MihrimatriX/breadboarding/cpu16/docs/parcalar.md

# CPU16 — Parça Kütüphanesi (Faz 3)

> Bilgisayarda kullanılan her entegrenin pin düzeni, kapı seviyesi içi, CMOS transistör açılımı ve KiCad sembolü **tek kaynaktan** gelir: `cpu16/chips/`.

## Ne var

| Dosya | İçerik |
|---|---|
| `chips/logic.ts` | Kapı seviyesi simülatör: 0/1/Z/X lojiği, çok sürücülü netler (veriyolu), dalga tabanlı zamanlama, DFF / mandal / üç durumlu tampon / davranışsal blok. Netlist kurulurken düz tiplenmiş dizilere (CSR) çevrilir; bir dalga hiç nesne ayırmadan hesaplanır |
| `chips/parts/*.ts` | 38 çipin tanımı: pinler (veri sayfasındaki numaralarla), kapı devresi, veri sayfası fonksiyon tablosu (referans model) |
| `chips/cmos.ts` | Kapı → CMOS transistör açılımı; çıktı Silikon3D'nin anahtar seviyesi motorunun okuduğu biçimde |
| `chips/bench.ts`, `chips/transistor-bench.ts` | Tek çipi kapı veya transistör seviyesinde çalıştıran tezgâhlar |
| `chips/kicad.ts` → `kicad/cpu16.kicad_sym` | KiCad 7+ sembol kütüphanesi (pin numaraları, footprint, açıklama) |

```sh
npm run cpu16 -- chips        # tablo: kapı ve transistör sayıları
npm run cpu16 -- kicad-sym    # cpu16/kicad/cpu16.kicad_sym dosyasını yeniden üret
npx vitest run cpu16/tests/chips.test.ts
```

## Nasıl doğrulanıyor (Faz 3 "bitti" ölçütü)

1. **Kapı modeli = veri sayfası.** Her çipin fonksiyon tablosu kapı devresinden bağımsız olarak koda yazıldı (`ref`). Birleşimsel çiplerde 12 girişe kadar **bütün kombinasyonlar** Gray kodu sırasıyla, diğerlerinde ve sıralı çiplerde 2 × 3000 rastgele adım (her adımda tek pin değişir) karşılaştırılır.
2. **Transistör modeli = kapı modeli.** Aynı adımlar kapılardan açılan CMOS netlist'i üzerinde Silikon3D'nin `SwitchLevelEngine`'inde (6502'yi çalıştıran motor) koşar; her adımda bütün çıkışlar aynı olmalı.
3. **Pin düzeni**: her kılıfta pinler 1..N, GND N/2'de, VCC N'de (74HC ve JEDEC bellek düzeni); KiCad sembolündeki pin numaraları kütüphaneyle birebir.
4. **Veri sayfası satırları**: 74HC138, 283, 161 (yükle/say/TC), 74 (ikisi birden aktif), 595 (kaydır/mandalla/Z), 273 için tablo satırları ayrıca yazıldı.
5. **Bellekler** davranışsaldır (içleri kapı değil): 62256 okuma/yazma/Z; 28C256 sayfa yazma, yazma sürerken DATA yoklaması (D7 ters) ve toggle biti (D6), yazılım koruması (SDP) aç/kapat; SST39SF010A komut dizileriyle programlama, kimlik okuma, sektör ve çip silme. 28C256'nın davranışı emülatördeki modelin (`emu/devices/eeprom.ts`) kendisidir.

**Hangi parçalar (AFU kararı)**: anakart yalnız yaygın 7400 serisi lojikle ve iki bellek çipiyle (62256, 28C256) kurulur. 74HC148, 74HC193, 74HC590 ve AS6C4008 bu yüzden kütüphaneden çıkarıldı: kesme öncelik kodlayıcısı kapılarla, video adres sayacı ve zamanlayıcı 74HC161 ile, önbellek sayaçları 74HC161 + 74HC541 ile kuruldu; 512 KB RAM yerine 4 × 62256. 74HC166 yaygındır ve video kartında kalır (74HC165'in eşzamansız yüklemesi piksel saatine sığmaz, [anakart-gc-video.md](anakart-gc-video.md)). SST39SF010A artık hiçbir kartta yok (CPU kartının mikrokod ve ALU ROM'ları 74HC kapılarına çevrildi); kütüphanede karşılaştırma için duruyor.

Güç verildiğinde flip-flopların değeri **bilinmiyor (X)** kabul edilir; veri sayfası da öyle der. Testler bu durumda karşılaştırma yapmaz, ilk saat/reset sonrasında yapar.

## Çipler

| Parça | Kılıf | Kapı | Transistör | Açıklama |
|---|---|---|---|---|
| 74HC00 | DIP-14 | 4 | 16 | 4 × 2 girişli NAND |
| 74HC02 | DIP-14 | 4 | 16 | 4 × 2 girişli NOR |
| 74HC04 | DIP-14 | 6 | 12 | 6 × NOT (evirici) |
| 74HC05 | DIP-14 | 6 | 48 | 6 × NOT, açık-akaçlı (open-drain) çıkış |
| 74HC08 | DIP-14 | 4 | 24 | 4 × 2 girişli AND |
| 74HC10 | DIP-14 | 3 | 18 | 3 × 3 girişli NAND |
| 74HC11 | DIP-14 | 3 | 24 | 3 × 3 girişli AND |
| 74HC20 | DIP-14 | 2 | 16 | 2 × 4 girişli NAND |
| 74HC21 | DIP-14 | 2 | 20 | 2 × 4 girişli AND |
| 74HC27 | DIP-14 | 3 | 18 | 3 × 3 girişli NOR |
| 74HC30 | DIP-14 | 1 | 16 | 8 girişli NAND |
| 74HC14 | DIP-14 | 6 | 12 | 6 × Schmitt tetiklemeli NOT |
| 74HC32 | DIP-14 | 4 | 24 | 4 × 2 girişli OR |
| 74HC86 | DIP-14 | 4 | 48 | 4 × 2 girişli XOR |
| 74HC125 | DIP-14 | 8 | 40 | 4 × üç durumlu tampon (aktif düşük OE) |
| 74HC138 | DIP-16 | 14 | 82 | 3'ten 8'e kod çözücü (aktif düşük çıkış) |
| 74HC139 | DIP-16 | 14 | 60 | 2 × (2'den 4'e kod çözücü) |
| 74HC151 | DIP-16 | 14 | 124 | 8'den 1'e seçici (multiplexer) |
| 74HC153 | DIP-16 | 14 | 108 | 2 × (4'ten 1'e seçici) |
| 74HC157 | DIP-16 | 14 | 92 | 4 × (2'den 1'e seçici) |
| 74HC283 | DIP-16 | 30 | 260 | 4 bit ikili tam toplayıcı (ileri bakışlı elde) |
| 74HC688 | DIP-20 | 10 | 116 | 8 bit eşitlik karşılaştırıcısı |
| 74HC74 | DIP-14 | 2 | 72 | 2 × D flip-flop (asenkron preset ve clear) |
| 74HC161 | DIP-16 | 26 | 309 | 4 bit senkron ikili sayıcı (asenkron reset) |
| 74HC393 | DIP-14 | 12 | 297 | 2 × 4 bit dalgalı (ripple) ikili sayıcı (düşen kenar, asenkron temizleme) |
| 74HC165 | DIP-16 | 34 | 376 | 8 bit paralel giriş / seri çıkış kaydırmalı register |
| 74HC166 | DIP-16 | 34 | 441 | 8 bit paralel giriş / seri çıkış kaydırmalı register (eşzamanlı yükleme) |
| 74HC175 | DIP-16 | 4 | 145 | 4 × D flip-flop (ortak saat, asenkron reset) |
| 74HC573 | DIP-20 | 17 | 210 | 8 bit şeffaf mandal (üç durumlu çıkış) |
| 74HC574 | DIP-20 | 17 | 355 | 8 bit D flip-flop register (üç durumlu çıkış) |
| 74HC273 | DIP-20 | 8 | 289 | 8 bit D flip-flop register (ortak asenkron reset): bank register'ları |
| 74HC595 | DIP-16 | 25 | 643 | 8 bit seri giriş / paralel çıkış kaydırmalı register (çıkış mandallı) |
| 74HC245 | DIP-20 | 20 | 144 | 8 bit çift yönlü veriyolu alıcı-vericisi |
| 74HC541 | DIP-20 | 9 | 68 | 8 bit üç durumlu tampon (iki aktif düşük OE) |
| 74HC4511 | DIP-16 | 37 | 368 | BCD'den 7 segmente kod çözücü / sürücü (mandallı, ortak katot): 8 bit hesap makinesi (`hesap8/`) |
| 62256 | DIP-28 | - | - | 32 KB statik RAM (32K × 8) |
| 28C256 | DIP-28 | - | - | 32 KB paralel EEPROM (32K × 8, 5 V, bayt/sayfa yazma; 62256 ile aynı bacak düzeni) |
| SST39SF010A | DIP-32 | - | - | 128 KB Flash (128K × 8, 5 V, komutla programlanır) |

"Kapı" sayısında flip-flop ve mandal tek eleman sayılır; transistör sayısı onların açılmış hâlini içerir. Gerçek 74HC çiplerinde giriş koruma diyotları ve tamponlanmış çıkış katları da vardır. Mantığı değiştirmedikleri için modellenmezler; bu yüzden gerçek transistör sayısı biraz daha yüksektir.

CPU16'da her çipin nerede kullanıldığı `usage` alanında ve KiCad sembolünün `CPU16_Kullanim` özelliğinde yazılı.

74HC11, 20, 21, 27 ve 30 CPU kartının kapı seviyesindeki kontrol biriminin geniş kapılarıdır
(`board/kontrol.ts`; mikromimari.md, "Kapı seviyesinde kontrol birimi"). Kartlarda yapıştırıcı lojik
olarak yerleşirler (`Board.and3`, `nor3`, `and4`, `nand4`, `nand8`): birimler kart bitince çiplere
paketlenir. 74HC20 ve 74HC21'in 3. ve 11., 74HC30'un 9., 10. ve 13. bacakları bağlantısızdır (NC).

## Transistör açılımı kuralları

| Kapı | Devre | Transistör |
|---|---|---|
| NOT | 1 PMOS (VCC→Y) + 1 NMOS (Y→GND) | 2 |
| NAND (k giriş) | k paralel PMOS + k seri NMOS | 2k |
| NOR (k giriş) | k seri PMOS + k paralel NMOS | 2k |
| AND / OR | NAND / NOR + NOT | 2k + 2 |
| XOR | 2 evirici + AOI22: Y = ¬(a·b + ā·b̄) | 12 |
| Üç durumlu tampon | evirici + üç durumlu evirici (P-P ve N-N seri yığın) | 8 |
| D flip-flop | 7474 yapısı: 6 adet 3 girişli NAND (kenar tetiklemeli) | 36 |
| D mandalı | 4 NAND + 1 NOT | 18 |

VCC'ye bağlı girişler bir "tie-high" hücresinden beslenir (kapısı GND'de bir PMOS): anahtar seviyesi motoru güç raylarını yeniden hesaplamaz, gerçek çiplerde de sabit girişler böyle bağlanır.

## Kütüphanede olmayan parçalar (BOM'da var, simülasyonda ideal)

Saat osilatörü (4 MHz kristal osilatör kutusu), 555 (adım saati), reset butonu RC'si, dekuplaj kondansatörleri, LED ve dirençler, VGA konnektörü ve renk direnç DAC'ı, PS/2 konnektörü, USB-UART modülü (CH340). Simülasyonda bunlar ideal sinyal kaynağı olarak modellenir; listesi Faz 9 BOM'unda.

CPU kartının hata ayıklama göstergeleri de bu gruptadır: 39 adet 3 mm LED (her biri 1 kΩ ile),
26 adet 10 segmentli LED çubuk gösterge (`DISP_BAR_10`, DIP-20; ör. Kingbright DC-10YWA, Broadcom
HDSP-4840; 1–10. bacaklar segment anotları, 20–11. bacaklar katotları; 16'sı register'ların içeriği
için) ve önlerinde 26 adet 8 × 1 kΩ yalıtılmış direnç dizisi (`RN_1K_ISO_8`, DIP-16, ör. Bourns 4116R-1-102; k. direnç k. ve 17 − k.
bacak arasında). Simülasyon dirençlerin değerini bilmez: LED'in ve segmentin yanıp yanmadığı,
direncin öbür ucundaki sinyalden okunur ([kartlar.md](kartlar.md)).

## Yeni çip eklemek

1. `chips/parts/` altında `ChipDef` yaz: `pinsOf("…veri sayfası sırasıyla pin adları…", { out, tri, bidir })`, `build(c, p)` ile kapılar, `ref` ile fonksiyon tablosu.
2. `chips/library.ts` listesine ekle.
3. `npm run cpu16 -- kicad-sym` ile sembol kütüphanesini yenile, `npx vitest run cpu16/tests/chips.test.ts` çalıştır: kapı = tablo ve transistör = kapı testleri kendiliğinden eklenir.
