MihrimatriX/breadboarding/cpu16/docs/anakart-kartlari.md

# Anakart kartları: saat, bellek ve önbellek (Faz 6, kapı seviyesi)

> [anakart.md](anakart.md)'deki bellek tarafı artık gerçek çiplerden kurulmuş kartlar olarak da var:
> şema = kod ([kartlar.md](kartlar.md)). Emülatördeki `Machine` (`emu/machine.ts`, `emu/devices/cache.ts`)
> referanstır; kartlar onunla erişim erişim ve komut komut karşılaştırılır. `Machine` bu iş için
> değiştirilmedi.

| Dosya | İçerik |
|---|---|
| `board/clock-card.ts` | Saat ve reset kartı (`clk`): bekleme durumu, TCLK, OSC |
| `board/mem-card.ts` | Bellek kartı (`bellek`): G/Ç çözümü, bank register'ları, EEPROM + RAM, bayt sıralayıcı |
| `board/cache-card.ts` | Önbellek kartı (`onbellek`): etiket/veri belleği, bekleme üreteci, sayaçlar, CACHE_CTRL |
| `board/machine-board.ts` | `buildMachineBoard({ cards })`: CPU + saat + bellek + önbellek (+ ek kartlar); `GateMachine` |
| `board/bus-master.ts` | `BusMaster`: CPU kartı yerine arka paneli süren düzenek (veriyolu izini oynatmak için) |
| `chips/parts/bellek-ek.ts` | Yeni parça: 74HC273 |
| `kicad/bellek/`, `kicad/onbellek/` | KiCad şemaları ve kart BOM'ları (`npm run cpu16 -- board kicad`) |
| `tests/anakart-bellek.test.ts`, `tests/anakart-sistem.test.ts` | Doğrulama (aşağıda) |
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
