MihrimatriX/breadboarding/public/og/6502.png

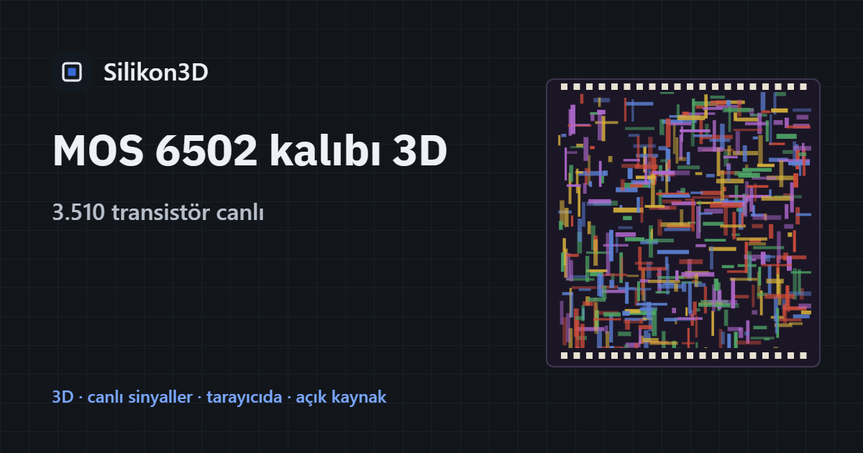
public/og/6502.png
