MihrimatriX/breadboarding/public/og/belgeler.png

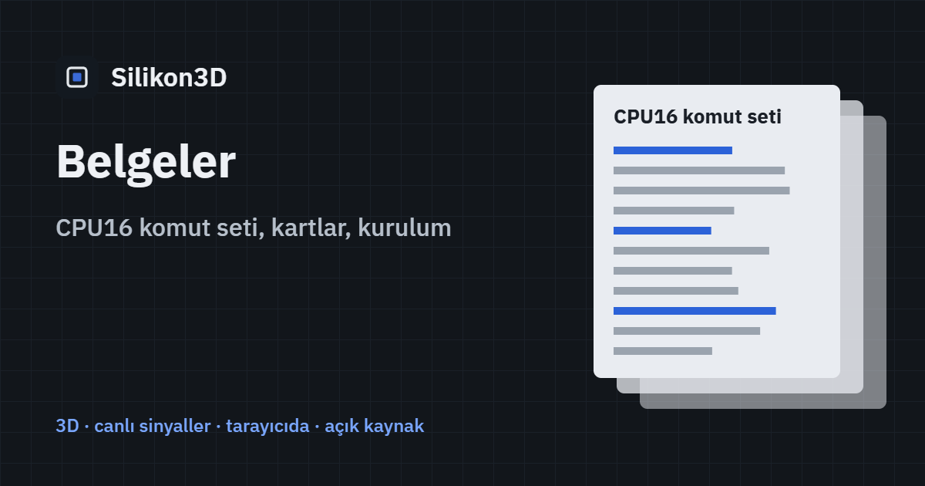
public/og/belgeler.png
