MihrimatriX/breadboarding/public/og/cpu16.png

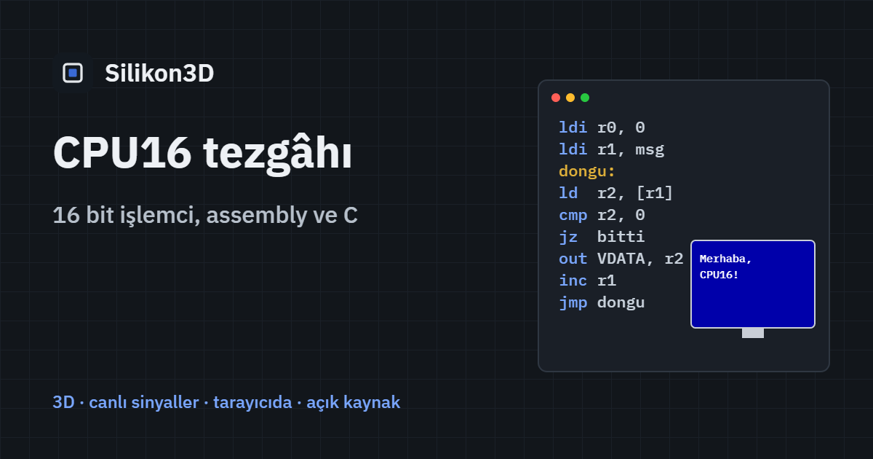
public/og/cpu16.png
