MihrimatriX/breadboarding/public/og/hesap.png

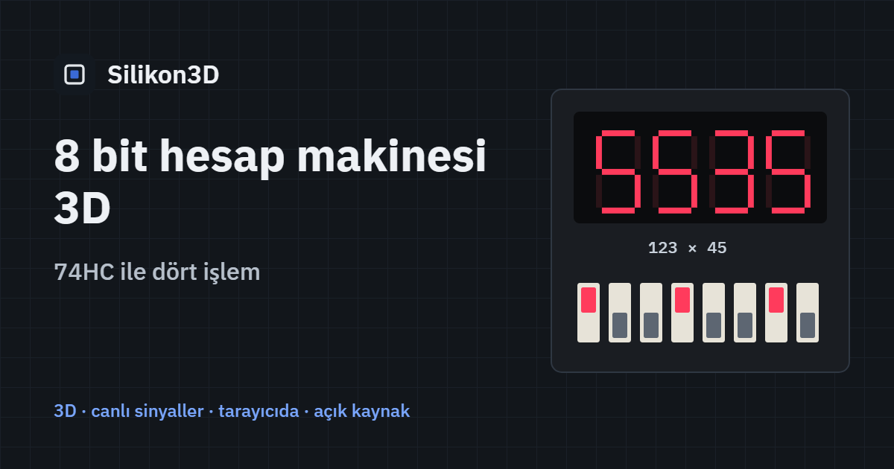
public/og/hesap.png
