MihrimatriX/breadboarding/public/og/mimari.png

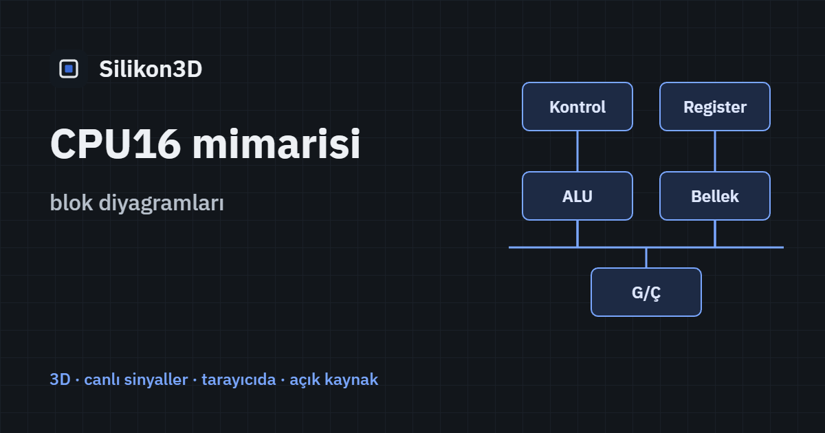
public/og/mimari.png
