MihrimatriX/breadboarding/public/og/silikon3d.png

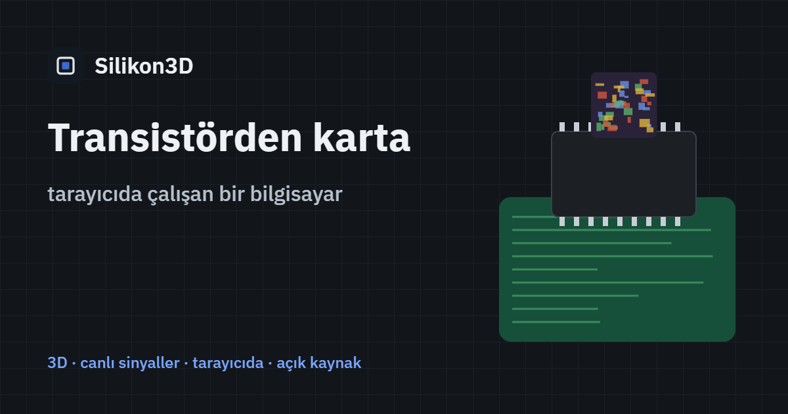
public/og/silikon3d.png
