MihrimatriX/breadboarding/cpu16/kicad/bom.csv

Parça | Adet | Açıklama | Footprint | Kart | Referanslar
62256 | 2 | 32 KB statik RAM (32K × 8) | Package_DIP:DIP-28_W15.24mm | mem | U303 U304
74HC00 | 8 | 4 × 2 girişli NAND | Package_DIP:DIP-14_W7.62mm | cpu | U130 U131 U132 U170 U171 U172 U173 U174
74HC02 | 5 | 4 × 2 girişli NOR | Package_DIP:DIP-14_W7.62mm | cpu | U133 U134 U135 U175 U176
74HC04 | 6 | 6 × NOT (evirici) | Package_DIP:DIP-14_W7.62mm | cpu mem clk | U145 U146 U307 U210 U177 U178
74HC08 | 19 | 4 × 2 girişli AND | Package_DIP:DIP-14_W7.62mm | cpu clk | U117 U118 U119 U120 U121 U122 U123 U124 U125 U126 U207 U208 U157 U158 U159 U160 U161 U162 U163
74HC10 | 7 | 3 × 3 girişli NAND | Package_DIP:DIP-14_W7.62mm | cpu | U179 U180 U181 U182 U183 U184 U185
74HC11 | 1 | 3 × 3 girişli AND | Package_DIP:DIP-14_W7.62mm | cpu | U186
74HC138 | 12 | 3'ten 8'e kod çözücü (aktif düşük çıkış) | Package_DIP:DIP-16_W7.62mm | cpu | U1 U3 U5 U7 U10 U13 U17 U18 U68 U69 U70 U71
74HC14 | 1 | 6 × Schmitt tetiklemeli NOT | Package_DIP:DIP-14_W7.62mm | clk | U201
74HC151 | 46 | 8'den 1'e seçici (multiplexer) | Package_DIP:DIP-16_W7.62mm | cpu | U14 U15 U16 U49 U50 U51 U52 U53 U54 U55 U56 U57 U58 U59 U60 U61 U62 U63 U64 U76 U77 U78 U79 U80 U81 U82 U83 U84 U85 U86 U87 U88 U89 U90 U91 U111 U147 U148 U149 U150 U151 U152 U153 U154 U155 U156
74HC153 | 9 | 2 × (4'ten 1'e seçici) | Package_DIP:DIP-16_W7.62mm | cpu | U92 U93 U94 U95 U96 U97 U98 U99 U100
74HC157 | 4 | 4 × (2'den 1'e seçici) | Package_DIP:DIP-16_W7.62mm | cpu clk | U67 U105 U116 U202
74HC161 | 5 | 4 bit senkron ikili sayıcı (asenkron reset) | Package_DIP:DIP-16_W7.62mm | cpu | U9 U43 U44 U45 U46
74HC175 | 1 | 4 × D flip-flop (ortak saat, asenkron reset) | Package_DIP:DIP-16_W7.62mm | clk | U203
74HC20 | 4 | 2 × 4 girişli NAND | Package_DIP:DIP-14_W7.62mm | cpu | U191 U192 U193 U194
74HC21 | 4 | 2 × 4 girişli AND | Package_DIP:DIP-14_W7.62mm | cpu | U187 U188 U189 U190
74HC245 | 3 | 8 bit çift yönlü veriyolu alıcı-vericisi | Package_DIP:DIP-20_W7.62mm | cpu | U112 U113 U114
74HC283 | 4 | 4 bit ikili tam toplayıcı (ileri bakışlı elde) | Package_DIP:DIP-16_W7.62mm | cpu | U72 U73 U74 U75
74HC32 | 11 | 4 × 2 girişli OR | Package_DIP:DIP-14_W7.62mm | cpu mem clk | U127 U128 U129 U306 U209 U164 U165 U166 U167 U168 U169
74HC541 | 26 | 8 bit üç durumlu tampon (iki aktif düşük OE) | Package_DIP:DIP-20_W7.62mm | cpu clk | U47 U48 U65 U66 U103 U104 U109 U110 U115 U206 U195 U196 U197 U198 U199 U901 U902 U903 U904 U905 U906 U907 U908 U909 U910 U911
74HC574 | 29 | 8 bit D flip-flop register (üç durumlu çıkış) | Package_DIP:DIP-20_W7.62mm | cpu mem | U2 U4 U6 U8 U19 U20 U21 U22 U23 U24 U25 U26 U27 U28 U29 U30 U31 U32 U33 U34 U35 U36 U37 U38 U39 U40 U41 U42 U305
74HC688 | 4 | 8 bit eşitlik karşılaştırıcı | Package_DIP:DIP-20_W7.62mm | cpu mem | U101 U102 U301 U302
74HC74 | 7 | 2 × D flip-flop (asenkron preset ve clear) | Package_DIP:DIP-14_W7.62mm | cpu clk | U11 U12 U106 U107 U108 U204 U205
74HC86 | 9 | 4 × 2 girişli XOR | Package_DIP:DIP-14_W7.62mm | cpu | U136 U137 U138 U139 U140 U141 U142 U143 U144
BACKPLANE_2x32 | 3 | Arka panel konnektörü 2 × 32 (2,54 mm) | Connector_PinHeader_2.54mm:PinHeader_2x32_P2.54mm_Vertical | cpu mem clk | J1 J301 J201
C_100N | 227 | 100 nF seramik kondansatör (dekuplaj) | Capacitor_THT:C_Disc_D5.0mm_W2.5mm_P5.00mm | cpu mem clk | C2 C3 C4 C5 C6 C7 C8 C9 C10 C11 C12 C13 C14 C15 C16 C17 C18 C19 C20 C21 C22 C23 C24 C25 C26 C27 C28 C29 C30 C31 C32 C33 C34 C35 C36 C37 C38 C39 C40 C41 C42 C43 C44 C45 C46 C47 C48 C49 C50 C51 C52 C53 C54 C55 C56 C57 C58 C59 C60 C61 C62 C63 C64 C65 C66 C67 C68 C69 C70 C71 C72 C73 C74 C75 C76 C77 C78 C79 C80 C81 C82 C83 C84 C85 C86 C87 C88 C89 C90 C91 C92 C93 C94 C95 C96 C97 C98 C99 C100 C101 C102 C103 C104 C105 C106 C107 C108 C109 C110 C111 C112 C113 C114 C115 C116 C117 C118 C119 C120 C121 C122 C123 C124 C125 C126 C127 C128 C129 C130 C131 C132 C133 C134 C135 C136 C137 C138 C139 C140 C141 C142 C143 C144 C145 C146 C147 C148 C149 C150 C151 C152 C153 C154 C155 C156 C157 C158 C159 C160 C161 C162 C163 C164 C165 C166 C167 C168 C169 C170 C171 C172 C173 C174 C175 C176 C177 C178 C179 C180 C181 C182 C183 C184 C185 C186 C187 C188 C189 C190 C191 C192 C193 C194 C195 C196 C197 C198 C199 C901 C902 C903 C904 C905 C906 C907 C908 C909 C910 C911 C912 C302 C303 C304 C305 C306 C307 C308 C205 C206 C207 C208 C209 C210 C211 C212 C213 C214
C_100U | 3 | 100 µF elektrolitik kondansatör (kart girişi) | Capacitor_THT:CP_Radial_D6.3mm_P2.50mm | cpu mem clk | C1 C301 C204
C_10U | 1 | 10 µF elektrolitik kondansatör | Capacitor_THT:CP_Radial_D5.0mm_P2.00mm | clk | C201
C_1U | 2 | 1 µF kondansatör | Capacitor_THT:C_Disc_D5.0mm_W2.5mm_P5.00mm | clk | C202 C203
DISP_BAR_10 | 26 | 10 segmentli LED çubuk gösterge (DIP-20, ör. Kingbright DC-10YWA, Broadcom HDSP-4840) | Display:HDSP-4830 | cpu | DS1 DS2 DS3 DS4 DS5 DS6 DS7 DS8 DS9 DS10 DS11 DS12 DS13 DS14 DS15 DS16 DS17 DS18 DS19 DS20 DS21 DS22 DS23 DS24 DS25 DS26
LED | 42 | 3 mm LED | LED_THT:LED_D3.0mm | cpu clk | D1 D2 D201 D3 D4 D5 D6 D7 D8 D9 D10 D11 D12 D13 D14 D15 D16 D17 D18 D19 D20 D21 D22 D23 D24 D25 D26 D27 D28 D29 D30 D31 D32 D33 D34 D35 D36 D37 D38 D39 D40 D41
OSC_CAN | 1 | Kristal osilatör modülü (DIP-14 kılıf, 5 V) | Oscillator:Oscillator_DIP-14 | clk | X201
POT_100K | 1 | 100 kΩ trimpot | Potentiometer_THT:Potentiometer_Bourns_3386P_Vertical | clk | RV201
R_10K | 3 | 10 kΩ direnç | Resistor_THT:R_Axial_DIN0207_L6.3mm_D2.5mm_P7.62mm_Horizontal | clk | R201 R202 R204
R_1K | 40 | 1 kΩ direnç | Resistor_THT:R_Axial_DIN0207_L6.3mm_D2.5mm_P7.62mm_Horizontal | clk cpu | R203 R3 R4 R5 R6 R7 R8 R9 R10 R11 R12 R13 R14 R15 R16 R17 R18 R19 R20 R21 R22 R23 R24 R25 R26 R27 R28 R29 R30 R31 R32 R33 R34 R35 R36 R37 R38 R39 R40 R41
R_330 | 3 | 330 Ω direnç (LED akımı) | Resistor_THT:R_Axial_DIN0207_L6.3mm_D2.5mm_P7.62mm_Horizontal | cpu clk | R1 R2 R205
RN_10K_8 | 2 | 8 × 10 kΩ direnç dizisi (SIP-9, ortak uç) | Resistor_THT:R_Array_SIP9 | cpu | RN1 RN2
RN_1K_ISO_8 | 26 | 8 × 1 kΩ yalıtılmış direnç dizisi (DIP-16, ör. 4116R-1-102) | Package_DIP:DIP-16_W7.62mm | cpu | RN3 RN4 RN5 RN6 RN7 RN8 RN9 RN10 RN11 RN12 RN13 RN14 RN15 RN16 RN17 RN18 RN19 RN20 RN21 RN22 RN23 RN24 RN25 RN26 RN27 RN28
SW_PUSH | 2 | Basmalı buton (6 mm) | Button_Switch_THT:SW_PUSH_6mm | clk | SW201 SW202
SW_SPDT | 2 | Sürgülü anahtar (1 kutup, 2 konum) | Button_Switch_THT:SW_Slide_1P2T_CK_OS102011MS2Q | clk | SW203 SW204
