MihrimatriX/breadboarding/cpu16/kicad/hesap/bom.csv

Parça | Adet | Açıklama | Footprint | Kart | Referanslar
74HC00 | 1 | 4 × 2 girişli NAND | Package_DIP:DIP-14_W7.62mm | hesap | U79
74HC02 | 6 | 4 × 2 girişli NOR | Package_DIP:DIP-14_W7.62mm | hesap | U2 U187 U194 U202 U203 U212
74HC04 | 8 | 6 × NOT (evirici) | Package_DIP:DIP-14_W7.62mm | hesap | U3 U11 U80 U81 U188 U195 U204 U213
74HC08 | 38 | 4 × 2 girişli AND | Package_DIP:DIP-14_W7.62mm | hesap | U1 U8 U14 U15 U16 U17 U18 U19 U20 U21 U22 U23 U24 U25 U26 U27 U28 U29 U76 U98 U99 U110 U111 U148 U149 U150 U151 U152 U153 U154 U155 U156 U180 U181 U185 U192 U199 U210
74HC153 | 8 | 2 × (4'ten 1'e seçici) | Package_DIP:DIP-16_W7.62mm | hesap | U83 U84 U85 U86 U87 U88 U89 U90
74HC157 | 16 | 4 × (2'den 1'e seçici) | Package_DIP:DIP-16_W7.62mm | hesap | U46 U47 U50 U51 U54 U55 U58 U59 U62 U63 U66 U67 U70 U71 U74 U75
74HC283 | 88 | 4 bit ikili tam toplayıcı (ileri bakışlı elde) | Package_DIP:DIP-16_W7.62mm | hesap | U6 U7 U12 U13 U30 U31 U32 U33 U34 U35 U36 U37 U38 U39 U40 U41 U42 U43 U44 U45 U48 U49 U52 U53 U56 U57 U60 U61 U64 U65 U68 U69 U72 U73 U91 U92 U93 U94 U95 U96 U97 U103 U104 U105 U106 U107 U108 U109 U115 U116 U117 U118 U119 U120 U121 U122 U123 U124 U125 U126 U127 U128 U129 U130 U131 U132 U133 U134 U135 U136 U137 U138 U139 U140 U141 U142 U143 U144 U145 U146 U147 U173 U174 U175 U176 U177 U178 U179
74HC30 | 1 | 8 girişli NAND | Package_DIP:DIP-14_W7.62mm | hesap | U82
74HC32 | 32 | 4 × 2 girişli OR | Package_DIP:DIP-14_W7.62mm | hesap | U77 U78 U100 U101 U102 U112 U113 U114 U157 U158 U159 U160 U161 U162 U163 U164 U165 U166 U167 U168 U169 U170 U171 U172 U182 U183 U184 U186 U193 U200 U201 U211
74HC4511 | 14 | BCD'den 7 segmente kod çözücü / sürücü (mandallı, ortak katot) | Package_DIP:DIP-16_W7.62mm | hesap | U189 U190 U191 U196 U197 U198 U205 U206 U207 U208 U209 U214 U215 U216
74HC86 | 4 | 4 × 2 girişli XOR | Package_DIP:DIP-14_W7.62mm | hesap | U4 U5 U9 U10
C_100N | 216 | 100 nF seramik kondansatör (dekuplaj) | Capacitor_THT:C_Disc_D5.0mm_W2.5mm_P5.00mm | hesap | C2 C3 C4 C5 C6 C7 C8 C9 C10 C11 C12 C13 C14 C15 C16 C17 C18 C19 C20 C21 C22 C23 C24 C25 C26 C27 C28 C29 C30 C31 C32 C33 C34 C35 C36 C37 C38 C39 C40 C41 C42 C43 C44 C45 C46 C47 C48 C49 C50 C51 C52 C53 C54 C55 C56 C57 C58 C59 C60 C61 C62 C63 C64 C65 C66 C67 C68 C69 C70 C71 C72 C73 C74 C75 C76 C77 C78 C79 C80 C81 C82 C83 C84 C85 C86 C87 C88 C89 C90 C91 C92 C93 C94 C95 C96 C97 C98 C99 C100 C101 C102 C103 C104 C105 C106 C107 C108 C109 C110 C111 C112 C113 C114 C115 C116 C117 C118 C119 C120 C121 C122 C123 C124 C125 C126 C127 C128 C129 C130 C131 C132 C133 C134 C135 C136 C137 C138 C139 C140 C141 C142 C143 C144 C145 C146 C147 C148 C149 C150 C151 C152 C153 C154 C155 C156 C157 C158 C159 C160 C161 C162 C163 C164 C165 C166 C167 C168 C169 C170 C171 C172 C173 C174 C175 C176 C177 C178 C179 C180 C181 C182 C183 C184 C185 C186 C187 C188 C189 C190 C191 C192 C193 C194 C195 C196 C197 C198 C199 C200 C201 C202 C203 C204 C205 C206 C207 C208 C209 C210 C211 C212 C213 C214 C215 C216 C217
C_100U | 1 | 100 µF elektrolitik kondansatör (kart girişi) | Capacitor_THT:CP_Radial_D6.3mm_P2.50mm | hesap | C1
CONN_5V | 1 | 5 V besleme girişi (2 pin başlık: 1 = +5 V, 2 = GND) | Connector_PinHeader_2.54mm:PinHeader_1x02_P2.54mm_Vertical | hesap | J1
DISP_7SEG_CC | 15 | 7 segment gösterge, 0,56" tek hane, ortak katot (ör. 5161AS) | Display_7Segment:7SegmentLED_LTS6760_LTS6780 | hesap | DS1 DS2 DS3 DS4 DS5 DS6 DS7 DS8 DS9 DS10 DS11 DS12 DS13 DS14 DS15
LED | 5 | 3 mm LED | LED_THT:LED_D3.0mm | hesap | D1 D2 D3 D4 D5
R_10K | 1 | 10 kΩ direnç | Resistor_THT:R_Axial_DIN0207_L6.3mm_D2.5mm_P7.62mm_Horizontal | hesap | R1
R_330 | 6 | 330 Ω direnç (LED akımı) | Resistor_THT:R_Axial_DIN0207_L6.3mm_D2.5mm_P7.62mm_Horizontal | hesap | R2 R3 R4 R5 R6 R7
RN_10K_8 | 3 | 8 × 10 kΩ direnç dizisi (SIP-9, ortak uç) | Resistor_THT:R_Array_SIP9 | hesap | RN1 RN2 RN3
RN_470_ISO_8 | 14 | 8 × 470 Ω yalıtılmış direnç dizisi (DIP-16, ör. 4116R-1-471) | Package_DIP:DIP-16_W7.62mm | hesap | RN4 RN5 RN6 RN7 RN8 RN9 RN10 RN11 RN12 RN13 RN14 RN15 RN16 RN17
SW_DIP_2 | 1 | 2'li DIP anahtar (SPST, sürgülü, DIP-4) | Button_Switch_THT:SW_DIP_SPSTx02_Slide_9.78x7.26mm_W7.62mm_P2.54mm | hesap | SW3
SW_DIP_8 | 2 | 8'li DIP anahtar (SPST, sürgülü, DIP-16) | Button_Switch_THT:SW_DIP_SPSTx08_Slide_9.78x22.5mm_W7.62mm_P2.54mm | hesap | SW1 SW2
SW_PUSH | 1 | Basmalı buton (6 mm) | Button_Switch_THT:SW_PUSH_6mm | hesap | SW4
