MihrimatriX/breadboarding/cpu16/kicad/bellek/bom.csv

Parça | Adet | Açıklama | Footprint | Kart | Referanslar
28C256 | 1 | 32 KB paralel EEPROM (32K × 8, 5 V, bayt/sayfa yazma | 62256 ile aynı bacak düzeni) | Package_DIP:DIP-28_W15.24mm_Socket | bellek | U420
62256 | 4 | 32 KB statik RAM (32K × 8) | Package_DIP:DIP-28_W15.24mm | bellek | U421 U422 U423 U424
74HC00 | 1 | 4 × 2 girişli NAND | Package_DIP:DIP-14_W7.62mm | bellek | U430
74HC02 | 1 | 4 × 2 girişli NOR | Package_DIP:DIP-14_W7.62mm | bellek | U431
74HC04 | 3 | 6 × NOT (evirici) | Package_DIP:DIP-14_W7.62mm | bellek | U432 U433 U434
74HC08 | 2 | 4 × 2 girişli AND | Package_DIP:DIP-14_W7.62mm | bellek | U426 U427
74HC138 | 1 | 3'ten 8'e kod çözücü (aktif düşük çıkış) | Package_DIP:DIP-16_W7.62mm | bellek | U425
74HC139 | 1 | 2 × (2'den 4'e kod çözücü) | Package_DIP:DIP-16_W7.62mm | bellek | U403
74HC153 | 3 | 2 × (4'ten 1'e seçici) | Package_DIP:DIP-16_W7.62mm | bellek | U408 U409 U410
74HC245 | 2 | 8 bit çift yönlü veriyolu alıcı-vericisi | Package_DIP:DIP-20_W7.62mm | bellek | U418 U419
74HC273 | 4 | 8 bit D flip-flop register (ortak asenkron reset) | Package_DIP:DIP-20_W7.62mm | bellek | U404 U405 U406 U407
74HC32 | 2 | 4 × 2 girişli OR | Package_DIP:DIP-14_W7.62mm | bellek | U428 U429
74HC541 | 4 | 8 bit üç durumlu tampon (iki aktif düşük OE) | Package_DIP:DIP-20_W7.62mm | bellek | U411 U412 U413 U414
74HC574 | 1 | 8 bit D flip-flop register (üç durumlu çıkış) | Package_DIP:DIP-20_W7.62mm | bellek | U417
74HC688 | 2 | 8 bit eşitlik karşılaştırıcı | Package_DIP:DIP-20_W7.62mm | bellek | U401 U402
74HC74 | 2 | 2 × D flip-flop (asenkron preset ve clear) | Package_DIP:DIP-14_W7.62mm | bellek | U415 U416
BACKPLANE_2x32 | 1 | Arka panel konnektörü 2 × 32 (2,54 mm) | Connector_PinHeader_2.54mm:PinHeader_2x32_P2.54mm_Vertical | bellek | J401
C_100N | 34 | 100 nF seramik kondansatör (dekuplaj) | Capacitor_THT:C_Disc_D5.0mm_W2.5mm_P5.00mm | bellek | C402 C403 C404 C405 C406 C407 C408 C409 C410 C411 C412 C413 C414 C415 C416 C417 C418 C419 C420 C421 C422 C423 C424 C425 C426 C427 C428 C429 C430 C431 C432 C433 C434 C435
C_100U | 1 | 100 µF elektrolitik kondansatör (kart girişi) | Capacitor_THT:CP_Radial_D6.3mm_P2.50mm | bellek | C401
RN_10K_8 | 3 | 8 × 10 kΩ direnç dizisi (SIP-9, ortak uç) | Resistor_THT:R_Array_SIP9 | bellek | RN401 RN402 RN403
