MihrimatriX/breadboarding/cpu16/kicad/bellek/bellek.kicad_sch

## KiCad design cpu16/kicad/bellek/bellek.kicad_sch (2026-10-12)

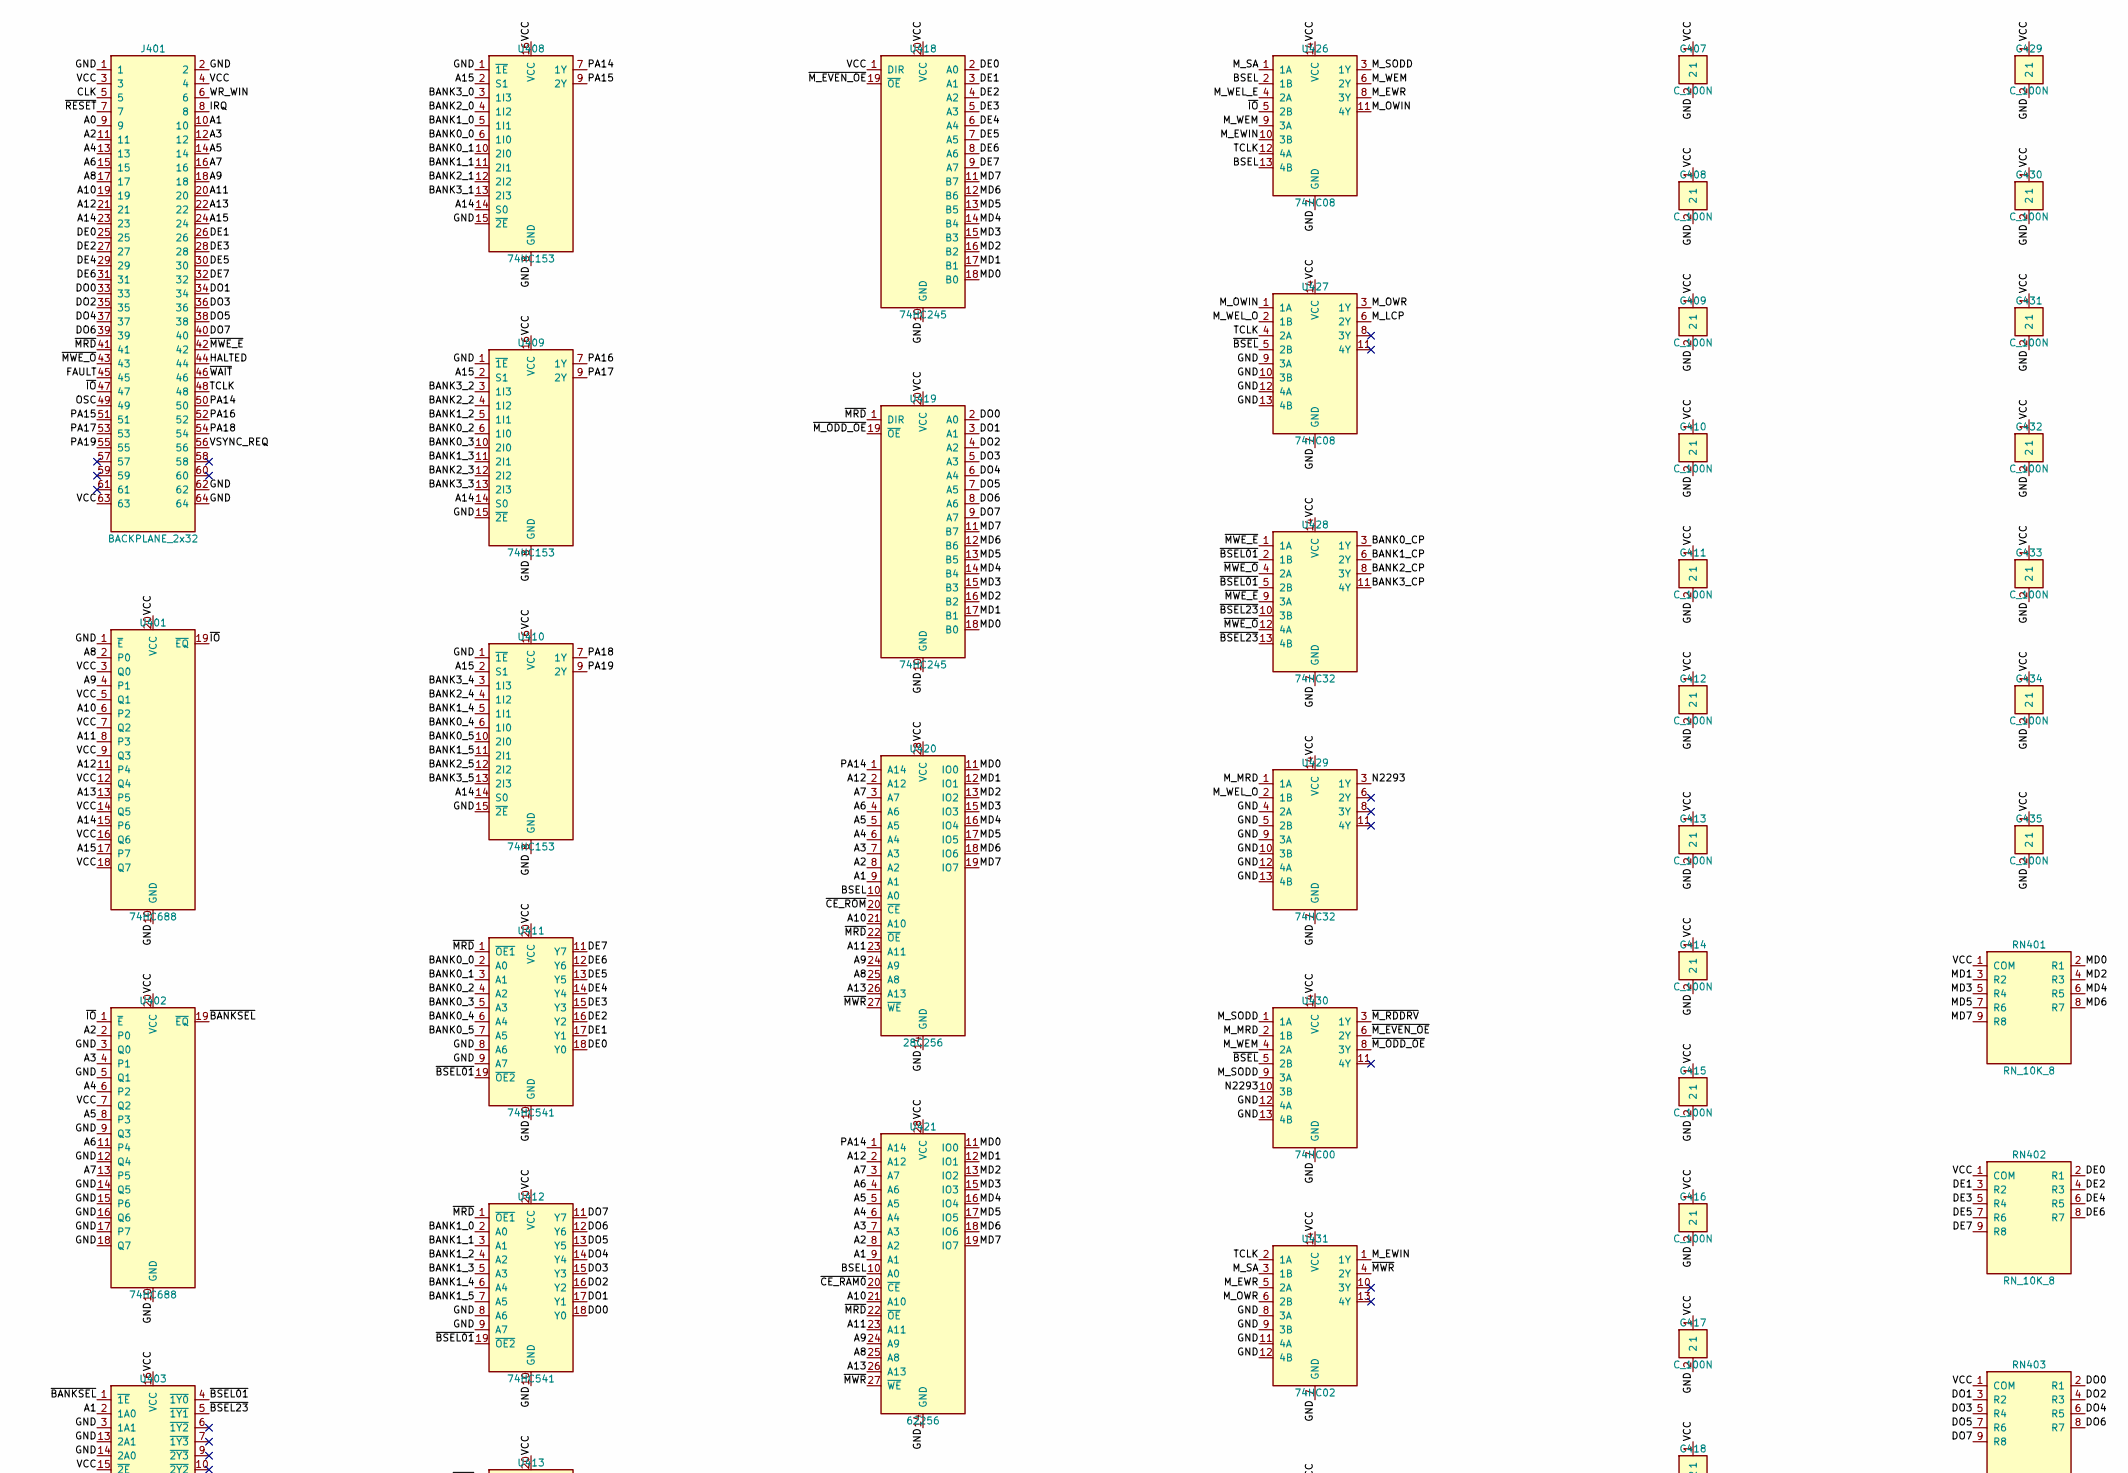
[picture p7: schematic bellek.kicad_sch, part in row 1, column 1]

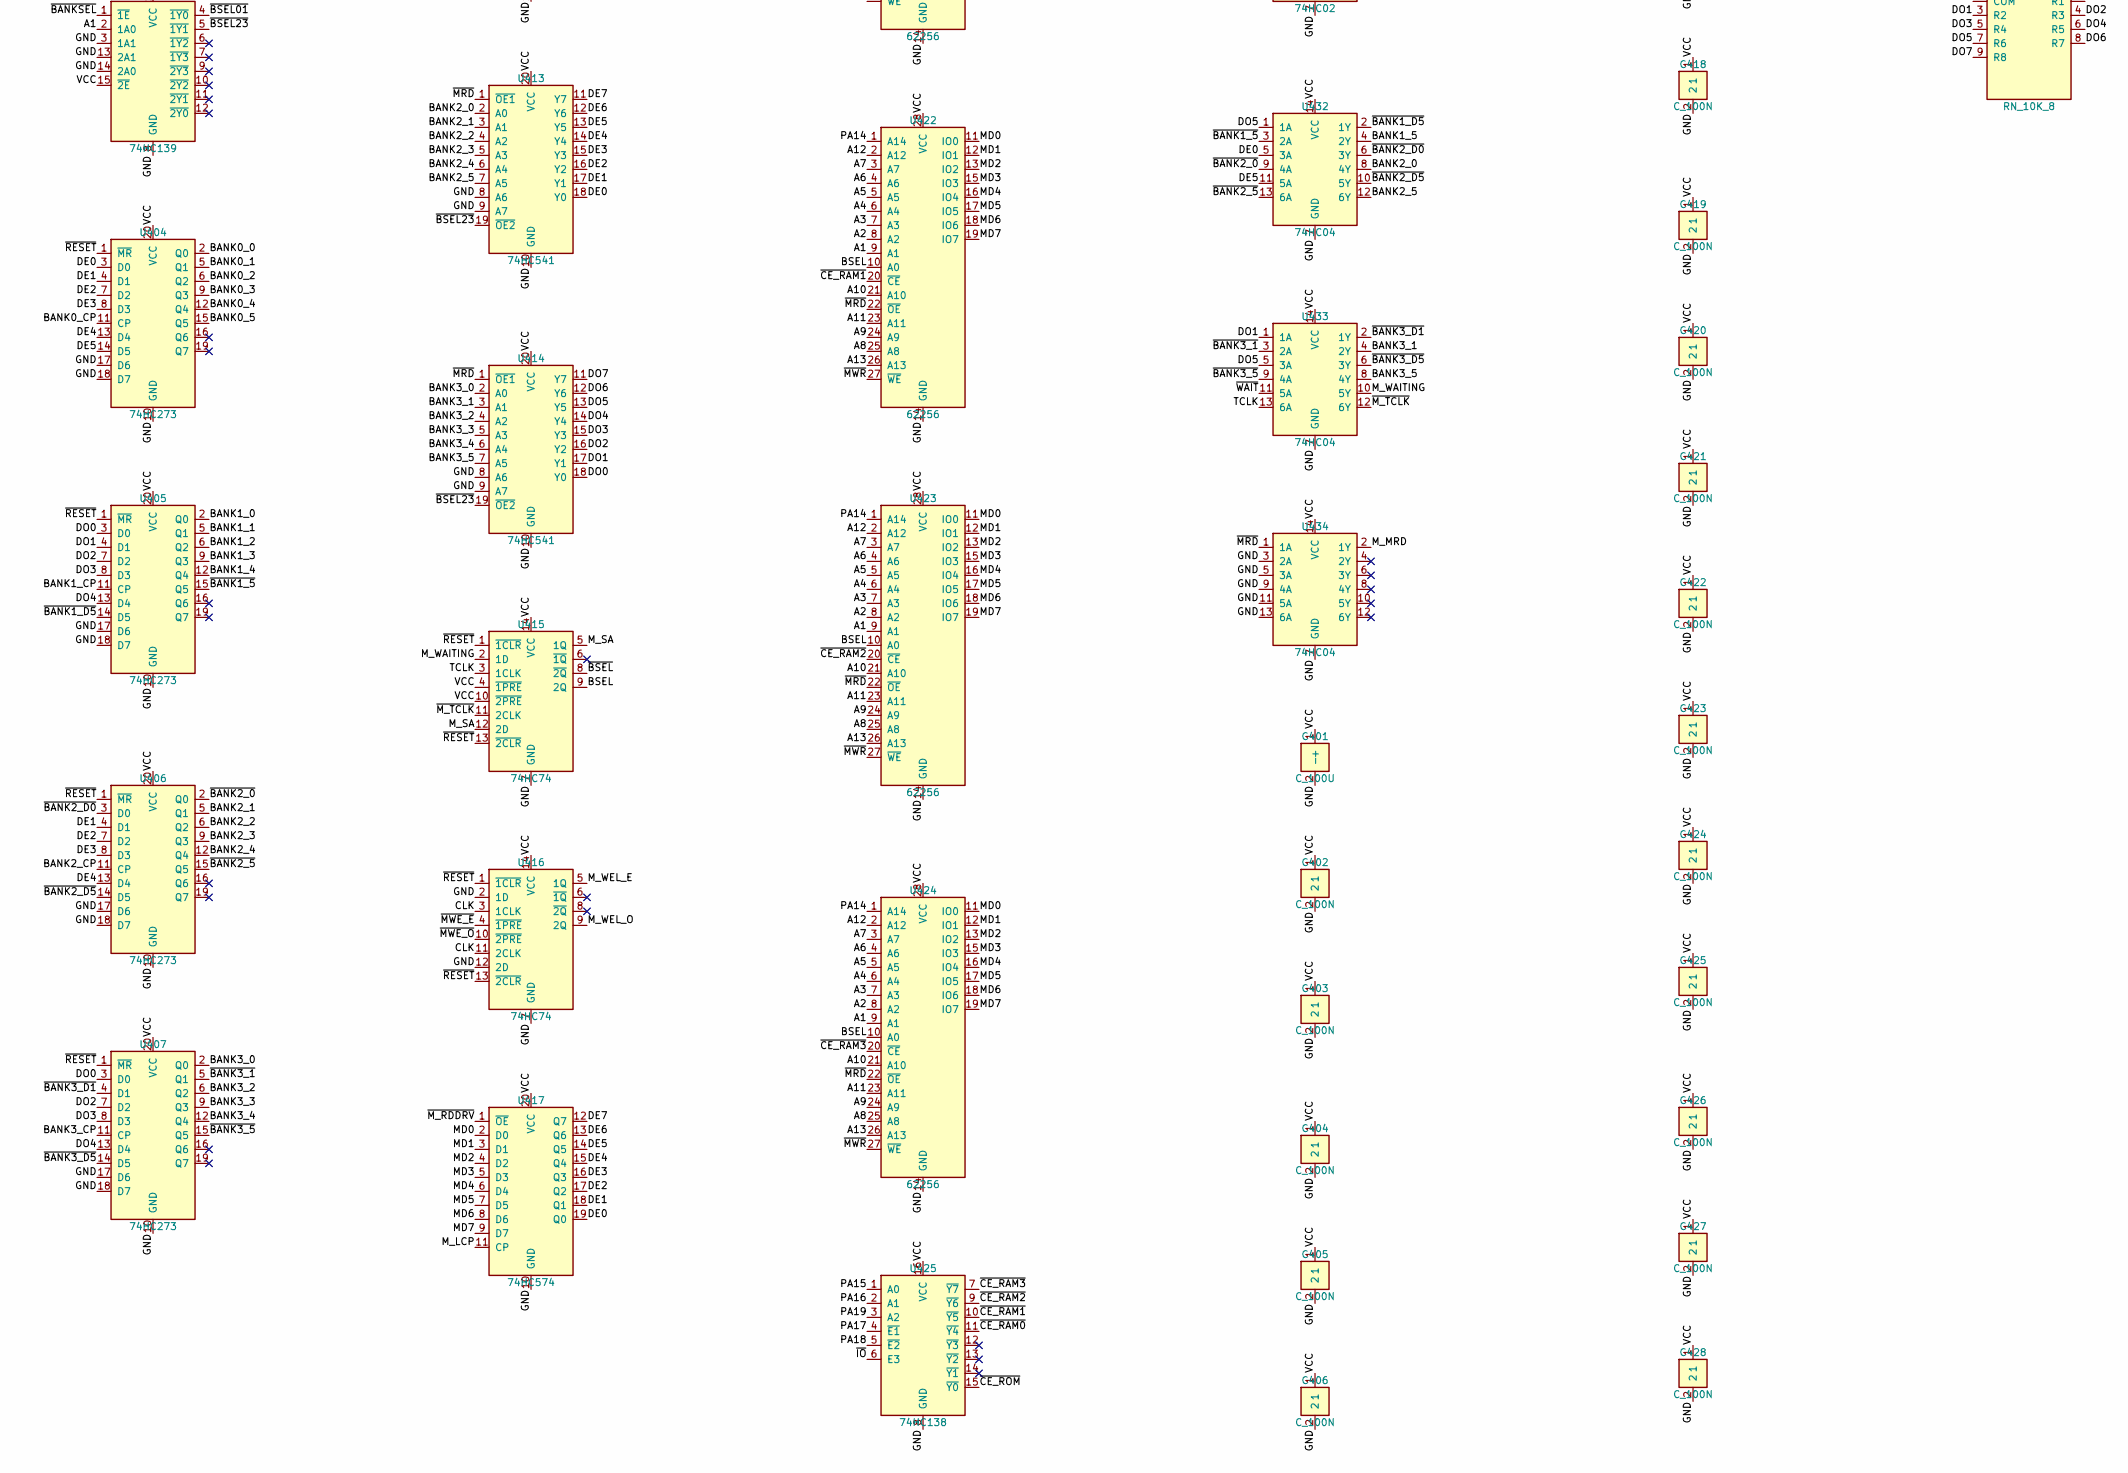
[picture p8: schematic bellek.kicad_sch, part in row 2, column 1]

Parts:
C401: C_100U; CP_Radial_D6.3mm_P2.50mm
C402, C403, C404, C405, C406, C407, C408, C409, C410, C411, C412, C413, C414, C415, C416, C417, C418, C419, C420, C421, C422, C423, C424, C425, C426, C427, C428, C429, C430, C431, C432, C433, C434, C435: C_100N; C_Disc_D5.0mm_W2.5mm_P5.00mm
J401: BACKPLANE_2x32; PinHeader_2x32_P2.54mm_Vertical
RN401, RN402, RN403: RN_10K_8; R_Array_SIP9
U401, U402: 74HC688; DIP-20_W7.62mm
U403: 74HC139; DIP-16_W7.62mm
U404, U405, U406, U407: 74HC273; DIP-20_W7.62mm
U408, U409, U410: 74HC153; DIP-16_W7.62mm
U411, U412, U413, U414: 74HC541; DIP-20_W7.62mm
U415, U416: 74HC74; DIP-14_W7.62mm
U417: 74HC574; DIP-20_W7.62mm
U418, U419: 74HC245; DIP-20_W7.62mm
U420: 28C256; DIP-28_W15.24mm_Socket
U421, U422, U423, U424: 62256; DIP-28_W15.24mm
U425: 74HC138; DIP-16_W7.62mm
U426, U427: 74HC08; DIP-14_W7.62mm
U428, U429: 74HC32; DIP-14_W7.62mm
U430: 74HC00; DIP-14_W7.62mm
U431: 74HC02; DIP-14_W7.62mm
U432, U433, U434: 74HC04; DIP-14_W7.62mm

Connections:
A0: J401.9
A1: J401.10, U403.2 (1A0), U420.9 (A1), U421.9 (A1), U422.9 (A1), U423.9 (A1), U424.9 (A1)
A2: J401.11, U402.2 (P0), U420.8 (A2), U421.8 (A2), U422.8 (A2), U423.8 (A2), U424.8 (A2)
A3: J401.12, U402.4 (P1), U420.7 (A3), U421.7 (A3), U422.7 (A3), U423.7 (A3), U424.7 (A3)
A4: J401.13, U402.6 (P2), U420.6 (A4), U421.6 (A4), U422.6 (A4), U423.6 (A4), U424.6 (A4)
A5: J401.14, U402.8 (P3), U420.5 (A5), U421.5 (A5), U422.5 (A5), U423.5 (A5), U424.5 (A5)
A6: J401.15, U402.11 (P4), U420.4 (A6), U421.4 (A6), U422.4 (A6), U423.4 (A6), U424.4 (A6)
A7: J401.16, U402.13 (P5), U420.3 (A7), U421.3 (A7), U422.3 (A7), U423.3 (A7), U424.3 (A7)
A8: J401.17, U401.2 (P0), U420.25 (A8), U421.25 (A8), U422.25 (A8), U423.25 (A8), U424.25 (A8)
A9: J401.18, U401.4 (P1), U420.24 (A9), U421.24 (A9), U422.24 (A9), U423.24 (A9), U424.24 (A9)
A10: J401.19, U401.6 (P2), U420.21 (A10), U421.21 (A10), U422.21 (A10), U423.21 (A10), U424.21 (A10)
A11: J401.20, U401.8 (P3), U420.23 (A11), U421.23 (A11), U422.23 (A11), U423.23 (A11), U424.23 (A11)
A12: J401.21, U401.11 (P4), U420.2 (A12), U421.2 (A12), U422.2 (A12), U423.2 (A12), U424.2 (A12)
A13: J401.22, U401.13 (P5), U420.26 (A13), U421.26 (A13), U422.26 (A13), U423.26 (A13), U424.26 (A13)
A14: J401.23, U401.15 (P6), U408.14 (S0), U409.14 (S0), U410.14 (S0)
A15: J401.24, U401.17 (P7), U408.2 (S1), U409.2 (S1), U410.2 (S1)
BANK0_0: U404.2 (Q0), U408.6 (1I0), U411.2 (A0)
BANK0_1: U404.5 (Q1), U408.10 (2I0), U411.3 (A1)
BANK0_2: U404.6 (Q2), U409.6 (1I0), U411.4 (A2)
BANK0_3: U404.9 (Q3), U409.10 (2I0), U411.5 (A3)
BANK0_4: U404.12 (Q4), U410.6 (1I0), U411.6 (A4)
BANK0_5: U404.15 (Q5), U410.10 (2I0), U411.7 (A5)
BANK0_CP: U404.11 (CP), U428.3 (1Y)
BANK1_0: U405.2 (Q0), U408.5 (1I1), U412.2 (A0)
BANK1_1: U405.5 (Q1), U408.11 (2I1), U412.3 (A1)
BANK1_2: U405.6 (Q2), U409.5 (1I1), U412.4 (A2)
BANK1_3: U405.9 (Q3), U409.11 (2I1), U412.5 (A3)
BANK1_4: U405.12 (Q4), U410.5 (1I1), U412.6 (A4)
BANK1_5: U410.11 (2I1), U412.7 (A5), U432.4 (2Y)
BANK1_CP: U405.11 (CP), U428.6 (2Y)
BANK2_0: U408.4 (1I2), U413.2 (A0), U432.8 (4Y)
BANK2_1: U406.5 (Q1), U408.12 (2I2), U413.3 (A1)
BANK2_2: U406.6 (Q2), U409.4 (1I2), U413.4 (A2)
BANK2_3: U406.9 (Q3), U409.12 (2I2), U413.5 (A3)
BANK2_4: U406.12 (Q4), U410.4 (1I2), U413.6 (A4)
BANK2_5: U410.12 (2I2), U413.7 (A5), U432.12 (6Y)
BANK2_CP: U406.11 (CP), U428.8 (3Y)
BANK3_0: U407.2 (Q0), U408.3 (1I3), U414.2 (A0)
BANK3_1: U408.13 (2I3), U414.3 (A1), U433.4 (2Y)
BANK3_2: U407.6 (Q2), U409.3 (1I3), U414.4 (A2)
BANK3_3: U407.9 (Q3), U409.13 (2I3), U414.5 (A3)
BANK3_4: U407.12 (Q4), U410.3 (1I3), U414.6 (A4)
BANK3_5: U410.13 (2I3), U414.7 (A5), U433.8 (4Y)
BANK3_CP: U407.11 (CP), U428.11 (4Y)
BSEL: U415.9 (2Q), U420.10 (A0), U421.10 (A0), U422.10 (A0), U423.10 (A0), U424.10 (A0), U426.2 (1B), U426.13 (4B)
CLK: J401.5, U416.3 (1CLK), U416.11 (2CLK)
DE0: J401.25, RN402.2 (R1), U404.3 (D0), U411.18 (Y0), U413.18 (Y0), U417.19 (Q0), U418.2 (A0), U432.5 (3A)
DE1: J401.26, RN402.3 (R2), U404.4 (D1), U406.4 (D1), U411.17 (Y1), U413.17 (Y1), U417.18 (Q1), U418.3 (A1)
DE2: J401.27, RN402.4 (R3), U404.7 (D2), U406.7 (D2), U411.16 (Y2), U413.16 (Y2), U417.17 (Q2), U418.4 (A2)
DE3: J401.28, RN402.5 (R4), U404.8 (D3), U406.8 (D3), U411.15 (Y3), U413.15 (Y3), U417.16 (Q3), U418.5 (A3)
DE4: J401.29, RN402.6 (R5), U404.13 (D4), U406.13 (D4), U411.14 (Y4), U413.14 (Y4), U417.15 (Q4), U418.6 (A4)
DE5: J401.30, RN402.7 (R6), U404.14 (D5), U411.13 (Y5), U413.13 (Y5), U417.14 (Q5), U418.7 (A5), U432.11 (5A)
DE6: J401.31, RN402.8 (R7), U411.12 (Y6), U413.12 (Y6), U417.13 (Q6), U418.8 (A6)
DE7: J401.32, RN402.9 (R8), U411.11 (Y7), U413.11 (Y7), U417.12 (Q7), U418.9 (A7)
DO0: J401.33, RN403.2 (R1), U405.3 (D0), U407.3 (D0), U412.18 (Y0), U414.18 (Y0), U419.2 (A0)
DO1: J401.34, RN403.3 (R2), U405.4 (D1), U412.17 (Y1), U414.17 (Y1), U419.3 (A1), U433.1 (1A)
DO2: J401.35, RN403.4 (R3), U405.7 (D2), U407.7 (D2), U412.16 (Y2), U414.16 (Y2), U419.4 (A2)
DO3: J401.36, RN403.5 (R4), U405.8 (D3), U407.8 (D3), U412.15 (Y3), U414.15 (Y3), U419.5 (A3)
DO4: J401.37, RN403.6 (R5), U405.13 (D4), U407.13 (D4), U412.14 (Y4), U414.14 (Y4), U419.6 (A4)
DO5: J401.38, RN403.7 (R6), U412.13 (Y5), U414.13 (Y5), U419.7 (A5), U432.1 (1A), U433.5 (3A)
DO6: J401.39, RN403.8 (R7), U412.12 (Y6), U414.12 (Y6), U419.8 (A6)
DO7: J401.40, RN403.9 (R8), U412.11 (Y7), U414.11 (Y7), U419.9 (A7)
FAULT: J401.45
GND: C401.2 (-), C402.2, C403.2, C404.2, C405.2, C406.2, C407.2, C408.2, C409.2, C410.2, C411.2, C412.2, C413.2, C414.2, C415.2, C416.2, C417.2, C418.2, C419.2, C420.2, C421.2, C422.2, C423.2, C424.2, C425.2, C426.2, C427.2, C428.2, C429.2, C430.2, C431.2, C432.2, C433.2, C434.2, C435.2, J401.1, J401.2, J401.62, J401.64, U401.1 (~E), U401.10 (GND), U402.3 (Q0), U402.5 (Q1), U402.9 (Q3), U402.10 (GND), U402.12 (Q4), U402.14 (Q5), U402.15 (P6), U402.16 (Q6), U402.17 (P7), U402.18 (Q7), U403.3 (1A1), U403.8 (GND), U403.13 (2A1), U403.14 (2A0), U404.10 (GND), U404.17 (D6), U404.18 (D7), U405.10 (GND), U405.17 (D6), U405.18 (D7), U406.10 (GND), U406.17 (D6), U406.18 (D7), U407.10 (GND), U407.17 (D6), U407.18 (D7), U408.1 (~1E), U408.8 (GND), U408.15 (~2E), U409.1 (~1E), U409.8 (GND), U409.15 (~2E), U410.1 (~1E), U410.8 (GND), U410.15 (~2E), U411.8 (A6), U411.9 (A7), U411.10 (GND), U412.8 (A6), U412.9 (A7), U412.10 (GND), U413.8 (A6), U413.9 (A7), U413.10 (GND), U414.8 (A6), U414.9 (A7), U414.10 (GND), U415.7 (GND), U416.2 (1D), U416.7 (GND), U416.12 (2D), U417.10 (GND), U418.10 (GND), U419.10 (GND), U420.14 (GND), U421.14 (GND), U422.14 (GND), U423.14 (GND), U424.14 (GND), U425.8 (GND), U426.7 (GND), U427.7 (GND), U427.9 (3A), U427.10 (3B), U427.12 (4A), U427.13 (4B), U428.7 (GND), U429.4 (2A), U429.5 (2B), U429.7 (GND), U429.9 (3A), U429.10 (3B), U429.12 (4A), U429.13 (4B), U430.7 (GND), U430.12 (4A), U430.13 (4B), U431.7 (GND), U431.8 (3A), U431.9 (3B), U431.11 (4A), U431.12 (4B), U432.7 (GND), U433.7 (GND), U434.3 (2A), U434.5 (3A), U434.7 (GND), U434.9 (4A), U434.11 (5A), U434.13 (6A)
HALTED: J401.44
IRQ: J401.8
MD0: RN401.2 (R1), U417.2 (D0), U418.18 (B0), U419.18 (B0), U420.11 (IO0), U421.11 (IO0), U422.11 (IO0), U423.11 (IO0), U424.11 (IO0)
MD1: RN401.3 (R2), U417.3 (D1), U418.17 (B1), U419.17 (B1), U420.12 (IO1), U421.12 (IO1), U422.12 (IO1), U423.12 (IO1), U424.12 (IO1)
MD2: RN401.4 (R3), U417.4 (D2), U418.16 (B2), U419.16 (B2), U420.13 (IO2), U421.13 (IO2), U422.13 (IO2), U423.13 (IO2), U424.13 (IO2)
MD3: RN401.5 (R4), U417.5 (D3), U418.15 (B3), U419.15 (B3), U420.15 (IO3), U421.15 (IO3), U422.15 (IO3), U423.15 (IO3), U424.15 (IO3)
MD4: RN401.6 (R5), U417.6 (D4), U418.14 (B4), U419.14 (B4), U420.16 (IO4), U421.16 (IO4), U422.16 (IO4), U423.16 (IO4), U424.16 (IO4)
MD5: RN401.7 (R6), U417.7 (D5), U418.13 (B5), U419.13 (B5), U420.17 (IO5), U421.17 (IO5), U422.17 (IO5), U423.17 (IO5), U424.17 (IO5)
MD6: RN401.8 (R7), U417.8 (D6), U418.12 (B6), U419.12 (B6), U420.18 (IO6), U421.18 (IO6), U422.18 (IO6), U423.18 (IO6), U424.18 (IO6)
MD7: RN401.9 (R8), U417.9 (D7), U418.11 (B7), U419.11 (B7), U420.19 (IO7), U421.19 (IO7), U422.19 (IO7), U423.19 (IO7), U424.19 (IO7)
M_EWIN: U426.10 (3B), U431.1 (1Y)
M_EWR: U426.8 (3Y), U431.5 (2A)
M_LCP: U417.11 (CP), U427.6 (2Y)
M_MRD: U429.1 (1A), U430.2 (1B), U434.2 (1Y)
M_OWIN: U426.11 (4Y), U427.1 (1A)
M_OWR: U427.3 (1Y), U431.6 (2B)
M_SA: U415.5 (1Q), U415.12 (2D), U426.1 (1A), U431.3 (1B)
M_SODD: U426.3 (1Y), U430.1 (1A), U430.9 (3A)
M_WAITING: U415.2 (1D), U433.10 (5Y)
M_WEL_E: U416.5 (1Q), U426.4 (2A)
M_WEL_O: U416.9 (2Q), U427.2 (1B), U429.2 (1B)
M_WEM: U426.6 (2Y), U426.9 (3A), U430.4 (2A)
N2293: U429.3 (1Y), U430.10 (3B)
OSC: J401.49
PA14: J401.50, U408.7 (1Y), U420.1 (A14), U421.1 (A14), U422.1 (A14), U423.1 (A14), U424.1 (A14)
PA15: J401.51, U408.9 (2Y), U425.1 (A0)
PA16: J401.52, U409.7 (1Y), U425.2 (A1)
PA17: J401.53, U409.9 (2Y), U425.4 (~E1)
PA18: J401.54, U410.7 (1Y), U425.5 (~E2)
PA19: J401.55, U410.9 (2Y), U425.3 (A2)
TCLK: J401.48, U415.3 (1CLK), U426.12 (4A), U427.4 (2A), U431.2 (1A), U433.13 (6A)
VCC: C401.1 (+), C402.1, C403.1, C404.1, C405.1, C406.1, C407.1, C408.1, C409.1, C410.1, C411.1, C412.1, C413.1, C414.1, C415.1, C416.1, C417.1, C418.1, C419.1, C420.1, C421.1, C422.1, C423.1, C424.1, C425.1, C426.1, C427.1, C428.1, C429.1, C430.1, C431.1, C432.1, C433.1, C434.1, C435.1, J401.3, J401.4, J401.63, RN401.1 (COM), RN402.1 (COM), RN403.1 (COM), U401.3 (Q0), U401.5 (Q1), U401.7 (Q2), U401.9 (Q3), U401.12 (Q4), U401.14 (Q5), U401.16 (Q6), U401.18 (Q7), U401.20 (VCC), U402.7 (Q2), U402.20 (VCC), U403.15 (~2E), U403.16 (VCC), U404.20 (VCC), U405.20 (VCC), U406.20 (VCC), U407.20 (VCC), U408.16 (VCC), U409.16 (VCC), U410.16 (VCC), U411.20 (VCC), U412.20 (VCC), U413.20 (VCC), U414.20 (VCC), U415.4 (~1PRE), U415.10 (~2PRE), U415.14 (VCC), U416.14 (VCC), U417.20 (VCC), U418.1 (DIR), U418.20 (VCC), U419.20 (VCC), U420.28 (VCC), U421.28 (VCC), U422.28 (VCC), U423.28 (VCC), U424.28 (VCC), U425.16 (VCC), U426.14 (VCC), U427.14 (VCC), U428.14 (VCC), U429.14 (VCC), U430.14 (VCC), U431.14 (VCC), U432.14 (VCC), U433.14 (VCC), U434.14 (VCC)
VSYNC_REQ: J401.56
WR_WIN: J401.6
~BANK1_5: U405.15 (Q5), U432.3 (2A)
~BANK1_D5: U405.14 (D5), U432.2 (1Y)
~BANK2_0: U406.2 (Q0), U432.9 (4A)
~BANK2_5: U406.15 (Q5), U432.13 (6A)
~BANK2_D0: U406.3 (D0), U432.6 (3Y)
~BANK2_D5: U406.14 (D5), U432.10 (5Y)
~BANK3_1: U407.5 (Q1), U433.3 (2A)
~BANK3_5: U407.15 (Q5), U433.9 (4A)
~BANK3_D1: U407.4 (D1), U433.2 (1Y)
~BANK3_D5: U407.14 (D5), U433.6 (3Y)
~BANKSEL: U402.19 (~EQ), U403.1 (~1E)
~BSEL01: U403.4 (~1Y0), U411.19 (~OE2), U412.19 (~OE2), U428.2 (1B), U428.5 (2B)
~BSEL23: U403.5 (~1Y1), U413.19 (~OE2), U414.19 (~OE2), U428.10 (3B), U428.13 (4B)
~BSEL: U415.8 (~2Q), U427.5 (2B), U430.5 (2B)
~CE_RAM0: U421.20 (~CE), U425.11 (~Y4)
~CE_RAM1: U422.20 (~CE), U425.10 (~Y5)
~CE_RAM2: U423.20 (~CE), U425.9 (~Y6)
~CE_RAM3: U424.20 (~CE), U425.7 (~Y7)
~CE_ROM: U420.20 (~CE), U425.15 (~Y0)
~IO: J401.47, U401.19 (~EQ), U402.1 (~E), U425.6 (E3), U426.5 (2B)
~MRD: J401.41, U411.1 (~OE1), U412.1 (~OE1), U413.1 (~OE1), U414.1 (~OE1), U419.1 (DIR), U420.22 (~OE), U421.22 (~OE), U422.22 (~OE), U423.22 (~OE), U424.22 (~OE), U434.1 (1A)
~MWE_E: J401.42, U416.4 (~1PRE), U428.1 (1A), U428.9 (3A)
~MWE_O: J401.43, U416.10 (~2PRE), U428.4 (2A), U428.12 (4A)
~MWR: U420.27 (~WE), U421.27 (~WE), U422.27 (~WE), U423.27 (~WE), U424.27 (~WE), U431.4 (2Y)
~M_EVEN_OE: U418.19 (~OE), U430.6 (2Y)
~M_ODD_OE: U419.19 (~OE), U430.8 (3Y)
~M_RDDRV: U417.1 (~OE), U430.3 (1Y)
~M_TCLK: U415.11 (2CLK), U433.12 (6Y)
~RESET: J401.7, U404.1 (~MR), U405.1 (~MR), U406.1 (~MR), U407.1 (~MR), U415.1 (~1CLR), U415.13 (~2CLR), U416.1 (~1CLR), U416.13 (~2CLR)
~WAIT: J401.46, U433.11 (5A)
