MihrimatriX/breadboarding/cpu16/kicad/clk/clk.kicad_sch

## KiCad design cpu16/kicad/clk/clk.kicad_sch (2026-10-12)

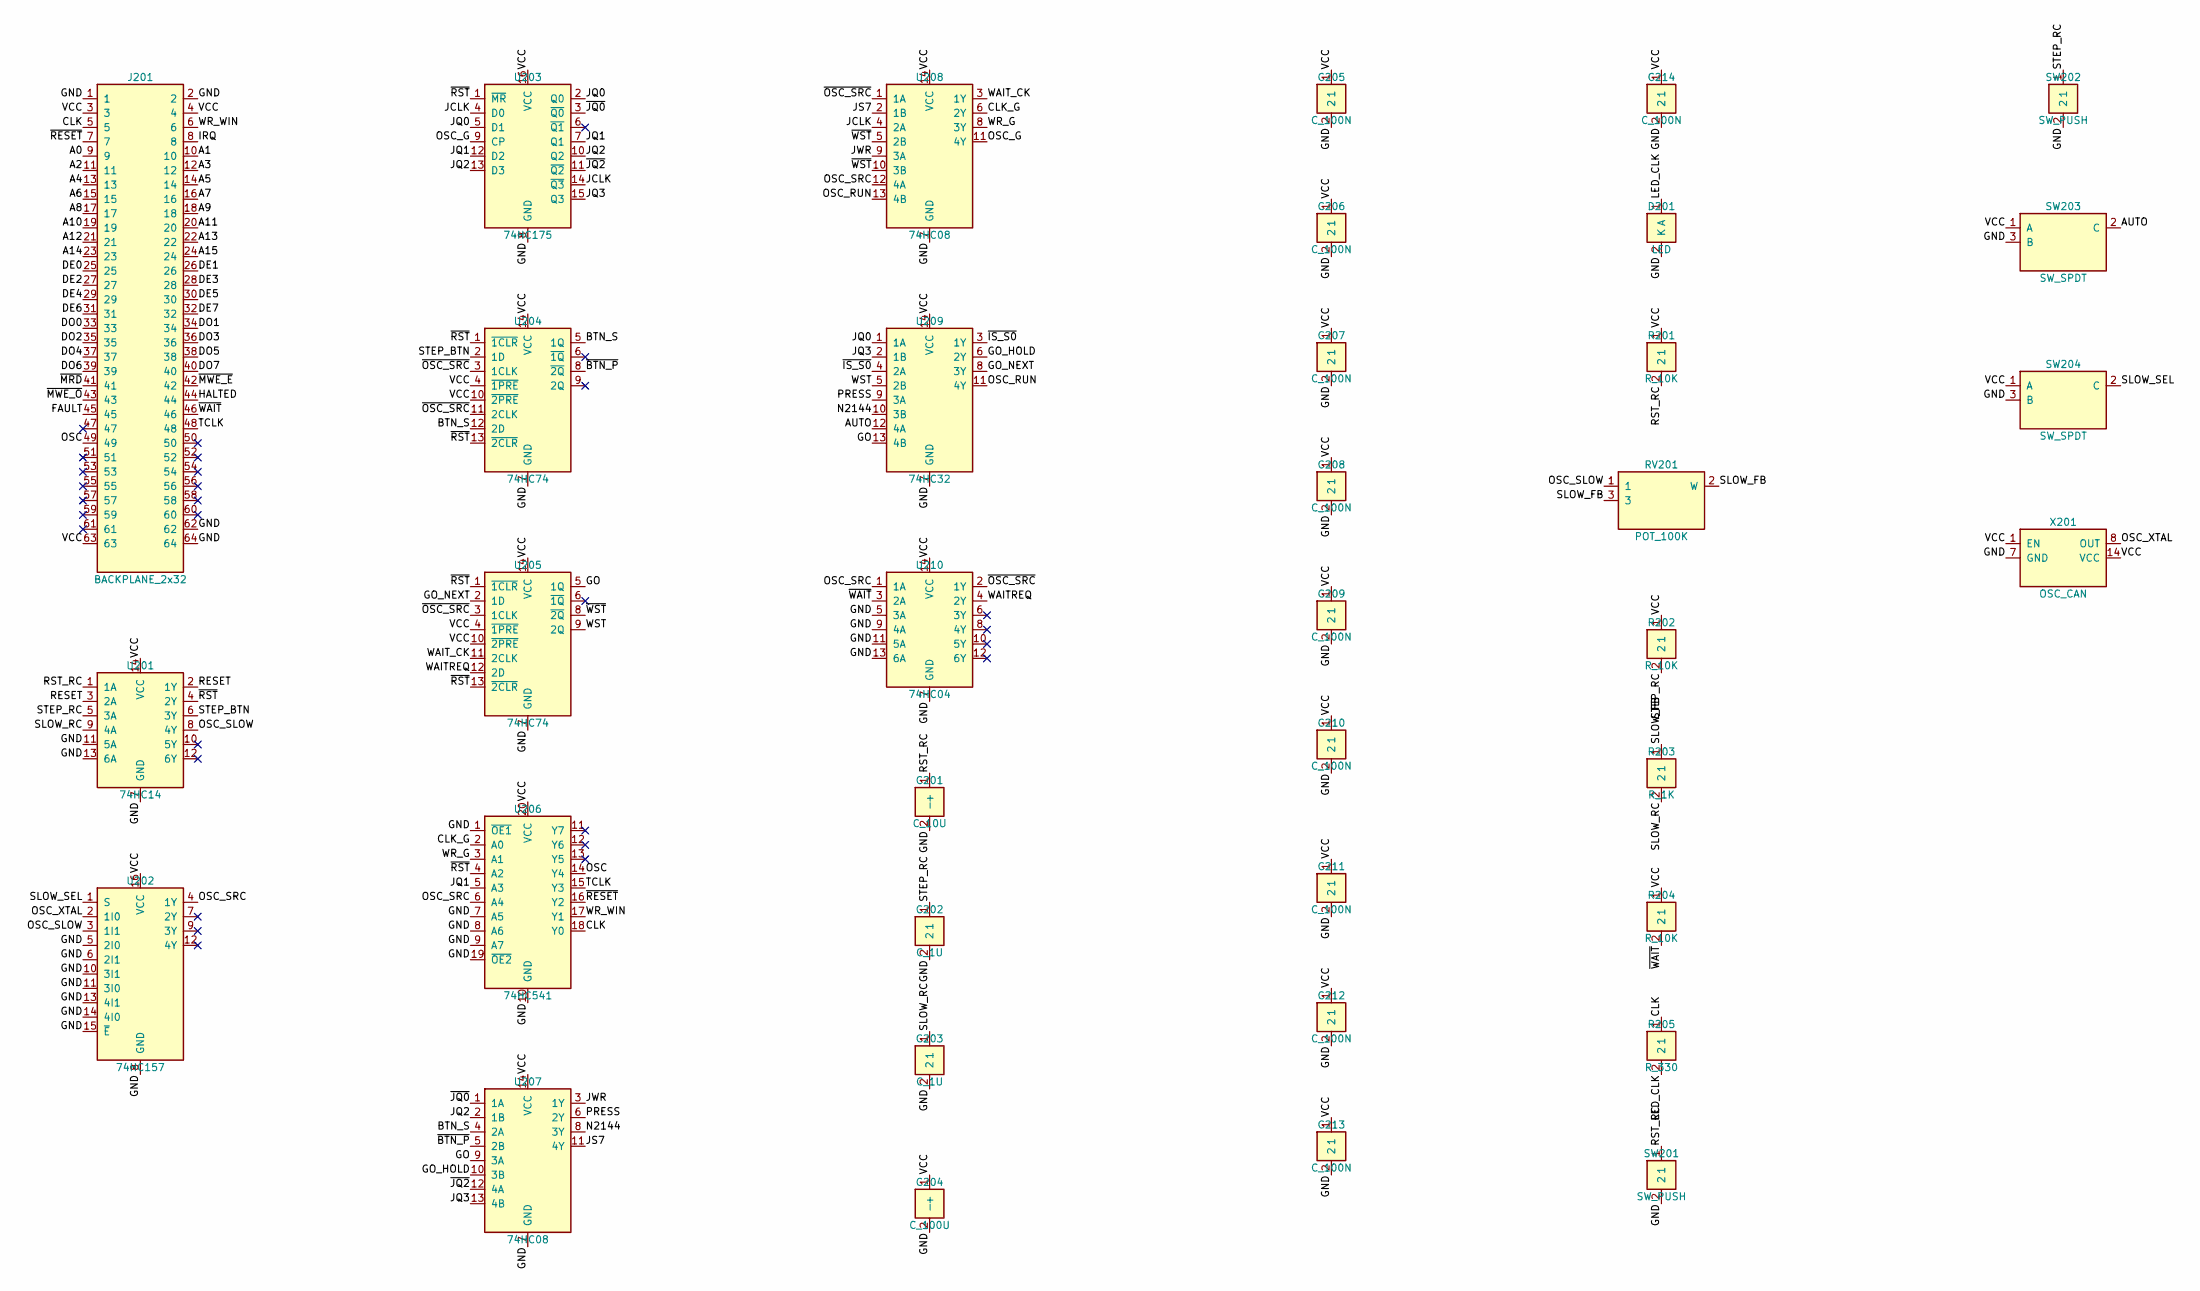
[picture p9: schematic clk.kicad_sch]

Parts:
C201: C_10U; CP_Radial_D5.0mm_P2.00mm
C202, C203: C_1U; C_Disc_D5.0mm_W2.5mm_P5.00mm
C204: C_100U; CP_Radial_D6.3mm_P2.50mm
C205, C206, C207, C208, C209, C210, C211, C212, C213, C214: C_100N; C_Disc_D5.0mm_W2.5mm_P5.00mm
D201: LED; LED_D3.0mm
J201: BACKPLANE_2x32; PinHeader_2x32_P2.54mm_Vertical
R201, R202, R204: R_10K; R_Axial_DIN0207_L6.3mm_D2.5mm_P7.62mm_Horizontal
R203: R_1K; R_Axial_DIN0207_L6.3mm_D2.5mm_P7.62mm_Horizontal
R205: R_330; R_Axial_DIN0207_L6.3mm_D2.5mm_P7.62mm_Horizontal
RV201: POT_100K; Potentiometer_Bourns_3386P_Vertical
SW201, SW202: SW_PUSH; SW_PUSH_6mm
SW203, SW204: SW_SPDT; SW_Slide_1P2T_CK_OS102011MS2Q
U201: 74HC14; DIP-14_W7.62mm
U202: 74HC157; DIP-16_W7.62mm
U203: 74HC175; DIP-16_W7.62mm
U204, U205: 74HC74; DIP-14_W7.62mm
U206: 74HC541; DIP-20_W7.62mm
U207, U208: 74HC08; DIP-14_W7.62mm
U209: 74HC32; DIP-14_W7.62mm
U210: 74HC04; DIP-14_W7.62mm
X201: OSC_CAN; Oscillator_DIP-14

Connections:
A0: J201.9
A1: J201.10
A2: J201.11
A3: J201.12
A4: J201.13
A5: J201.14
A6: J201.15
A7: J201.16
A8: J201.17
A9: J201.18
A10: J201.19
A11: J201.20
A12: J201.21
A13: J201.22
A14: J201.23
A15: J201.24
AUTO: SW203.2 (C), U209.12 (4A)
BTN_S: U204.5 (1Q), U204.12 (2D), U207.4 (2A)
CLK: J201.5, R205.1, U206.18 (Y0)
CLK_G: U206.2 (A0), U208.6 (2Y)
DE0: J201.25
DE1: J201.26
DE2: J201.27
DE3: J201.28
DE4: J201.29
DE5: J201.30
DE6: J201.31
DE7: J201.32
DO0: J201.33
DO1: J201.34
DO2: J201.35
DO3: J201.36
DO4: J201.37
DO5: J201.38
DO6: J201.39
DO7: J201.40
FAULT: J201.45
GND: C201.2 (-), C202.2, C203.2, C204.2 (-), C205.2, C206.2, C207.2, C208.2, C209.2, C210.2, C211.2, C212.2, C213.2, C214.2, D201.2 (K), J201.1, J201.2, J201.62, J201.64, SW201.2, SW202.2, SW203.3 (B), SW204.3 (B), U201.7 (GND), U201.11 (5A), U201.13 (6A), U202.5 (2I0), U202.6 (2I1), U202.8 (GND), U202.10 (3I1), U202.11 (3I0), U202.13 (4I1), U202.14 (4I0), U202.15 (~E), U203.8 (GND), U204.7 (GND), U205.7 (GND), U206.1 (~OE1), U206.7 (A5), U206.8 (A6), U206.9 (A7), U206.10 (GND), U206.19 (~OE2), U207.7 (GND), U208.7 (GND), U209.7 (GND), U210.5 (3A), U210.7 (GND), U210.9 (4A), U210.11 (5A), U210.13 (6A), X201.7 (GND)
GO: U205.5 (1Q), U207.9 (3A), U209.13 (4B)
GO_HOLD: U207.10 (3B), U209.6 (2Y)
GO_NEXT: U205.2 (1D), U209.8 (3Y)
HALTED: J201.44
IRQ: J201.8
JCLK: U203.4 (D0), U203.14 (~Q3), U208.4 (2A)
JQ0: U203.2 (Q0), U203.5 (D1), U209.1 (1A)
JQ1: U203.7 (Q1), U203.12 (D2), U206.5 (A3)
JQ2: U203.10 (Q2), U203.13 (D3), U207.2 (1B)
JQ3: U203.15 (Q3), U207.13 (4B), U209.2 (1B)
JS7: U207.11 (4Y), U208.2 (1B)
JWR: U207.3 (1Y), U208.9 (3A)
LED_CLK: D201.1 (A), R205.2
N2144: U207.8 (3Y), U209.10 (3B)
OSC: J201.49, U206.14 (Y4)
OSC_G: U203.9 (CP), U208.11 (4Y)
OSC_RUN: U208.13 (4B), U209.11 (4Y)
OSC_SLOW: RV201.1, U201.8 (4Y), U202.3 (1I1)
OSC_SRC: U202.4 (1Y), U206.6 (A4), U208.12 (4A), U210.1 (1A)
OSC_XTAL: U202.2 (1I0), X201.8 (OUT)
PRESS: U207.6 (2Y), U209.9 (3A)
RESET: U201.2 (1Y), U201.3 (2A)
RST_RC: C201.1 (+), R201.2, SW201.1, U201.1 (1A)
SLOW_FB: R203.1, RV201.2 (W), RV201.3
SLOW_RC: C203.1, R203.2, U201.9 (4A)
SLOW_SEL: SW204.2 (C), U202.1 (S)
STEP_BTN: U201.6 (3Y), U204.2 (1D)
STEP_RC: C202.1, R202.2, SW202.1, U201.5 (3A)
TCLK: J201.48, U206.15 (Y3)
VCC: C204.1 (+), C205.1, C206.1, C207.1, C208.1, C209.1, C210.1, C211.1, C212.1, C213.1, C214.1, J201.3, J201.4, J201.63, R201.1, R202.1, R204.1, SW203.1 (A), SW204.1 (A), U201.14 (VCC), U202.16 (VCC), U203.16 (VCC), U204.4 (~1PRE), U204.10 (~2PRE), U204.14 (VCC), U205.4 (~1PRE), U205.10 (~2PRE), U205.14 (VCC), U206.20 (VCC), U207.14 (VCC), U208.14 (VCC), U209.14 (VCC), U210.14 (VCC), X201.1 (EN), X201.14 (VCC)
WAITREQ: U205.12 (2D), U210.4 (2Y)
WAIT_CK: U205.11 (2CLK), U208.3 (1Y)
WR_G: U206.3 (A1), U208.8 (3Y)
WR_WIN: J201.6, U206.17 (Y1)
WST: U205.9 (2Q), U209.5 (2B)
~BTN_P: U204.8 (~2Q), U207.5 (2B)
~IS_S0: U209.3 (1Y), U209.4 (2A)
~JQ0: U203.3 (~Q0), U207.1 (1A)
~JQ2: U203.11 (~Q2), U207.12 (4A)
~MRD: J201.41
~MWE_E: J201.42
~MWE_O: J201.43
~OSC_SRC: U204.3 (1CLK), U204.11 (2CLK), U205.3 (1CLK), U208.1 (1A), U210.2 (1Y)
~RESET: J201.7, U206.16 (Y2)
~RST: U201.4 (2Y), U203.1 (~MR), U204.1 (~1CLR), U204.13 (~2CLR), U205.1 (~1CLR), U205.13 (~2CLR), U206.4 (A2)
~WAIT: J201.46, R204.2, U210.3 (2A)
~WST: U205.8 (~2Q), U208.5 (2B), U208.10 (3B)
