MihrimatriX/breadboarding/cpu16/kicad/cpu/cpu.kicad_sch

## KiCad design cpu16/kicad/cpu/cpu.kicad_sch (2026-10-12)

Schematic: cpu.kicad_sch

Parts:
C1: C_100U; CP_Radial_D6.3mm_P2.50mm
C2, C3, C4, C5, C6, C7, C8, C9, C10, C11, C12, C13, C14, C15, C16, C17, C18, C19, C20, C21, C22, C23, C24, C25, C26, C27, C28, C29, C30, C31, C32, C33, C34, C35, C36, C37, C38, C39, C40, C41, C42, C43, C44, C45, C46, C47, C48, C49, C50, C51, C52, C53, C54, C55, C56, C57, C58, C59, C60, C61, C62, C63, C64, C65, C66, C67, C68, C69, C70, C71, C72, C73, C74, C75, C76, C77, C78, C79, C80, C81, C82, C83, C84, C85, C86, C87, C88, C89, C90, C91, C92, C93, C94, C95, C96, C97, C98, C99, C100, C101, C102, C103, C104, C105, C106, C107, C108, C109, C110, C111, C112, C113, C114, C115, C116, C117, C118, C119, C120, C121, C122, C123, C124, C125, C126, C127, C128, C129, C130, C131, C132, C133, C134, C135, C136, C137, C138, C139, C140, C141, C142, C143, C144, C145, C146, C147, C148, C149, C150, C151, C152, C153, C154, C155, C156, C157, C158, C159, C160, C161, C162, C163, C164, C165, C166, C167, C168, C169, C170, C171, C172, C173, C174, C175, C176, C177, C178, C179, C180, C181, C182, C183, C184, C185, C186, C187, C188, C189, C190, C191, C192, C193, C194, C195, C196, C197, C198, C199, C901, C902, C903, C904, C905, C906, C907, C908, C909, C910, C911, C912: C_100N; C_Disc_D5.0mm_W2.5mm_P5.00mm
D1, D2, D3, D4, D5, D6, D7, D8, D9, D10, D11, D12, D13, D14, D15, D16, D17, D18, D19, D20, D21, D22, D23, D24, D25, D26, D27, D28, D29, D30, D31, D32, D33, D34, D35, D36, D37, D38, D39, D40, D41: LED; LED_D3.0mm
DS1, DS2, DS3, DS4, DS5, DS6, DS7, DS8, DS9, DS10, DS11, DS12, DS13, DS14, DS15, DS16, DS17, DS18, DS19, DS20, DS21, DS22, DS23, DS24, DS25, DS26: DISP_BAR_10; HDSP-4830
J1: BACKPLANE_2x32; PinHeader_2x32_P2.54mm_Vertical
R1, R2: R_330; R_Axial_DIN0207_L6.3mm_D2.5mm_P7.62mm_Horizontal
R3, R4, R5, R6, R7, R8, R9, R10, R11, R12, R13, R14, R15, R16, R17, R18, R19, R20, R21, R22, R23, R24, R25, R26, R27, R28, R29, R30, R31, R32, R33, R34, R35, R36, R37, R38, R39, R40, R41: R_1K; R_Axial_DIN0207_L6.3mm_D2.5mm_P7.62mm_Horizontal
RN1, RN2: RN_10K_8; R_Array_SIP9
RN3, RN4, RN5, RN6, RN7, RN8, RN9, RN10, RN11, RN12, RN13, RN14, RN15, RN16, RN17, RN18, RN19, RN20, RN21, RN22, RN23, RN24, RN25, RN26, RN27, RN28: RN_1K_ISO_8; DIP-16_W7.62mm
U1, U3, U5, U7, U10, U13, U17, U18, U68, U69, U70, U71: 74HC138; DIP-16_W7.62mm
U2, U4, U6, U8, U19, U20, U21, U22, U23, U24, U25, U26, U27, U28, U29, U30, U31, U32, U33, U34, U35, U36, U37, U38, U39, U40, U41, U42: 74HC574; DIP-20_W7.62mm
U9, U43, U44, U45, U46: 74HC161; DIP-16_W7.62mm
U11, U12, U106, U107, U108: 74HC74; DIP-14_W7.62mm
U14, U15, U16, U49, U50, U51, U52, U53, U54, U55, U56, U57, U58, U59, U60, U61, U62, U63, U64, U76, U77, U78, U79, U80, U81, U82, U83, U84, U85, U86, U87, U88, U89, U90, U91, U111, U147, U148, U149, U150, U151, U152, U153, U154, U155, U156: 74HC151; DIP-16_W7.62mm
U47, U48, U65, U66, U103, U104, U109, U110, U115, U195, U196, U197, U198, U199, U901, U902, U903, U904, U905, U906, U907, U908, U909, U910, U911: 74HC541; DIP-20_W7.62mm
U67, U105, U116: 74HC157; DIP-16_W7.62mm
U72, U73, U74, U75: 74HC283; DIP-16_W7.62mm
U92, U93, U94, U95, U96, U97, U98, U99, U100: 74HC153; DIP-16_W7.62mm
U101, U102: 74HC688; DIP-20_W7.62mm
U112, U113, U114: 74HC245; DIP-20_W7.62mm
U117, U118, U119, U120, U121, U122, U123, U124, U125, U126, U157, U158, U159, U160, U161, U162, U163: 74HC08; DIP-14_W7.62mm
U127, U128, U129, U164, U165, U166, U167, U168, U169: 74HC32; DIP-14_W7.62mm
U130, U131, U132, U170, U171, U172, U173, U174: 74HC00; DIP-14_W7.62mm
U133, U134, U135, U175, U176: 74HC02; DIP-14_W7.62mm
U136, U137, U138, U139, U140, U141, U142, U143, U144: 74HC86; DIP-14_W7.62mm
U145, U146, U177, U178: 74HC04; DIP-14_W7.62mm
U179, U180, U181, U182, U183, U184, U185: 74HC10; DIP-14_W7.62mm
U186: 74HC11; DIP-14_W7.62mm
U187, U188, U189, U190: 74HC21; DIP-14_W7.62mm
U191, U192, U193, U194: 74HC20; DIP-14_W7.62mm

Connections:
A0: J1.9, RN7.1 (R1A), U39.19 (Q0), U126.2 (1B), U129.10 (3B), U130.13 (4B)
A1: J1.10, RN7.2 (R2A), U39.18 (Q1)
A2: J1.11, RN7.3 (R3A), U39.17 (Q2)
A3: J1.12, RN7.4 (R4A), U39.16 (Q3)
A4: J1.13, RN7.5 (R5A), U39.15 (Q4)
A5: J1.14, RN7.6 (R6A), U39.14 (Q5)
A6: J1.15, RN7.7 (R7A), U39.13 (Q6)
A7: J1.16, RN7.8 (R8A), U39.12 (Q7)
A8: J1.17, RN8.1 (R1A), U40.19 (Q0)
A9: J1.18, RN8.2 (R2A), U40.18 (Q1)
A10: J1.19, RN8.3 (R3A), U40.17 (Q2)
A11: J1.20, RN8.4 (R4A), U40.16 (Q3)
A12: J1.21, RN8.5 (R5A), U40.15 (Q4)
A13: J1.22, RN8.6 (R6A), U40.14 (Q5)
A14: J1.23, RN8.7 (R7A), U40.13 (Q6)
A15: J1.24, RN8.8 (R8A), U40.12 (Q7)
AD0: U136.2 (1B), U136.5 (2B), U136.10 (3B), U136.13 (4B), U137.2 (1B), U137.5 (2B), U137.10 (3B), U137.13 (4B), U138.2 (1B), U138.5 (2B), U138.10 (3B), U138.13 (4B), U139.2 (1B), U139.5 (2B), U139.10 (3B), U139.13 (4B), U177.12 (6Y)
AD1: U70.13 (~Y2), U120.2 (1B), U120.5 (2B), U120.10 (3B), U120.13 (4B), U121.2 (1B), U121.5 (2B), U121.10 (3B), U121.13 (4B), U122.2 (1B), U122.5 (2B), U122.10 (3B), U122.13 (4B), U123.2 (1B), U123.5 (2B), U123.10 (3B), U123.13 (4B), U177.13 (6A), U190.2 (1B), U192.12 (2C)
AD2: U140.2 (1B), U140.5 (2B), U140.10 (3B), U140.13 (4B), U141.2 (1B), U141.5 (2B), U141.10 (3B), U141.13 (4B), U142.2 (1B), U142.5 (2B), U142.10 (3B), U142.13 (4B), U143.2 (1B), U143.5 (2B), U143.10 (3B), U143.13 (4B), U184.8 (3Y)
AD3: U72.7 (CIN), U192.8 (2Y)
AD4: U116.1 (S), U189.8 (2Y)
AD5: U92.4 (1I2), U176.10 (3Y)
AD6: U128.1 (1A), U176.13 (4Y)
AD7: U124.4 (2A), U178.4 (2Y)
AD8: U76.4 (I0), U77.4 (I0), U78.4 (I0), U79.4 (I0), U80.4 (I0), U81.4 (I0), U82.4 (I0), U83.4 (I0), U178.6 (3Y)
AD9: U76.3 (I1), U77.3 (I1), U78.3 (I1), U79.3 (I1), U80.3 (I1), U81.3 (I1), U82.3 (I1), U83.3 (I1), U193.6 (1Y)
AD10: U76.2 (I2), U77.2 (I2), U78.2 (I2), U79.2 (I2), U80.2 (I2), U81.2 (I2), U82.2 (I2), U83.2 (I2), U193.8 (2Y)
AD11: U76.1 (I3), U77.1 (I3), U78.1 (I3), U79.1 (I3), U80.1 (I3), U81.1 (I3), U82.1 (I3), U83.1 (I3), U185.12 (1Y)
AD12: U92.14 (S0), U93.14 (S0), U94.14 (S0), U95.14 (S0), U96.14 (S0), U97.14 (S0), U98.14 (S0), U99.14 (S0), U100.14 (S0), U190.6 (1Y)
AD13: U92.2 (S1), U93.2 (S1), U94.2 (S1), U95.2 (S1), U96.2 (S1), U97.2 (S1), U98.2 (S1), U99.2 (S1), U100.2 (S1), U194.6 (1Y)
AD16: U84.4 (I0), U85.4 (I0), U86.4 (I0), U87.4 (I0), U88.4 (I0), U89.4 (I0), U90.4 (I0), U91.4 (I0), U178.10 (5Y)
AD17: U84.3 (I1), U85.3 (I1), U86.3 (I1), U87.3 (I1), U88.3 (I1), U89.3 (I1), U90.3 (I1), U91.3 (I1), U174.3 (1Y)
AD18: U84.2 (I2), U85.2 (I2), U86.2 (I2), U87.2 (I2), U88.2 (I2), U89.2 (I2), U90.2 (I2), U91.2 (I2), U194.8 (2Y)
AD19: U84.1 (I3), U85.1 (I3), U86.1 (I3), U87.1 (I3), U88.1 (I3), U89.1 (I3), U90.1 (I3), U91.1 (I3), U174.6 (2Y)
AD20: U84.15 (I4), U85.15 (I4), U86.15 (I4), U87.15 (I4), U88.15 (I4), U89.15 (I4), U90.15 (I4), U91.15 (I4), U174.8 (3Y)
AD21: U84.14 (I5), U85.14 (I5), U86.14 (I5), U87.14 (I5), U88.14 (I5), U89.14 (I5), U90.14 (I5), U91.14 (I5), U185.6 (2Y)
AD22: U84.13 (I6), U85.13 (I6), U86.13 (I6), U87.13 (I6), U88.13 (I6), U89.13 (I6), U90.13 (I6), U91.13 (I6), U174.11 (4Y)
AD23: U84.12 (I7), U85.12 (I7), U86.12 (I7), U87.12 (I7), U88.12 (I7), U89.12 (I7), U90.12 (I7), U91.12 (I7), U185.8 (3Y)
ADIM0: U117.4 (2A), U145.6 (3Y)
AOP0: U67.4 (1Y), U69.1 (A0), U70.1 (A0), U71.1 (A0)
AOP1: U67.7 (2Y), U69.2 (A1), U70.2 (A1), U71.2 (A1)
AOP2: U67.9 (3Y), U69.3 (A2), U70.3 (A2), U71.3 (A2)
AOP3: U67.12 (4Y), U69.4 (~E1), U70.6 (E3), U71.4 (~E1)
AOP4: U69.5 (~E2), U70.4 (~E1), U71.6 (E3), U163.11 (4Y), U178.1 (1A)
BAR_A0: DS5.1 (A1), RN7.16 (R1B)
BAR_A1: DS5.2 (A2), RN7.15 (R2B)
BAR_A2: DS5.3 (A3), RN7.14 (R3B)
BAR_A3: DS5.4 (A4), RN7.13 (R4B)
BAR_A4: DS5.5 (A5), RN7.12 (R5B)
BAR_A5: DS5.6 (A6), RN7.11 (R6B)
BAR_A6: DS5.7 (A7), RN7.10 (R7B)
BAR_A7: DS5.8 (A8), RN7.9 (R8B)
BAR_A8: DS6.1 (A1), RN8.16 (R1B)
BAR_A9: DS6.2 (A2), RN8.15 (R2B)
BAR_A10: DS6.3 (A3), RN8.14 (R3B)
BAR_A11: DS6.4 (A4), RN8.13 (R4B)
BAR_A12: DS6.5 (A5), RN8.12 (R5B)
BAR_A13: DS6.6 (A6), RN8.11 (R6B)
BAR_A14: DS6.7 (A7), RN8.10 (R7B)
BAR_A15: DS6.8 (A8), RN8.9 (R8B)
BAR_BUS0: DS1.1 (A1), RN3.16 (R1B)
BAR_BUS1: DS1.2 (A2), RN3.15 (R2B)
BAR_BUS2: DS1.3 (A3), RN3.14 (R3B)
BAR_BUS3: DS1.4 (A4), RN3.13 (R4B)
BAR_BUS4: DS1.5 (A5), RN3.12 (R5B)
BAR_BUS5: DS1.6 (A6), RN3.11 (R6B)
BAR_BUS6: DS1.7 (A7), RN3.10 (R7B)
BAR_BUS7: DS1.8 (A8), RN3.9 (R8B)
BAR_BUS8: DS2.1 (A1), RN4.16 (R1B)
BAR_BUS9: DS2.2 (A2), RN4.15 (R2B)
BAR_BUS10: DS2.3 (A3), RN4.14 (R3B)
BAR_BUS11: DS2.4 (A4), RN4.13 (R4B)
BAR_BUS12: DS2.5 (A5), RN4.12 (R5B)
BAR_BUS13: DS2.6 (A6), RN4.11 (R6B)
BAR_BUS14: DS2.7 (A7), RN4.10 (R7B)
BAR_BUS15: DS2.8 (A8), RN4.9 (R8B)
BAR_IR0: DS7.1 (A1), RN9.16 (R1B)
BAR_IR1: DS7.2 (A2), RN9.15 (R2B)
BAR_IR2: DS7.3 (A3), RN9.14 (R3B)
BAR_IR3: DS7.4 (A4), RN9.13 (R4B)
BAR_IR4: DS7.5 (A5), RN9.12 (R5B)
BAR_IR5: DS7.6 (A6), RN9.11 (R6B)
BAR_IR6: DS7.7 (A7), RN9.10 (R7B)
BAR_IR7: DS7.8 (A8), RN9.9 (R8B)
BAR_IR8: DS8.1 (A1), RN10.16 (R1B)
BAR_IR9: DS8.2 (A2), RN10.15 (R2B)
BAR_IR10: DS8.3 (A3), RN10.14 (R3B)
BAR_IR11: DS8.4 (A4), RN10.13 (R4B)
BAR_IR12: DS8.5 (A5), RN10.12 (R5B)
BAR_IR13: DS8.6 (A6), RN10.11 (R6B)
BAR_IR14: DS8.7 (A7), RN10.10 (R7B)
BAR_IR15: DS8.8 (A8), RN10.9 (R8B)
BAR_PC1: DS3.2 (A2), RN5.15 (R2B)
BAR_PC2: DS3.3 (A3), RN5.14 (R3B)
BAR_PC3: DS3.4 (A4), RN5.13 (R4B)
BAR_PC4: DS3.5 (A5), RN5.12 (R5B)
BAR_PC5: DS3.6 (A6), RN5.11 (R6B)
BAR_PC6: DS3.7 (A7), RN5.10 (R7B)
BAR_PC7: DS3.8 (A8), RN5.9 (R8B)
BAR_PC8: DS4.1 (A1), RN6.16 (R1B)
BAR_PC9: DS4.2 (A2), RN6.15 (R2B)
BAR_PC10: DS4.3 (A3), RN6.14 (R3B)
BAR_PC11: DS4.4 (A4), RN6.13 (R4B)
BAR_PC12: DS4.5 (A5), RN6.12 (R5B)
BAR_PC13: DS4.6 (A6), RN6.11 (R6B)
BAR_PC14: DS4.7 (A7), RN6.10 (R7B)
BAR_PC15: DS4.8 (A8), RN6.9 (R8B)
BAR_R0Q0: DS11.1 (A1), RN13.16 (R1B)
BAR_R0Q1: DS11.2 (A2), RN13.15 (R2B)
BAR_R0Q2: DS11.3 (A3), RN13.14 (R3B)
BAR_R0Q3: DS11.4 (A4), RN13.13 (R4B)
BAR_R0Q4: DS11.5 (A5), RN13.12 (R5B)
BAR_R0Q5: DS11.6 (A6), RN13.11 (R6B)
BAR_R0Q6: DS11.7 (A7), RN13.10 (R7B)
BAR_R0Q7: DS11.8 (A8), RN13.9 (R8B)
BAR_R0Q8: DS12.1 (A1), RN14.16 (R1B)
BAR_R0Q9: DS12.2 (A2), RN14.15 (R2B)
BAR_R0Q10: DS12.3 (A3), RN14.14 (R3B)
BAR_R0Q11: DS12.4 (A4), RN14.13 (R4B)
BAR_R0Q12: DS12.5 (A5), RN14.12 (R5B)
BAR_R0Q13: DS12.6 (A6), RN14.11 (R6B)
BAR_R0Q14: DS12.7 (A7), RN14.10 (R7B)
BAR_R0Q15: DS12.8 (A8), RN14.9 (R8B)
BAR_R1Q0: DS13.1 (A1), RN15.16 (R1B)
BAR_R1Q1: DS13.2 (A2), RN15.15 (R2B)
BAR_R1Q2: DS13.3 (A3), RN15.14 (R3B)
BAR_R1Q3: DS13.4 (A4), RN15.13 (R4B)
BAR_R1Q4: DS13.5 (A5), RN15.12 (R5B)
BAR_R1Q5: DS13.6 (A6), RN15.11 (R6B)
BAR_R1Q6: DS13.7 (A7), RN15.10 (R7B)
BAR_R1Q7: DS13.8 (A8), RN15.9 (R8B)
BAR_R1Q8: DS14.1 (A1), RN16.16 (R1B)
BAR_R1Q9: DS14.2 (A2), RN16.15 (R2B)
BAR_R1Q10: DS14.3 (A3), RN16.14 (R3B)
BAR_R1Q11: DS14.4 (A4), RN16.13 (R4B)
BAR_R1Q12: DS14.5 (A5), RN16.12 (R5B)
BAR_R1Q13: DS14.6 (A6), RN16.11 (R6B)
BAR_R1Q14: DS14.7 (A7), RN16.10 (R7B)
BAR_R1Q15: DS14.8 (A8), RN16.9 (R8B)
BAR_R2Q0: DS15.1 (A1), RN17.16 (R1B)
BAR_R2Q1: DS15.2 (A2), RN17.15 (R2B)
BAR_R2Q2: DS15.3 (A3), RN17.14 (R3B)
BAR_R2Q3: DS15.4 (A4), RN17.13 (R4B)
BAR_R2Q4: DS15.5 (A5), RN17.12 (R5B)
BAR_R2Q5: DS15.6 (A6), RN17.11 (R6B)
BAR_R2Q6: DS15.7 (A7), RN17.10 (R7B)
BAR_R2Q7: DS15.8 (A8), RN17.9 (R8B)
BAR_R2Q8: DS16.1 (A1), RN18.16 (R1B)
BAR_R2Q9: DS16.2 (A2), RN18.15 (R2B)
BAR_R2Q10: DS16.3 (A3), RN18.14 (R3B)
BAR_R2Q11: DS16.4 (A4), RN18.13 (R4B)
BAR_R2Q12: DS16.5 (A5), RN18.12 (R5B)
BAR_R2Q13: DS16.6 (A6), RN18.11 (R6B)
BAR_R2Q14: DS16.7 (A7), RN18.10 (R7B)
BAR_R2Q15: DS16.8 (A8), RN18.9 (R8B)
BAR_R3Q0: DS17.1 (A1), RN19.16 (R1B)
BAR_R3Q1: DS17.2 (A2), RN19.15 (R2B)
BAR_R3Q2: DS17.3 (A3), RN19.14 (R3B)
BAR_R3Q3: DS17.4 (A4), RN19.13 (R4B)
BAR_R3Q4: DS17.5 (A5), RN19.12 (R5B)
BAR_R3Q5: DS17.6 (A6), RN19.11 (R6B)
BAR_R3Q6: DS17.7 (A7), RN19.10 (R7B)
BAR_R3Q7: DS17.8 (A8), RN19.9 (R8B)
BAR_R3Q8: DS18.1 (A1), RN20.16 (R1B)
BAR_R3Q9: DS18.2 (A2), RN20.15 (R2B)
BAR_R3Q10: DS18.3 (A3), RN20.14 (R3B)
BAR_R3Q11: DS18.4 (A4), RN20.13 (R4B)
BAR_R3Q12: DS18.5 (A5), RN20.12 (R5B)
BAR_R3Q13: DS18.6 (A6), RN20.11 (R6B)
BAR_R3Q14: DS18.7 (A7), RN20.10 (R7B)
BAR_R3Q15: DS18.8 (A8), RN20.9 (R8B)
BAR_R4Q0: DS19.1 (A1), RN21.16 (R1B)
BAR_R4Q1: DS19.2 (A2), RN21.15 (R2B)
BAR_R4Q2: DS19.3 (A3), RN21.14 (R3B)
BAR_R4Q3: DS19.4 (A4), RN21.13 (R4B)
BAR_R4Q4: DS19.5 (A5), RN21.12 (R5B)
BAR_R4Q5: DS19.6 (A6), RN21.11 (R6B)
BAR_R4Q6: DS19.7 (A7), RN21.10 (R7B)
BAR_R4Q7: DS19.8 (A8), RN21.9 (R8B)
BAR_R4Q8: DS20.1 (A1), RN22.16 (R1B)
BAR_R4Q9: DS20.2 (A2), RN22.15 (R2B)
BAR_R4Q10: DS20.3 (A3), RN22.14 (R3B)
BAR_R4Q11: DS20.4 (A4), RN22.13 (R4B)
BAR_R4Q12: DS20.5 (A5), RN22.12 (R5B)
BAR_R4Q13: DS20.6 (A6), RN22.11 (R6B)
BAR_R4Q14: DS20.7 (A7), RN22.10 (R7B)
BAR_R4Q15: DS20.8 (A8), RN22.9 (R8B)
BAR_R5Q0: DS21.1 (A1), RN23.16 (R1B)
BAR_R5Q1: DS21.2 (A2), RN23.15 (R2B)
BAR_R5Q2: DS21.3 (A3), RN23.14 (R3B)
BAR_R5Q3: DS21.4 (A4), RN23.13 (R4B)
BAR_R5Q4: DS21.5 (A5), RN23.12 (R5B)
BAR_R5Q5: DS21.6 (A6), RN23.11 (R6B)
BAR_R5Q6: DS21.7 (A7), RN23.10 (R7B)
BAR_R5Q7: DS21.8 (A8), RN23.9 (R8B)
BAR_R5Q8: DS22.1 (A1), RN24.16 (R1B)
BAR_R5Q9: DS22.2 (A2), RN24.15 (R2B)
BAR_R5Q10: DS22.3 (A3), RN24.14 (R3B)
BAR_R5Q11: DS22.4 (A4), RN24.13 (R4B)
BAR_R5Q12: DS22.5 (A5), RN24.12 (R5B)
BAR_R5Q13: DS22.6 (A6), RN24.11 (R6B)
BAR_R5Q14: DS22.7 (A7), RN24.10 (R7B)
BAR_R5Q15: DS22.8 (A8), RN24.9 (R8B)
BAR_R6Q0: DS23.1 (A1), RN25.16 (R1B)
BAR_R6Q1: DS23.2 (A2), RN25.15 (R2B)
BAR_R6Q2: DS23.3 (A3), RN25.14 (R3B)
BAR_R6Q3: DS23.4 (A4), RN25.13 (R4B)
BAR_R6Q4: DS23.5 (A5), RN25.12 (R5B)
BAR_R6Q5: DS23.6 (A6), RN25.11 (R6B)
BAR_R6Q6: DS23.7 (A7), RN25.10 (R7B)
BAR_R6Q7: DS23.8 (A8), RN25.9 (R8B)
BAR_R6Q8: DS24.1 (A1), RN26.16 (R1B)
BAR_R6Q9: DS24.2 (A2), RN26.15 (R2B)
BAR_R6Q10: DS24.3 (A3), RN26.14 (R3B)
BAR_R6Q11: DS24.4 (A4), RN26.13 (R4B)
BAR_R6Q12: DS24.5 (A5), RN26.12 (R5B)
BAR_R6Q13: DS24.6 (A6), RN26.11 (R6B)
BAR_R6Q14: DS24.7 (A7), RN26.10 (R7B)
BAR_R6Q15: DS24.8 (A8), RN26.9 (R8B)
BAR_R7Q0: DS25.1 (A1), RN27.16 (R1B)
BAR_R7Q1: DS25.2 (A2), RN27.15 (R2B)
BAR_R7Q2: DS25.3 (A3), RN27.14 (R3B)
BAR_R7Q3: DS25.4 (A4), RN27.13 (R4B)
BAR_R7Q4: DS25.5 (A5), RN27.12 (R5B)
BAR_R7Q5: DS25.6 (A6), RN27.11 (R6B)
BAR_R7Q6: DS25.7 (A7), RN27.10 (R7B)
BAR_R7Q7: DS25.8 (A8), RN27.9 (R8B)
BAR_R7Q8: DS26.1 (A1), RN28.16 (R1B)
BAR_R7Q9: DS26.2 (A2), RN28.15 (R2B)
BAR_R7Q10: DS26.3 (A3), RN28.14 (R3B)
BAR_R7Q11: DS26.4 (A4), RN28.13 (R4B)
BAR_R7Q12: DS26.5 (A5), RN28.12 (R5B)
BAR_R7Q13: DS26.6 (A6), RN28.11 (R6B)
BAR_R7Q14: DS26.7 (A7), RN28.10 (R7B)
BAR_R7Q15: DS26.8 (A8), RN28.9 (R8B)
BAR_RES0: DS9.1 (A1), RN11.16 (R1B)
BAR_RES1: DS9.2 (A2), RN11.15 (R2B)
BAR_RES2: DS9.3 (A3), RN11.14 (R3B)
BAR_RES3: DS9.4 (A4), RN11.13 (R4B)
BAR_RES4: DS9.5 (A5), RN11.12 (R5B)
BAR_RES5: DS9.6 (A6), RN11.11 (R6B)
BAR_RES6: DS9.7 (A7), RN11.10 (R7B)
BAR_RES7: DS9.8 (A8), RN11.9 (R8B)
BAR_RES8: DS10.1 (A1), RN12.16 (R1B)
BAR_RES9: DS10.2 (A2), RN12.15 (R2B)
BAR_RES10: DS10.3 (A3), RN12.14 (R3B)
BAR_RES11: DS10.4 (A4), RN12.13 (R4B)
BAR_RES12: DS10.5 (A5), RN12.12 (R5B)
BAR_RES13: DS10.6 (A6), RN12.11 (R6B)
BAR_RES14: DS10.7 (A7), RN12.10 (R7B)
BAR_RES15: DS10.8 (A8), RN12.9 (R8B)
BUS0: RN1.2 (R1), RN3.1 (R1A), U19.2 (D0), U21.2 (D0), U23.2 (D0), U25.2 (D0), U27.2 (D0), U29.2 (D0), U31.2 (D0), U33.2 (D0), U35.2 (D0), U37.2 (D0), U39.2 (D0), U41.2 (D0), U47.18 (Y0), U65.18 (Y0), U103.18 (Y0), U105.13 (4I1), U109.18 (Y0), U112.2 (A0), U114.2 (A0), U195.18 (Y0), U197.18 (Y0), U199.18 (Y0), U902.18 (Y0), U904.18 (Y0), U906.18 (Y0), U908.18 (Y0), U910.18 (Y0)
BUS1: RN1.3 (R2), RN3.2 (R2A), U19.3 (D1), U21.3 (D1), U23.3 (D1), U25.3 (D1), U27.3 (D1), U29.3 (D1), U31.3 (D1), U33.3 (D1), U35.3 (D1), U37.3 (D1), U39.3 (D1), U41.3 (D1), U43.3 (D0), U47.17 (Y1), U65.17 (Y1), U103.17 (Y1), U105.10 (3I1), U109.17 (Y1), U112.3 (A1), U114.3 (A1), U195.17 (Y1), U197.17 (Y1), U199.17 (Y1), U902.17 (Y1), U904.17 (Y1), U906.17 (Y1), U908.17 (Y1), U910.17 (Y1)
BUS2: RN1.4 (R3), RN3.3 (R3A), U19.4 (D2), U21.4 (D2), U23.4 (D2), U25.4 (D2), U27.4 (D2), U29.4 (D2), U31.4 (D2), U33.4 (D2), U35.4 (D2), U37.4 (D2), U39.4 (D2), U41.4 (D2), U43.4 (D1), U47.16 (Y2), U65.16 (Y2), U103.16 (Y2), U105.6 (2I1), U109.16 (Y2), U112.4 (A2), U114.4 (A2), U195.16 (Y2), U197.16 (Y2), U199.16 (Y2), U902.16 (Y2), U904.16 (Y2), U906.16 (Y2), U908.16 (Y2), U910.16 (Y2)
BUS3: RN1.5 (R4), RN3.4 (R4A), U19.5 (D3), U21.5 (D3), U23.5 (D3), U25.5 (D3), U27.5 (D3), U29.5 (D3), U31.5 (D3), U33.5 (D3), U35.5 (D3), U37.5 (D3), U39.5 (D3), U41.5 (D3), U43.5 (D2), U47.15 (Y3), U65.15 (Y3), U103.15 (Y3), U105.3 (1I1), U109.15 (Y3), U112.5 (A3), U114.5 (A3), U195.15 (Y3), U197.15 (Y3), U199.15 (Y3), U902.15 (Y3), U904.15 (Y3), U906.15 (Y3), U908.15 (Y3), U910.15 (Y3)
BUS4: RN1.6 (R5), RN3.5 (R5A), U19.6 (D4), U21.6 (D4), U23.6 (D4), U25.6 (D4), U27.6 (D4), U29.6 (D4), U31.6 (D4), U33.6 (D4), U35.6 (D4), U37.6 (D4), U39.6 (D4), U41.6 (D4), U43.6 (D3), U47.14 (Y4), U65.14 (Y4), U103.14 (Y4), U109.14 (Y4), U112.6 (A4), U114.6 (A4), U125.2 (1B), U195.14 (Y4), U197.14 (Y4), U199.14 (Y4), U902.14 (Y4), U904.14 (Y4), U906.14 (Y4), U908.14 (Y4), U910.14 (Y4)
BUS5: RN1.7 (R6), RN3.6 (R6A), U19.7 (D5), U21.7 (D5), U23.7 (D5), U25.7 (D5), U27.7 (D5), U29.7 (D5), U31.7 (D5), U33.7 (D5), U35.7 (D5), U37.7 (D5), U39.7 (D5), U41.7 (D5), U44.3 (D0), U47.13 (Y5), U65.13 (Y5), U103.13 (Y5), U109.13 (Y5), U112.7 (A5), U114.7 (A5), U195.13 (Y5), U197.13 (Y5), U199.13 (Y5), U902.13 (Y5), U904.13 (Y5), U906.13 (Y5), U908.13 (Y5), U910.13 (Y5)
BUS6: RN1.8 (R7), RN3.7 (R7A), U19.8 (D6), U21.8 (D6), U23.8 (D6), U25.8 (D6), U27.8 (D6), U29.8 (D6), U31.8 (D6), U33.8 (D6), U35.8 (D6), U37.8 (D6), U39.8 (D6), U41.8 (D6), U44.4 (D1), U47.12 (Y6), U65.12 (Y6), U103.12 (Y6), U109.12 (Y6), U112.8 (A6), U114.8 (A6), U195.12 (Y6), U197.12 (Y6), U199.12 (Y6), U902.12 (Y6), U904.12 (Y6), U906.12 (Y6), U908.12 (Y6), U910.12 (Y6)
BUS7: RN1.9 (R8), RN3.8 (R8A), U19.9 (D7), U21.9 (D7), U23.9 (D7), U25.9 (D7), U27.9 (D7), U29.9 (D7), U31.9 (D7), U33.9 (D7), U35.9 (D7), U37.9 (D7), U39.9 (D7), U41.9 (D7), U44.5 (D2), U47.11 (Y7), U65.11 (Y7), U103.11 (Y7), U109.11 (Y7), U112.9 (A7), U114.9 (A7), U195.11 (Y7), U197.11 (Y7), U199.11 (Y7), U902.11 (Y7), U904.11 (Y7), U906.11 (Y7), U908.11 (Y7), U910.11 (Y7)
BUS8: RN2.2 (R1), RN4.1 (R1A), U20.2 (D0), U22.2 (D0), U24.2 (D0), U26.2 (D0), U28.2 (D0), U30.2 (D0), U32.2 (D0), U34.2 (D0), U36.2 (D0), U38.2 (D0), U40.2 (D0), U42.2 (D0), U44.6 (D3), U48.18 (Y0), U66.18 (Y0), U104.18 (Y0), U110.18 (Y0), U113.2 (A0), U115.18 (Y0), U196.18 (Y0), U198.18 (Y0), U901.18 (Y0), U903.18 (Y0), U905.18 (Y0), U907.18 (Y0), U909.18 (Y0), U911.18 (Y0)
BUS9: RN2.3 (R2), RN4.2 (R2A), U20.3 (D1), U22.3 (D1), U24.3 (D1), U26.3 (D1), U28.3 (D1), U30.3 (D1), U32.3 (D1), U34.3 (D1), U36.3 (D1), U38.3 (D1), U40.3 (D1), U42.3 (D1), U45.3 (D0), U48.17 (Y1), U66.17 (Y1), U104.17 (Y1), U110.17 (Y1), U113.3 (A1), U115.17 (Y1), U196.17 (Y1), U198.17 (Y1), U901.17 (Y1), U903.17 (Y1), U905.17 (Y1), U907.17 (Y1), U909.17 (Y1), U911.17 (Y1)
BUS10: RN2.4 (R3), RN4.3 (R3A), U20.4 (D2), U22.4 (D2), U24.4 (D2), U26.4 (D2), U28.4 (D2), U30.4 (D2), U32.4 (D2), U34.4 (D2), U36.4 (D2), U38.4 (D2), U40.4 (D2), U42.4 (D2), U45.4 (D1), U48.16 (Y2), U66.16 (Y2), U104.16 (Y2), U110.16 (Y2), U113.4 (A2), U115.16 (Y2), U196.16 (Y2), U198.16 (Y2), U901.16 (Y2), U903.16 (Y2), U905.16 (Y2), U907.16 (Y2), U909.16 (Y2), U911.16 (Y2)
BUS11: RN2.5 (R4), RN4.4 (R4A), U20.5 (D3), U22.5 (D3), U24.5 (D3), U26.5 (D3), U28.5 (D3), U30.5 (D3), U32.5 (D3), U34.5 (D3), U36.5 (D3), U38.5 (D3), U40.5 (D3), U42.5 (D3), U45.5 (D2), U48.15 (Y3), U66.15 (Y3), U104.15 (Y3), U110.15 (Y3), U113.5 (A3), U115.15 (Y3), U196.15 (Y3), U198.15 (Y3), U901.15 (Y3), U903.15 (Y3), U905.15 (Y3), U907.15 (Y3), U909.15 (Y3), U911.15 (Y3)
BUS12: RN2.6 (R5), RN4.5 (R5A), U20.6 (D4), U22.6 (D4), U24.6 (D4), U26.6 (D4), U28.6 (D4), U30.6 (D4), U32.6 (D4), U34.6 (D4), U36.6 (D4), U38.6 (D4), U40.6 (D4), U42.6 (D4), U45.6 (D3), U48.14 (Y4), U66.14 (Y4), U104.14 (Y4), U110.14 (Y4), U113.6 (A4), U115.14 (Y4), U196.14 (Y4), U198.14 (Y4), U901.14 (Y4), U903.14 (Y4), U905.14 (Y4), U907.14 (Y4), U909.14 (Y4), U911.14 (Y4)
BUS13: RN2.7 (R6), RN4.6 (R6A), U20.7 (D5), U22.7 (D5), U24.7 (D5), U26.7 (D5), U28.7 (D5), U30.7 (D5), U32.7 (D5), U34.7 (D5), U36.7 (D5), U38.7 (D5), U40.7 (D5), U42.7 (D5), U46.3 (D0), U48.13 (Y5), U66.13 (Y5), U104.13 (Y5), U110.13 (Y5), U113.7 (A5), U115.13 (Y5), U196.13 (Y5), U198.13 (Y5), U901.13 (Y5), U903.13 (Y5), U905.13 (Y5), U907.13 (Y5), U909.13 (Y5), U911.13 (Y5)
BUS14: RN2.8 (R7), RN4.7 (R7A), U20.8 (D6), U22.8 (D6), U24.8 (D6), U26.8 (D6), U28.8 (D6), U30.8 (D6), U32.8 (D6), U34.8 (D6), U36.8 (D6), U38.8 (D6), U40.8 (D6), U42.8 (D6), U46.4 (D1), U48.12 (Y6), U66.12 (Y6), U104.12 (Y6), U110.12 (Y6), U113.8 (A6), U115.12 (Y6), U196.12 (Y6), U198.12 (Y6), U901.12 (Y6), U903.12 (Y6), U905.12 (Y6), U907.12 (Y6), U909.12 (Y6), U911.12 (Y6)
BUS15: RN2.9 (R8), RN4.8 (R8A), U20.9 (D7), U22.9 (D7), U24.9 (D7), U26.9 (D7), U28.9 (D7), U30.9 (D7), U32.9 (D7), U34.9 (D7), U36.9 (D7), U38.9 (D7), U40.9 (D7), U42.9 (D7), U46.5 (D2), U48.11 (Y7), U66.11 (Y7), U104.11 (Y7), U110.11 (Y7), U113.9 (A7), U115.11 (Y7), U196.11 (Y7), U198.11 (Y7), U901.11 (Y7), U903.11 (Y7), U905.11 (Y7), U907.11 (Y7), U909.11 (Y7), U911.11 (Y7)
CFLAG: R35.1, U107.5 (1Q), U109.3 (A1), U111.3 (I1), U116.2 (1I0), U125.4 (2A)
CLK: J1.5, U9.2 (CP), U11.3 (1CLK), U11.11 (2CLK), U12.3 (1CLK), U43.2 (CP), U44.2 (CP), U45.2 (CP), U46.2 (CP), U130.1 (1A), U145.1 (1A)
CLKR: U118.12 (4A), U119.1 (1A), U119.4 (2A), U119.9 (3A), U124.9 (3A), U124.12 (4A), U145.4 (2Y)
CLK_I: U108.3 (1CLK), U124.11 (4Y)
CLK_IR: U41.11 (CP), U42.11 (CP), U119.8 (3Y)
CLK_MAR: U39.11 (CP), U40.11 (CP), U119.6 (2Y)
CLK_NZ: U106.3 (1CLK), U106.11 (2CLK), U107.3 (1CLK), U107.11 (2CLK), U124.8 (3Y)
CLK_R0: U19.11 (CP), U20.11 (CP), U133.1 (1Y)
CLK_R1: U21.11 (CP), U22.11 (CP), U133.4 (2Y)
CLK_R2: U23.11 (CP), U24.11 (CP), U133.10 (3Y)
CLK_R3: U25.11 (CP), U26.11 (CP), U133.13 (4Y)
CLK_R4: U27.11 (CP), U28.11 (CP), U134.1 (1Y)
CLK_R5: U29.11 (CP), U30.11 (CP), U134.4 (2Y)
CLK_R6: U31.11 (CP), U32.11 (CP), U134.10 (3Y)
CLK_R7: U33.11 (CP), U34.11 (CP), U134.13 (4Y)
CLK_TA: U35.11 (CP), U36.11 (CP), U118.11 (4Y)
CLK_TB: U37.11 (CP), U38.11 (CP), U119.3 (1Y)
CO0: U72.9 (COUT), U73.7 (CIN)
CO1: U73.9 (COUT), U74.7 (CIN)
CO2: U74.9 (COUT), U75.7 (CIN)
COND: U129.13 (4B), U144.11 (4Y), U146.9 (4A)
CONDY: U111.5 (Y), U144.12 (4A)
CW0: U2.19 (Q0), U13.1 (A0)
CW1: U2.18 (Q1), U13.2 (A1)
CW2: U2.17 (Q2), U13.3 (A2)
CW3: U2.16 (Q3), U14.11 (S0), U15.11 (S0), U16.11 (S0)
CW4: U2.15 (Q4), U14.10 (S1), U15.10 (S1), U16.10 (S1)
CW5: U2.14 (Q5), U14.9 (S2), U15.9 (S2), U16.9 (S2)
CW6: U2.13 (Q6), U67.2 (1I0)
CW7: U2.12 (Q7), U67.5 (2I0)
CW8: U4.19 (Q0), U67.11 (3I0)
CW9: U4.18 (Q1), U67.14 (4I0)
CW10: U4.17 (Q2), U163.12 (4A)
CW11: U4.16 (Q3), U67.1 (S), U178.13 (6A)
CW12: U4.15 (Q4), U49.11 (S0), U50.11 (S0), U51.11 (S0), U52.11 (S0), U53.11 (S0), U54.11 (S0), U55.11 (S0), U56.11 (S0), U57.11 (S0), U58.11 (S0), U59.11 (S0), U60.11 (S0), U61.11 (S0), U62.11 (S0), U63.11 (S0), U64.11 (S0)
CW13: U4.14 (Q5), U49.10 (S1), U50.10 (S1), U51.10 (S1), U52.10 (S1), U53.10 (S1), U54.10 (S1), U55.10 (S1), U56.10 (S1), U57.10 (S1), U58.10 (S1), U59.10 (S1), U60.10 (S1), U61.10 (S1), U62.10 (S1), U63.10 (S1), U64.10 (S1)
CW14: U4.13 (Q6), U49.9 (S2), U50.9 (S2), U51.9 (S2), U52.9 (S2), U53.9 (S2), U54.9 (S2), U55.9 (S2), U56.9 (S2), U57.9 (S2), U58.9 (S2), U59.9 (S2), U60.9 (S2), U61.9 (S2), U62.9 (S2), U63.9 (S2), U64.9 (S2)
CW16: U6.19 (Q0), U17.6 (E3)
CW17: R27.1, U6.18 (Q1), U118.13 (4B)
CW18: R28.1, U6.17 (Q2), U119.2 (1B)
CW19: U6.16 (Q3), U130.9 (3A)
CW20: U6.15 (Q4), U119.12 (4A)
CW21: R29.1, U6.14 (Q5), U119.5 (2B)
CW22: U6.13 (Q6), U125.12 (4A)
CW23: R30.1, U6.12 (Q7), U119.10 (3B)
CW24: U8.19 (Q0), U128.4 (2A)
CW25: U8.18 (Q1), U105.1 (S), U125.1 (1A), U128.5 (2B), U128.13 (4B)
CW26: U8.17 (Q2), U128.9 (3A), U129.1 (1A)
CW27: U8.16 (Q3), U128.10 (3B)
CW28: U8.15 (Q4), U126.1 (1A), U130.12 (4A), U131.12 (4A), U146.1 (1A)
CW29: U8.14 (Q5), U118.1 (1A)
CW30: U8.13 (Q6), U118.4 (2A)
CW31: U8.12 (Q7), U130.4 (2A)
C_ADD: U75.9 (COUT), U100.6 (1I0)
C_ALU: U100.7 (1Y), U116.3 (1I1)
C_NEW: U105.11 (3I0), U116.4 (1Y)
DC: U105.9 (3Y), U107.2 (1D)
DE0: J1.25, U112.18 (B0)
DE1: J1.26, U112.17 (B1)
DE2: J1.27, U112.16 (B2)
DE3: J1.28, U112.15 (B3)
DE4: J1.29, U112.14 (B4)
DE5: J1.30, U112.13 (B5)
DE6: J1.31, U112.12 (B6)
DE7: J1.32, U112.11 (B7)
DI: U108.2 (1D), U129.3 (1Y)
DN: U105.4 (1Y), U106.2 (1D)
DO0: J1.33, U113.18 (B0), U114.18 (B0)
DO1: J1.34, U113.17 (B1), U114.17 (B1)
DO2: J1.35, U113.16 (B2), U114.16 (B2)
DO3: J1.36, U113.15 (B3), U114.15 (B3)
DO4: J1.37, U113.14 (B4), U114.14 (B4)
DO5: J1.38, U113.13 (B5), U114.13 (B5)
DO6: J1.39, U113.12 (B6), U114.12 (B6)
DO7: J1.40, U113.11 (B7), U114.11 (B7)
DV: U105.12 (4Y), U107.12 (2D)
DZ: U105.7 (2Y), U106.12 (2D)
D_FAULT: U12.2 (1D), U127.8 (3Y)
D_HALTED: U11.12 (2D), U127.6 (2Y)
FAULT: J1.45, R2.1, U12.5 (1Q), U127.9 (3A)
GND: C1.2 (-), C2.2, C3.2, C4.2, C5.2, C6.2, C7.2, C8.2, C9.2, C10.2, C11.2, C12.2, C13.2, C14.2, C15.2, C16.2, C17.2, C18.2, C19.2, C20.2, C21.2, C22.2, C23.2, C24.2, C25.2, C26.2, C27.2, C28.2, C29.2, C30.2, C31.2, C32.2, C33.2, C34.2, C35.2, C36.2, C37.2, C38.2, C39.2, C40.2, C41.2, C42.2, C43.2, C44.2, C45.2, C46.2, C47.2, C48.2, C49.2, C50.2, C51.2, C52.2, C53.2, C54.2, C55.2, C56.2, C57.2, C58.2, C59.2, C60.2, C61.2, C62.2, C63.2, C64.2, C65.2, C66.2, C67.2, C68.2, C69.2, C70.2, C71.2, C72.2, C73.2, C74.2, C75.2, C76.2, C77.2, C78.2, C79.2, C80.2, C81.2, C82.2, C83.2, C84.2, C85.2, C86.2, C87.2, C88.2, C89.2, C90.2, C91.2, C92.2, C93.2, C94.2, C95.2, C96.2, C97.2, C98.2, C99.2, C100.2, C101.2, C102.2, C103.2, C104.2, C105.2, C106.2, C107.2, C108.2, C109.2, C110.2, C111.2, C112.2, C113.2, C114.2, C115.2, C116.2, C117.2, C118.2, C119.2, C120.2, C121.2, C122.2, C123.2, C124.2, C125.2, C126.2, C127.2, C128.2, C129.2, C130.2, C131.2, C132.2, C133.2, C134.2, C135.2, C136.2, C137.2, C138.2, C139.2, C140.2, C141.2, C142.2, C143.2, C144.2, C145.2, C146.2, C147.2, C148.2, C149.2, C150.2, C151.2, C152.2, C153.2, C154.2, C155.2, C156.2, C157.2, C158.2, C159.2, C160.2, C161.2, C162.2, C163.2, C164.2, C165.2, C166.2, C167.2, C168.2, C169.2, C170.2, C171.2, C172.2, C173.2, C174.2, C175.2, C176.2, C177.2, C178.2, C179.2, C180.2, C181.2, C182.2, C183.2, C184.2, C185.2, C186.2, C187.2, C188.2, C189.2, C190.2, C191.2, C192.2, C193.2, C194.2, C195.2, C196.2, C197.2, C198.2, C199.2, C901.2, C902.2, C903.2, C904.2, C905.2, C906.2, C907.2, C908.2, C909.2, C910.2, C911.2, C912.2, D1.2 (K), D2.2 (K), D25.2 (K), D26.2 (K), D27.2 (K), D28.2 (K), D29.2 (K), D30.2 (K), D32.2 (K), D33.2 (K), D34.2 (K), D35.2 (K), D36.2 (K), D37.2 (K), D38.2 (K), D39.2 (K), D40.2 (K), D41.2 (K), DS1.13 (K8), DS1.14 (K7), DS1.15 (K6), DS1.16 (K5), DS1.17 (K4), DS1.18 (K3), DS1.19 (K2), DS1.20 (K1), DS2.13 (K8), DS2.14 (K7), DS2.15 (K6), DS2.16 (K5), DS2.17 (K4), DS2.18 (K3), DS2.19 (K2), DS2.20 (K1), DS3.13 (K8), DS3.14 (K7), DS3.15 (K6), DS3.16 (K5), DS3.17 (K4), DS3.18 (K3), DS3.19 (K2), DS4.13 (K8), DS4.14 (K7), DS4.15 (K6), DS4.16 (K5), DS4.17 (K4), DS4.18 (K3), DS4.19 (K2), DS4.20 (K1), DS5.13 (K8), DS5.14 (K7), DS5.15 (K6), DS5.16 (K5), DS5.17 (K4), DS5.18 (K3), DS5.19 (K2), DS5.20 (K1), DS6.13 (K8), DS6.14 (K7), DS6.15 (K6), DS6.16 (K5), DS6.17 (K4), DS6.18 (K3), DS6.19 (K2), DS6.20 (K1), DS7.13 (K8), DS7.14 (K7), DS7.15 (K6), DS7.16 (K5), DS7.17 (K4), DS7.18 (K3), DS7.19 (K2), DS7.20 (K1), DS8.13 (K8), DS8.14 (K7), DS8.15 (K6), DS8.16 (K5), DS8.17 (K4), DS8.18 (K3), DS8.19 (K2), DS8.20 (K1), DS9.13 (K8), DS9.14 (K7), DS9.15 (K6), DS9.16 (K5), DS9.17 (K4), DS9.18 (K3), DS9.19 (K2), DS9.20 (K1), DS10.13 (K8), DS10.14 (K7), DS10.15 (K6), DS10.16 (K5), DS10.17 (K4), DS10.18 (K3), DS10.19 (K2), DS10.20 (K1), DS11.13 (K8), DS11.14 (K7), DS11.15 (K6), DS11.16 (K5), DS11.17 (K4), DS11.18 (K3), DS11.19 (K2), DS11.20 (K1), DS12.13 (K8), DS12.14 (K7), DS12.15 (K6), DS12.16 (K5), DS12.17 (K4), DS12.18 (K3), DS12.19 (K2), DS12.20 (K1), DS13.13 (K8), DS13.14 (K7), DS13.15 (K6), DS13.16 (K5), DS13.17 (K4), DS13.18 (K3), DS13.19 (K2), DS13.20 (K1), DS14.13 (K8), DS14.14 (K7), DS14.15 (K6), DS14.16 (K5), DS14.17 (K4), DS14.18 (K3), DS14.19 (K2), DS14.20 (K1), DS15.13 (K8), DS15.14 (K7), DS15.15 (K6), DS15.16 (K5), DS15.17 (K4), DS15.18 (K3), DS15.19 (K2), DS15.20 (K1), DS16.13 (K8), DS16.14 (K7), DS16.15 (K6), DS16.16 (K5), DS16.17 (K4), DS16.18 (K3), DS16.19 (K2), DS16.20 (K1), DS17.13 (K8), DS17.14 (K7), DS17.15 (K6), DS17.16 (K5), DS17.17 (K4), DS17.18 (K3), DS17.19 (K2), DS17.20 (K1), DS18.13 (K8), DS18.14 (K7), DS18.15 (K6), DS18.16 (K5), DS18.17 (K4), DS18.18 (K3), DS18.19 (K2), DS18.20 (K1), DS19.13 (K8), DS19.14 (K7), DS19.15 (K6), DS19.16 (K5), DS19.17 (K4), DS19.18 (K3), DS19.19 (K2), DS19.20 (K1), DS20.13 (K8), DS20.14 (K7), DS20.15 (K6), DS20.16 (K5), DS20.17 (K4), DS20.18 (K3), DS20.19 (K2), DS20.20 (K1), DS21.13 (K8), DS21.14 (K7), DS21.15 (K6), DS21.16 (K5), DS21.17 (K4), DS21.18 (K3), DS21.19 (K2), DS21.20 (K1), DS22.13 (K8), DS22.14 (K7), DS22.15 (K6), DS22.16 (K5), DS22.17 (K4), DS22.18 (K3), DS22.19 (K2), DS22.20 (K1), DS23.13 (K8), DS23.14 (K7), DS23.15 (K6), DS23.16 (K5), DS23.17 (K4), DS23.18 (K3), DS23.19 (K2), DS23.20 (K1), DS24.13 (K8), DS24.14 (K7), DS24.15 (K6), DS24.16 (K5), DS24.17 (K4), DS24.18 (K3), DS24.19 (K2), DS24.20 (K1), DS25.13 (K8), DS25.14 (K7), DS25.15 (K6), DS25.16 (K5), DS25.17 (K4), DS25.18 (K3), DS25.19 (K2), DS25.20 (K1), DS26.13 (K8), DS26.14 (K7), DS26.15 (K6), DS26.16 (K5), DS26.17 (K4), DS26.18 (K3), DS26.19 (K2), DS26.20 (K1), J1.1, J1.2, J1.62, J1.64, RN1.1 (COM), RN2.1 (COM), U1.8 (GND), U2.1 (~OE), U2.10 (GND), U3.5 (~E2), U3.8 (GND), U4.1 (~OE), U4.2 (D0), U4.3 (D1), U4.9 (D7), U4.10 (GND), U5.5 (~E2), U5.8 (GND), U6.1 (~OE), U6.10 (GND), U7.5 (~E2), U7.8 (GND), U8.1 (~OE), U8.10 (GND), U9.3 (D0), U9.4 (D1), U9.5 (D2), U9.6 (D3), U9.8 (GND), U10.5 (~E2), U10.8 (GND), U11.7 (GND), U12.7 (GND), U13.4 (~E1), U13.5 (~E2), U13.8 (GND), U14.1 (I3), U14.7 (~E), U14.8 (GND), U14.12 (I7), U14.13 (I6), U14.14 (I5), U15.7 (~E), U15.8 (GND), U15.12 (I7), U15.13 (I6), U15.14 (I5), U16.7 (~E), U16.8 (GND), U16.12 (I7), U16.13 (I6), U16.14 (I5), U17.4 (~E1), U17.5 (~E2), U17.8 (GND), U18.5 (~E2), U18.8 (GND), U19.1 (~OE), U19.10 (GND), U20.1 (~OE), U20.10 (GND), U21.1 (~OE), U21.10 (GND), U22.1 (~OE), U22.10 (GND), U23.1 (~OE), U23.10 (GND), U24.1 (~OE), U24.10 (GND), U25.1 (~OE), U25.10 (GND), U26.1 (~OE), U26.10 (GND), U27.1 (~OE), U27.10 (GND), U28.1 (~OE), U28.10 (GND), U29.1 (~OE), U29.10 (GND), U30.1 (~OE), U30.10 (GND), U31.1 (~OE), U31.10 (GND), U32.1 (~OE), U32.10 (GND), U33.1 (~OE), U33.10 (GND), U34.1 (~OE), U34.10 (GND), U35.1 (~OE), U35.10 (GND), U36.1 (~OE), U36.10 (GND), U37.1 (~OE), U37.10 (GND), U38.1 (~OE), U38.10 (GND), U39.1 (~OE), U39.10 (GND), U40.1 (~OE), U40.10 (GND), U41.1 (~OE), U41.10 (GND), U42.1 (~OE), U42.10 (GND), U43.8 (GND), U44.8 (GND), U45.8 (GND), U46.6 (D3), U46.8 (GND), U47.2 (A0), U47.10 (GND), U47.19 (~OE2), U48.10 (GND), U48.19 (~OE2), U49.3 (I1), U49.7 (~E), U49.8 (GND), U49.12 (I7), U49.13 (I6), U49.14 (I5), U49.15 (I4), U50.7 (~E), U50.8 (GND), U50.12 (I7), U51.7 (~E), U51.8 (GND), U51.13 (I6), U52.7 (~E), U52.8 (GND), U52.12 (I7), U52.13 (I6), U53.7 (~E), U53.8 (GND), U53.12 (I7), U53.13 (I6), U54.7 (~E), U54.8 (GND), U54.12 (I7), U54.13 (I6), U55.7 (~E), U55.8 (GND), U55.12 (I7), U55.13 (I6), U56.7 (~E), U56.8 (GND), U56.12 (I7), U56.13 (I6), U57.7 (~E), U57.8 (GND), U57.12 (I7), U57.13 (I6), U58.7 (~E), U58.8 (GND), U58.12 (I7), U58.13 (I6), U59.7 (~E), U59.8 (GND), U59.12 (I7), U59.13 (I6), U60.7 (~E), U60.8 (GND), U60.12 (I7), U60.13 (I6), U61.7 (~E), U61.8 (GND), U61.12 (I7), U61.13 (I6), U62.7 (~E), U62.8 (GND), U62.12 (I7), U62.13 (I6), U63.7 (~E), U63.8 (GND), U63.12 (I7), U63.13 (I6), U64.7 (~E), U64.8 (GND), U64.12 (I7), U64.13 (I6), U65.10 (GND), U65.19 (~OE2), U66.10 (GND), U66.19 (~OE2), U67.8 (GND), U67.15 (~E), U68.5 (~E2), U68.8 (GND), U69.8 (GND), U70.5 (~E2), U70.8 (GND), U71.5 (~E2), U71.8 (GND), U72.8 (GND), U73.8 (GND), U74.8 (GND), U75.8 (GND), U76.7 (~E), U76.8 (GND), U76.9 (S2), U76.12 (I7), U76.13 (I6), U76.14 (I5), U76.15 (I4), U77.7 (~E), U77.8 (GND), U77.9 (S2), U77.12 (I7), U77.13 (I6), U77.14 (I5), U77.15 (I4), U78.7 (~E), U78.8 (GND), U78.9 (S2), U78.12 (I7), U78.13 (I6), U78.14 (I5), U78.15 (I4), U79.7 (~E), U79.8 (GND), U79.9 (S2), U79.12 (I7), U79.13 (I6), U79.14 (I5), U79.15 (I4), U80.7 (~E), U80.8 (GND), U80.9 (S2), U80.12 (I7), U80.13 (I6), U80.14 (I5), U80.15 (I4), U81.7 (~E), U81.8 (GND), U81.9 (S2), U81.12 (I7), U81.13 (I6), U81.14 (I5), U81.15 (I4), U82.7 (~E), U82.8 (GND), U82.9 (S2), U82.12 (I7), U82.13 (I6), U82.14 (I5), U82.15 (I4), U83.7 (~E), U83.8 (GND), U83.9 (S2), U83.12 (I7), U83.13 (I6), U83.14 (I5), U83.15 (I4), U84.7 (~E), U84.8 (GND), U85.7 (~E), U85.8 (GND), U86.7 (~E), U86.8 (GND), U87.7 (~E), U87.8 (GND), U88.7 (~E), U88.8 (GND), U89.7 (~E), U89.8 (GND), U90.7 (~E), U90.8 (GND), U91.7 (~E), U91.8 (GND), U92.1 (~1E), U92.8 (GND), U92.15 (~2E), U93.1 (~1E), U93.8 (GND), U93.15 (~2E), U94.1 (~1E), U94.8 (GND), U94.15 (~2E), U95.1 (~1E), U95.8 (GND), U95.15 (~2E), U96.1 (~1E), U96.8 (GND), U96.15 (~2E), U97.1 (~1E), U97.8 (GND), U97.15 (~2E), U98.1 (~1E), U98.8 (GND), U98.15 (~2E), U99.1 (~1E), U99.8 (GND), U99.15 (~2E), U100.1 (~1E), U100.5 (1I1), U100.8 (GND), U100.11 (2I1), U100.12 (2I2), U100.13 (2I3), U100.15 (~2E), U101.1 (~E), U101.3 (Q0), U101.5 (Q1), U101.7 (Q2), U101.9 (Q3), U101.10 (GND), U101.12 (Q4), U101.14 (Q5), U101.16 (Q6), U101.18 (Q7), U102.1 (~E), U102.3 (Q0), U102.5 (Q1), U102.7 (Q2), U102.9 (Q3), U102.10 (GND), U102.12 (Q4), U102.14 (Q5), U102.16 (Q6), U102.18 (Q7), U103.10 (GND), U103.19 (~OE2), U104.10 (GND), U104.19 (~OE2), U105.8 (GND), U105.15 (~E), U106.7 (GND), U107.7 (GND), U108.7 (GND), U108.11 (2CLK), U108.12 (2D), U109.7 (A5), U109.8 (A6), U109.9 (A7), U109.10 (GND), U109.19 (~OE2), U110.2 (A0), U110.3 (A1), U110.4 (A2), U110.5 (A3), U110.6 (A4), U110.7 (A5), U110.8 (A6), U110.9 (A7), U110.10 (GND), U110.19 (~OE2), U111.7 (~E), U111.8 (GND), U112.10 (GND), U113.10 (GND), U114.10 (GND), U115.2 (A0), U115.3 (A1), U115.4 (A2), U115.5 (A3), U115.6 (A4), U115.7 (A5), U115.8 (A6), U115.9 (A7), U115.10 (GND), U115.19 (~OE2), U116.8 (GND), U116.10 (3I1), U116.11 (3I0), U116.13 (4I1), U116.14 (4I0), U116.15 (~E), U117.7 (GND), U118.7 (GND), U119.7 (GND), U120.7 (GND), U121.7 (GND), U122.7 (GND), U123.7 (GND), U124.7 (GND), U125.7 (GND), U126.7 (GND), U127.7 (GND), U128.7 (GND), U129.7 (GND), U130.7 (GND), U131.7 (GND), U132.7 (GND), U133.7 (GND), U134.7 (GND), U135.6 (2B), U135.7 (GND), U136.7 (GND), U137.7 (GND), U138.7 (GND), U139.7 (GND), U140.7 (GND), U141.7 (GND), U142.7 (GND), U143.7 (GND), U144.7 (GND), U145.7 (GND), U146.7 (GND), U147.8 (GND), U148.3 (I1), U148.8 (GND), U149.2 (I2), U149.4 (I0), U149.8 (GND), U150.1 (I3), U150.3 (I1), U150.8 (GND), U151.3 (I1), U151.8 (GND), U152.1 (I3), U152.3 (I1), U152.4 (I0), U152.8 (GND), U152.13 (I6), U153.3 (I1), U153.4 (I0), U153.8 (GND), U154.1 (I3), U154.3 (I1), U154.8 (GND), U154.12 (I7), U155.1 (I3), U155.3 (I1), U155.8 (GND), U155.13 (I6), U156.3 (I1), U156.4 (I0), U156.8 (GND), U156.13 (I6), U157.7 (GND), U158.7 (GND), U159.7 (GND), U160.7 (GND), U161.7 (GND), U162.7 (GND), U163.7 (GND), U164.7 (GND), U165.7 (GND), U166.7 (GND), U167.7 (GND), U168.7 (GND), U169.7 (GND), U170.7 (GND), U171.7 (GND), U172.7 (GND), U173.7 (GND), U174.7 (GND), U175.7 (GND), U176.7 (GND), U177.7 (GND), U178.7 (GND), U179.7 (GND), U180.7 (GND), U181.7 (GND), U182.7 (GND), U183.7 (GND), U184.7 (GND), U185.7 (GND), U186.7 (GND), U187.7 (GND), U188.7 (GND), U189.7 (GND), U190.7 (GND), U191.7 (GND), U192.7 (GND), U193.7 (GND), U194.7 (GND), U195.10 (GND), U195.19 (~OE2), U196.10 (GND), U196.19 (~OE2), U197.10 (GND), U197.19 (~OE2), U198.10 (GND), U198.19 (~OE2), U199.10 (GND), U199.19 (~OE2), U901.10 (GND), U901.19 (~OE2), U902.10 (GND), U902.19 (~OE2), U903.10 (GND), U903.19 (~OE2), U904.10 (GND), U904.19 (~OE2), U905.10 (GND), U905.19 (~OE2), U906.10 (GND), U906.19 (~OE2), U907.10 (GND), U907.19 (~OE2), U908.10 (GND), U908.19 (~OE2), U909.10 (GND), U909.19 (~OE2), U910.10 (GND), U910.19 (~OE2), U911.10 (GND), U911.19 (~OE2)
HALTED: J1.44, R1.1, U11.9 (2Q), U117.12 (4A)
IFLAG: R37.1, U108.5 (1Q), U109.6 (A4), U117.2 (1B)
IMM0: U49.5 (Y), U65.2 (A0)
IMM1: U50.5 (Y), U65.3 (A1)
IMM2: U51.5 (Y), U65.4 (A2)
IMM3: U52.5 (Y), U65.5 (A3)
IMM4: U53.5 (Y), U65.6 (A4)
IMM5: U54.5 (Y), U65.7 (A5)
IMM6: U55.5 (Y), U65.8 (A6)
IMM7: U56.5 (Y), U65.9 (A7)
IMM8: U57.5 (Y), U66.2 (A0)
IMM9: U58.5 (Y), U66.3 (A1)
IMM10: U59.5 (Y), U66.4 (A2)
IMM11: U60.5 (Y), U66.5 (A3)
IMM12: U61.5 (Y), U66.6 (A4)
IMM13: U62.5 (Y), U66.7 (A5)
IMM14: U63.5 (Y), U66.8 (A6)
IMM15: U64.5 (Y), U66.9 (A7)
INT: U1.5 (~E2), U3.4 (~E1), U11.2 (1D), U127.3 (1Y), U135.5 (2A), U147.3 (I1), U147.12 (I7), U149.13 (I6), U150.4 (I0), U151.4 (I0), U152.2 (I2), U152.14 (I5), U154.4 (I0), U154.15 (I4), U175.3 (1B)
INT_HOLD: U11.5 (1Q), U117.10 (3B)
IR0: RN9.1 (R1A), U5.1 (A0), U7.1 (A0), U41.19 (Q0), U49.1 (I3), U49.2 (I2), U49.4 (I0), U50.3 (I1), U50.14 (I5), U50.15 (I4), U57.2 (I2), U67.3 (1I1), U182.3 (2A)
IR1: RN9.2 (R2A), U5.2 (A1), U7.2 (A1), U41.18 (Q1), U50.1 (I3), U50.2 (I2), U50.4 (I0), U51.3 (I1), U51.14 (I5), U51.15 (I4), U58.2 (I2), U67.6 (2I1), U182.4 (2B)
IR2: RN9.3 (R3A), U5.3 (A2), U7.3 (A2), U41.17 (Q2), U51.1 (I3), U51.2 (I2), U51.4 (I0), U52.3 (I1), U52.14 (I5), U52.15 (I4), U59.2 (I2), U67.10 (3I1), U182.5 (2C)
IR3: RN9.4 (R4A), U14.2 (I2), U41.16 (Q3), U52.1 (I3), U52.2 (I2), U52.4 (I0), U53.3 (I1), U53.14 (I5), U53.15 (I4), U60.2 (I2)
IR4: RN9.5 (R5A), U15.2 (I2), U41.15 (Q4), U53.1 (I3), U53.2 (I2), U53.4 (I0), U54.3 (I1), U54.14 (I5), U54.15 (I4), U61.2 (I2)
IR5: RN9.6 (R6A), U16.2 (I2), U41.14 (Q5), U54.1 (I3), U54.2 (I2), U54.4 (I0), U55.3 (I1), U55.4 (I0), U55.14 (I5), U55.15 (I4), U56.3 (I1), U56.4 (I0), U57.3 (I1), U57.4 (I0), U58.3 (I1), U58.4 (I0), U59.3 (I1), U59.4 (I0), U60.3 (I1), U60.4 (I0), U61.3 (I1), U61.4 (I0), U62.2 (I2), U62.3 (I1), U62.4 (I0), U63.3 (I1), U63.4 (I0), U64.3 (I1), U64.4 (I0)
IR6: RN9.7 (R7A), U14.3 (I1), U41.13 (Q6), U55.1 (I3), U55.2 (I2), U56.14 (I5), U56.15 (I4), U63.2 (I2)
IR7: RN9.8 (R8A), U15.3 (I1), U41.12 (Q7), U56.1 (I3), U56.2 (I2), U57.14 (I5), U57.15 (I4), U58.15 (I4), U59.15 (I4), U60.15 (I4), U61.15 (I4), U62.15 (I4), U63.15 (I4), U64.2 (I2), U64.15 (I4)
IR8: RN10.1 (R1A), U16.3 (I1), U42.19 (Q0), U57.1 (I3), U58.1 (I3), U58.14 (I5), U59.1 (I3), U60.1 (I3), U61.1 (I3), U62.1 (I3), U63.1 (I3), U64.1 (I3), U144.13 (4B), U169.12 (4A), U178.9 (4A)
IR9: RN10.2 (R2A), U14.4 (I0), U42.18 (Q1), U59.14 (I5), U111.11 (S0)
IR10: RN10.3 (R3A), U15.4 (I0), U42.17 (Q2), U60.14 (I5), U111.10 (S1)
IR11: RN10.4 (R4A), U16.4 (I0), U42.16 (Q3), U61.14 (I5), U62.14 (I5), U63.14 (I5), U64.14 (I5), U111.9 (S2)
IR12: RN10.5 (R5A), U1.1 (A0), U3.1 (A0), U42.15 (Q4), U67.13 (4I1)
IR13: RN10.6 (R6A), U1.2 (A1), U3.2 (A1), U42.14 (Q5)
IR14: RN10.7 (R7A), U1.3 (A2), U3.3 (A2), U42.13 (Q6)
IR15: RN10.8 (R8A), U1.4 (~E1), U3.6 (E3), U42.12 (Q7)
IRQ: J1.8, U117.1 (1A)
I_LD: U124.13 (4B), U128.11 (4Y)
KOP13: U179.1 (1A), U191.6 (1Y)
LANE_E: U126.5 (2B), U130.11 (4Y), U131.1 (1A)
LANE_OB: U126.3 (1Y), U131.9 (3A)
LED_CFLAG: D35.1 (A), R35.2
LED_FAULT: D2.1 (A), R2.2
LED_HALTED: D1.1 (A), R1.2
LED_IFLAG: D37.1 (A), R37.2
LED_IR_L: D30.1 (A), R30.2
LED_MAR_L: D29.1 (A), R29.2
LED_MEMRD: D25.1 (A), R25.2
LED_MEMW: D26.1 (A), R26.2
LED_NFLAG: D33.1 (A), R33.2
LED_PC_INC: D32.1 (A), R32.2
LED_PC_L: D31.1 (A), R31.2
LED_ROE0: D3.1 (A), R3.2
LED_ROE1: D5.1 (A), R5.2
LED_ROE2: D7.1 (A), R7.2
LED_ROE3: D9.1 (A), R9.2
LED_ROE4: D11.1 (A), R11.2
LED_ROE5: D13.1 (A), R13.2
LED_ROE6: D15.1 (A), R15.2
LED_ROE7: D17.1 (A), R17.2
LED_SRC_ALU: D20.1 (A), R20.2
LED_SRC_FLAGS: D24.1 (A), R24.2
LED_SRC_IMM: D23.1 (A), R23.2
LED_SRC_MEM: D22.1 (A), R22.2
LED_SRC_PC: D21.1 (A), R21.2
LED_SRC_REG: D19.1 (A), R19.2
LED_STEP0: D38.1 (A), R38.2
LED_STEP1: D39.1 (A), R39.2
LED_STEP2: D40.1 (A), R40.2
LED_STEP3: D41.1 (A), R41.2
LED_TA_L: D27.1 (A), R27.2
LED_TB_L: D28.1 (A), R28.2
LED_VFLAG: D36.1 (A), R36.2
LED_WSEL0: D4.1 (A), R4.2
LED_WSEL1: D6.1 (A), R6.2
LED_WSEL2: D8.1 (A), R8.2
LED_WSEL3: D10.1 (A), R10.2
LED_WSEL4: D12.1 (A), R12.2
LED_WSEL5: D14.1 (A), R14.2
LED_WSEL6: D16.1 (A), R16.2
LED_WSEL7: D18.1 (A), R18.2
LED_ZFLAG: D34.1 (A), R34.2
LOGIC0: U76.5 (Y), U92.5 (1I1)
LOGIC1: U77.5 (Y), U92.11 (2I1)
LOGIC2: U78.5 (Y), U93.5 (1I1)
LOGIC3: U79.5 (Y), U93.11 (2I1)
LOGIC4: U80.5 (Y), U94.5 (1I1)
LOGIC5: U81.5 (Y), U94.11 (2I1)
LOGIC6: U82.5 (Y), U95.5 (1I1)
LOGIC7: U83.5 (Y), U95.11 (2I1)
LOGIC8: U84.5 (Y), U96.5 (1I1)
LOGIC9: U85.5 (Y), U96.11 (2I1)
LOGIC10: U86.5 (Y), U97.5 (1I1)
LOGIC11: U87.5 (Y), U97.11 (2I1)
LOGIC12: U88.5 (Y), U98.5 (1I1)
LOGIC13: U89.5 (Y), U98.11 (2I1)
LOGIC14: U90.5 (Y), U99.5 (1I1)
LOGIC15: U91.5 (Y), U99.11 (2I1)
MEMRD: R25.1, U129.4 (2A), U131.13 (4B), U145.12 (6Y), U146.3 (2A)
MEMW: R26.1, U112.1 (DIR), U113.1 (DIR), U114.1 (DIR), U125.11 (4Y), U126.4 (2A), U126.9 (3A), U129.5 (2B)
MEM_ACC: U129.6 (2Y), U131.2 (1B), U131.5 (2B), U131.10 (3B)
MK0: U2.2 (D0), U132.8 (3Y)
MK1: U2.3 (D1), U170.6 (2Y)
MK2: U2.4 (D2), U170.8 (3Y)
MK3: U2.5 (D3), U150.5 (Y)
MK4: U2.6 (D4), U151.5 (Y)
MK5: U2.7 (D5), U135.10 (3Y)
MK6: U2.8 (D6), U135.13 (4Y)
MK7: U2.9 (D7), U152.5 (Y)
MK10: U4.4 (D2), U171.11 (4Y)
MK11: U4.5 (D3), U172.3 (1Y)
MK12: U4.6 (D4), U172.6 (2Y)
MK13: U4.7 (D5), U181.8 (3Y)
MK14: U4.8 (D6), U182.12 (1Y)
MK16: U6.2 (D0), U153.5 (Y)
MK17: U6.3 (D1), U154.5 (Y)
MK18: U6.4 (D2), U173.3 (1Y)
MK19: U6.5 (D3), U192.6 (1Y)
MK20: U6.6 (D4), U6.9 (D7), U175.1 (1Y)
MK21: U6.7 (D5), U155.5 (Y)
MK22: U6.8 (D6), U183.6 (2Y)
MK24: U8.2 (D0), U173.8 (3Y)
MK25: U8.3 (D1), U175.4 (2Y)
MK26: U8.4 (D2), U175.10 (3Y)
MK27: U8.5 (D3), U183.8 (3Y)
MK28: U8.6 (D4), U175.13 (4Y)
MK29: U8.7 (D5), U176.1 (1Y)
MK30: U8.8 (D6), U176.4 (2Y)
MK31: U8.9 (D7), U173.11 (4Y)
N468: U117.6 (2Y), U127.1 (1A)
N469: U117.8 (3Y), U127.2 (1B)
N472: U117.11 (4Y), U127.4 (2A)
N474: U118.3 (1Y), U127.5 (2B)
N478: U118.6 (2Y), U127.10 (3B)
N481: U118.10 (3B), U127.11 (4Y)
N1406: U120.3 (1Y), U140.1 (1A)
N1408: U120.6 (2Y), U140.4 (2A)
N1410: U120.8 (3Y), U140.9 (3A)
N1412: U120.11 (4Y), U140.12 (4A)
N1414: U121.3 (1Y), U141.1 (1A)
N1416: U121.6 (2Y), U141.4 (2A)
N1418: U121.8 (3Y), U141.9 (3A)
N1420: U121.11 (4Y), U141.12 (4A)
N1422: U122.3 (1Y), U142.1 (1A)
N1424: U122.6 (2Y), U142.4 (2A)
N1426: U122.8 (3Y), U142.9 (3A)
N1428: U122.11 (4Y), U142.12 (4A)
N1430: U123.3 (1Y), U143.1 (1A)
N1432: U123.6 (2Y), U143.4 (2A)
N1434: U123.8 (3Y), U143.9 (3A)
N1436: U123.11 (4Y), U143.12 (4A)
N1558: U124.1 (1A), U144.3 (1Y)
N1559: U124.2 (1B), U144.6 (2Y)
N1785: U124.6 (2Y), U128.2 (1B)
N1961: U128.8 (3Y), U128.12 (4A)
N1964: U125.3 (1Y), U129.2 (1B)
N1971: U144.8 (3Y), U145.11 (5A)
N1973: U111.15 (I4), U125.6 (2Y)
N1974: U111.13 (I6), U125.8 (3Y)
N1995: U112.19 (~OE), U131.3 (1Y)
N2008: U113.19 (~OE), U131.6 (2Y)
N2021: U114.19 (~OE), U131.8 (3Y)
N2026: U115.1 (~OE1), U131.11 (4Y)
N2029: U126.10 (3B), U129.8 (3Y)
NFLAG: R33.1, U106.5 (1Q), U109.5 (A3), U111.2 (I2), U144.9 (3A)
NZ_LD: U124.10 (3B), U128.6 (2Y)
N_EQ_V: U111.14 (I5), U125.10 (3B), U145.10 (5Y)
OSC: J1.49
PC1: RN5.2 (R2A), U43.14 (Q0), U47.3 (A1)
PC2: RN5.3 (R3A), U43.13 (Q1), U47.4 (A2)
PC3: RN5.4 (R4A), U43.12 (Q2), U47.5 (A3)
PC4: RN5.5 (R5A), U43.11 (Q3), U47.6 (A4)
PC5: RN5.6 (R6A), U44.14 (Q0), U47.7 (A5)
PC6: RN5.7 (R7A), U44.13 (Q1), U47.8 (A6)
PC7: RN5.8 (R8A), U44.12 (Q2), U47.9 (A7)
PC8: RN6.1 (R1A), U44.11 (Q3), U48.2 (A0)
PC9: RN6.2 (R2A), U45.14 (Q0), U48.3 (A1)
PC10: RN6.3 (R3A), U45.13 (Q1), U48.4 (A2)
PC11: RN6.4 (R4A), U45.12 (Q2), U48.5 (A3)
PC12: RN6.5 (R5A), U45.11 (Q3), U48.6 (A4)
PC13: RN6.6 (R6A), U46.14 (Q0), U48.7 (A5)
PC14: RN6.7 (R7A), U46.13 (Q1), U48.8 (A6)
PC15: RN6.8 (R8A), U46.12 (Q2), U48.9 (A7)
PC_INC_EN: R32.1, U43.7 (CEP), U43.10 (CET), U44.7 (CEP), U45.7 (CEP), U46.7 (CEP), U119.11 (4Y)
PC_TC0: U43.15 (TC), U44.10 (CET)
PC_TC1: U44.15 (TC), U45.10 (CET)
PC_TC2: U45.15 (TC), U46.10 (CET)
R0Q0: RN13.1 (R1A), U19.19 (Q0), U195.2 (A0)
R0Q1: RN13.2 (R2A), U19.18 (Q1), U195.3 (A1)
R0Q2: RN13.3 (R3A), U19.17 (Q2), U195.4 (A2)
R0Q3: RN13.4 (R4A), U19.16 (Q3), U195.5 (A3)
R0Q4: RN13.5 (R5A), U19.15 (Q4), U195.6 (A4)
R0Q5: RN13.6 (R6A), U19.14 (Q5), U195.7 (A5)
R0Q6: RN13.7 (R7A), U19.13 (Q6), U195.8 (A6)
R0Q7: RN13.8 (R8A), U19.12 (Q7), U195.9 (A7)
R0Q8: RN14.1 (R1A), U20.19 (Q0), U196.2 (A0)
R0Q9: RN14.2 (R2A), U20.18 (Q1), U196.3 (A1)
R0Q10: RN14.3 (R3A), U20.17 (Q2), U196.4 (A2)
R0Q11: RN14.4 (R4A), U20.16 (Q3), U196.5 (A3)
R0Q12: RN14.5 (R5A), U20.15 (Q4), U196.6 (A4)
R0Q13: RN14.6 (R6A), U20.14 (Q5), U196.7 (A5)
R0Q14: RN14.7 (R7A), U20.13 (Q6), U196.8 (A6)
R0Q15: RN14.8 (R8A), U20.12 (Q7), U196.9 (A7)
R1Q0: RN15.1 (R1A), U21.19 (Q0), U197.2 (A0)
R1Q1: RN15.2 (R2A), U21.18 (Q1), U197.3 (A1)
R1Q2: RN15.3 (R3A), U21.17 (Q2), U197.4 (A2)
R1Q3: RN15.4 (R4A), U21.16 (Q3), U197.5 (A3)
R1Q4: RN15.5 (R5A), U21.15 (Q4), U197.6 (A4)
R1Q5: RN15.6 (R6A), U21.14 (Q5), U197.7 (A5)
R1Q6: RN15.7 (R7A), U21.13 (Q6), U197.8 (A6)
R1Q7: RN15.8 (R8A), U21.12 (Q7), U197.9 (A7)
R1Q8: RN16.1 (R1A), U22.19 (Q0), U198.2 (A0)
R1Q9: RN16.2 (R2A), U22.18 (Q1), U198.3 (A1)
R1Q10: RN16.3 (R3A), U22.17 (Q2), U198.4 (A2)
R1Q11: RN16.4 (R4A), U22.16 (Q3), U198.5 (A3)
R1Q12: RN16.5 (R5A), U22.15 (Q4), U198.6 (A4)
R1Q13: RN16.6 (R6A), U22.14 (Q5), U198.7 (A5)
R1Q14: RN16.7 (R7A), U22.13 (Q6), U198.8 (A6)
R1Q15: RN16.8 (R8A), U22.12 (Q7), U198.9 (A7)
R2Q0: RN17.1 (R1A), U23.19 (Q0), U199.2 (A0)
R2Q1: RN17.2 (R2A), U23.18 (Q1), U199.3 (A1)
R2Q2: RN17.3 (R3A), U23.17 (Q2), U199.4 (A2)
R2Q3: RN17.4 (R4A), U23.16 (Q3), U199.5 (A3)
R2Q4: RN17.5 (R5A), U23.15 (Q4), U199.6 (A4)
R2Q5: RN17.6 (R6A), U23.14 (Q5), U199.7 (A5)
R2Q6: RN17.7 (R7A), U23.13 (Q6), U199.8 (A6)
R2Q7: RN17.8 (R8A), U23.12 (Q7), U199.9 (A7)
R2Q8: RN18.1 (R1A), U24.19 (Q0), U901.2 (A0)
R2Q9: RN18.2 (R2A), U24.18 (Q1), U901.3 (A1)
R2Q10: RN18.3 (R3A), U24.17 (Q2), U901.4 (A2)
R2Q11: RN18.4 (R4A), U24.16 (Q3), U901.5 (A3)
R2Q12: RN18.5 (R5A), U24.15 (Q4), U901.6 (A4)
R2Q13: RN18.6 (R6A), U24.14 (Q5), U901.7 (A5)
R2Q14: RN18.7 (R7A), U24.13 (Q6), U901.8 (A6)
R2Q15: RN18.8 (R8A), U24.12 (Q7), U901.9 (A7)
R3Q0: RN19.1 (R1A), U25.19 (Q0), U902.2 (A0)
R3Q1: RN19.2 (R2A), U25.18 (Q1), U902.3 (A1)
R3Q2: RN19.3 (R3A), U25.17 (Q2), U902.4 (A2)
R3Q3: RN19.4 (R4A), U25.16 (Q3), U902.5 (A3)
R3Q4: RN19.5 (R5A), U25.15 (Q4), U902.6 (A4)
R3Q5: RN19.6 (R6A), U25.14 (Q5), U902.7 (A5)
R3Q6: RN19.7 (R7A), U25.13 (Q6), U902.8 (A6)
R3Q7: RN19.8 (R8A), U25.12 (Q7), U902.9 (A7)
R3Q8: RN20.1 (R1A), U26.19 (Q0), U903.2 (A0)
R3Q9: RN20.2 (R2A), U26.18 (Q1), U903.3 (A1)
R3Q10: RN20.3 (R3A), U26.17 (Q2), U903.4 (A2)
R3Q11: RN20.4 (R4A), U26.16 (Q3), U903.5 (A3)
R3Q12: RN20.5 (R5A), U26.15 (Q4), U903.6 (A4)
R3Q13: RN20.6 (R6A), U26.14 (Q5), U903.7 (A5)
R3Q14: RN20.7 (R7A), U26.13 (Q6), U903.8 (A6)
R3Q15: RN20.8 (R8A), U26.12 (Q7), U903.9 (A7)
R4Q0: RN21.1 (R1A), U27.19 (Q0), U904.2 (A0)
R4Q1: RN21.2 (R2A), U27.18 (Q1), U904.3 (A1)
R4Q2: RN21.3 (R3A), U27.17 (Q2), U904.4 (A2)
R4Q3: RN21.4 (R4A), U27.16 (Q3), U904.5 (A3)
R4Q4: RN21.5 (R5A), U27.15 (Q4), U904.6 (A4)
R4Q5: RN21.6 (R6A), U27.14 (Q5), U904.7 (A5)
R4Q6: RN21.7 (R7A), U27.13 (Q6), U904.8 (A6)
R4Q7: RN21.8 (R8A), U27.12 (Q7), U904.9 (A7)
R4Q8: RN22.1 (R1A), U28.19 (Q0), U905.2 (A0)
R4Q9: RN22.2 (R2A), U28.18 (Q1), U905.3 (A1)
R4Q10: RN22.3 (R3A), U28.17 (Q2), U905.4 (A2)
R4Q11: RN22.4 (R4A), U28.16 (Q3), U905.5 (A3)
R4Q12: RN22.5 (R5A), U28.15 (Q4), U905.6 (A4)
R4Q13: RN22.6 (R6A), U28.14 (Q5), U905.7 (A5)
R4Q14: RN22.7 (R7A), U28.13 (Q6), U905.8 (A6)
R4Q15: RN22.8 (R8A), U28.12 (Q7), U905.9 (A7)
R5Q0: RN23.1 (R1A), U29.19 (Q0), U906.2 (A0)
R5Q1: RN23.2 (R2A), U29.18 (Q1), U906.3 (A1)
R5Q2: RN23.3 (R3A), U29.17 (Q2), U906.4 (A2)
R5Q3: RN23.4 (R4A), U29.16 (Q3), U906.5 (A3)
R5Q4: RN23.5 (R5A), U29.15 (Q4), U906.6 (A4)
R5Q5: RN23.6 (R6A), U29.14 (Q5), U906.7 (A5)
R5Q6: RN23.7 (R7A), U29.13 (Q6), U906.8 (A6)
R5Q7: RN23.8 (R8A), U29.12 (Q7), U906.9 (A7)
R5Q8: RN24.1 (R1A), U30.19 (Q0), U907.2 (A0)
R5Q9: RN24.2 (R2A), U30.18 (Q1), U907.3 (A1)
R5Q10: RN24.3 (R3A), U30.17 (Q2), U907.4 (A2)
R5Q11: RN24.4 (R4A), U30.16 (Q3), U907.5 (A3)
R5Q12: RN24.5 (R5A), U30.15 (Q4), U907.6 (A4)
R5Q13: RN24.6 (R6A), U30.14 (Q5), U907.7 (A5)
R5Q14: RN24.7 (R7A), U30.13 (Q6), U907.8 (A6)
R5Q15: RN24.8 (R8A), U30.12 (Q7), U907.9 (A7)
R6Q0: RN25.1 (R1A), U31.19 (Q0), U908.2 (A0)
R6Q1: RN25.2 (R2A), U31.18 (Q1), U908.3 (A1)
R6Q2: RN25.3 (R3A), U31.17 (Q2), U908.4 (A2)
R6Q3: RN25.4 (R4A), U31.16 (Q3), U908.5 (A3)
R6Q4: RN25.5 (R5A), U31.15 (Q4), U908.6 (A4)
R6Q5: RN25.6 (R6A), U31.14 (Q5), U908.7 (A5)
R6Q6: RN25.7 (R7A), U31.13 (Q6), U908.8 (A6)
R6Q7: RN25.8 (R8A), U31.12 (Q7), U908.9 (A7)
R6Q8: RN26.1 (R1A), U32.19 (Q0), U909.2 (A0)
R6Q9: RN26.2 (R2A), U32.18 (Q1), U909.3 (A1)
R6Q10: RN26.3 (R3A), U32.17 (Q2), U909.4 (A2)
R6Q11: RN26.4 (R4A), U32.16 (Q3), U909.5 (A3)
R6Q12: RN26.5 (R5A), U32.15 (Q4), U909.6 (A4)
R6Q13: RN26.6 (R6A), U32.14 (Q5), U909.7 (A5)
R6Q14: RN26.7 (R7A), U32.13 (Q6), U909.8 (A6)
R6Q15: RN26.8 (R8A), U32.12 (Q7), U909.9 (A7)
R7Q0: RN27.1 (R1A), U33.19 (Q0), U910.2 (A0)
R7Q1: RN27.2 (R2A), U33.18 (Q1), U910.3 (A1)
R7Q2: RN27.3 (R3A), U33.17 (Q2), U910.4 (A2)
R7Q3: RN27.4 (R4A), U33.16 (Q3), U910.5 (A3)
R7Q4: RN27.5 (R5A), U33.15 (Q4), U910.6 (A4)
R7Q5: RN27.6 (R6A), U33.14 (Q5), U910.7 (A5)
R7Q6: RN27.7 (R7A), U33.13 (Q6), U910.8 (A6)
R7Q7: RN27.8 (R8A), U33.12 (Q7), U910.9 (A7)
R7Q8: RN28.1 (R1A), U34.19 (Q0), U911.2 (A0)
R7Q9: RN28.2 (R2A), U34.18 (Q1), U911.3 (A1)
R7Q10: RN28.3 (R3A), U34.17 (Q2), U911.4 (A2)
R7Q11: RN28.4 (R4A), U34.16 (Q3), U911.5 (A3)
R7Q12: RN28.5 (R5A), U34.15 (Q4), U911.6 (A4)
R7Q13: RN28.6 (R6A), U34.14 (Q5), U911.7 (A5)
R7Q14: RN28.7 (R7A), U34.13 (Q6), U911.8 (A6)
R7Q15: RN28.8 (R8A), U34.12 (Q7), U911.9 (A7)
RES0: RN11.1 (R1A), U92.7 (1Y), U101.2 (P0), U103.2 (A0)
RES1: RN11.2 (R2A), U92.9 (2Y), U101.4 (P1), U103.3 (A1)
RES2: RN11.3 (R3A), U93.7 (1Y), U101.6 (P2), U103.4 (A2)
RES3: RN11.4 (R4A), U93.9 (2Y), U101.8 (P3), U103.5 (A3)
RES4: RN11.5 (R5A), U94.7 (1Y), U101.11 (P4), U103.6 (A4)
RES5: RN11.6 (R6A), U94.9 (2Y), U101.13 (P5), U103.7 (A5)
RES6: RN11.7 (R7A), U95.7 (1Y), U101.15 (P6), U103.8 (A6)
RES7: RN11.8 (R8A), U95.9 (2Y), U101.17 (P7), U103.9 (A7)
RES8: RN12.1 (R1A), U96.7 (1Y), U102.2 (P0), U104.2 (A0)
RES9: RN12.2 (R2A), U96.9 (2Y), U102.4 (P1), U104.3 (A1)
RES10: RN12.3 (R3A), U97.7 (1Y), U102.6 (P2), U104.4 (A2)
RES11: RN12.4 (R4A), U97.9 (2Y), U102.8 (P3), U104.5 (A3)
RES12: RN12.5 (R5A), U98.7 (1Y), U102.11 (P4), U104.6 (A4)
RES13: RN12.6 (R6A), U98.9 (2Y), U102.13 (P5), U104.7 (A5)
RES14: RN12.7 (R7A), U99.7 (1Y), U102.15 (P6), U104.8 (A6)
RES15: RN12.8 (R8A), U99.9 (2Y), U102.17 (P7), U104.9 (A7), U105.2 (1I0)
RIDX0: U14.5 (Y), U17.1 (A0), U18.1 (A0)
RIDX1: U15.5 (Y), U17.2 (A1), U18.2 (A1)
RIDX2: U16.5 (Y), U17.3 (A2), U18.3 (A2)
RUN: U12.12 (2D), U118.8 (3Y)
RUN_R: U9.7 (CEP), U12.9 (2Q), U118.2 (1B), U118.5 (2B), U119.13 (4B), U125.13 (4B), U130.2 (1B), U130.5 (2B), U130.10 (3B)
SINH: U99.13 (2I3), U128.3 (1Y)
STEP0: R38.1, U9.14 (Q0), U10.1 (A0), U68.1 (A0), U147.11 (S0), U148.11 (S0), U149.11 (S0), U150.11 (S0), U151.11 (S0), U152.11 (S0), U153.11 (S0), U154.11 (S0), U155.11 (S0), U156.11 (S0)
STEP1: R39.1, U9.13 (Q1), U10.2 (A1), U68.2 (A1), U147.10 (S1), U148.10 (S1), U149.10 (S1), U150.10 (S1), U151.10 (S1), U152.10 (S1), U153.10 (S1), U154.10 (S1), U155.10 (S1), U156.10 (S1)
STEP2: R40.1, U9.12 (Q2), U10.3 (A2), U68.3 (A2), U147.9 (S2), U148.9 (S2), U149.9 (S2), U150.9 (S2), U151.9 (S2), U152.9 (S2), U153.9 (S2), U154.9 (S2), U155.9 (S2), U156.9 (S2)
STEP3: R41.1, U9.11 (Q3), U10.4 (~E1), U68.6 (E3), U147.7 (~E), U148.7 (~E), U149.7 (~E), U150.7 (~E), U151.7 (~E), U152.7 (~E), U153.7 (~E), U154.7 (~E), U155.7 (~E), U156.7 (~E)
SUM0: U72.4 (S1), U92.6 (1I0)
SUM1: U72.1 (S2), U92.10 (2I0)
SUM2: U72.13 (S3), U93.6 (1I0)
SUM3: U72.10 (S4), U93.10 (2I0)
SUM4: U73.4 (S1), U94.6 (1I0)
SUM5: U73.1 (S2), U94.10 (2I0)
SUM6: U73.13 (S3), U95.6 (1I0)
SUM7: U73.10 (S4), U95.10 (2I0)
SUM8: U74.4 (S1), U96.6 (1I0)
SUM9: U74.1 (S2), U96.10 (2I0)
SUM10: U74.13 (S3), U97.6 (1I0)
SUM11: U74.10 (S4), U97.10 (2I0)
SUM12: U75.4 (S1), U98.6 (1I0)
SUM13: U75.1 (S2), U98.10 (2I0)
SUM14: U75.13 (S3), U99.6 (1I0)
SUM15: U75.10 (S4), U99.10 (2I0), U144.2 (1B), U144.5 (2B)
TA0: U35.19 (Q0), U76.11 (S0), U92.12 (2I2), U100.3 (1I3), U136.1 (1A)
TA1: U35.18 (Q1), U77.11 (S0), U92.3 (1I3), U93.4 (1I2), U136.4 (2A)
TA2: U35.17 (Q2), U78.11 (S0), U92.13 (2I3), U93.12 (2I2), U136.9 (3A)
TA3: U35.16 (Q3), U79.11 (S0), U93.3 (1I3), U94.4 (1I2), U136.12 (4A)
TA4: U35.15 (Q4), U80.11 (S0), U93.13 (2I3), U94.12 (2I2), U137.1 (1A)
TA5: U35.14 (Q5), U81.11 (S0), U94.3 (1I3), U95.4 (1I2), U137.4 (2A)
TA6: U35.13 (Q6), U82.11 (S0), U94.13 (2I3), U95.12 (2I2), U137.9 (3A)
TA7: U35.12 (Q7), U83.11 (S0), U84.9 (S2), U85.9 (S2), U86.9 (S2), U87.9 (S2), U88.9 (S2), U89.9 (S2), U90.9 (S2), U91.9 (S2), U95.3 (1I3), U96.4 (1I2), U137.12 (4A)
TA8: U36.19 (Q0), U84.11 (S0), U95.13 (2I3), U96.12 (2I2), U138.1 (1A)
TA9: U36.18 (Q1), U85.11 (S0), U96.3 (1I3), U97.4 (1I2), U138.4 (2A)
TA10: U36.17 (Q2), U86.11 (S0), U96.13 (2I3), U97.12 (2I2), U138.9 (3A)
TA11: U36.16 (Q3), U87.11 (S0), U97.3 (1I3), U98.4 (1I2), U138.12 (4A)
TA12: U36.15 (Q4), U88.11 (S0), U97.13 (2I3), U98.12 (2I2), U139.1 (1A)
TA13: U36.14 (Q5), U89.11 (S0), U98.3 (1I3), U99.4 (1I2), U139.4 (2A)
TA14: U36.13 (Q6), U90.11 (S0), U98.13 (2I3), U99.12 (2I2), U139.9 (3A)
TA15: U36.12 (Q7), U91.11 (S0), U99.3 (1I3), U100.4 (1I2), U124.5 (2B), U139.12 (4A)
TB0: U37.19 (Q0), U76.10 (S1), U120.1 (1A)
TB1: U37.18 (Q1), U77.10 (S1), U120.4 (2A)
TB2: U37.17 (Q2), U78.10 (S1), U120.9 (3A)
TB3: U37.16 (Q3), U79.10 (S1), U120.12 (4A)
TB4: U37.15 (Q4), U80.10 (S1), U121.1 (1A)
TB5: U37.14 (Q5), U81.10 (S1), U121.4 (2A)
TB6: U37.13 (Q6), U82.10 (S1), U121.9 (3A)
TB7: U37.12 (Q7), U83.10 (S1), U121.12 (4A)
TB8: U38.19 (Q0), U84.10 (S1), U122.1 (1A)
TB9: U38.18 (Q1), U85.10 (S1), U122.4 (2A)
TB10: U38.17 (Q2), U86.10 (S1), U122.9 (3A)
TB11: U38.16 (Q3), U87.10 (S1), U122.12 (4A)
TB12: U38.15 (Q4), U88.10 (S1), U123.1 (1A)
TB13: U38.14 (Q5), U89.10 (S1), U123.4 (2A)
TB14: U38.13 (Q6), U90.10 (S1), U123.9 (3A)
TB15: U38.12 (Q7), U91.10 (S1), U123.12 (4A)
TCLK: J1.48
VCC: C1.1 (+), C2.1, C3.1, C4.1, C5.1, C6.1, C7.1, C8.1, C9.1, C10.1, C11.1, C12.1, C13.1, C14.1, C15.1, C16.1, C17.1, C18.1, C19.1, C20.1, C21.1, C22.1, C23.1, C24.1, C25.1, C26.1, C27.1, C28.1, C29.1, C30.1, C31.1, C32.1, C33.1, C34.1, C35.1, C36.1, C37.1, C38.1, C39.1, C40.1, C41.1, C42.1, C43.1, C44.1, C45.1, C46.1, C47.1, C48.1, C49.1, C50.1, C51.1, C52.1, C53.1, C54.1, C55.1, C56.1, C57.1, C58.1, C59.1, C60.1, C61.1, C62.1, C63.1, C64.1, C65.1, C66.1, C67.1, C68.1, C69.1, C70.1, C71.1, C72.1, C73.1, C74.1, C75.1, C76.1, C77.1, C78.1, C79.1, C80.1, C81.1, C82.1, C83.1, C84.1, C85.1, C86.1, C87.1, C88.1, C89.1, C90.1, C91.1, C92.1, C93.1, C94.1, C95.1, C96.1, C97.1, C98.1, C99.1, C100.1, C101.1, C102.1, C103.1, C104.1, C105.1, C106.1, C107.1, C108.1, C109.1, C110.1, C111.1, C112.1, C113.1, C114.1, C115.1, C116.1, C117.1, C118.1, C119.1, C120.1, C121.1, C122.1, C123.1, C124.1, C125.1, C126.1, C127.1, C128.1, C129.1, C130.1, C131.1, C132.1, C133.1, C134.1, C135.1, C136.1, C137.1, C138.1, C139.1, C140.1, C141.1, C142.1, C143.1, C144.1, C145.1, C146.1, C147.1, C148.1, C149.1, C150.1, C151.1, C152.1, C153.1, C154.1, C155.1, C156.1, C157.1, C158.1, C159.1, C160.1, C161.1, C162.1, C163.1, C164.1, C165.1, C166.1, C167.1, C168.1, C169.1, C170.1, C171.1, C172.1, C173.1, C174.1, C175.1, C176.1, C177.1, C178.1, C179.1, C180.1, C181.1, C182.1, C183.1, C184.1, C185.1, C186.1, C187.1, C188.1, C189.1, C190.1, C191.1, C192.1, C193.1, C194.1, C195.1, C196.1, C197.1, C198.1, C199.1, C901.1, C902.1, C903.1, C904.1, C905.1, C906.1, C907.1, C908.1, C909.1, C910.1, C911.1, C912.1, J1.3, J1.4, J1.63, R3.1, R4.1, R5.1, R6.1, R7.1, R8.1, R9.1, R10.1, R11.1, R12.1, R13.1, R14.1, R15.1, R16.1, R17.1, R18.1, R19.1, R20.1, R21.1, R22.1, R23.1, R24.1, R31.1, U1.6 (E3), U1.16 (VCC), U2.20 (VCC), U3.16 (VCC), U4.20 (VCC), U5.6 (E3), U5.16 (VCC), U6.20 (VCC), U7.6 (E3), U7.16 (VCC), U8.20 (VCC), U9.10 (CET), U9.16 (VCC), U10.6 (E3), U10.16 (VCC), U11.4 (~1PRE), U11.10 (~2PRE), U11.14 (VCC), U12.4 (~1PRE), U12.13 (~2CLR), U12.14 (VCC), U13.6 (E3), U13.16 (VCC), U14.15 (I4), U14.16 (VCC), U15.1 (I3), U15.15 (I4), U15.16 (VCC), U16.1 (I3), U16.15 (I4), U16.16 (VCC), U17.16 (VCC), U18.6 (E3), U18.16 (VCC), U19.20 (VCC), U20.20 (VCC), U21.20 (VCC), U22.20 (VCC), U23.20 (VCC), U24.20 (VCC), U25.20 (VCC), U26.20 (VCC), U27.20 (VCC), U28.20 (VCC), U29.20 (VCC), U30.20 (VCC), U31.20 (VCC), U32.20 (VCC), U33.20 (VCC), U34.20 (VCC), U35.20 (VCC), U36.20 (VCC), U37.20 (VCC), U38.20 (VCC), U39.20 (VCC), U40.20 (VCC), U41.20 (VCC), U42.20 (VCC), U43.16 (VCC), U44.16 (VCC), U45.16 (VCC), U46.16 (VCC), U47.20 (VCC), U48.20 (VCC), U49.16 (VCC), U50.13 (I6), U50.16 (VCC), U51.12 (I7), U51.16 (VCC), U52.16 (VCC), U53.16 (VCC), U54.16 (VCC), U55.16 (VCC), U56.16 (VCC), U57.16 (VCC), U58.16 (VCC), U59.16 (VCC), U60.16 (VCC), U61.16 (VCC), U62.16 (VCC), U63.16 (VCC), U64.16 (VCC), U65.20 (VCC), U66.20 (VCC), U67.16 (VCC), U68.16 (VCC), U69.6 (E3), U69.16 (VCC), U70.16 (VCC), U71.16 (VCC), U72.16 (VCC), U73.16 (VCC), U74.16 (VCC), U75.16 (VCC), U76.16 (VCC), U77.16 (VCC), U78.16 (VCC), U79.16 (VCC), U80.16 (VCC), U81.16 (VCC), U82.16 (VCC), U83.16 (VCC), U84.16 (VCC), U85.16 (VCC), U86.16 (VCC), U87.16 (VCC), U88.16 (VCC), U89.16 (VCC), U90.16 (VCC), U91.16 (VCC), U92.16 (VCC), U93.16 (VCC), U94.16 (VCC), U95.16 (VCC), U96.16 (VCC), U97.16 (VCC), U98.16 (VCC), U99.16 (VCC), U100.16 (VCC), U101.20 (VCC), U102.20 (VCC), U103.20 (VCC), U104.20 (VCC), U105.16 (VCC), U106.4 (~1PRE), U106.10 (~2PRE), U106.14 (VCC), U107.4 (~1PRE), U107.10 (~2PRE), U107.14 (VCC), U108.4 (~1PRE), U108.10 (~2PRE), U108.13 (~2CLR), U108.14 (VCC), U109.20 (VCC), U110.20 (VCC), U111.12 (I7), U111.16 (VCC), U112.20 (VCC), U113.20 (VCC), U114.20 (VCC), U115.20 (VCC), U116.16 (VCC), U117.14 (VCC), U118.14 (VCC), U119.14 (VCC), U120.14 (VCC), U121.14 (VCC), U122.14 (VCC), U123.14 (VCC), U124.14 (VCC), U125.14 (VCC), U126.14 (VCC), U127.14 (VCC), U128.14 (VCC), U129.14 (VCC), U130.14 (VCC), U131.14 (VCC), U132.14 (VCC), U133.14 (VCC), U134.14 (VCC), U135.14 (VCC), U136.14 (VCC), U137.14 (VCC), U138.14 (VCC), U139.14 (VCC), U140.14 (VCC), U141.14 (VCC), U142.14 (VCC), U143.14 (VCC), U144.14 (VCC), U145.14 (VCC), U146.14 (VCC), U147.4 (I0), U147.16 (VCC), U148.16 (VCC), U149.3 (I1), U149.16 (VCC), U150.16 (VCC), U151.16 (VCC), U152.16 (VCC), U153.16 (VCC), U154.16 (VCC), U155.16 (VCC), U156.16 (VCC), U157.14 (VCC), U158.14 (VCC), U159.14 (VCC), U160.14 (VCC), U161.14 (VCC), U162.14 (VCC), U163.14 (VCC), U164.14 (VCC), U165.14 (VCC), U166.14 (VCC), U167.14 (VCC), U168.14 (VCC), U169.14 (VCC), U170.14 (VCC), U171.14 (VCC), U172.14 (VCC), U173.14 (VCC), U174.14 (VCC), U175.14 (VCC), U176.14 (VCC), U177.14 (VCC), U178.14 (VCC), U179.5 (2C), U179.14 (VCC), U180.14 (VCC), U181.14 (VCC), U182.14 (VCC), U183.14 (VCC), U184.14 (VCC), U185.14 (VCC), U186.14 (VCC), U187.4 (1C), U187.5 (1D), U187.14 (VCC), U188.14 (VCC), U189.14 (VCC), U190.14 (VCC), U191.2 (1B), U191.4 (1C), U191.5 (1D), U191.14 (VCC), U192.14 (VCC), U193.14 (VCC), U194.14 (VCC), U195.20 (VCC), U196.20 (VCC), U197.20 (VCC), U198.20 (VCC), U199.20 (VCC), U901.20 (VCC), U902.20 (VCC), U903.20 (VCC), U904.20 (VCC), U905.20 (VCC), U906.20 (VCC), U907.20 (VCC), U908.20 (VCC), U909.20 (VCC), U910.20 (VCC), U911.20 (VCC)
VFLAG: R36.1, U107.9 (2Q), U109.2 (A0), U111.1 (I3), U116.5 (2I0), U144.10 (3B)
V_ADD: U100.10 (2I0), U124.3 (1Y)
V_ALU: U100.9 (2Y), U116.6 (2I1)
V_NEW: U105.14 (4I0), U116.7 (2Y)
WAKE: U117.3 (1Y), U117.5 (2B), U127.13 (4B), U145.9 (4A)
WE_E_EN: U126.6 (2Y), U132.1 (1A)
WE_O_EN: U126.8 (3Y), U132.4 (2A)
WR_WIN: J1.6, U132.2 (1B), U132.5 (2B)
X0: U72.5 (A1), U136.3 (1Y)
X1: U72.3 (A2), U136.6 (2Y)
X2: U72.14 (A3), U136.8 (3Y)
X3: U72.12 (A4), U136.11 (4Y)
X4: U73.5 (A1), U137.3 (1Y)
X5: U73.3 (A2), U137.6 (2Y)
X6: U73.14 (A3), U137.8 (3Y)
X7: U73.12 (A4), U137.11 (4Y)
X8: U74.5 (A1), U138.3 (1Y)
X9: U74.3 (A2), U138.6 (2Y)
X10: U74.14 (A3), U138.8 (3Y)
X11: U74.12 (A4), U138.11 (4Y)
X12: U75.5 (A1), U139.3 (1Y)
X13: U75.3 (A2), U139.6 (2Y)
X14: U75.14 (A3), U139.8 (3Y)
X15: U75.12 (A4), U139.11 (4Y), U144.1 (1A)
Y0: U72.6 (B1), U140.3 (1Y)
Y1: U72.2 (B2), U140.6 (2Y)
Y2: U72.15 (B3), U140.8 (3Y)
Y3: U72.11 (B4), U140.11 (4Y)
Y4: U73.6 (B1), U141.3 (1Y)
Y5: U73.2 (B2), U141.6 (2Y)
Y6: U73.15 (B3), U141.8 (3Y)
Y7: U73.11 (B4), U141.11 (4Y)
Y8: U74.6 (B1), U142.3 (1Y)
Y9: U74.2 (B2), U142.6 (2Y)
Y10: U74.15 (B3), U142.8 (3Y)
Y11: U74.11 (B4), U142.11 (4Y)
Y12: U75.6 (B1), U143.3 (1Y)
Y13: U75.2 (B2), U143.6 (2Y)
Y14: U75.15 (B3), U143.8 (3Y)
Y15: U75.11 (B4), U143.11 (4Y), U144.4 (2A)
ZFLAG: R34.1, U106.9 (2Q), U109.4 (A2), U111.4 (I0)
Z_ALU: U105.5 (2I0), U135.1 (1Y)
ak2: U162.11 (4Y), U169.5 (2B), U190.4 (1C)
ak3: U169.6 (2Y), U192.13 (2D)
ak4: U163.3 (1Y), U163.5 (2B), U174.2 (1B), U185.5 (2C), U193.4 (1C)
ak5: U163.6 (2Y), U174.4 (2A), U185.10 (3B), U185.13 (1C), U189.13 (2D)
ak9: U169.8 (3Y), U174.5 (2B), U174.13 (4B), U185.11 (3C), U193.5 (1D), U194.13 (2D)
ak10: U169.11 (4Y), U193.13 (2D)
ak12: U163.8 (3Y), U190.5 (1D), U194.5 (1D)
ak13: U186.8 (3Y), U190.1 (1A)
ak19: U174.12 (4A), U190.8 (2Y)
kb0: U157.9 (3A), U187.6 (1Y)
kb1: U126.11 (4Y), U157.4 (2A)
kb2: U179.12 (1Y), U187.10 (2B)
kb3: U157.2 (1B), U176.6 (2B), U187.8 (2Y)
kb4: U157.3 (1Y), U157.5 (2B)
kb5: U157.6 (2Y), U157.10 (3B), U188.13 (2D)
kb6: U157.8 (3Y), U157.13 (4B), U158.5 (2B), U177.11 (5A)
kb7: U147.2 (I2), U154.2 (I2), U157.11 (4Y), U172.13 (4B)
kb8: U158.3 (1Y), U158.4 (2A), U168.5 (2B), U170.2 (1B), U172.12 (4A), U177.3 (2A)
kb9: U147.1 (I3), U158.6 (2Y)
kb10: U147.15 (I4), U179.6 (2Y)
kb11: U158.8 (3Y), U161.1 (1A), U171.9 (3A), U179.11 (3C), U181.5 (2C), U182.11 (3C), U183.1 (1A), U188.4 (1C)
kb12: U147.14 (I5), U177.9 (4A), U179.8 (3Y)
kb13: U146.6 (3Y), U147.13 (I6), U148.12 (I7), U150.12 (I7), U151.12 (I7), U152.12 (I7), U153.12 (I7), U154.13 (I6), U155.12 (I7)
kb14: U132.13 (4B), U158.11 (4Y), U161.4 (2A), U167.2 (1B), U184.2 (1B), U188.5 (1D)
kb15: U132.11 (4Y), U148.2 (I2)
kb16: U148.1 (I3), U170.3 (1Y)
kb17: U159.3 (1Y), U159.5 (2B), U162.4 (2A), U171.10 (3B), U188.12 (2C)
kb18: U159.6 (2Y), U180.2 (1B), U180.10 (3B), U184.13 (1C)
kb19: U159.8 (3Y), U160.4 (2A), U175.12 (4B), U183.13 (1C)
kb20: U159.11 (4Y), U160.2 (1B), U183.2 (1B)
kb21: U160.3 (1Y), U160.5 (2B), U186.13 (1C)
kb22: U160.6 (2Y), U180.11 (3C), U180.13 (1C), U184.5 (2C)
kb23: U180.1 (1A), U188.6 (1Y)
kb24: U148.15 (I4), U180.12 (1Y)
kb25: U146.11 (5A), U160.8 (3Y), U167.10 (3B), U170.13 (4B), U180.5 (2C)
kb26: U148.14 (I5), U180.6 (2Y)
kb27: U146.10 (5Y), U148.13 (I6), U149.12 (I7), U151.14 (I5), U155.14 (I5), U156.12 (I7)
kb28: U160.11 (4Y), U161.2 (1B), U173.5 (2B), U191.13 (2D)
kb29: U161.3 (1Y), U161.5 (2B), U162.5 (2B), U171.5 (2B)
kb30: U161.6 (2Y), U166.2 (1B), U180.9 (3A)
kb31: U149.1 (I3), U180.8 (3Y)
kb32: U146.12 (6Y), U149.15 (I4), U153.13 (I6), U154.14 (I5)
kb33: U149.14 (I5), U181.12 (1Y)
kb34: U161.8 (3Y), U170.10 (3B)
kb35: U161.11 (4Y), U188.9 (2A)
kb36: U150.2 (I2), U188.8 (2Y)
kb37: U150.15 (I4), U151.15 (I4), U181.6 (2Y)
kb38: U150.14 (I5), U170.11 (4Y)
kb39: U150.13 (I6), U151.13 (I6), U171.3 (1Y)
kb40: U151.2 (I2), U171.6 (2Y)
kb41: U151.1 (I3), U177.2 (1Y)
kb42: U152.15 (I4), U171.8 (3Y)
kb43: U164.6 (2Y), U171.12 (4A)
kb44: U164.8 (3Y), U171.13 (4B)
kb45: U164.11 (4Y), U172.1 (1A)
kb46: U165.3 (1Y), U172.2 (1B)
kb47: U165.5 (2B), U186.12 (1Y)
kb48: U165.6 (2Y), U172.4 (2A)
kb49: U162.3 (1Y), U165.9 (3A)
kb50: U165.8 (3Y), U181.9 (3A), U182.1 (1A)
kb51: U162.6 (2Y), U165.13 (4B)
kb52: U165.11 (4Y), U181.10 (3B)
kb53: U166.3 (1Y), U182.2 (1B)
kb54: U153.2 (I2), U172.8 (3Y)
kb55: U153.1 (I3), U156.1 (I3), U177.4 (2Y)
kb56: U177.5 (3A), U182.6 (2Y)
kb57: U166.5 (2B), U177.6 (3Y)
kb58: U166.6 (2Y), U182.10 (3B)
kb59: U182.9 (3A), U189.6 (1Y)
kb60: U153.15 (I4), U182.8 (3Y)
kb61: U153.14 (I5), U191.8 (2Y)
kb62: U166.8 (3Y), U173.1 (1A)
kb63: U166.13 (4B), U172.11 (4Y)
kb64: U166.11 (4Y), U173.2 (1B)
kb65: U167.3 (1Y), U192.1 (1A)
kb66: U167.6 (2Y), U192.2 (1B)
kb67: U167.8 (3Y), U192.4 (1C)
kb68: U155.2 (I2), U173.6 (2Y)
kb69: U155.15 (I4), U183.12 (1Y)
kb70: U162.8 (3Y), U167.12 (4A)
kb71: U167.11 (4Y), U183.3 (2A)
kb72: U168.2 (1B), U177.8 (4Y)
kb73: U168.3 (1Y), U183.4 (2B)
kb74: U168.6 (2Y), U173.9 (3A)
kb75: U168.10 (3B), U186.6 (2Y)
kb76: U168.8 (3Y), U173.10 (3B)
kb77: U168.11 (4Y), U183.9 (3A)
kb78: U169.3 (1Y), U183.10 (3B)
kb79: U156.2 (I2), U177.10 (5Y)
kb80: U156.15 (I4), U184.12 (1Y)
kb81: U156.14 (I5), U184.6 (2Y)
~ADIM0: U10.15 (~Y0), U117.9 (3A), U145.5 (3A)
~ADIM1: U10.14 (~Y1), U162.1 (1A), U166.9 (3A), U175.2 (1A)
~ADIM2: U10.13 (~Y2), U135.8 (3A), U168.12 (4A), U175.8 (3A), U176.2 (1A), U176.5 (2A)
~ADIM3: U10.12 (~Y3), U135.11 (4A), U162.9 (3A), U164.4 (2A), U164.12 (4A), U165.4 (2A), U165.12 (4A), U166.1 (1A), U166.12 (4A), U168.4 (2A)
~ADIM4: U10.11 (~Y4), U164.9 (3A), U165.1 (1A), U167.1 (1A), U168.9 (3A), U175.5 (2A)
~ADIM5: U10.10 (~Y5), U167.4 (2A), U168.1 (1A), U175.11 (4A)
~ADIM6: U10.9 (~Y6), U162.10 (3B), U169.1 (1A)
~ADIM7: U10.7 (~Y7), U162.2 (1B), U167.9 (3A)
~ADIM8_A: U68.15 (~Y0), U161.9 (3A), U170.5 (2B), U183.5 (2C), U183.11 (3C)
~ADIM9_A: U68.14 (~Y1), U132.10 (3B), U161.10 (3B), U172.5 (2B), U173.13 (4B), U181.11 (3C), U182.13 (1C), U192.5 (1D)
~AIS0: U69.15 (~Y0), U186.9 (3A)
~AIS1: U69.14 (~Y1), U162.12 (4A)
~AIS2: U69.13 (~Y2), U184.9 (3A), U186.10 (3B), U192.9 (2A)
~AIS3: U69.12 (~Y3), U162.13 (4B), U184.10 (3B)
~AIS4: U69.11 (~Y4), U163.4 (2A)
~AIS5: U69.10 (~Y5), U163.1 (1A), U190.9 (2A), U193.9 (2A), U194.9 (2A)
~AIS6: U69.9 (~Y6), U174.1 (1A), U185.3 (2A), U189.10 (2B), U190.10 (2B), U193.1 (1A), U193.10 (2B), U194.10 (2B)
~AIS7: U69.7 (~Y7), U184.11 (3C), U186.11 (3C), U192.10 (2B)
~AIS8: U70.15 (~Y0), U163.2 (1B)
~AIS9: U70.14 (~Y1), U174.9 (3A), U178.5 (3A), U178.11 (5A), U189.12 (2C), U190.12 (2C), U193.12 (2C), U194.12 (2C)
~AIS11: U70.12 (~Y3), U163.9 (3A)
~AIS12: U70.11 (~Y4), U194.1 (1A)
~AIS13: U70.10 (~Y5), U178.3 (2A), U194.2 (1B)
~AIS14: U70.9 (~Y6), U163.10 (3B), U176.9 (3B)
~AIS15: U70.7 (~Y7), U176.12 (4B), U194.4 (1C)
~AIS17: U71.14 (~Y1), U174.10 (3B), U185.1 (1A), U185.4 (2B), U185.9 (3A), U190.13 (2D), U193.2 (1B)
~AIS18: U71.13 (~Y2), U169.10 (3B), U169.13 (4B), U185.2 (1B)
~ALU_IR: U163.13 (4B), U178.12 (6Y)
~AOP4: U178.2 (1Y), U189.9 (2A)
~BYTE: U129.9 (3A), U131.4 (2A), U146.2 (1Y)
~CFLAG: U107.6 (~1Q), U169.4 (2A), U176.8 (3A), U176.11 (4A)
~CLKR: U130.3 (1Y), U133.3 (1B), U133.6 (2B), U133.9 (3B), U133.12 (4B), U134.3 (1B), U134.6 (2B), U134.9 (3B), U134.12 (4B), U145.3 (2A)
~CLK: U2.11 (CP), U4.11 (CP), U6.11 (CP), U8.11 (CP), U12.11 (2CLK), U145.2 (1Y)
~COND: U146.8 (4Y), U164.2 (1B)
~FAULT: U12.6 (~1Q), U118.9 (3A)
~HALTED: U11.8 (~2Q), U127.12 (4A)
~INT: U132.12 (4A), U135.4 (2Y), U148.4 (I0), U155.4 (I0), U157.12 (4A), U160.10 (3B), U165.10 (3B), U166.10 (3B), U167.13 (4B), U169.2 (1B), U170.1 (1A), U171.4 (2A), U172.10 (3B), U173.4 (2A), U179.4 (2B), U181.4 (2B), U191.12 (2C)
~IR8: U169.9 (3A), U178.8 (4Y)
~KOP0: U1.15 (~Y0), U165.2 (1B), U166.4 (2A), U177.1 (1A), U184.1 (1A), U186.3 (2A), U188.1 (1A)
~KOP1: U1.14 (~Y1), U158.1 (1A), U164.13 (4B)
~KOP2: U1.13 (~Y2), U187.9 (2A)
~KOP3: U1.12 (~Y3), U159.4 (2A), U186.4 (2B), U189.1 (1A)
~KOP4: U1.11 (~Y4), U159.1 (1A), U164.10 (3B), U189.2 (1B)
~KOP5: U1.10 (~Y5), U159.12 (4A), U181.1 (1A), U191.9 (2A)
~KOP6: U1.9 (~Y6), U159.13 (4B), U179.9 (3A)
~KOP7: U1.7 (~Y7), U159.9 (3A), U181.2 (1B), U191.10 (2B)
~KOP8: U3.15 (~Y0), U159.10 (3B), U179.10 (3B)
~KOP9_C0: U129.11 (4Y), U187.1 (1A)
~KOP9_C1: U158.13 (4B), U164.3 (1Y)
~KOP9: U3.14 (~Y1), U129.12 (4A), U161.12 (4A), U164.1 (1A)
~KOP10: U3.13 (~Y2), U135.9 (3B), U158.12 (4A), U161.13 (4B), U172.9 (3A), U186.1 (1A)
~KOP11: U3.12 (~Y3), U160.1 (1A), U167.5 (2B), U179.3 (2A), U180.3 (2A), U189.4 (1C)
~KOP12: U3.11 (~Y4), U159.2 (1B), U186.2 (1B), U186.5 (2C)
~KOP13_F0: U5.15 (~Y0), U158.9 (3A), U170.12 (4A), U179.2 (1B), U184.3 (2A)
~KOP13_F1: U5.14 (~Y1), U160.12 (4A), U179.13 (1C), U181.3 (2A), U181.13 (1C), U184.4 (2B), U188.2 (1B), U189.5 (1D)
~KOP13: U3.10 (~Y5), U5.4 (~E1), U191.1 (1A)
~KOP14_F0: U7.15 (~Y0), U187.2 (1B), U188.10 (2B)
~KOP14_F1: U7.14 (~Y1), U126.12 (4A), U176.3 (1B)
~KOP14_F2: U7.13 (~Y2), U126.13 (4B), U175.9 (3B)
~KOP14_F3: U7.12 (~Y3), U157.1 (1A), U168.13 (4B)
~KOP14_F4: U7.11 (~Y4), U146.13 (6A), U160.9 (3A), U160.13 (4B), U171.1 (1A), U175.6 (2B)
~KOP14_F5: U7.10 (~Y5), U68.4 (~E1), U146.5 (3A), U158.10 (3B), U171.2 (1B), U180.4 (2B)
~KOP14_F6: U7.9 (~Y6), U135.12 (4B), U158.2 (1B), U164.5 (2B)
~KOP14_F7: U7.7 (~Y7), U187.12 (2C)
~KOP14: U3.9 (~Y6), U7.4 (~E1)
~KOP15: U3.7 (~Y7), U187.13 (2D)
~MK0_0: U132.9 (3A), U147.6 (~Y)
~MK1_0: U148.6 (~Y), U170.4 (2A)
~MK2_0: U149.6 (~Y), U170.9 (3A)
~MK31_0: U156.6 (~Y), U173.12 (4A)
~MRD: J1.41, U146.4 (2Y)
~MWE_E: J1.42, U132.3 (1Y)
~MWE_O: J1.43, U132.6 (2Y)
~PC_LOAD: D31.2 (K), U43.9 (~PE), U44.9 (~PE), U45.9 (~PE), U46.9 (~PE), U130.8 (3Y)
~RESET: J1.7, U9.1 (~MR), U11.1 (~1CLR), U11.13 (~2CLR), U12.1 (~1CLR), U12.10 (~2PRE), U43.1 (~MR), U44.1 (~MR), U45.1 (~MR), U46.1 (~MR), U106.1 (~1CLR), U106.13 (~2CLR), U107.1 (~1CLR), U107.13 (~2CLR), U108.1 (~1CLR)
~ROE0: D3.2 (K), U18.15 (~Y0), U195.1 (~OE1), U196.1 (~OE1)
~ROE1: D5.2 (K), U18.14 (~Y1), U197.1 (~OE1), U198.1 (~OE1)
~ROE2: D7.2 (K), U18.13 (~Y2), U199.1 (~OE1), U901.1 (~OE1)
~ROE3: D9.2 (K), U18.12 (~Y3), U902.1 (~OE1), U903.1 (~OE1)
~ROE4: D11.2 (K), U18.11 (~Y4), U904.1 (~OE1), U905.1 (~OE1)
~ROE5: D13.2 (K), U18.10 (~Y5), U906.1 (~OE1), U907.1 (~OE1)
~ROE6: D15.2 (K), U18.9 (~Y6), U908.1 (~OE1), U909.1 (~OE1)
~ROE7: D17.2 (K), U18.7 (~Y7), U910.1 (~OE1), U911.1 (~OE1)
~SRC_ALU: D20.2 (K), U13.13 (~Y2), U103.1 (~OE1), U104.1 (~OE1)
~SRC_FLAGS: D24.2 (K), U13.9 (~Y6), U109.1 (~OE1), U110.1 (~OE1)
~SRC_IMM: D23.2 (K), U13.10 (~Y5), U65.1 (~OE1), U66.1 (~OE1)
~SRC_MEM: D22.2 (K), U13.11 (~Y4), U145.13 (6A)
~SRC_PC: D21.2 (K), U13.12 (~Y3), U47.1 (~OE1), U48.1 (~OE1)
~SRC_REG: D19.2 (K), U13.14 (~Y1), U18.4 (~E1)
~STEP_CLR: U9.9 (~PE), U130.6 (2Y)
~WAIT: J1.46
~WAKE: U117.13 (4B), U145.8 (4Y)
~WSEL0: D4.2 (K), U17.15 (~Y0), U133.2 (1A)
~WSEL1: D6.2 (K), U17.14 (~Y1), U133.5 (2A)
~WSEL2: D8.2 (K), U17.13 (~Y2), U133.8 (3A)
~WSEL3: D10.2 (K), U17.12 (~Y3), U133.11 (4A)
~WSEL4: D12.2 (K), U17.11 (~Y4), U134.2 (1A)
~WSEL5: D14.2 (K), U17.10 (~Y5), U134.5 (2A)
~WSEL6: D16.2 (K), U17.9 (~Y6), U134.8 (3A)
~WSEL7: D18.2 (K), U17.7 (~Y7), U134.11 (4A)
~ZFLAG: U106.8 (~2Q), U125.5 (2B), U125.9 (3A)
~Z_HI: U102.19 (~EQ), U135.3 (1B)
~Z_LO: U101.19 (~EQ), U135.2 (1A)
