MihrimatriX/breadboarding/cpu16/kicad/gc/gc.kicad_sch

## KiCad design cpu16/kicad/gc/gc.kicad_sch (2026-10-12)

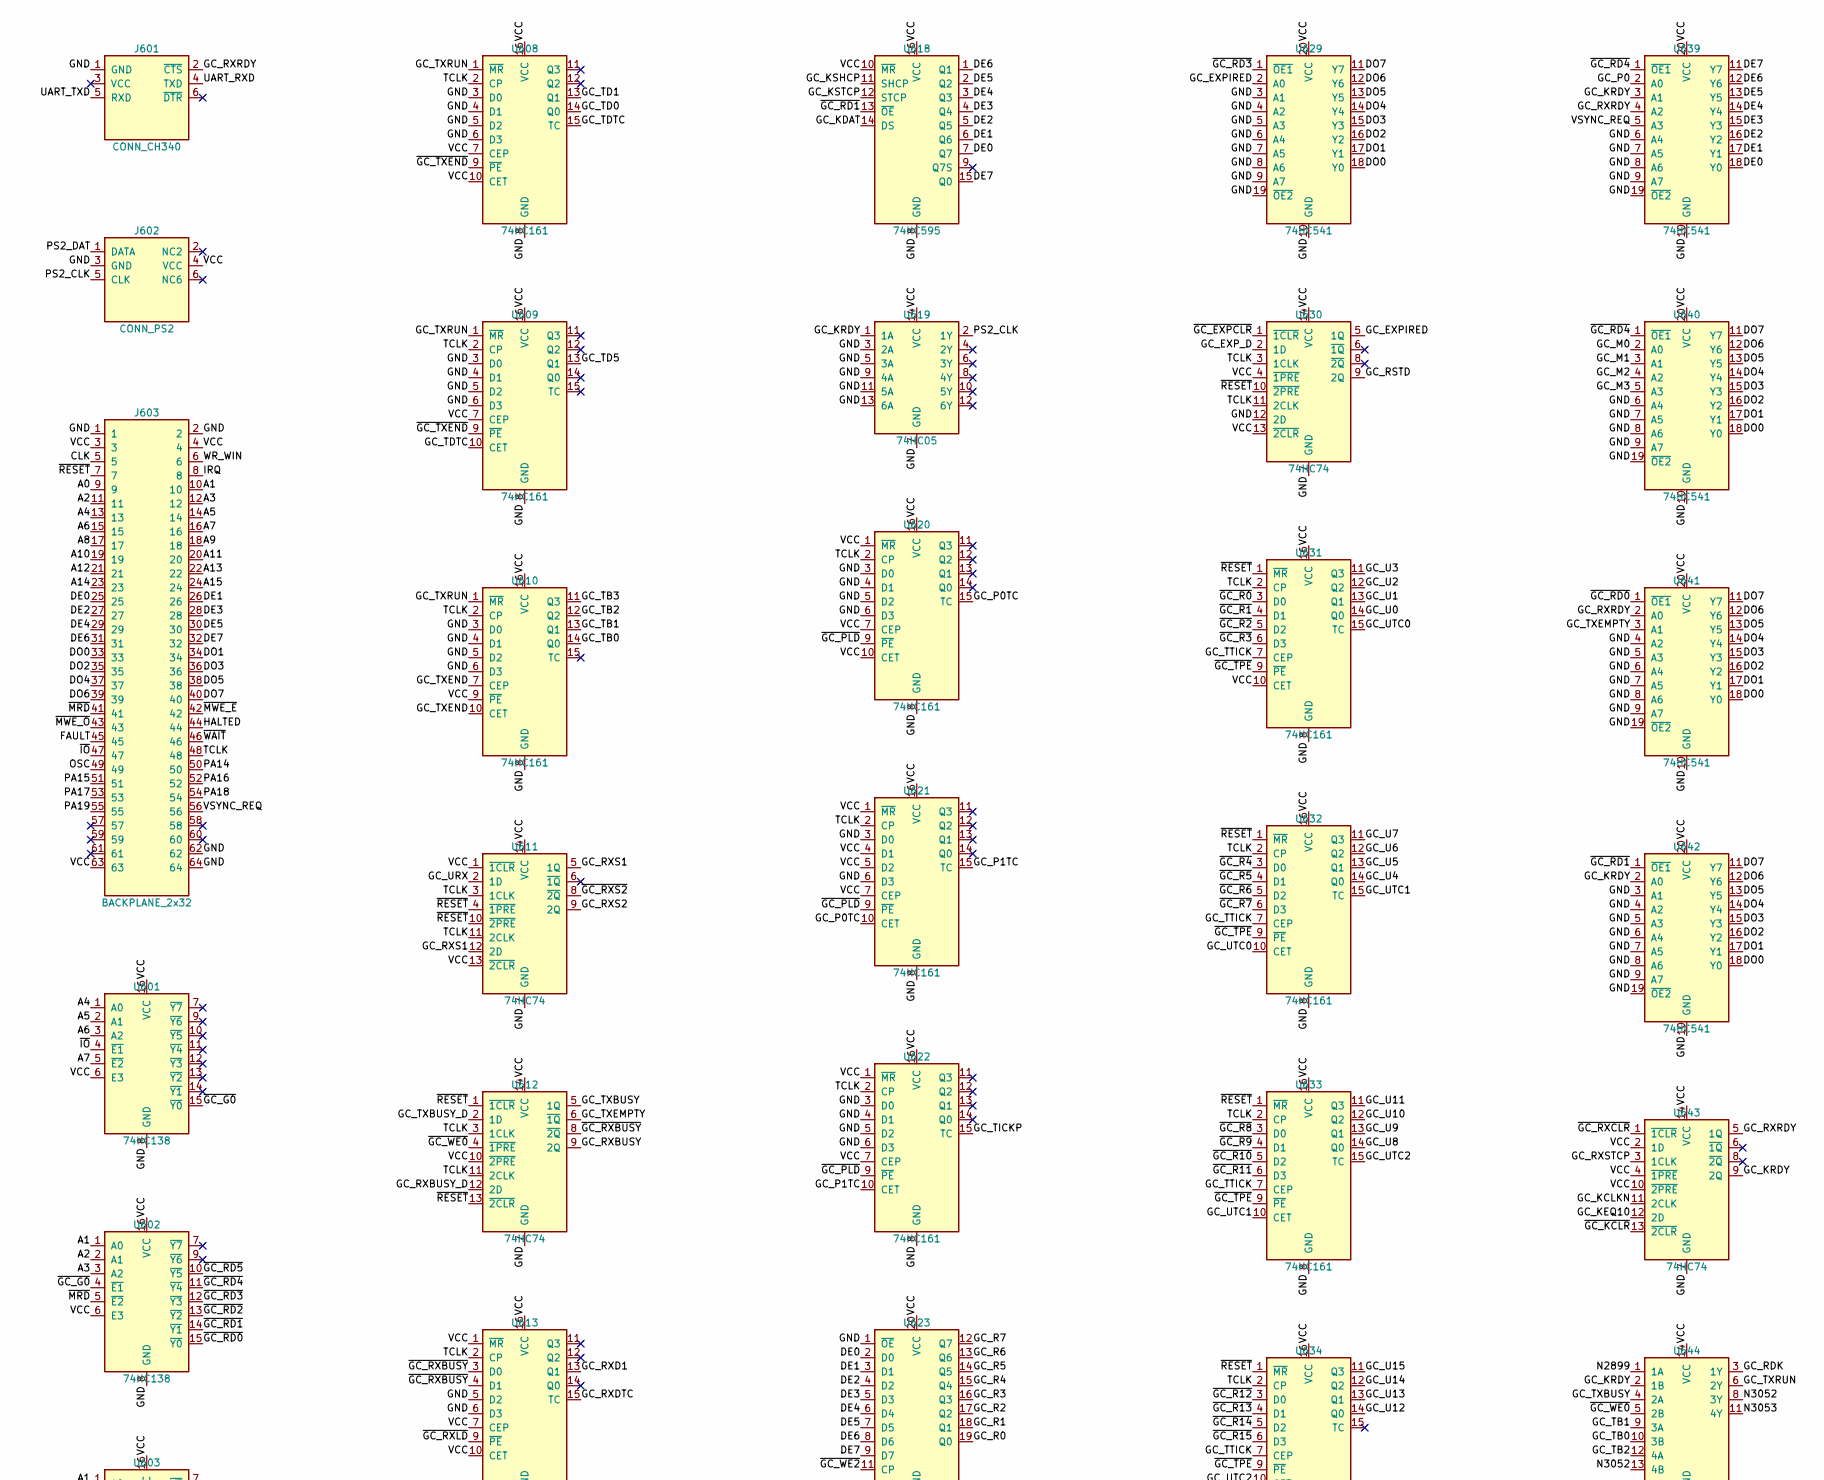
[picture p10: schematic gc.kicad_sch, part in row 1, column 1]

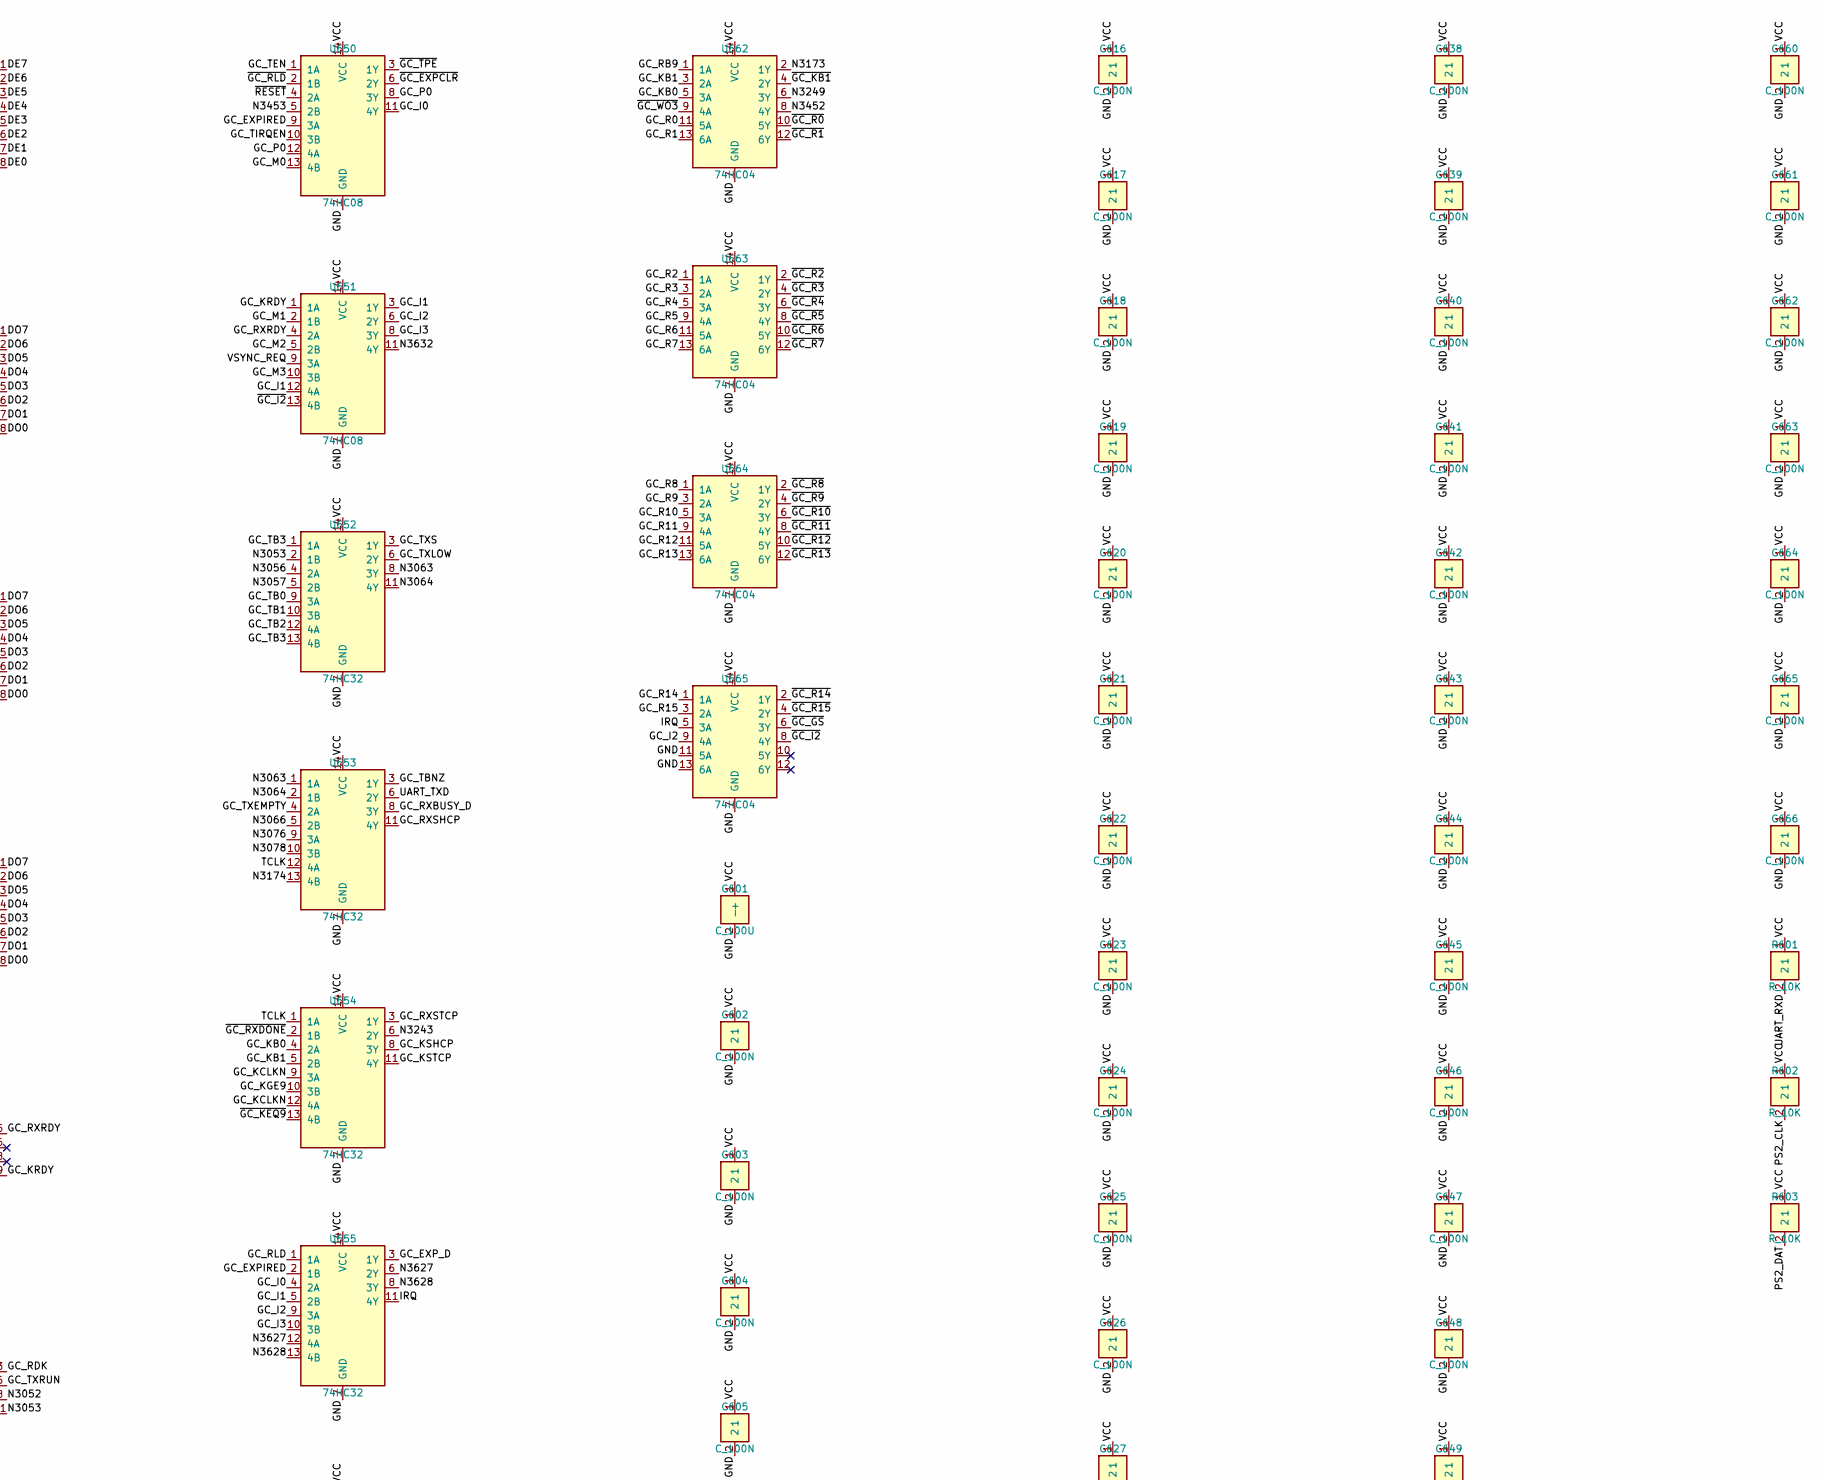
[picture p11: schematic gc.kicad_sch, part in row 1, column 2]

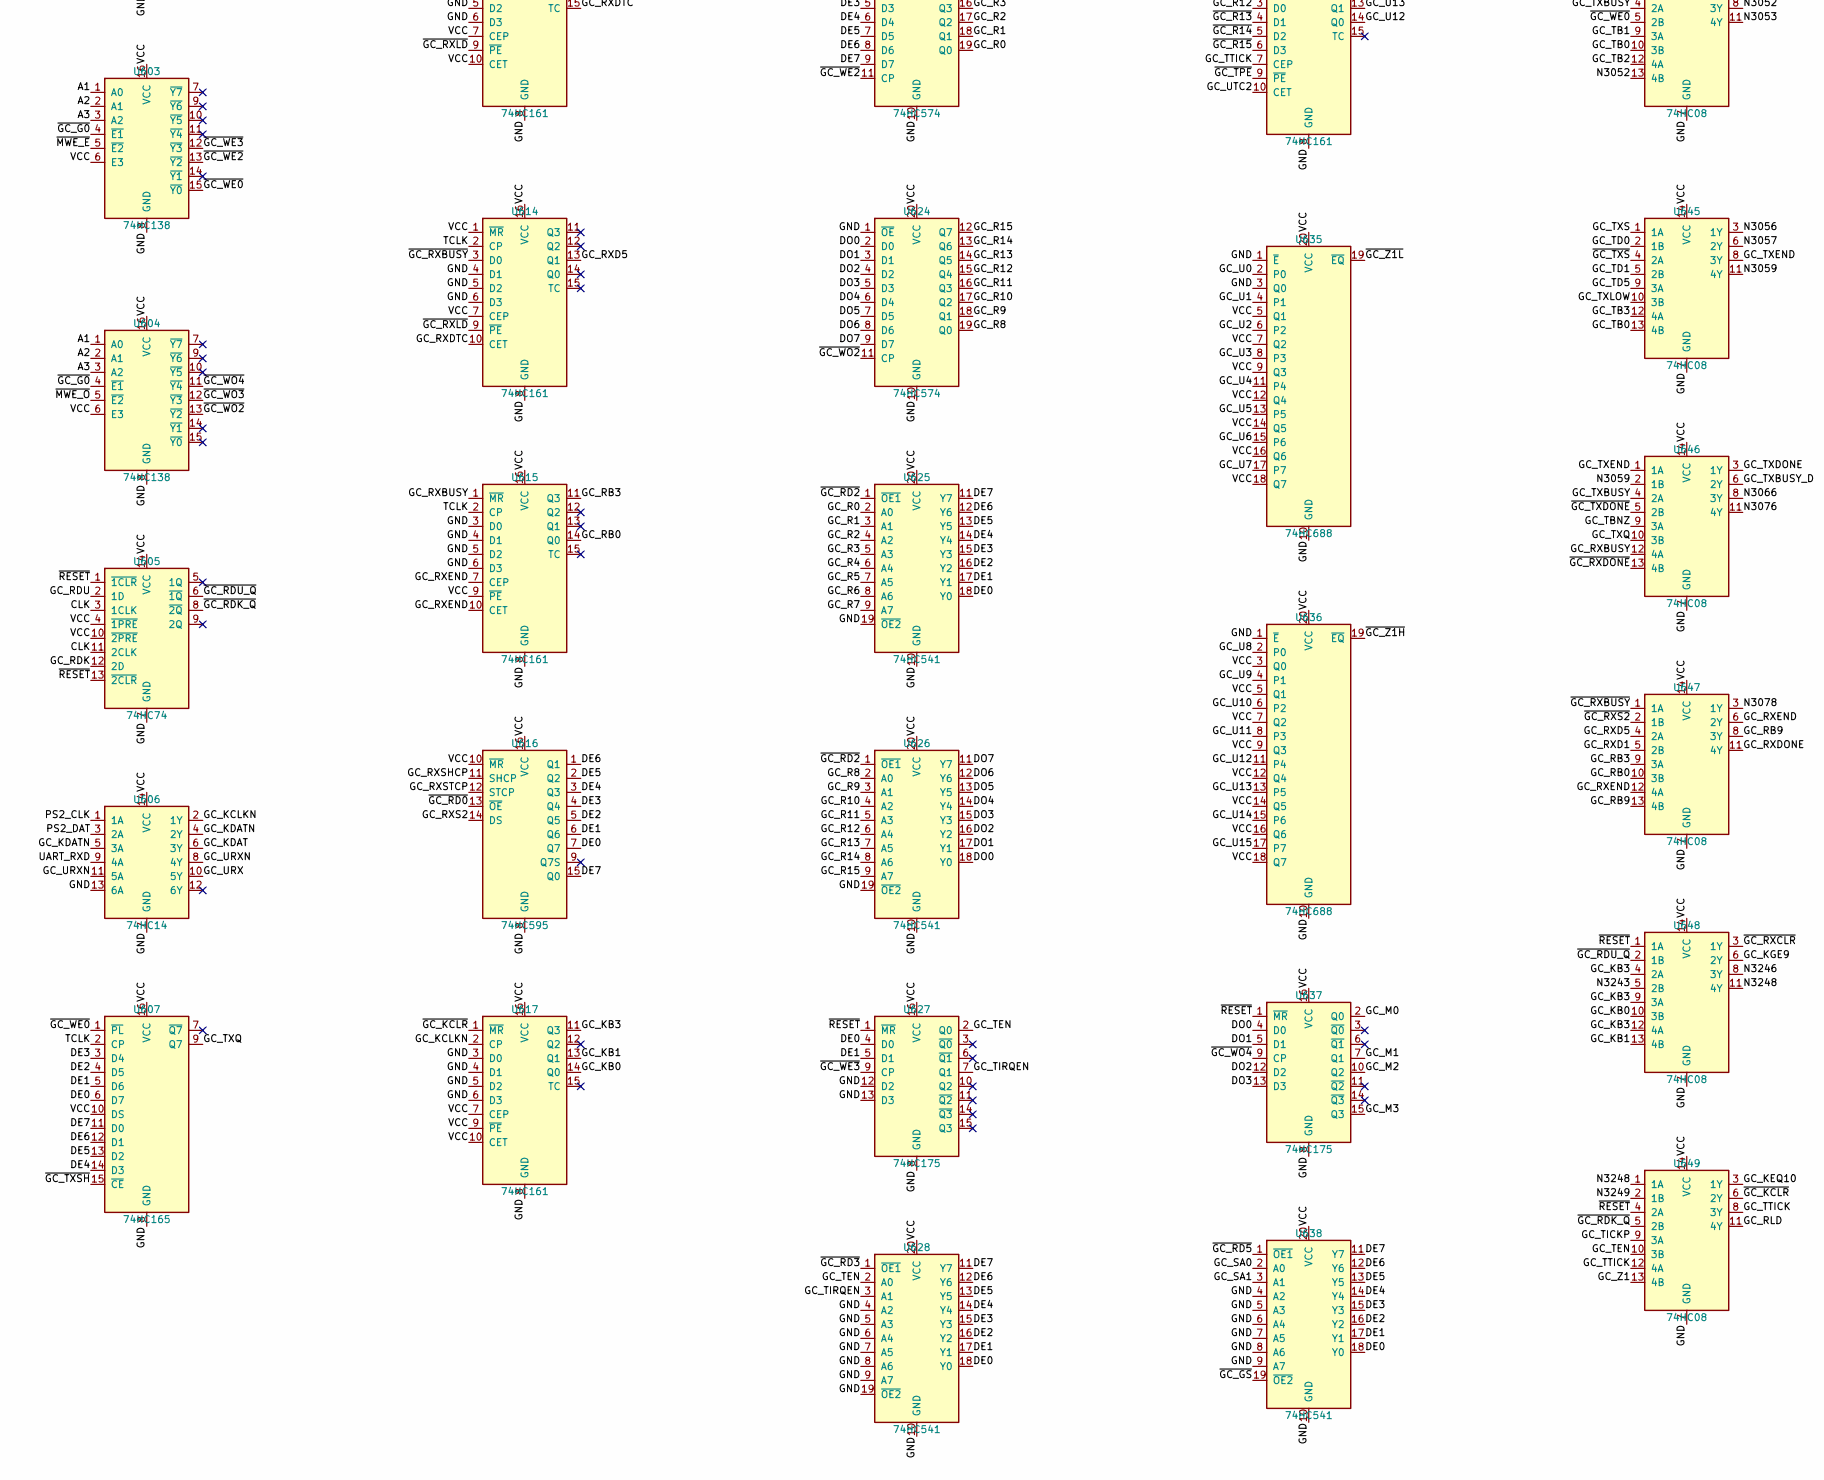
[picture p12: schematic gc.kicad_sch, part in row 2, column 1]

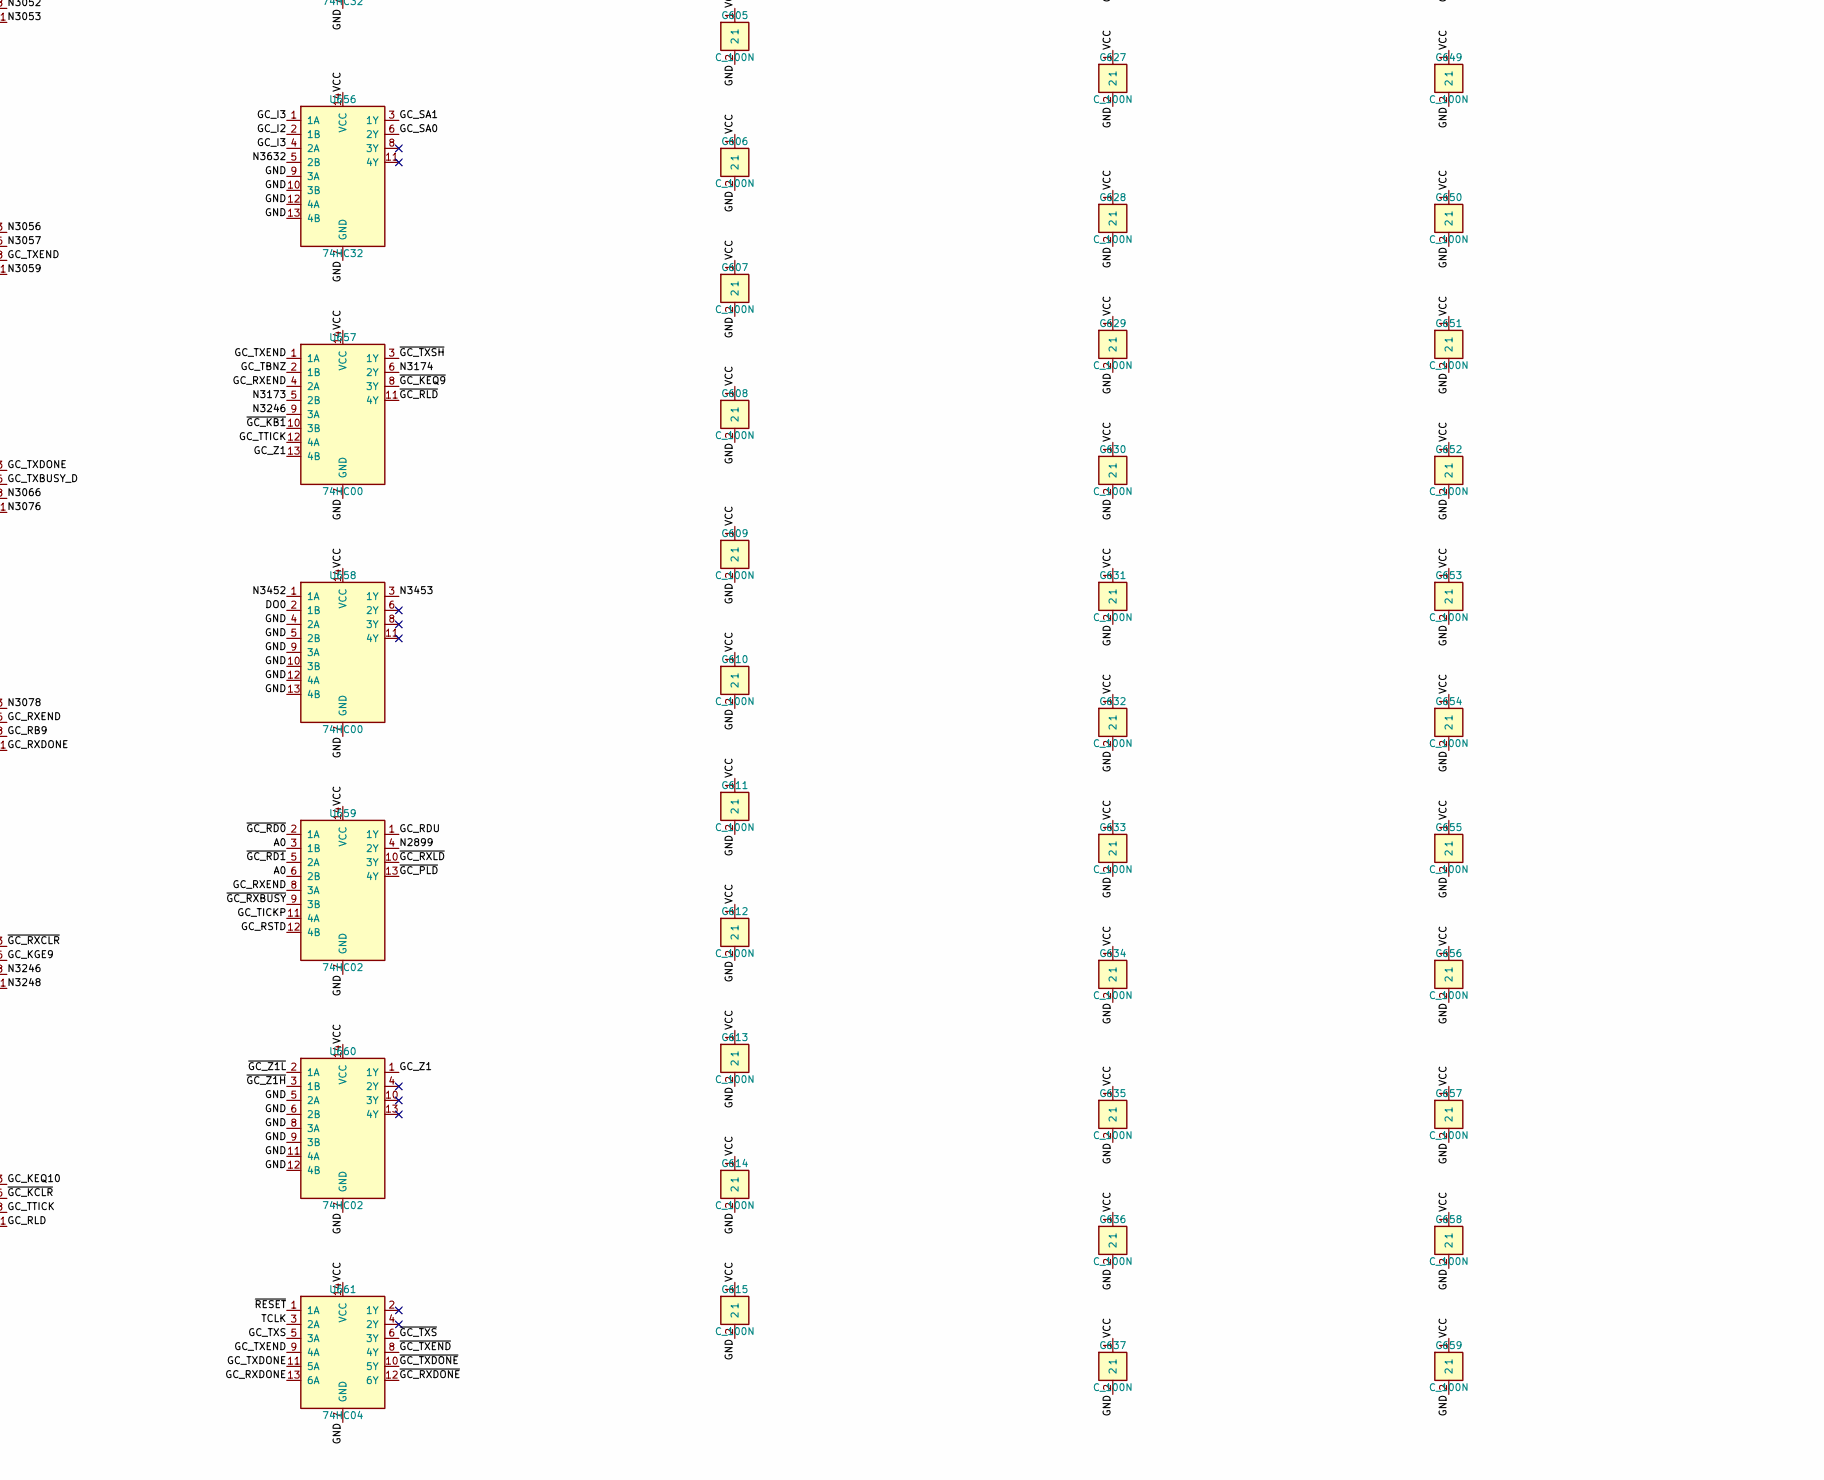
[picture p13: schematic gc.kicad_sch, part in row 2, column 2]

Parts:
C601: C_100U; CP_Radial_D6.3mm_P2.50mm
C602, C603, C604, C605, C606, C607, C608, C609, C610, C611, C612, C613, C614, C615, C616, C617, C618, C619, C620, C621, C622, C623, C624, C625, C626, C627, C628, C629, C630, C631, C632, C633, C634, C635, C636, C637, C638, C639, C640, C641, C642, C643, C644, C645, C646, C647, C648, C649, C650, C651, C652, C653, C654, C655, C656, C657, C658, C659, C660, C661, C662, C663, C664, C665, C666: C_100N; C_Disc_D5.0mm_W2.5mm_P5.00mm
J601: CONN_CH340; PinSocket_1x06_P2.54mm_Vertical
J602: CONN_PS2; MiniDIN-6_Female_Horizontal
J603: BACKPLANE_2x32; PinHeader_2x32_P2.54mm_Vertical
R601, R602, R603: R_10K; R_Axial_DIN0207_L6.3mm_D2.5mm_P7.62mm_Horizontal
U601, U602, U603, U604: 74HC138; DIP-16_W7.62mm
U605, U611, U612, U630, U643: 74HC74; DIP-14_W7.62mm
U606: 74HC14; DIP-14_W7.62mm
U607: 74HC165; DIP-16_W7.62mm
U608, U609, U610, U613, U614, U615, U617, U620, U621, U622, U631, U632, U633, U634: 74HC161; DIP-16_W7.62mm
U616, U618: 74HC595; DIP-16_W7.62mm
U619: 74HC05; DIP-14_W7.62mm
U623, U624: 74HC574; DIP-20_W7.62mm
U625, U626, U628, U629, U638, U639, U640, U641, U642: 74HC541; DIP-20_W7.62mm
U627, U637: 74HC175; DIP-16_W7.62mm
U635, U636: 74HC688; DIP-20_W7.62mm
U644, U645, U646, U647, U648, U649, U650, U651: 74HC08; DIP-14_W7.62mm
U652, U653, U654, U655, U656: 74HC32; DIP-14_W7.62mm
U657, U658: 74HC00; DIP-14_W7.62mm
U659, U660: 74HC02; DIP-14_W7.62mm
U661, U662, U663, U664, U665: 74HC04; DIP-14_W7.62mm

Connections:
A0: J603.9, U659.3 (1B), U659.6 (2B)
A1: J603.10, U602.1 (A0), U603.1 (A0), U604.1 (A0)
A2: J603.11, U602.2 (A1), U603.2 (A1), U604.2 (A1)
A3: J603.12, U602.3 (A2), U603.3 (A2), U604.3 (A2)
A4: J603.13, U601.1 (A0)
A5: J603.14, U601.2 (A1)
A6: J603.15, U601.3 (A2)
A7: J603.16, U601.5 (~E2)
A8: J603.17
A9: J603.18
A10: J603.19
A11: J603.20
A12: J603.21
A13: J603.22
A14: J603.23
A15: J603.24
CLK: J603.5, U605.3 (1CLK), U605.11 (2CLK)
DE0: J603.25, U607.6 (D7), U616.7 (Q7), U618.7 (Q7), U623.2 (D0), U625.18 (Y0), U627.4 (D0), U628.18 (Y0), U638.18 (Y0), U639.18 (Y0)
DE1: J603.26, U607.5 (D6), U616.6 (Q6), U618.6 (Q6), U623.3 (D1), U625.17 (Y1), U627.5 (D1), U628.17 (Y1), U638.17 (Y1), U639.17 (Y1)
DE2: J603.27, U607.4 (D5), U616.5 (Q5), U618.5 (Q5), U623.4 (D2), U625.16 (Y2), U628.16 (Y2), U638.16 (Y2), U639.16 (Y2)
DE3: J603.28, U607.3 (D4), U616.4 (Q4), U618.4 (Q4), U623.5 (D3), U625.15 (Y3), U628.15 (Y3), U638.15 (Y3), U639.15 (Y3)
DE4: J603.29, U607.14 (D3), U616.3 (Q3), U618.3 (Q3), U623.6 (D4), U625.14 (Y4), U628.14 (Y4), U638.14 (Y4), U639.14 (Y4)
DE5: J603.30, U607.13 (D2), U616.2 (Q2), U618.2 (Q2), U623.7 (D5), U625.13 (Y5), U628.13 (Y5), U638.13 (Y5), U639.13 (Y5)
DE6: J603.31, U607.12 (D1), U616.1 (Q1), U618.1 (Q1), U623.8 (D6), U625.12 (Y6), U628.12 (Y6), U638.12 (Y6), U639.12 (Y6)
DE7: J603.32, U607.11 (D0), U616.15 (Q0), U618.15 (Q0), U623.9 (D7), U625.11 (Y7), U628.11 (Y7), U638.11 (Y7), U639.11 (Y7)
DO0: J603.33, U624.2 (D0), U626.18 (Y0), U629.18 (Y0), U637.4 (D0), U640.18 (Y0), U641.18 (Y0), U642.18 (Y0), U658.2 (1B)
DO1: J603.34, U624.3 (D1), U626.17 (Y1), U629.17 (Y1), U637.5 (D1), U640.17 (Y1), U641.17 (Y1), U642.17 (Y1)
DO2: J603.35, U624.4 (D2), U626.16 (Y2), U629.16 (Y2), U637.12 (D2), U640.16 (Y2), U641.16 (Y2), U642.16 (Y2)
DO3: J603.36, U624.5 (D3), U626.15 (Y3), U629.15 (Y3), U637.13 (D3), U640.15 (Y3), U641.15 (Y3), U642.15 (Y3)
DO4: J603.37, U624.6 (D4), U626.14 (Y4), U629.14 (Y4), U640.14 (Y4), U641.14 (Y4), U642.14 (Y4)
DO5: J603.38, U624.7 (D5), U626.13 (Y5), U629.13 (Y5), U640.13 (Y5), U641.13 (Y5), U642.13 (Y5)
DO6: J603.39, U624.8 (D6), U626.12 (Y6), U629.12 (Y6), U640.12 (Y6), U641.12 (Y6), U642.12 (Y6)
DO7: J603.40, U624.9 (D7), U626.11 (Y7), U629.11 (Y7), U640.11 (Y7), U641.11 (Y7), U642.11 (Y7)
FAULT: J603.45
GC_EXPIRED: U629.2 (A0), U630.5 (1Q), U650.9 (3A), U655.2 (1B)
GC_EXP_D: U630.2 (1D), U655.3 (1Y)
GC_I0: U650.11 (4Y), U655.4 (2A)
GC_I1: U651.3 (1Y), U651.12 (4A), U655.5 (2B)
GC_I2: U651.6 (2Y), U655.9 (3A), U656.2 (1B), U665.9 (4A)
GC_I3: U651.8 (3Y), U655.10 (3B), U656.1 (1A), U656.4 (2A)
GC_KB0: U617.14 (Q0), U648.10 (3B), U654.4 (2A), U662.5 (3A)
GC_KB1: U617.13 (Q1), U648.13 (4B), U654.5 (2B), U662.3 (2A)
GC_KB3: U617.11 (Q3), U648.4 (2A), U648.9 (3A), U648.12 (4A)
GC_KCLKN: U606.2 (1Y), U617.2 (CP), U643.11 (2CLK), U654.9 (3A), U654.12 (4A)
GC_KDAT: U606.6 (3Y), U618.14 (DS)
GC_KDATN: U606.4 (2Y), U606.5 (3A)
GC_KEQ10: U643.12 (2D), U649.3 (1Y)
GC_KGE9: U648.6 (2Y), U654.10 (3B)
GC_KRDY: U619.1 (1A), U639.3 (A1), U642.2 (A0), U643.9 (2Q), U644.2 (1B), U651.1 (1A)
GC_KSHCP: U618.11 (SHCP), U654.8 (3Y)
GC_KSTCP: U618.12 (STCP), U654.11 (4Y)
GC_M0: U637.2 (Q0), U640.2 (A0), U650.13 (4B)
GC_M1: U637.7 (Q1), U640.3 (A1), U651.2 (1B)
GC_M2: U637.10 (Q2), U640.4 (A2), U651.5 (2B)
GC_M3: U637.15 (Q3), U640.5 (A3), U651.10 (3B)
GC_P0: U639.2 (A0), U650.8 (3Y), U650.12 (4A)
GC_P0TC: U620.15 (TC), U621.10 (CET)
GC_P1TC: U621.15 (TC), U622.10 (CET)
GC_R0: U623.19 (Q0), U625.2 (A0), U662.11 (5A)
GC_R1: U623.18 (Q1), U625.3 (A1), U662.13 (6A)
GC_R2: U623.17 (Q2), U625.4 (A2), U663.1 (1A)
GC_R3: U623.16 (Q3), U625.5 (A3), U663.3 (2A)
GC_R4: U623.15 (Q4), U625.6 (A4), U663.5 (3A)
GC_R5: U623.14 (Q5), U625.7 (A5), U663.9 (4A)
GC_R6: U623.13 (Q6), U625.8 (A6), U663.11 (5A)
GC_R7: U623.12 (Q7), U625.9 (A7), U663.13 (6A)
GC_R8: U624.19 (Q0), U626.2 (A0), U664.1 (1A)
GC_R9: U624.18 (Q1), U626.3 (A1), U664.3 (2A)
GC_R10: U624.17 (Q2), U626.4 (A2), U664.5 (3A)
GC_R11: U624.16 (Q3), U626.5 (A3), U664.9 (4A)
GC_R12: U624.15 (Q4), U626.6 (A4), U664.11 (5A)
GC_R13: U624.14 (Q5), U626.7 (A5), U664.13 (6A)
GC_R14: U624.13 (Q6), U626.8 (A6), U665.1 (1A)
GC_R15: U624.12 (Q7), U626.9 (A7), U665.3 (2A)
GC_RB0: U615.14 (Q0), U647.10 (3B)
GC_RB3: U615.11 (Q3), U647.9 (3A)
GC_RB9: U647.8 (3Y), U647.13 (4B), U662.1 (1A)
GC_RDK: U605.12 (2D), U644.3 (1Y)
GC_RDU: U605.2 (1D), U659.1 (1Y)
GC_RLD: U649.11 (4Y), U655.1 (1A)
GC_RSTD: U630.9 (2Q), U659.12 (4B)
GC_RXBUSY: U612.9 (2Q), U615.1 (~MR), U646.12 (4A)
GC_RXBUSY_D: U612.12 (2D), U653.8 (3Y)
GC_RXD1: U613.13 (Q1), U647.5 (2B)
GC_RXD5: U614.13 (Q1), U647.4 (2A)
GC_RXDONE: U647.11 (4Y), U661.13 (6A)
GC_RXDTC: U613.15 (TC), U614.10 (CET)
GC_RXEND: U615.7 (CEP), U615.10 (CET), U647.6 (2Y), U647.12 (4A), U657.4 (2A), U659.8 (3A)
GC_RXRDY: J601.2 (~CTS), U639.4 (A2), U641.2 (A0), U643.5 (1Q), U651.4 (2A)
GC_RXS1: U611.5 (1Q), U611.12 (2D)
GC_RXS2: U611.9 (2Q), U616.14 (DS)
GC_RXSHCP: U616.11 (SHCP), U653.11 (4Y)
GC_RXSTCP: U616.12 (STCP), U643.3 (1CLK), U654.3 (1Y)
GC_SA0: U638.2 (A0), U656.6 (2Y)
GC_SA1: U638.3 (A1), U656.3 (1Y)
GC_TB0: U610.14 (Q0), U644.10 (3B), U645.13 (4B), U652.9 (3A)
GC_TB1: U610.13 (Q1), U644.9 (3A), U652.10 (3B)
GC_TB2: U610.12 (Q2), U644.12 (4A), U652.12 (4A)
GC_TB3: U610.11 (Q3), U645.12 (4A), U652.1 (1A), U652.13 (4B)
GC_TBNZ: U646.9 (3A), U653.3 (1Y), U657.2 (1B)
GC_TD0: U608.14 (Q0), U645.2 (1B)
GC_TD1: U608.13 (Q1), U645.5 (2B)
GC_TD5: U609.13 (Q1), U645.9 (3A)
GC_TDTC: U608.15 (TC), U609.10 (CET)
GC_TEN: U627.2 (Q0), U628.2 (A0), U649.10 (3B), U650.1 (1A)
GC_TICKP: U622.15 (TC), U649.9 (3A), U659.11 (4A)
GC_TIRQEN: U627.7 (Q1), U628.3 (A1), U650.10 (3B)
GC_TTICK: U631.7 (CEP), U632.7 (CEP), U633.7 (CEP), U634.7 (CEP), U649.8 (3Y), U649.12 (4A), U657.12 (4A)
GC_TXBUSY: U612.5 (1Q), U644.4 (2A), U646.4 (2A)
GC_TXBUSY_D: U612.2 (1D), U646.6 (2Y)
GC_TXDONE: U646.3 (1Y), U661.11 (5A)
GC_TXEMPTY: U612.6 (~1Q), U641.3 (A1), U653.4 (2A)
GC_TXEND: U610.7 (CEP), U610.10 (CET), U645.8 (3Y), U646.1 (1A), U657.1 (1A), U661.9 (4A)
GC_TXLOW: U645.10 (3B), U652.6 (2Y)
GC_TXQ: U607.9 (Q7), U646.10 (3B)
GC_TXRUN: U608.1 (~MR), U609.1 (~MR), U610.1 (~MR), U644.6 (2Y)
GC_TXS: U645.1 (1A), U652.3 (1Y), U661.5 (3A)
GC_U0: U631.14 (Q0), U635.2 (P0)
GC_U1: U631.13 (Q1), U635.4 (P1)
GC_U2: U631.12 (Q2), U635.6 (P2)
GC_U3: U631.11 (Q3), U635.8 (P3)
GC_U4: U632.14 (Q0), U635.11 (P4)
GC_U5: U632.13 (Q1), U635.13 (P5)
GC_U6: U632.12 (Q2), U635.15 (P6)
GC_U7: U632.11 (Q3), U635.17 (P7)
GC_U8: U633.14 (Q0), U636.2 (P0)
GC_U9: U633.13 (Q1), U636.4 (P1)
GC_U10: U633.12 (Q2), U636.6 (P2)
GC_U11: U633.11 (Q3), U636.8 (P3)
GC_U12: U634.14 (Q0), U636.11 (P4)
GC_U13: U634.13 (Q1), U636.13 (P5)
GC_U14: U634.12 (Q2), U636.15 (P6)
GC_U15: U634.11 (Q3), U636.17 (P7)
GC_URX: U606.10 (5Y), U611.2 (1D)
GC_URXN: U606.8 (4Y), U606.11 (5A)
GC_UTC0: U631.15 (TC), U632.10 (CET)
GC_UTC1: U632.15 (TC), U633.10 (CET)
GC_UTC2: U633.15 (TC), U634.10 (CET)
GC_Z1: U649.13 (4B), U657.13 (4B), U660.1 (1Y)
GND: C601.2 (-), C602.2, C603.2, C604.2, C605.2, C606.2, C607.2, C608.2, C609.2, C610.2, C611.2, C612.2, C613.2, C614.2, C615.2, C616.2, C617.2, C618.2, C619.2, C620.2, C621.2, C622.2, C623.2, C624.2, C625.2, C626.2, C627.2, C628.2, C629.2, C630.2, C631.2, C632.2, C633.2, C634.2, C635.2, C636.2, C637.2, C638.2, C639.2, C640.2, C641.2, C642.2, C643.2, C644.2, C645.2, C646.2, C647.2, C648.2, C649.2, C650.2, C651.2, C652.2, C653.2, C654.2, C655.2, C656.2, C657.2, C658.2, C659.2, C660.2, C661.2, C662.2, C663.2, C664.2, C665.2, C666.2, J601.1 (GND), J602.3 (GND), J603.1, J603.2, J603.62, J603.64, U601.8 (GND), U602.8 (GND), U603.8 (GND), U604.8 (GND), U605.7 (GND), U606.7 (GND), U606.13 (6A), U607.8 (GND), U608.3 (D0), U608.4 (D1), U608.5 (D2), U608.6 (D3), U608.8 (GND), U609.3 (D0), U609.4 (D1), U609.5 (D2), U609.6 (D3), U609.8 (GND), U610.3 (D0), U610.4 (D1), U610.5 (D2), U610.6 (D3), U610.8 (GND), U611.7 (GND), U612.7 (GND), U613.5 (D2), U613.6 (D3), U613.8 (GND), U614.4 (D1), U614.5 (D2), U614.6 (D3), U614.8 (GND), U615.3 (D0), U615.4 (D1), U615.5 (D2), U615.6 (D3), U615.8 (GND), U616.8 (GND), U617.3 (D0), U617.4 (D1), U617.5 (D2), U617.6 (D3), U617.8 (GND), U618.8 (GND), U619.3 (2A), U619.5 (3A), U619.7 (GND), U619.9 (4A), U619.11 (5A), U619.13 (6A), U620.3 (D0), U620.4 (D1), U620.5 (D2), U620.6 (D3), U620.8 (GND), U621.3 (D0), U621.6 (D3), U621.8 (GND), U622.3 (D0), U622.4 (D1), U622.5 (D2), U622.6 (D3), U622.8 (GND), U623.1 (~OE), U623.10 (GND), U624.1 (~OE), U624.10 (GND), U625.10 (GND), U625.19 (~OE2), U626.10 (GND), U626.19 (~OE2), U627.8 (GND), U627.12 (D2), U627.13 (D3), U628.4 (A2), U628.5 (A3), U628.6 (A4), U628.7 (A5), U628.8 (A6), U628.9 (A7), U628.10 (GND), U628.19 (~OE2), U629.3 (A1), U629.4 (A2), U629.5 (A3), U629.6 (A4), U629.7 (A5), U629.8 (A6), U629.9 (A7), U629.10 (GND), U629.19 (~OE2), U630.7 (GND), U630.12 (2D), U631.8 (GND), U632.8 (GND), U633.8 (GND), U634.8 (GND), U635.1 (~E), U635.3 (Q0), U635.10 (GND), U636.1 (~E), U636.10 (GND), U637.8 (GND), U638.4 (A2), U638.5 (A3), U638.6 (A4), U638.7 (A5), U638.8 (A6), U638.9 (A7), U638.10 (GND), U639.6 (A4), U639.7 (A5), U639.8 (A6), U639.9 (A7), U639.10 (GND), U639.19 (~OE2), U640.6 (A4), U640.7 (A5), U640.8 (A6), U640.9 (A7), U640.10 (GND), U640.19 (~OE2), U641.4 (A2), U641.5 (A3), U641.6 (A4), U641.7 (A5), U641.8 (A6), U641.9 (A7), U641.10 (GND), U641.19 (~OE2), U642.3 (A1), U642.4 (A2), U642.5 (A3), U642.6 (A4), U642.7 (A5), U642.8 (A6), U642.9 (A7), U642.10 (GND), U642.19 (~OE2), U643.7 (GND), U644.7 (GND), U645.7 (GND), U646.7 (GND), U647.7 (GND), U648.7 (GND), U649.7 (GND), U650.7 (GND), U651.7 (GND), U652.7 (GND), U653.7 (GND), U654.7 (GND), U655.7 (GND), U656.7 (GND), U656.9 (3A), U656.10 (3B), U656.12 (4A), U656.13 (4B), U657.7 (GND), U658.4 (2A), U658.5 (2B), U658.7 (GND), U658.9 (3A), U658.10 (3B), U658.12 (4A), U658.13 (4B), U659.7 (GND), U660.5 (2A), U660.6 (2B), U660.7 (GND), U660.8 (3A), U660.9 (3B), U660.11 (4A), U660.12 (4B), U661.7 (GND), U662.7 (GND), U663.7 (GND), U664.7 (GND), U665.7 (GND), U665.11 (5A), U665.13 (6A)
HALTED: J603.44
IRQ: J603.8, U655.11 (4Y), U665.5 (3A)
N2899: U644.1 (1A), U659.4 (2Y)
N3052: U644.8 (3Y), U644.13 (4B)
N3053: U644.11 (4Y), U652.2 (1B)
N3056: U645.3 (1Y), U652.4 (2A)
N3057: U645.6 (2Y), U652.5 (2B)
N3059: U645.11 (4Y), U646.2 (1B)
N3063: U652.8 (3Y), U653.1 (1A)
N3064: U652.11 (4Y), U653.2 (1B)
N3066: U646.8 (3Y), U653.5 (2B)
N3076: U646.11 (4Y), U653.9 (3A)
N3078: U647.3 (1Y), U653.10 (3B)
N3173: U657.5 (2B), U662.2 (1Y)
N3174: U653.13 (4B), U657.6 (2Y)
N3243: U648.5 (2B), U654.6 (2Y)
N3246: U648.8 (3Y), U657.9 (3A)
N3248: U648.11 (4Y), U649.1 (1A)
N3249: U649.2 (1B), U662.6 (3Y)
N3452: U658.1 (1A), U662.8 (4Y)
N3453: U650.5 (2B), U658.3 (1Y)
N3627: U655.6 (2Y), U655.12 (4A)
N3628: U655.8 (3Y), U655.13 (4B)
N3632: U651.11 (4Y), U656.5 (2B)
OSC: J603.49
PA14: J603.50
PA15: J603.51
PA16: J603.52
PA17: J603.53
PA18: J603.54
PA19: J603.55
PS2_CLK: J602.5 (CLK), R602.2, U606.1 (1A), U619.2 (1Y)
PS2_DAT: J602.1 (DATA), R603.2, U606.3 (2A)
TCLK: J603.48, U607.2 (CP), U608.2 (CP), U609.2 (CP), U610.2 (CP), U611.3 (1CLK), U611.11 (2CLK), U612.3 (1CLK), U612.11 (2CLK), U613.2 (CP), U614.2 (CP), U615.2 (CP), U620.2 (CP), U621.2 (CP), U622.2 (CP), U630.3 (1CLK), U630.11 (2CLK), U631.2 (CP), U632.2 (CP), U633.2 (CP), U634.2 (CP), U653.12 (4A), U654.1 (1A), U661.3 (2A)
UART_RXD: J601.4 (TXD), R601.2, U606.9 (4A)
UART_TXD: J601.5 (RXD), U653.6 (2Y)
VCC: C601.1 (+), C602.1, C603.1, C604.1, C605.1, C606.1, C607.1, C608.1, C609.1, C610.1, C611.1, C612.1, C613.1, C614.1, C615.1, C616.1, C617.1, C618.1, C619.1, C620.1, C621.1, C622.1, C623.1, C624.1, C625.1, C626.1, C627.1, C628.1, C629.1, C630.1, C631.1, C632.1, C633.1, C634.1, C635.1, C636.1, C637.1, C638.1, C639.1, C640.1, C641.1, C642.1, C643.1, C644.1, C645.1, C646.1, C647.1, C648.1, C649.1, C650.1, C651.1, C652.1, C653.1, C654.1, C655.1, C656.1, C657.1, C658.1, C659.1, C660.1, C661.1, C662.1, C663.1, C664.1, C665.1, C666.1, J602.4 (VCC), J603.3, J603.4, J603.63, R601.1, R602.1, R603.1, U601.6 (E3), U601.16 (VCC), U602.6 (E3), U602.16 (VCC), U603.6 (E3), U603.16 (VCC), U604.6 (E3), U604.16 (VCC), U605.4 (~1PRE), U605.10 (~2PRE), U605.14 (VCC), U606.14 (VCC), U607.10 (DS), U607.16 (VCC), U608.7 (CEP), U608.10 (CET), U608.16 (VCC), U609.7 (CEP), U609.16 (VCC), U610.9 (~PE), U610.16 (VCC), U611.1 (~1CLR), U611.13 (~2CLR), U611.14 (VCC), U612.10 (~2PRE), U612.14 (VCC), U613.1 (~MR), U613.7 (CEP), U613.10 (CET), U613.16 (VCC), U614.1 (~MR), U614.7 (CEP), U614.16 (VCC), U615.9 (~PE), U615.16 (VCC), U616.10 (~MR), U616.16 (VCC), U617.7 (CEP), U617.9 (~PE), U617.10 (CET), U617.16 (VCC), U618.10 (~MR), U618.16 (VCC), U619.14 (VCC), U620.1 (~MR), U620.7 (CEP), U620.10 (CET), U620.16 (VCC), U621.1 (~MR), U621.4 (D1), U621.5 (D2), U621.7 (CEP), U621.16 (VCC), U622.1 (~MR), U622.7 (CEP), U622.16 (VCC), U623.20 (VCC), U624.20 (VCC), U625.20 (VCC), U626.20 (VCC), U627.16 (VCC), U628.20 (VCC), U629.20 (VCC), U630.4 (~1PRE), U630.13 (~2CLR), U630.14 (VCC), U631.10 (CET), U631.16 (VCC), U632.16 (VCC), U633.16 (VCC), U634.16 (VCC), U635.5 (Q1), U635.7 (Q2), U635.9 (Q3), U635.12 (Q4), U635.14 (Q5), U635.16 (Q6), U635.18 (Q7), U635.20 (VCC), U636.3 (Q0), U636.5 (Q1), U636.7 (Q2), U636.9 (Q3), U636.12 (Q4), U636.14 (Q5), U636.16 (Q6), U636.18 (Q7), U636.20 (VCC), U637.16 (VCC), U638.20 (VCC), U639.20 (VCC), U640.20 (VCC), U641.20 (VCC), U642.20 (VCC), U643.2 (1D), U643.4 (~1PRE), U643.10 (~2PRE), U643.14 (VCC), U644.14 (VCC), U645.14 (VCC), U646.14 (VCC), U647.14 (VCC), U648.14 (VCC), U649.14 (VCC), U650.14 (VCC), U651.14 (VCC), U652.14 (VCC), U653.14 (VCC), U654.14 (VCC), U655.14 (VCC), U656.14 (VCC), U657.14 (VCC), U658.14 (VCC), U659.14 (VCC), U660.14 (VCC), U661.14 (VCC), U662.14 (VCC), U663.14 (VCC), U664.14 (VCC), U665.14 (VCC)
VSYNC_REQ: J603.56, U639.5 (A3), U651.9 (3A)
WR_WIN: J603.6
~GC_EXPCLR: U630.1 (~1CLR), U650.6 (2Y)
~GC_G0: U601.15 (~Y0), U602.4 (~E1), U603.4 (~E1), U604.4 (~E1)
~GC_GS: U638.19 (~OE2), U665.6 (3Y)
~GC_I2: U651.13 (4B), U665.8 (4Y)
~GC_KB1: U657.10 (3B), U662.4 (2Y)
~GC_KCLR: U617.1 (~MR), U643.13 (~2CLR), U649.6 (2Y)
~GC_KEQ9: U654.13 (4B), U657.8 (3Y)
~GC_PLD: U620.9 (~PE), U621.9 (~PE), U622.9 (~PE), U659.13 (4Y)
~GC_R0: U631.3 (D0), U662.10 (5Y)
~GC_R1: U631.4 (D1), U662.12 (6Y)
~GC_R2: U631.5 (D2), U663.2 (1Y)
~GC_R3: U631.6 (D3), U663.4 (2Y)
~GC_R4: U632.3 (D0), U663.6 (3Y)
~GC_R5: U632.4 (D1), U663.8 (4Y)
~GC_R6: U632.5 (D2), U663.10 (5Y)
~GC_R7: U632.6 (D3), U663.12 (6Y)
~GC_R8: U633.3 (D0), U664.2 (1Y)
~GC_R9: U633.4 (D1), U664.4 (2Y)
~GC_R10: U633.5 (D2), U664.6 (3Y)
~GC_R11: U633.6 (D3), U664.8 (4Y)
~GC_R12: U634.3 (D0), U664.10 (5Y)
~GC_R13: U634.4 (D1), U664.12 (6Y)
~GC_R14: U634.5 (D2), U665.2 (1Y)
~GC_R15: U634.6 (D3), U665.4 (2Y)
~GC_RD0: U602.15 (~Y0), U616.13 (~OE), U641.1 (~OE1), U659.2 (1A)
~GC_RD1: U602.14 (~Y1), U618.13 (~OE), U642.1 (~OE1), U659.5 (2A)
~GC_RD2: U602.13 (~Y2), U625.1 (~OE1), U626.1 (~OE1)
~GC_RD3: U602.12 (~Y3), U628.1 (~OE1), U629.1 (~OE1)
~GC_RD4: U602.11 (~Y4), U639.1 (~OE1), U640.1 (~OE1)
~GC_RD5: U602.10 (~Y5), U638.1 (~OE1)
~GC_RDK_Q: U605.8 (~2Q), U649.5 (2B)
~GC_RDU_Q: U605.6 (~1Q), U648.2 (1B)
~GC_RLD: U650.2 (1B), U657.11 (4Y)
~GC_RXBUSY: U612.8 (~2Q), U613.3 (D0), U613.4 (D1), U614.3 (D0), U647.1 (1A), U659.9 (3B)
~GC_RXCLR: U643.1 (~1CLR), U648.3 (1Y)
~GC_RXDONE: U646.13 (4B), U654.2 (1B), U661.12 (6Y)
~GC_RXLD: U613.9 (~PE), U614.9 (~PE), U659.10 (3Y)
~GC_RXS2: U611.8 (~2Q), U647.2 (1B)
~GC_TPE: U631.9 (~PE), U632.9 (~PE), U633.9 (~PE), U634.9 (~PE), U650.3 (1Y)
~GC_TXDONE: U646.5 (2B), U661.10 (5Y)
~GC_TXEND: U608.9 (~PE), U609.9 (~PE), U661.8 (4Y)
~GC_TXSH: U607.15 (~CE), U657.3 (1Y)
~GC_TXS: U645.4 (2A), U661.6 (3Y)
~GC_WE0: U603.15 (~Y0), U607.1 (~PL), U612.4 (~1PRE), U644.5 (2B)
~GC_WE2: U603.13 (~Y2), U623.11 (CP)
~GC_WE3: U603.12 (~Y3), U627.9 (CP)
~GC_WO2: U604.13 (~Y2), U624.11 (CP)
~GC_WO3: U604.12 (~Y3), U662.9 (4A)
~GC_WO4: U604.11 (~Y4), U637.9 (CP)
~GC_Z1H: U636.19 (~EQ), U660.3 (1B)
~GC_Z1L: U635.19 (~EQ), U660.2 (1A)
~IO: J603.47, U601.4 (~E1)
~MRD: J603.41, U602.5 (~E2)
~MWE_E: J603.42, U603.5 (~E2)
~MWE_O: J603.43, U604.5 (~E2)
~RESET: J603.7, U605.1 (~1CLR), U605.13 (~2CLR), U611.4 (~1PRE), U611.10 (~2PRE), U612.1 (~1CLR), U612.13 (~2CLR), U627.1 (~MR), U630.10 (~2PRE), U631.1 (~MR), U632.1 (~MR), U633.1 (~MR), U634.1 (~MR), U637.1 (~MR), U648.1 (1A), U649.4 (2A), U650.4 (2A), U661.1 (1A)
~WAIT: J603.46
