MihrimatriX/breadboarding/cpu16/kicad/hesap/hesap-anahtarlar.kicad_sch

## KiCad design cpu16/kicad/hesap/hesap-anahtarlar.kicad_sch (2026-10-12)

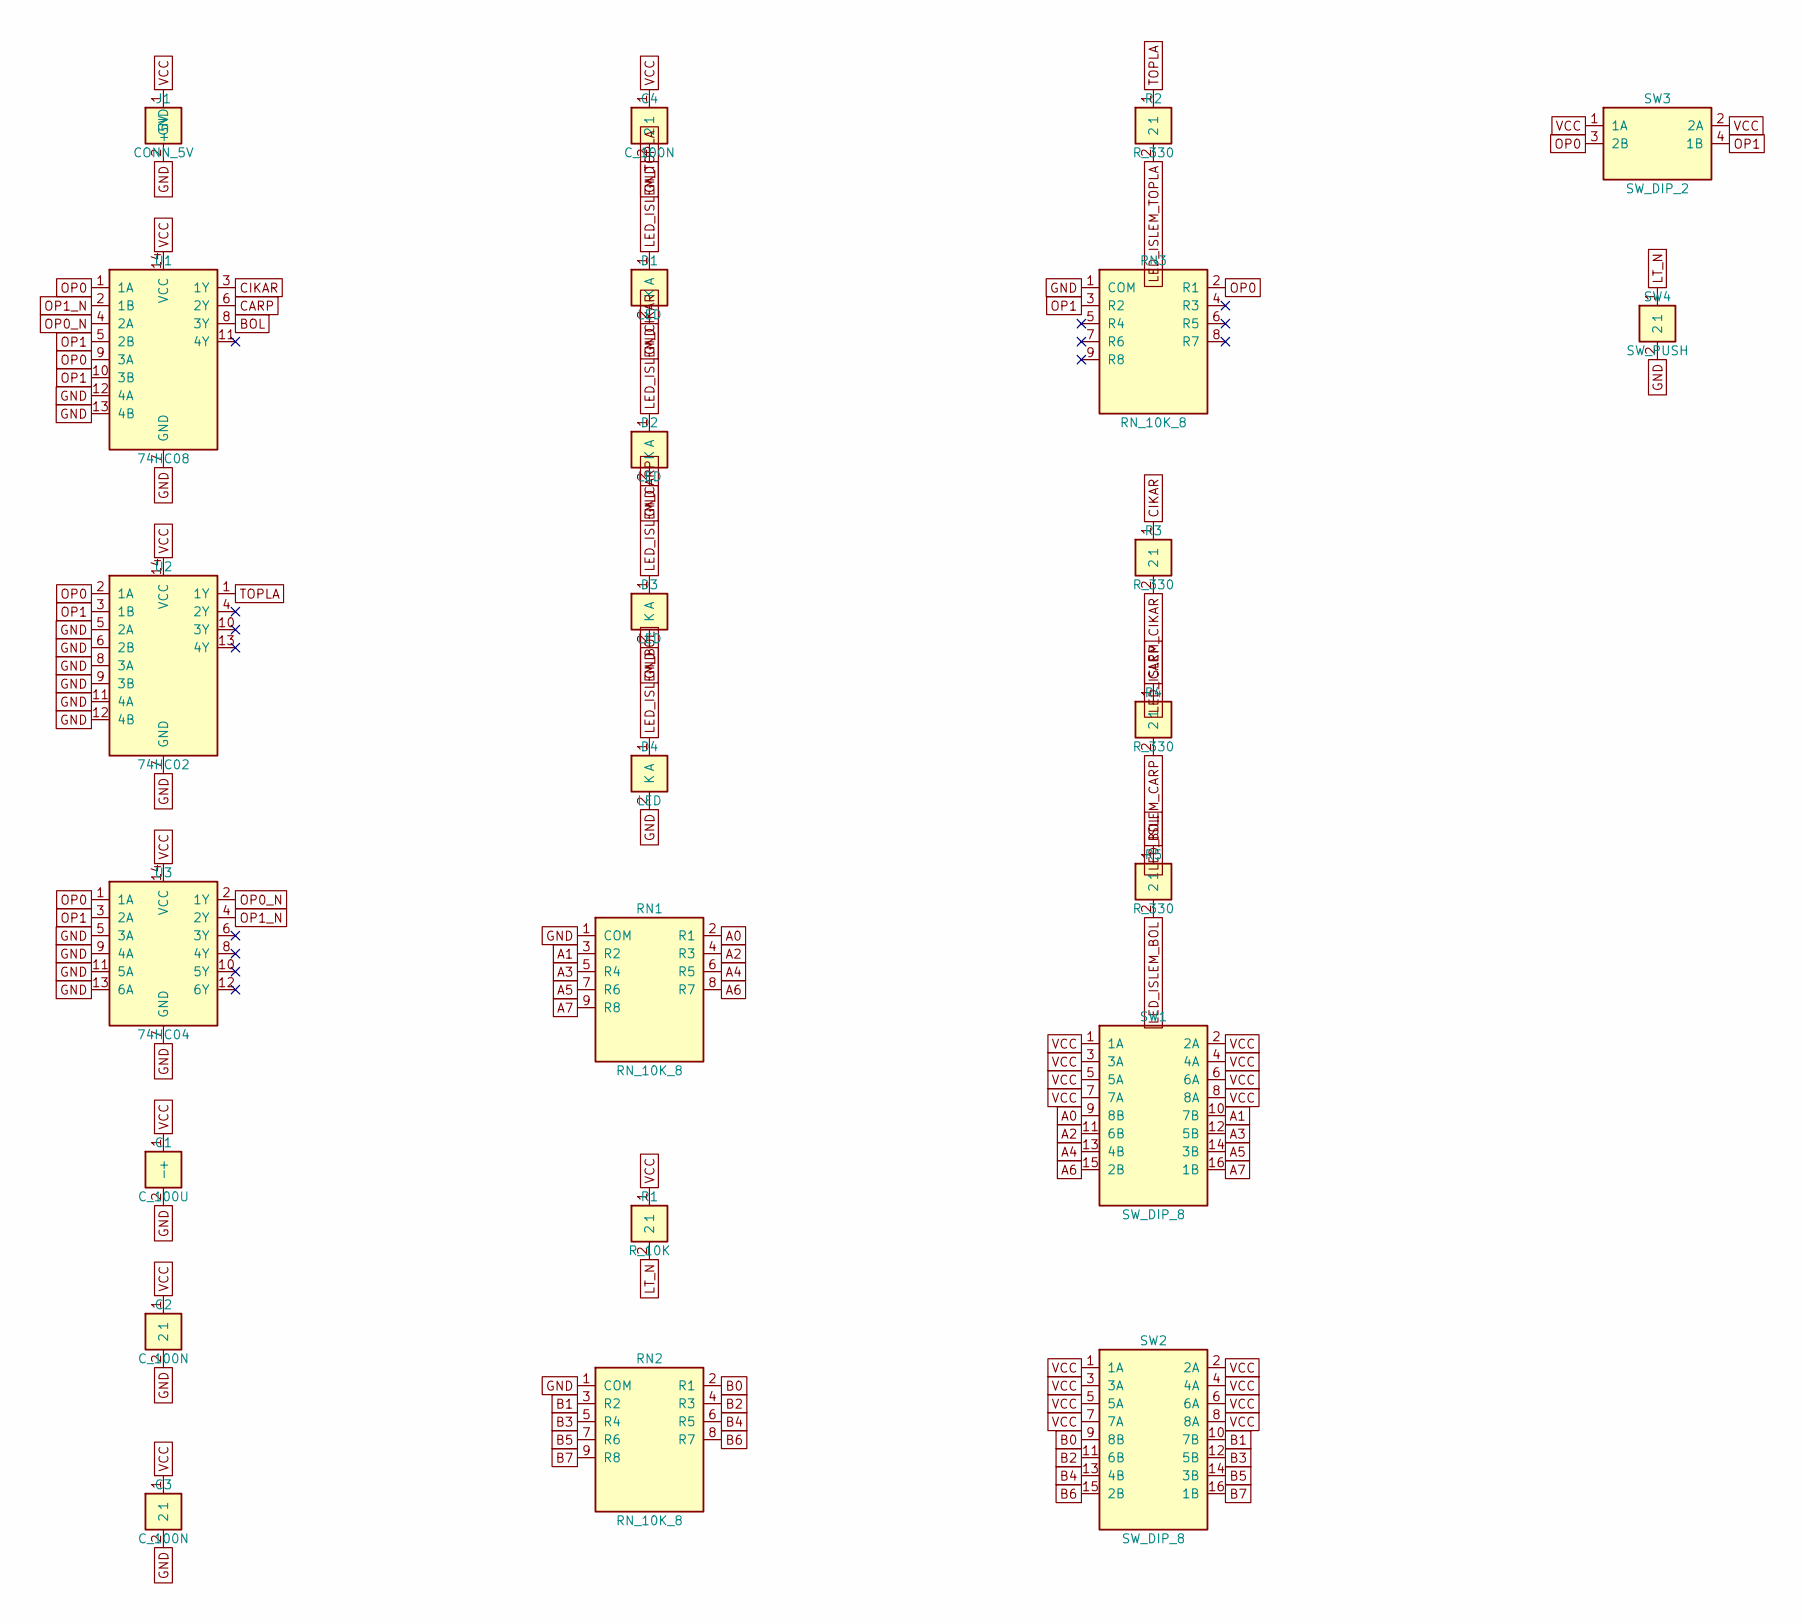
[picture p14: schematic hesap-anahtarlar.kicad_sch]

Parts:
C1: C_100U; CP_Radial_D6.3mm_P2.50mm
C2, C3, C4: C_100N; C_Disc_D5.0mm_W2.5mm_P5.00mm
D1, D2, D3, D4: LED; LED_D3.0mm
J1: CONN_5V; PinHeader_1x02_P2.54mm_Vertical
R1: R_10K; R_Axial_DIN0207_L6.3mm_D2.5mm_P7.62mm_Horizontal
R2, R3, R4, R5: R_330; R_Axial_DIN0207_L6.3mm_D2.5mm_P7.62mm_Horizontal
RN1, RN2, RN3: RN_10K_8; R_Array_SIP9
SW1, SW2: SW_DIP_8; SW_DIP_SPSTx08_Slide_9.78x22.5mm_W7.62mm_P2.54mm
SW3: SW_DIP_2; SW_DIP_SPSTx02_Slide_9.78x7.26mm_W7.62mm_P2.54mm
SW4: SW_PUSH; SW_PUSH_6mm
U1: 74HC08; DIP-14_W7.62mm
U2: 74HC02; DIP-14_W7.62mm
U3: 74HC04; DIP-14_W7.62mm

Connections:
A0: RN1.2 (R1), SW1.9 (8B)
A1: RN1.3 (R2), SW1.10 (7B)
A2: RN1.4 (R3), SW1.11 (6B)
A3: RN1.5 (R4), SW1.12 (5B)
A4: RN1.6 (R5), SW1.13 (4B)
A5: RN1.7 (R6), SW1.14 (3B)
A6: RN1.8 (R7), SW1.15 (2B)
A7: RN1.9 (R8), SW1.16 (1B)
B0: RN2.2 (R1), SW2.9 (8B)
B1: RN2.3 (R2), SW2.10 (7B)
B2: RN2.4 (R3), SW2.11 (6B)
B3: RN2.5 (R4), SW2.12 (5B)
B4: RN2.6 (R5), SW2.13 (4B)
B5: RN2.7 (R6), SW2.14 (3B)
B6: RN2.8 (R7), SW2.15 (2B)
B7: RN2.9 (R8), SW2.16 (1B)
BOL: R5.1, U1.8 (3Y)
CARP: R4.1, U1.6 (2Y)
CIKAR: R3.1, U1.3 (1Y)
GND: C1.2 (-), C2.2, C3.2, C4.2, D1.2 (K), D2.2 (K), D3.2 (K), D4.2 (K), J1.2 (GND), RN1.1 (COM), RN2.1 (COM), RN3.1 (COM), SW4.2, U1.7 (GND), U1.12 (4A), U1.13 (4B), U2.5 (2A), U2.6 (2B), U2.7 (GND), U2.8 (3A), U2.9 (3B), U2.11 (4A), U2.12 (4B), U3.5 (3A), U3.7 (GND), U3.9 (4A), U3.11 (5A), U3.13 (6A)
LED_ISLEM_BOL: D4.1 (A), R5.2
LED_ISLEM_CARP: D3.1 (A), R4.2
LED_ISLEM_CIKAR: D2.1 (A), R3.2
LED_ISLEM_TOPLA: D1.1 (A), R2.2
LT_N: R1.2, SW4.1
OP0: RN3.2 (R1), SW3.3 (2B), U1.1 (1A), U1.9 (3A), U2.2 (1A), U3.1 (1A)
OP0_N: U1.4 (2A), U3.2 (1Y)
OP1: RN3.3 (R2), SW3.4 (1B), U1.5 (2B), U1.10 (3B), U2.3 (1B), U3.3 (2A)
OP1_N: U1.2 (1B), U3.4 (2Y)
TOPLA: R2.1, U2.1 (1Y)
VCC: C1.1 (+), C2.1, C3.1, C4.1, J1.1 (+5V), R1.1, SW1.1 (1A), SW1.2 (2A), SW1.3 (3A), SW1.4 (4A), SW1.5 (5A), SW1.6 (6A), SW1.7 (7A), SW1.8 (8A), SW2.1 (1A), SW2.2 (2A), SW2.3 (3A), SW2.4 (4A), SW2.5 (5A), SW2.6 (6A), SW2.7 (7A), SW2.8 (8A), SW3.1 (1A), SW3.2 (2A), U1.14 (VCC), U2.14 (VCC), U3.14 (VCC)
