MihrimatriX/breadboarding/cpu16/kicad/hesap/hesap-bolme.kicad_sch

## KiCad design cpu16/kicad/hesap/hesap-bolme.kicad_sch (2026-10-12)

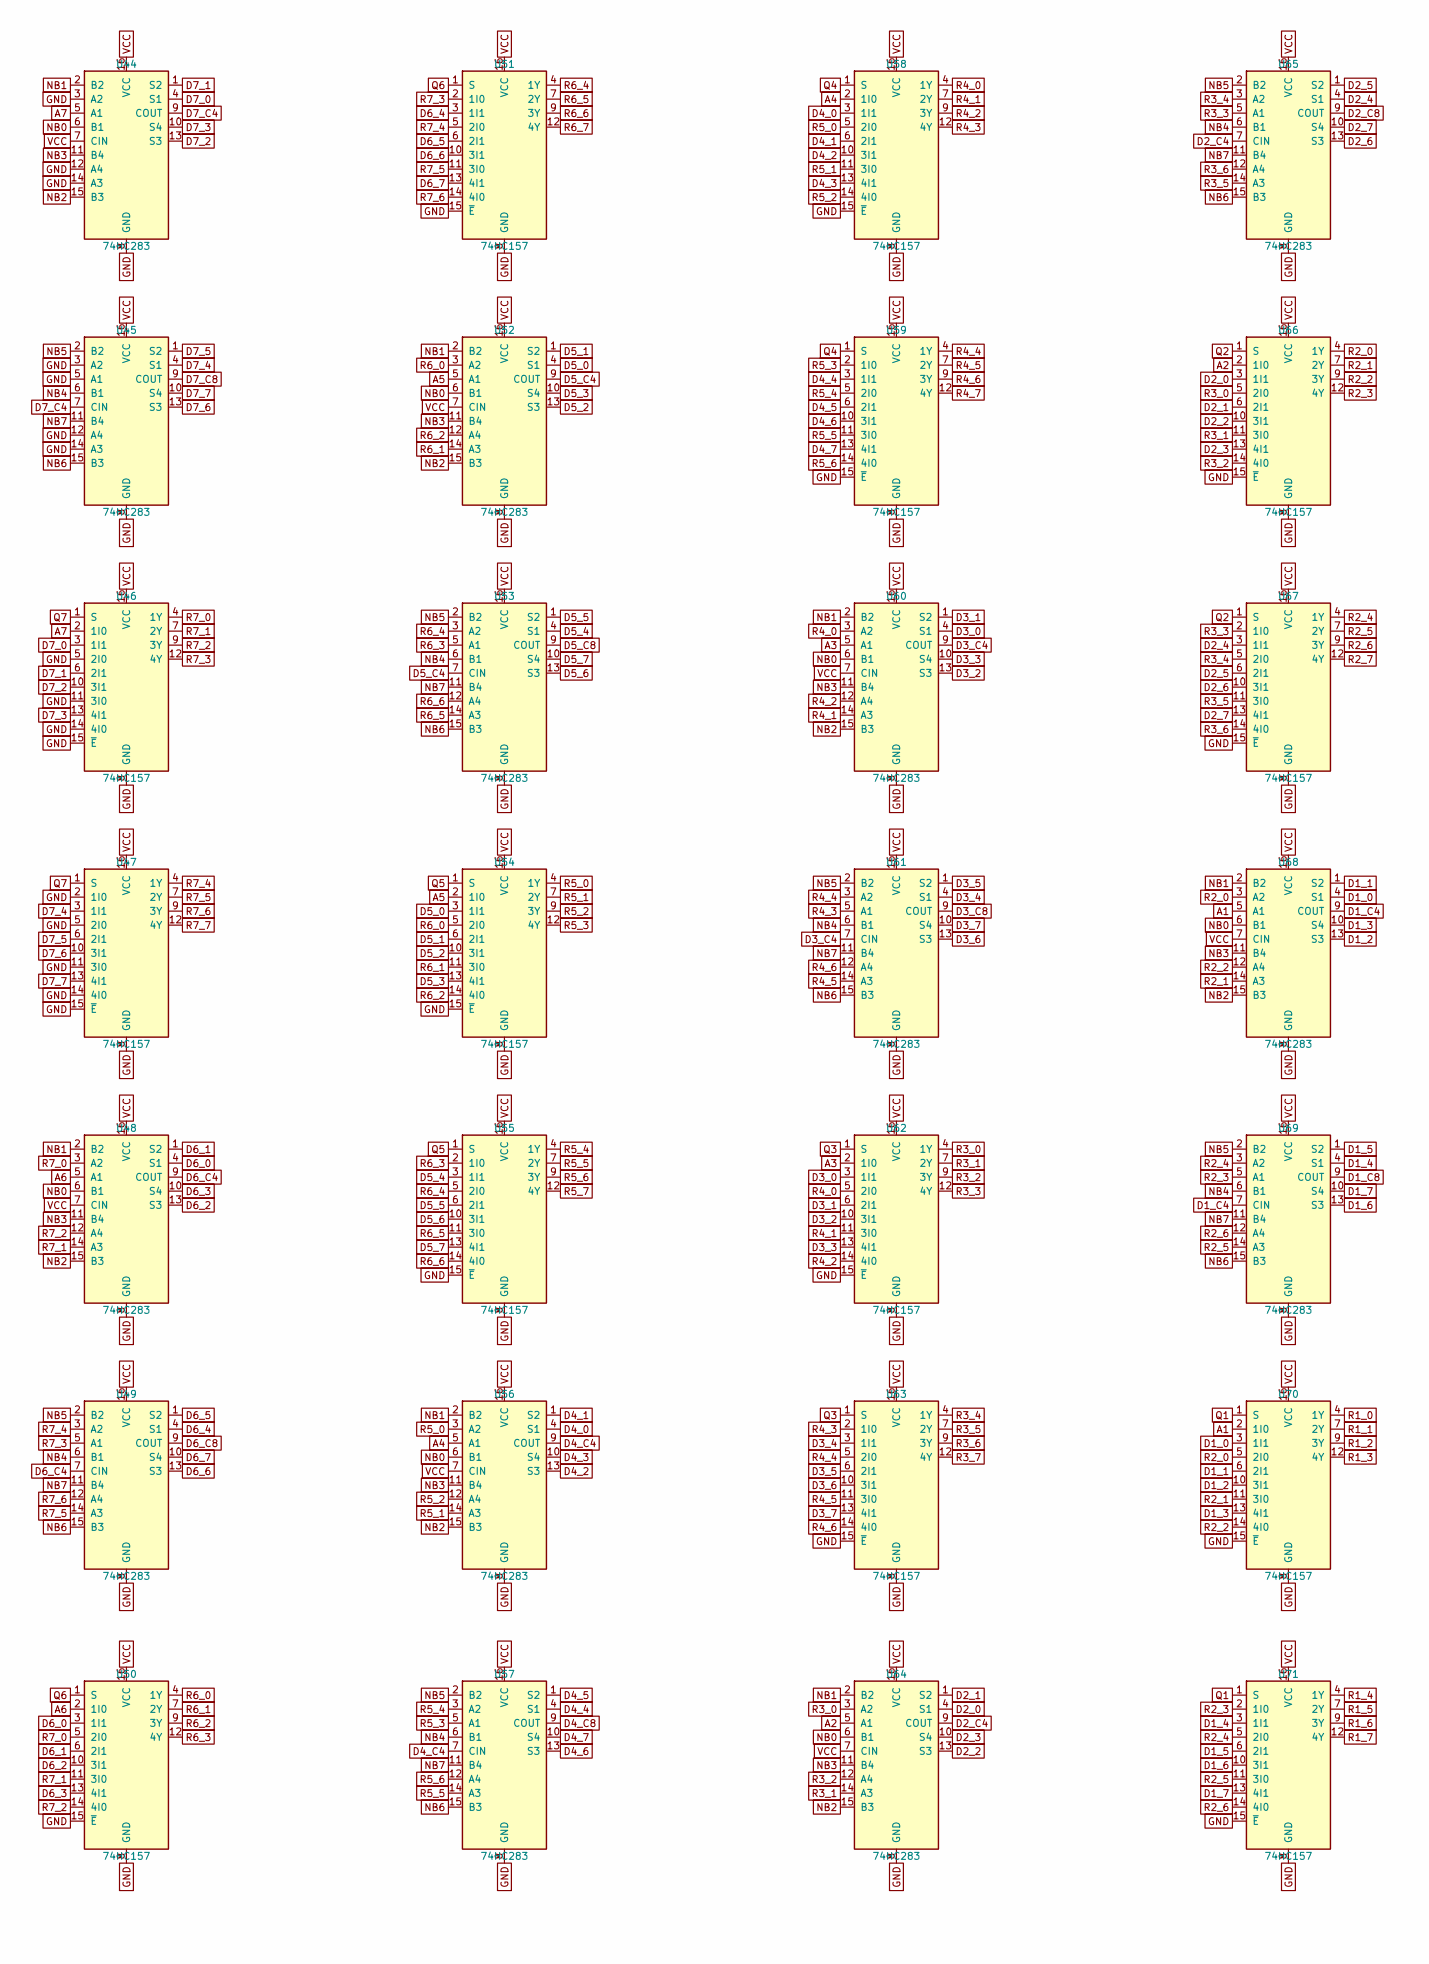
[picture p15: schematic hesap-bolme.kicad_sch, part in row 1, column 1]

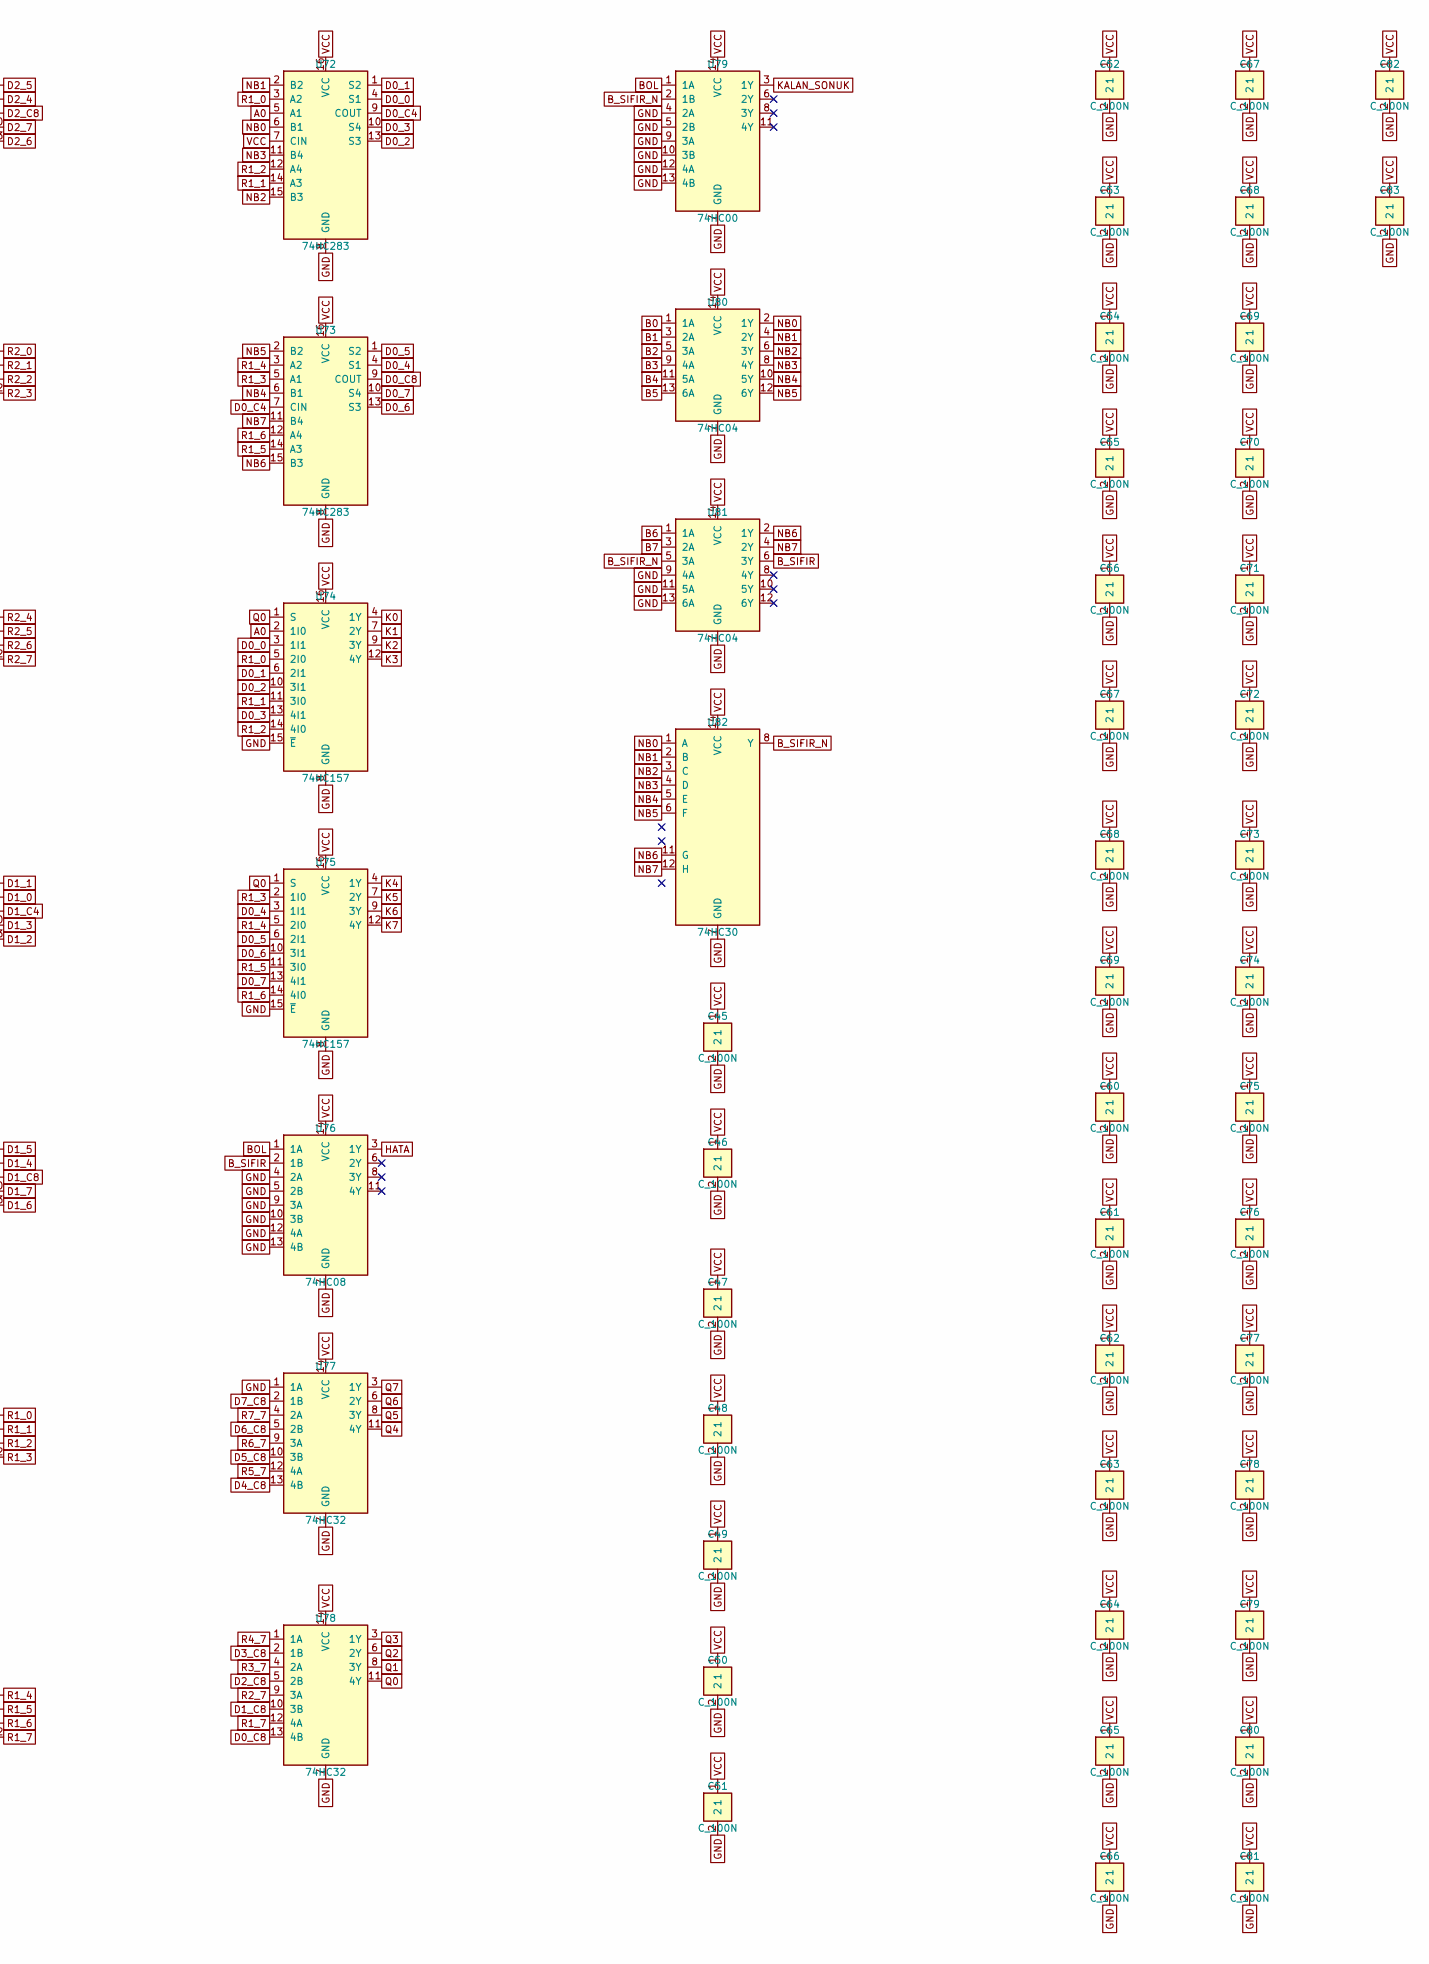
[picture p16: schematic hesap-bolme.kicad_sch, part in row 1, column 2]

Parts:
C45, C46, C47, C48, C49, C50, C51, C52, C53, C54, C55, C56, C57, C58, C59, C60, C61, C62, C63, C64, C65, C66, C67, C68, C69, C70, C71, C72, C73, C74, C75, C76, C77, C78, C79, C80, C81, C82, C83: C_100N; C_Disc_D5.0mm_W2.5mm_P5.00mm
U44, U45, U48, U49, U52, U53, U56, U57, U60, U61, U64, U65, U68, U69, U72, U73: 74HC283; DIP-16_W7.62mm
U46, U47, U50, U51, U54, U55, U58, U59, U62, U63, U66, U67, U70, U71, U74, U75: 74HC157; DIP-16_W7.62mm
U76: 74HC08; DIP-14_W7.62mm
U77, U78: 74HC32; DIP-14_W7.62mm
U79: 74HC00; DIP-14_W7.62mm
U80, U81: 74HC04; DIP-14_W7.62mm
U82: 74HC30; DIP-14_W7.62mm

Connections:
A0: U72.5 (A1), U74.2 (1I0)
A1: U68.5 (A1), U70.2 (1I0)
A2: U64.5 (A1), U66.2 (1I0)
A3: U60.5 (A1), U62.2 (1I0)
A4: U56.5 (A1), U58.2 (1I0)
A5: U52.5 (A1), U54.2 (1I0)
A6: U48.5 (A1), U50.2 (1I0)
A7: U44.5 (A1), U46.2 (1I0)
B0: U80.1 (1A)
B1: U80.3 (2A)
B2: U80.5 (3A)
B3: U80.9 (4A)
B4: U80.11 (5A)
B5: U80.13 (6A)
B6: U81.1 (1A)
B7: U81.3 (2A)
BOL: U76.1 (1A), U79.1 (1A)
B_SIFIR: U76.2 (1B), U81.6 (3Y)
B_SIFIR_N: U79.2 (1B), U81.5 (3A), U82.8 (Y)
D0_0: U72.4 (S1), U74.3 (1I1)
D0_1: U72.1 (S2), U74.6 (2I1)
D0_2: U72.13 (S3), U74.10 (3I1)
D0_3: U72.10 (S4), U74.13 (4I1)
D0_4: U73.4 (S1), U75.3 (1I1)
D0_5: U73.1 (S2), U75.6 (2I1)
D0_6: U73.13 (S3), U75.10 (3I1)
D0_7: U73.10 (S4), U75.13 (4I1)
D0_C4: U72.9 (COUT), U73.7 (CIN)
D0_C8: U73.9 (COUT), U78.13 (4B)
D1_0: U68.4 (S1), U70.3 (1I1)
D1_1: U68.1 (S2), U70.6 (2I1)
D1_2: U68.13 (S3), U70.10 (3I1)
D1_3: U68.10 (S4), U70.13 (4I1)
D1_4: U69.4 (S1), U71.3 (1I1)
D1_5: U69.1 (S2), U71.6 (2I1)
D1_6: U69.13 (S3), U71.10 (3I1)
D1_7: U69.10 (S4), U71.13 (4I1)
D1_C4: U68.9 (COUT), U69.7 (CIN)
D1_C8: U69.9 (COUT), U78.10 (3B)
D2_0: U64.4 (S1), U66.3 (1I1)
D2_1: U64.1 (S2), U66.6 (2I1)
D2_2: U64.13 (S3), U66.10 (3I1)
D2_3: U64.10 (S4), U66.13 (4I1)
D2_4: U65.4 (S1), U67.3 (1I1)
D2_5: U65.1 (S2), U67.6 (2I1)
D2_6: U65.13 (S3), U67.10 (3I1)
D2_7: U65.10 (S4), U67.13 (4I1)
D2_C4: U64.9 (COUT), U65.7 (CIN)
D2_C8: U65.9 (COUT), U78.5 (2B)
D3_0: U60.4 (S1), U62.3 (1I1)
D3_1: U60.1 (S2), U62.6 (2I1)
D3_2: U60.13 (S3), U62.10 (3I1)
D3_3: U60.10 (S4), U62.13 (4I1)
D3_4: U61.4 (S1), U63.3 (1I1)
D3_5: U61.1 (S2), U63.6 (2I1)
D3_6: U61.13 (S3), U63.10 (3I1)
D3_7: U61.10 (S4), U63.13 (4I1)
D3_C4: U60.9 (COUT), U61.7 (CIN)
D3_C8: U61.9 (COUT), U78.2 (1B)
D4_0: U56.4 (S1), U58.3 (1I1)
D4_1: U56.1 (S2), U58.6 (2I1)
D4_2: U56.13 (S3), U58.10 (3I1)
D4_3: U56.10 (S4), U58.13 (4I1)
D4_4: U57.4 (S1), U59.3 (1I1)
D4_5: U57.1 (S2), U59.6 (2I1)
D4_6: U57.13 (S3), U59.10 (3I1)
D4_7: U57.10 (S4), U59.13 (4I1)
D4_C4: U56.9 (COUT), U57.7 (CIN)
D4_C8: U57.9 (COUT), U77.13 (4B)
D5_0: U52.4 (S1), U54.3 (1I1)
D5_1: U52.1 (S2), U54.6 (2I1)
D5_2: U52.13 (S3), U54.10 (3I1)
D5_3: U52.10 (S4), U54.13 (4I1)
D5_4: U53.4 (S1), U55.3 (1I1)
D5_5: U53.1 (S2), U55.6 (2I1)
D5_6: U53.13 (S3), U55.10 (3I1)
D5_7: U53.10 (S4), U55.13 (4I1)
D5_C4: U52.9 (COUT), U53.7 (CIN)
D5_C8: U53.9 (COUT), U77.10 (3B)
D6_0: U48.4 (S1), U50.3 (1I1)
D6_1: U48.1 (S2), U50.6 (2I1)
D6_2: U48.13 (S3), U50.10 (3I1)
D6_3: U48.10 (S4), U50.13 (4I1)
D6_4: U49.4 (S1), U51.3 (1I1)
D6_5: U49.1 (S2), U51.6 (2I1)
D6_6: U49.13 (S3), U51.10 (3I1)
D6_7: U49.10 (S4), U51.13 (4I1)
D6_C4: U48.9 (COUT), U49.7 (CIN)
D6_C8: U49.9 (COUT), U77.5 (2B)
D7_0: U44.4 (S1), U46.3 (1I1)
D7_1: U44.1 (S2), U46.6 (2I1)
D7_2: U44.13 (S3), U46.10 (3I1)
D7_3: U44.10 (S4), U46.13 (4I1)
D7_4: U45.4 (S1), U47.3 (1I1)
D7_5: U45.1 (S2), U47.6 (2I1)
D7_6: U45.13 (S3), U47.10 (3I1)
D7_7: U45.10 (S4), U47.13 (4I1)
D7_C4: U44.9 (COUT), U45.7 (CIN)
D7_C8: U45.9 (COUT), U77.2 (1B)
GND: C45.2, C46.2, C47.2, C48.2, C49.2, C50.2, C51.2, C52.2, C53.2, C54.2, C55.2, C56.2, C57.2, C58.2, C59.2, C60.2, C61.2, C62.2, C63.2, C64.2, C65.2, C66.2, C67.2, C68.2, C69.2, C70.2, C71.2, C72.2, C73.2, C74.2, C75.2, C76.2, C77.2, C78.2, C79.2, C80.2, C81.2, C82.2, C83.2, U44.3 (A2), U44.8 (GND), U44.12 (A4), U44.14 (A3), U45.3 (A2), U45.5 (A1), U45.8 (GND), U45.12 (A4), U45.14 (A3), U46.5 (2I0), U46.8 (GND), U46.11 (3I0), U46.14 (4I0), U46.15 (~E), U47.2 (1I0), U47.5 (2I0), U47.8 (GND), U47.11 (3I0), U47.14 (4I0), U47.15 (~E), U48.8 (GND), U49.8 (GND), U50.8 (GND), U50.15 (~E), U51.8 (GND), U51.15 (~E), U52.8 (GND), U53.8 (GND), U54.8 (GND), U54.15 (~E), U55.8 (GND), U55.15 (~E), U56.8 (GND), U57.8 (GND), U58.8 (GND), U58.15 (~E), U59.8 (GND), U59.15 (~E), U60.8 (GND), U61.8 (GND), U62.8 (GND), U62.15 (~E), U63.8 (GND), U63.15 (~E), U64.8 (GND), U65.8 (GND), U66.8 (GND), U66.15 (~E), U67.8 (GND), U67.15 (~E), U68.8 (GND), U69.8 (GND), U70.8 (GND), U70.15 (~E), U71.8 (GND), U71.15 (~E), U72.8 (GND), U73.8 (GND), U74.8 (GND), U74.15 (~E), U75.8 (GND), U75.15 (~E), U76.4 (2A), U76.5 (2B), U76.7 (GND), U76.9 (3A), U76.10 (3B), U76.12 (4A), U76.13 (4B), U77.1 (1A), U77.7 (GND), U78.7 (GND), U79.4 (2A), U79.5 (2B), U79.7 (GND), U79.9 (3A), U79.10 (3B), U79.12 (4A), U79.13 (4B), U80.7 (GND), U81.7 (GND), U81.9 (4A), U81.11 (5A), U81.13 (6A), U82.7 (GND)
HATA: U76.3 (1Y)
K0: U74.4 (1Y)
K1: U74.7 (2Y)
K2: U74.9 (3Y)
K3: U74.12 (4Y)
K4: U75.4 (1Y)
K5: U75.7 (2Y)
K6: U75.9 (3Y)
K7: U75.12 (4Y)
KALAN_SONUK: U79.3 (1Y)
NB0: U44.6 (B1), U48.6 (B1), U52.6 (B1), U56.6 (B1), U60.6 (B1), U64.6 (B1), U68.6 (B1), U72.6 (B1), U80.2 (1Y), U82.1 (A)
NB1: U44.2 (B2), U48.2 (B2), U52.2 (B2), U56.2 (B2), U60.2 (B2), U64.2 (B2), U68.2 (B2), U72.2 (B2), U80.4 (2Y), U82.2 (B)
NB2: U44.15 (B3), U48.15 (B3), U52.15 (B3), U56.15 (B3), U60.15 (B3), U64.15 (B3), U68.15 (B3), U72.15 (B3), U80.6 (3Y), U82.3 (C)
NB3: U44.11 (B4), U48.11 (B4), U52.11 (B4), U56.11 (B4), U60.11 (B4), U64.11 (B4), U68.11 (B4), U72.11 (B4), U80.8 (4Y), U82.4 (D)
NB4: U45.6 (B1), U49.6 (B1), U53.6 (B1), U57.6 (B1), U61.6 (B1), U65.6 (B1), U69.6 (B1), U73.6 (B1), U80.10 (5Y), U82.5 (E)
NB5: U45.2 (B2), U49.2 (B2), U53.2 (B2), U57.2 (B2), U61.2 (B2), U65.2 (B2), U69.2 (B2), U73.2 (B2), U80.12 (6Y), U82.6 (F)
NB6: U45.15 (B3), U49.15 (B3), U53.15 (B3), U57.15 (B3), U61.15 (B3), U65.15 (B3), U69.15 (B3), U73.15 (B3), U81.2 (1Y), U82.11 (G)
NB7: U45.11 (B4), U49.11 (B4), U53.11 (B4), U57.11 (B4), U61.11 (B4), U65.11 (B4), U69.11 (B4), U73.11 (B4), U81.4 (2Y), U82.12 (H)
Q0: U74.1 (S), U75.1 (S), U78.11 (4Y)
Q1: U70.1 (S), U71.1 (S), U78.8 (3Y)
Q2: U66.1 (S), U67.1 (S), U78.6 (2Y)
Q3: U62.1 (S), U63.1 (S), U78.3 (1Y)
Q4: U58.1 (S), U59.1 (S), U77.11 (4Y)
Q5: U54.1 (S), U55.1 (S), U77.8 (3Y)
Q6: U50.1 (S), U51.1 (S), U77.6 (2Y)
Q7: U46.1 (S), U47.1 (S), U77.3 (1Y)
R1_0: U70.4 (1Y), U72.3 (A2), U74.5 (2I0)
R1_1: U70.7 (2Y), U72.14 (A3), U74.11 (3I0)
R1_2: U70.9 (3Y), U72.12 (A4), U74.14 (4I0)
R1_3: U70.12 (4Y), U73.5 (A1), U75.2 (1I0)
R1_4: U71.4 (1Y), U73.3 (A2), U75.5 (2I0)
R1_5: U71.7 (2Y), U73.14 (A3), U75.11 (3I0)
R1_6: U71.9 (3Y), U73.12 (A4), U75.14 (4I0)
R1_7: U71.12 (4Y), U78.12 (4A)
R2_0: U66.4 (1Y), U68.3 (A2), U70.5 (2I0)
R2_1: U66.7 (2Y), U68.14 (A3), U70.11 (3I0)
R2_2: U66.9 (3Y), U68.12 (A4), U70.14 (4I0)
R2_3: U66.12 (4Y), U69.5 (A1), U71.2 (1I0)
R2_4: U67.4 (1Y), U69.3 (A2), U71.5 (2I0)
R2_5: U67.7 (2Y), U69.14 (A3), U71.11 (3I0)
R2_6: U67.9 (3Y), U69.12 (A4), U71.14 (4I0)
R2_7: U67.12 (4Y), U78.9 (3A)
R3_0: U62.4 (1Y), U64.3 (A2), U66.5 (2I0)
R3_1: U62.7 (2Y), U64.14 (A3), U66.11 (3I0)
R3_2: U62.9 (3Y), U64.12 (A4), U66.14 (4I0)
R3_3: U62.12 (4Y), U65.5 (A1), U67.2 (1I0)
R3_4: U63.4 (1Y), U65.3 (A2), U67.5 (2I0)
R3_5: U63.7 (2Y), U65.14 (A3), U67.11 (3I0)
R3_6: U63.9 (3Y), U65.12 (A4), U67.14 (4I0)
R3_7: U63.12 (4Y), U78.4 (2A)
R4_0: U58.4 (1Y), U60.3 (A2), U62.5 (2I0)
R4_1: U58.7 (2Y), U60.14 (A3), U62.11 (3I0)
R4_2: U58.9 (3Y), U60.12 (A4), U62.14 (4I0)
R4_3: U58.12 (4Y), U61.5 (A1), U63.2 (1I0)
R4_4: U59.4 (1Y), U61.3 (A2), U63.5 (2I0)
R4_5: U59.7 (2Y), U61.14 (A3), U63.11 (3I0)
R4_6: U59.9 (3Y), U61.12 (A4), U63.14 (4I0)
R4_7: U59.12 (4Y), U78.1 (1A)
R5_0: U54.4 (1Y), U56.3 (A2), U58.5 (2I0)
R5_1: U54.7 (2Y), U56.14 (A3), U58.11 (3I0)
R5_2: U54.9 (3Y), U56.12 (A4), U58.14 (4I0)
R5_3: U54.12 (4Y), U57.5 (A1), U59.2 (1I0)
R5_4: U55.4 (1Y), U57.3 (A2), U59.5 (2I0)
R5_5: U55.7 (2Y), U57.14 (A3), U59.11 (3I0)
R5_6: U55.9 (3Y), U57.12 (A4), U59.14 (4I0)
R5_7: U55.12 (4Y), U77.12 (4A)
R6_0: U50.4 (1Y), U52.3 (A2), U54.5 (2I0)
R6_1: U50.7 (2Y), U52.14 (A3), U54.11 (3I0)
R6_2: U50.9 (3Y), U52.12 (A4), U54.14 (4I0)
R6_3: U50.12 (4Y), U53.5 (A1), U55.2 (1I0)
R6_4: U51.4 (1Y), U53.3 (A2), U55.5 (2I0)
R6_5: U51.7 (2Y), U53.14 (A3), U55.11 (3I0)
R6_6: U51.9 (3Y), U53.12 (A4), U55.14 (4I0)
R6_7: U51.12 (4Y), U77.9 (3A)
R7_0: U46.4 (1Y), U48.3 (A2), U50.5 (2I0)
R7_1: U46.7 (2Y), U48.14 (A3), U50.11 (3I0)
R7_2: U46.9 (3Y), U48.12 (A4), U50.14 (4I0)
R7_3: U46.12 (4Y), U49.5 (A1), U51.2 (1I0)
R7_4: U47.4 (1Y), U49.3 (A2), U51.5 (2I0)
R7_5: U47.7 (2Y), U49.14 (A3), U51.11 (3I0)
R7_6: U47.9 (3Y), U49.12 (A4), U51.14 (4I0)
R7_7: U47.12 (4Y), U77.4 (2A)
VCC: C45.1, C46.1, C47.1, C48.1, C49.1, C50.1, C51.1, C52.1, C53.1, C54.1, C55.1, C56.1, C57.1, C58.1, C59.1, C60.1, C61.1, C62.1, C63.1, C64.1, C65.1, C66.1, C67.1, C68.1, C69.1, C70.1, C71.1, C72.1, C73.1, C74.1, C75.1, C76.1, C77.1, C78.1, C79.1, C80.1, C81.1, C82.1, C83.1, U44.7 (CIN), U44.16 (VCC), U45.16 (VCC), U46.16 (VCC), U47.16 (VCC), U48.7 (CIN), U48.16 (VCC), U49.16 (VCC), U50.16 (VCC), U51.16 (VCC), U52.7 (CIN), U52.16 (VCC), U53.16 (VCC), U54.16 (VCC), U55.16 (VCC), U56.7 (CIN), U56.16 (VCC), U57.16 (VCC), U58.16 (VCC), U59.16 (VCC), U60.7 (CIN), U60.16 (VCC), U61.16 (VCC), U62.16 (VCC), U63.16 (VCC), U64.7 (CIN), U64.16 (VCC), U65.16 (VCC), U66.16 (VCC), U67.16 (VCC), U68.7 (CIN), U68.16 (VCC), U69.16 (VCC), U70.16 (VCC), U71.16 (VCC), U72.7 (CIN), U72.16 (VCC), U73.16 (VCC), U74.16 (VCC), U75.16 (VCC), U76.14 (VCC), U77.14 (VCC), U78.14 (VCC), U79.14 (VCC), U80.14 (VCC), U81.14 (VCC), U82.14 (VCC)
