MihrimatriX/breadboarding/cpu16/kicad/hesap/hesap-carpma.kicad_sch

## KiCad design cpu16/kicad/hesap/hesap-carpma.kicad_sch (2026-10-12)

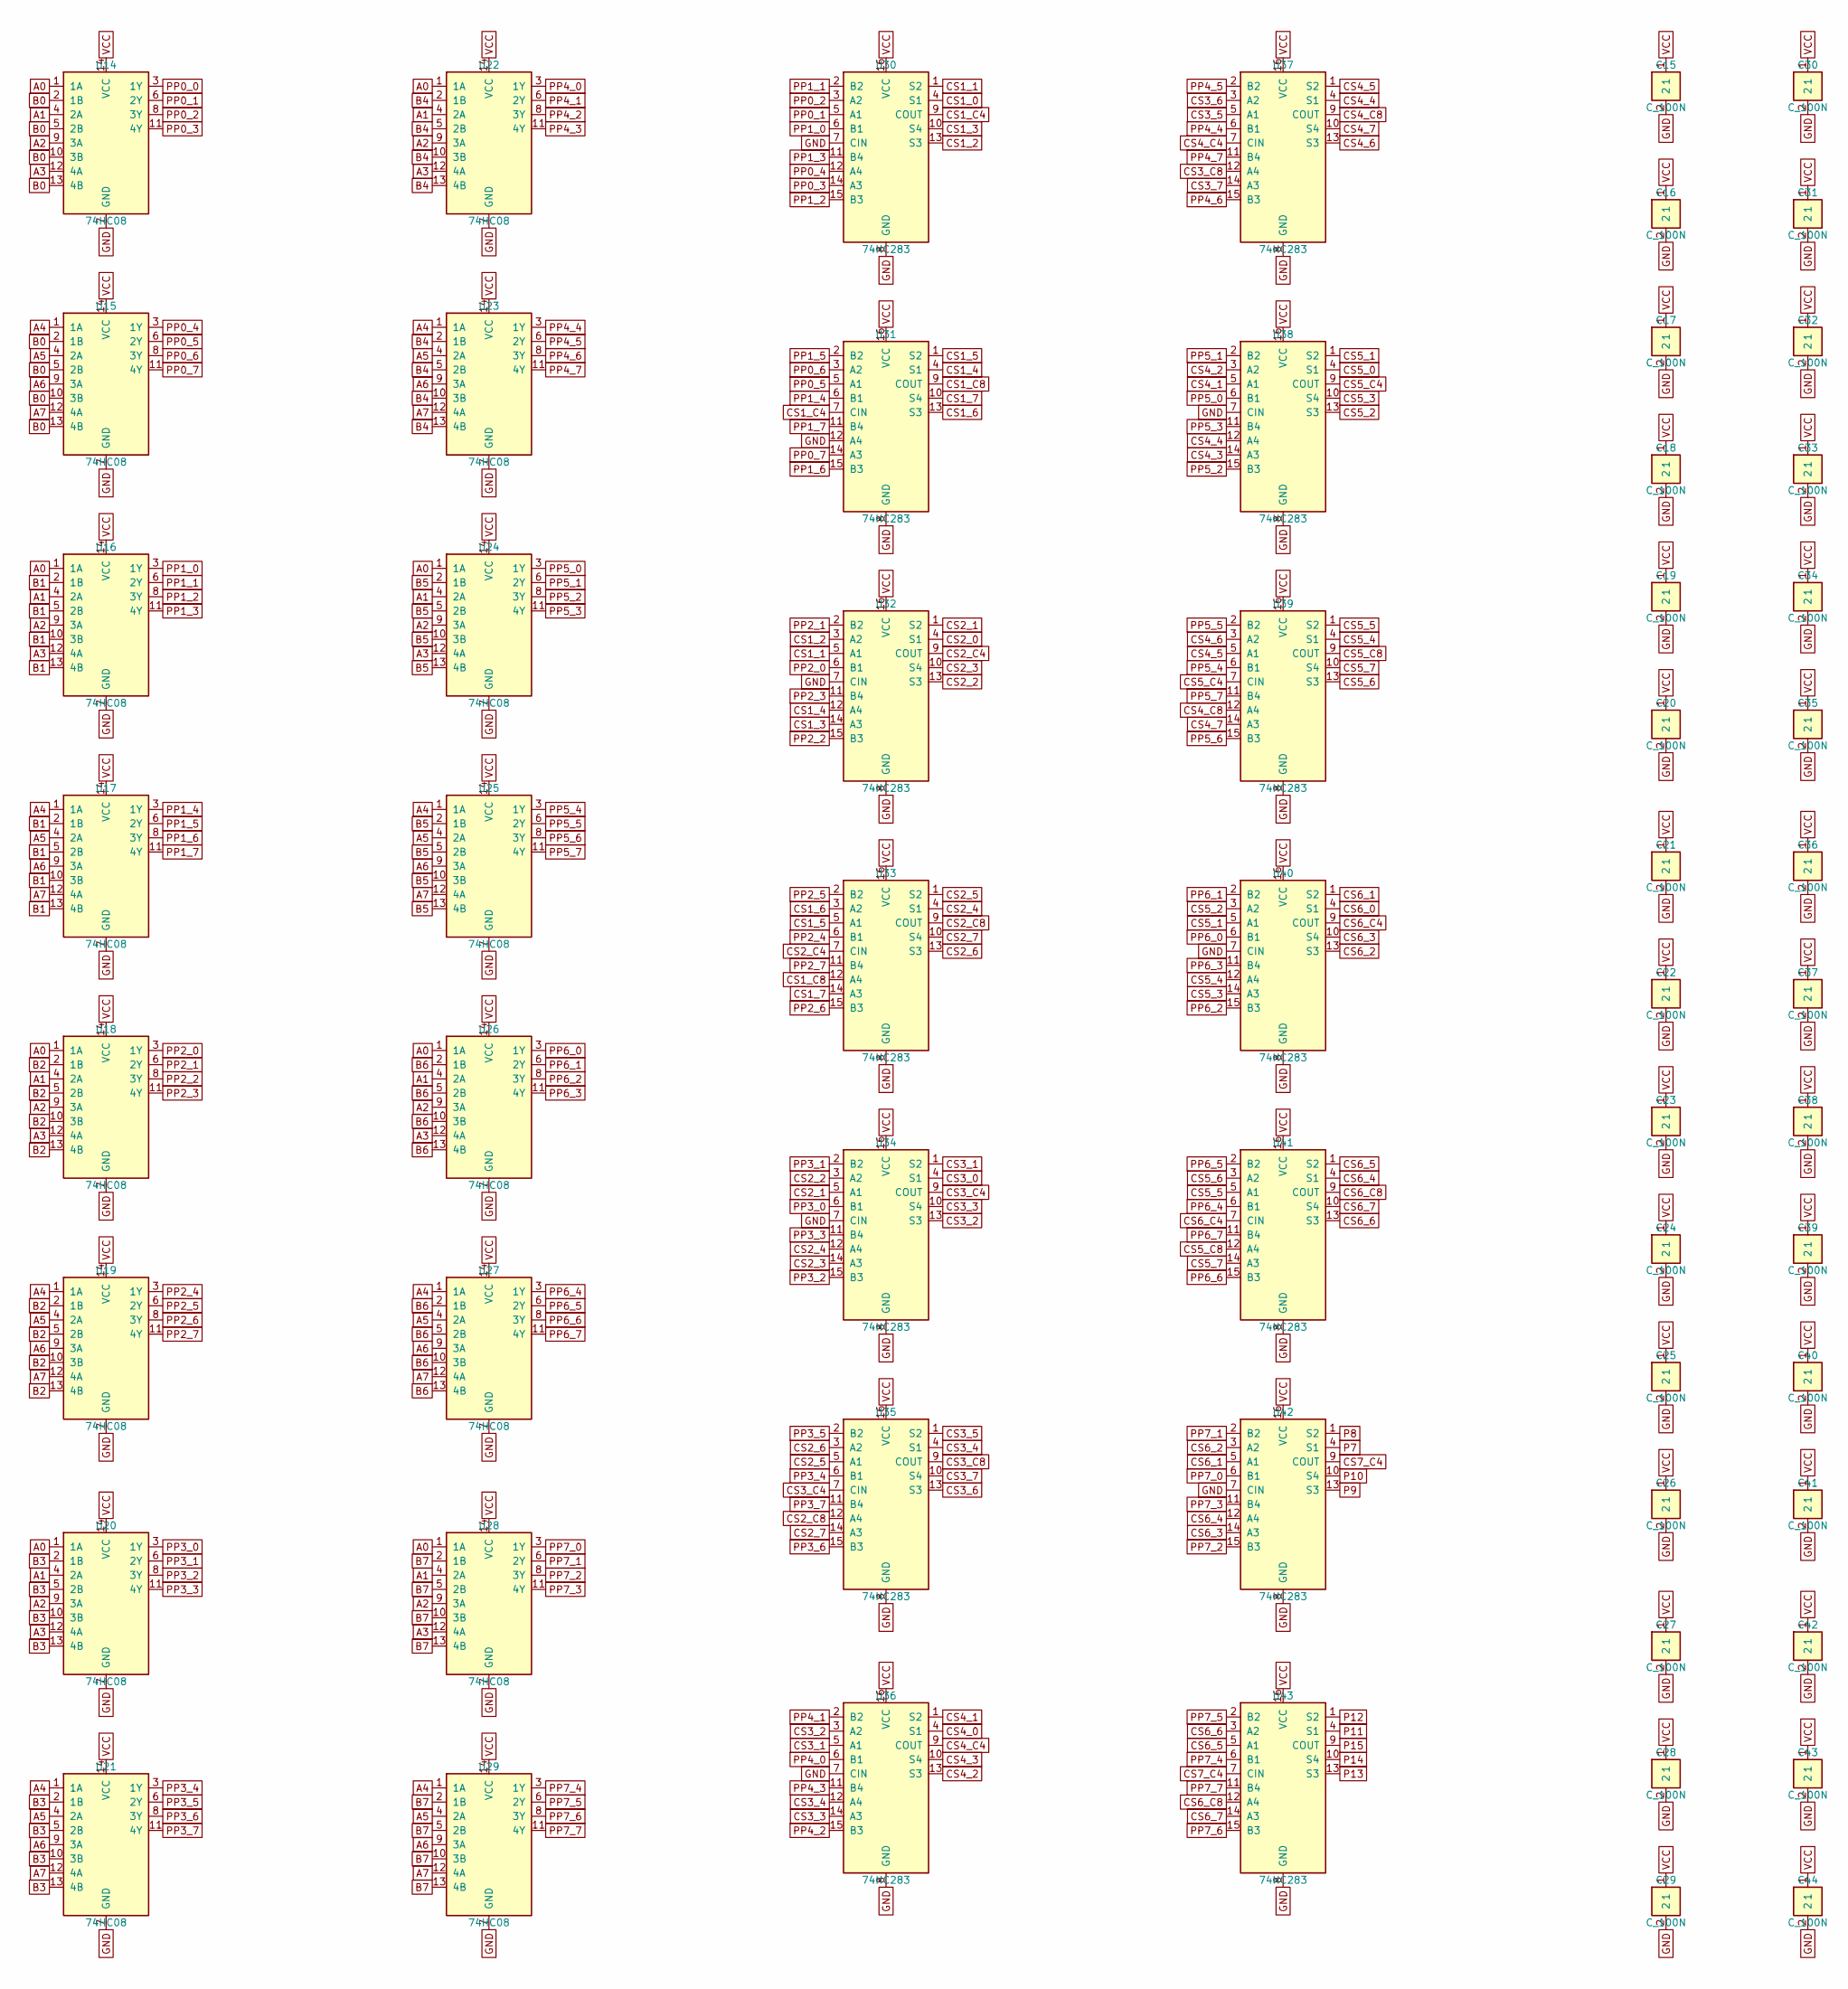
[picture p17: schematic hesap-carpma.kicad_sch]

Parts:
C15, C16, C17, C18, C19, C20, C21, C22, C23, C24, C25, C26, C27, C28, C29, C30, C31, C32, C33, C34, C35, C36, C37, C38, C39, C40, C41, C42, C43, C44: C_100N; C_Disc_D5.0mm_W2.5mm_P5.00mm
U14, U15, U16, U17, U18, U19, U20, U21, U22, U23, U24, U25, U26, U27, U28, U29: 74HC08; DIP-14_W7.62mm
U30, U31, U32, U33, U34, U35, U36, U37, U38, U39, U40, U41, U42, U43: 74HC283; DIP-16_W7.62mm

Connections:
A0: U14.1 (1A), U16.1 (1A), U18.1 (1A), U20.1 (1A), U22.1 (1A), U24.1 (1A), U26.1 (1A), U28.1 (1A)
A1: U14.4 (2A), U16.4 (2A), U18.4 (2A), U20.4 (2A), U22.4 (2A), U24.4 (2A), U26.4 (2A), U28.4 (2A)
A2: U14.9 (3A), U16.9 (3A), U18.9 (3A), U20.9 (3A), U22.9 (3A), U24.9 (3A), U26.9 (3A), U28.9 (3A)
A3: U14.12 (4A), U16.12 (4A), U18.12 (4A), U20.12 (4A), U22.12 (4A), U24.12 (4A), U26.12 (4A), U28.12 (4A)
A4: U15.1 (1A), U17.1 (1A), U19.1 (1A), U21.1 (1A), U23.1 (1A), U25.1 (1A), U27.1 (1A), U29.1 (1A)
A5: U15.4 (2A), U17.4 (2A), U19.4 (2A), U21.4 (2A), U23.4 (2A), U25.4 (2A), U27.4 (2A), U29.4 (2A)
A6: U15.9 (3A), U17.9 (3A), U19.9 (3A), U21.9 (3A), U23.9 (3A), U25.9 (3A), U27.9 (3A), U29.9 (3A)
A7: U15.12 (4A), U17.12 (4A), U19.12 (4A), U21.12 (4A), U23.12 (4A), U25.12 (4A), U27.12 (4A), U29.12 (4A)
B0: U14.2 (1B), U14.5 (2B), U14.10 (3B), U14.13 (4B), U15.2 (1B), U15.5 (2B), U15.10 (3B), U15.13 (4B)
B1: U16.2 (1B), U16.5 (2B), U16.10 (3B), U16.13 (4B), U17.2 (1B), U17.5 (2B), U17.10 (3B), U17.13 (4B)
B2: U18.2 (1B), U18.5 (2B), U18.10 (3B), U18.13 (4B), U19.2 (1B), U19.5 (2B), U19.10 (3B), U19.13 (4B)
B3: U20.2 (1B), U20.5 (2B), U20.10 (3B), U20.13 (4B), U21.2 (1B), U21.5 (2B), U21.10 (3B), U21.13 (4B)
B4: U22.2 (1B), U22.5 (2B), U22.10 (3B), U22.13 (4B), U23.2 (1B), U23.5 (2B), U23.10 (3B), U23.13 (4B)
B5: U24.2 (1B), U24.5 (2B), U24.10 (3B), U24.13 (4B), U25.2 (1B), U25.5 (2B), U25.10 (3B), U25.13 (4B)
B6: U26.2 (1B), U26.5 (2B), U26.10 (3B), U26.13 (4B), U27.2 (1B), U27.5 (2B), U27.10 (3B), U27.13 (4B)
B7: U28.2 (1B), U28.5 (2B), U28.10 (3B), U28.13 (4B), U29.2 (1B), U29.5 (2B), U29.10 (3B), U29.13 (4B)
CS1_0: U30.4 (S1)
CS1_1: U30.1 (S2), U32.5 (A1)
CS1_2: U30.13 (S3), U32.3 (A2)
CS1_3: U30.10 (S4), U32.14 (A3)
CS1_4: U31.4 (S1), U32.12 (A4)
CS1_5: U31.1 (S2), U33.5 (A1)
CS1_6: U31.13 (S3), U33.3 (A2)
CS1_7: U31.10 (S4), U33.14 (A3)
CS1_C4: U30.9 (COUT), U31.7 (CIN)
CS1_C8: U31.9 (COUT), U33.12 (A4)
CS2_0: U32.4 (S1)
CS2_1: U32.1 (S2), U34.5 (A1)
CS2_2: U32.13 (S3), U34.3 (A2)
CS2_3: U32.10 (S4), U34.14 (A3)
CS2_4: U33.4 (S1), U34.12 (A4)
CS2_5: U33.1 (S2), U35.5 (A1)
CS2_6: U33.13 (S3), U35.3 (A2)
CS2_7: U33.10 (S4), U35.14 (A3)
CS2_C4: U32.9 (COUT), U33.7 (CIN)
CS2_C8: U33.9 (COUT), U35.12 (A4)
CS3_0: U34.4 (S1)
CS3_1: U34.1 (S2), U36.5 (A1)
CS3_2: U34.13 (S3), U36.3 (A2)
CS3_3: U34.10 (S4), U36.14 (A3)
CS3_4: U35.4 (S1), U36.12 (A4)
CS3_5: U35.1 (S2), U37.5 (A1)
CS3_6: U35.13 (S3), U37.3 (A2)
CS3_7: U35.10 (S4), U37.14 (A3)
CS3_C4: U34.9 (COUT), U35.7 (CIN)
CS3_C8: U35.9 (COUT), U37.12 (A4)
CS4_0: U36.4 (S1)
CS4_1: U36.1 (S2), U38.5 (A1)
CS4_2: U36.13 (S3), U38.3 (A2)
CS4_3: U36.10 (S4), U38.14 (A3)
CS4_4: U37.4 (S1), U38.12 (A4)
CS4_5: U37.1 (S2), U39.5 (A1)
CS4_6: U37.13 (S3), U39.3 (A2)
CS4_7: U37.10 (S4), U39.14 (A3)
CS4_C4: U36.9 (COUT), U37.7 (CIN)
CS4_C8: U37.9 (COUT), U39.12 (A4)
CS5_0: U38.4 (S1)
CS5_1: U38.1 (S2), U40.5 (A1)
CS5_2: U38.13 (S3), U40.3 (A2)
CS5_3: U38.10 (S4), U40.14 (A3)
CS5_4: U39.4 (S1), U40.12 (A4)
CS5_5: U39.1 (S2), U41.5 (A1)
CS5_6: U39.13 (S3), U41.3 (A2)
CS5_7: U39.10 (S4), U41.14 (A3)
CS5_C4: U38.9 (COUT), U39.7 (CIN)
CS5_C8: U39.9 (COUT), U41.12 (A4)
CS6_0: U40.4 (S1)
CS6_1: U40.1 (S2), U42.5 (A1)
CS6_2: U40.13 (S3), U42.3 (A2)
CS6_3: U40.10 (S4), U42.14 (A3)
CS6_4: U41.4 (S1), U42.12 (A4)
CS6_5: U41.1 (S2), U43.5 (A1)
CS6_6: U41.13 (S3), U43.3 (A2)
CS6_7: U41.10 (S4), U43.14 (A3)
CS6_C4: U40.9 (COUT), U41.7 (CIN)
CS6_C8: U41.9 (COUT), U43.12 (A4)
CS7_C4: U42.9 (COUT), U43.7 (CIN)
GND: C15.2, C16.2, C17.2, C18.2, C19.2, C20.2, C21.2, C22.2, C23.2, C24.2, C25.2, C26.2, C27.2, C28.2, C29.2, C30.2, C31.2, C32.2, C33.2, C34.2, C35.2, C36.2, C37.2, C38.2, C39.2, C40.2, C41.2, C42.2, C43.2, C44.2, U14.7 (GND), U15.7 (GND), U16.7 (GND), U17.7 (GND), U18.7 (GND), U19.7 (GND), U20.7 (GND), U21.7 (GND), U22.7 (GND), U23.7 (GND), U24.7 (GND), U25.7 (GND), U26.7 (GND), U27.7 (GND), U28.7 (GND), U29.7 (GND), U30.7 (CIN), U30.8 (GND), U31.8 (GND), U31.12 (A4), U32.7 (CIN), U32.8 (GND), U33.8 (GND), U34.7 (CIN), U34.8 (GND), U35.8 (GND), U36.7 (CIN), U36.8 (GND), U37.8 (GND), U38.7 (CIN), U38.8 (GND), U39.8 (GND), U40.7 (CIN), U40.8 (GND), U41.8 (GND), U42.7 (CIN), U42.8 (GND), U43.8 (GND)
P7: U42.4 (S1)
P8: U42.1 (S2)
P9: U42.13 (S3)
P10: U42.10 (S4)
P11: U43.4 (S1)
P12: U43.1 (S2)
P13: U43.13 (S3)
P14: U43.10 (S4)
P15: U43.9 (COUT)
PP0_0: U14.3 (1Y)
PP0_1: U14.6 (2Y), U30.5 (A1)
PP0_2: U14.8 (3Y), U30.3 (A2)
PP0_3: U14.11 (4Y), U30.14 (A3)
PP0_4: U15.3 (1Y), U30.12 (A4)
PP0_5: U15.6 (2Y), U31.5 (A1)
PP0_6: U15.8 (3Y), U31.3 (A2)
PP0_7: U15.11 (4Y), U31.14 (A3)
PP1_0: U16.3 (1Y), U30.6 (B1)
PP1_1: U16.6 (2Y), U30.2 (B2)
PP1_2: U16.8 (3Y), U30.15 (B3)
PP1_3: U16.11 (4Y), U30.11 (B4)
PP1_4: U17.3 (1Y), U31.6 (B1)
PP1_5: U17.6 (2Y), U31.2 (B2)
PP1_6: U17.8 (3Y), U31.15 (B3)
PP1_7: U17.11 (4Y), U31.11 (B4)
PP2_0: U18.3 (1Y), U32.6 (B1)
PP2_1: U18.6 (2Y), U32.2 (B2)
PP2_2: U18.8 (3Y), U32.15 (B3)
PP2_3: U18.11 (4Y), U32.11 (B4)
PP2_4: U19.3 (1Y), U33.6 (B1)
PP2_5: U19.6 (2Y), U33.2 (B2)
PP2_6: U19.8 (3Y), U33.15 (B3)
PP2_7: U19.11 (4Y), U33.11 (B4)
PP3_0: U20.3 (1Y), U34.6 (B1)
PP3_1: U20.6 (2Y), U34.2 (B2)
PP3_2: U20.8 (3Y), U34.15 (B3)
PP3_3: U20.11 (4Y), U34.11 (B4)
PP3_4: U21.3 (1Y), U35.6 (B1)
PP3_5: U21.6 (2Y), U35.2 (B2)
PP3_6: U21.8 (3Y), U35.15 (B3)
PP3_7: U21.11 (4Y), U35.11 (B4)
PP4_0: U22.3 (1Y), U36.6 (B1)
PP4_1: U22.6 (2Y), U36.2 (B2)
PP4_2: U22.8 (3Y), U36.15 (B3)
PP4_3: U22.11 (4Y), U36.11 (B4)
PP4_4: U23.3 (1Y), U37.6 (B1)
PP4_5: U23.6 (2Y), U37.2 (B2)
PP4_6: U23.8 (3Y), U37.15 (B3)
PP4_7: U23.11 (4Y), U37.11 (B4)
PP5_0: U24.3 (1Y), U38.6 (B1)
PP5_1: U24.6 (2Y), U38.2 (B2)
PP5_2: U24.8 (3Y), U38.15 (B3)
PP5_3: U24.11 (4Y), U38.11 (B4)
PP5_4: U25.3 (1Y), U39.6 (B1)
PP5_5: U25.6 (2Y), U39.2 (B2)
PP5_6: U25.8 (3Y), U39.15 (B3)
PP5_7: U25.11 (4Y), U39.11 (B4)
PP6_0: U26.3 (1Y), U40.6 (B1)
PP6_1: U26.6 (2Y), U40.2 (B2)
PP6_2: U26.8 (3Y), U40.15 (B3)
PP6_3: U26.11 (4Y), U40.11 (B4)
PP6_4: U27.3 (1Y), U41.6 (B1)
PP6_5: U27.6 (2Y), U41.2 (B2)
PP6_6: U27.8 (3Y), U41.15 (B3)
PP6_7: U27.11 (4Y), U41.11 (B4)
PP7_0: U28.3 (1Y), U42.6 (B1)
PP7_1: U28.6 (2Y), U42.2 (B2)
PP7_2: U28.8 (3Y), U42.15 (B3)
PP7_3: U28.11 (4Y), U42.11 (B4)
PP7_4: U29.3 (1Y), U43.6 (B1)
PP7_5: U29.6 (2Y), U43.2 (B2)
PP7_6: U29.8 (3Y), U43.15 (B3)
PP7_7: U29.11 (4Y), U43.11 (B4)
VCC: C15.1, C16.1, C17.1, C18.1, C19.1, C20.1, C21.1, C22.1, C23.1, C24.1, C25.1, C26.1, C27.1, C28.1, C29.1, C30.1, C31.1, C32.1, C33.1, C34.1, C35.1, C36.1, C37.1, C38.1, C39.1, C40.1, C41.1, C42.1, C43.1, C44.1, U14.14 (VCC), U15.14 (VCC), U16.14 (VCC), U17.14 (VCC), U18.14 (VCC), U19.14 (VCC), U20.14 (VCC), U21.14 (VCC), U22.14 (VCC), U23.14 (VCC), U24.14 (VCC), U25.14 (VCC), U26.14 (VCC), U27.14 (VCC), U28.14 (VCC), U29.14 (VCC), U30.16 (VCC), U31.16 (VCC), U32.16 (VCC), U33.16 (VCC), U34.16 (VCC), U35.16 (VCC), U36.16 (VCC), U37.16 (VCC), U38.16 (VCC), U39.16 (VCC), U40.16 (VCC), U41.16 (VCC), U42.16 (VCC), U43.16 (VCC)
