MihrimatriX/breadboarding/cpu16/kicad/hesap/hesap-gosterge-ab.kicad_sch

## KiCad design cpu16/kicad/hesap/hesap-gosterge-ab.kicad_sch (2026-10-12)

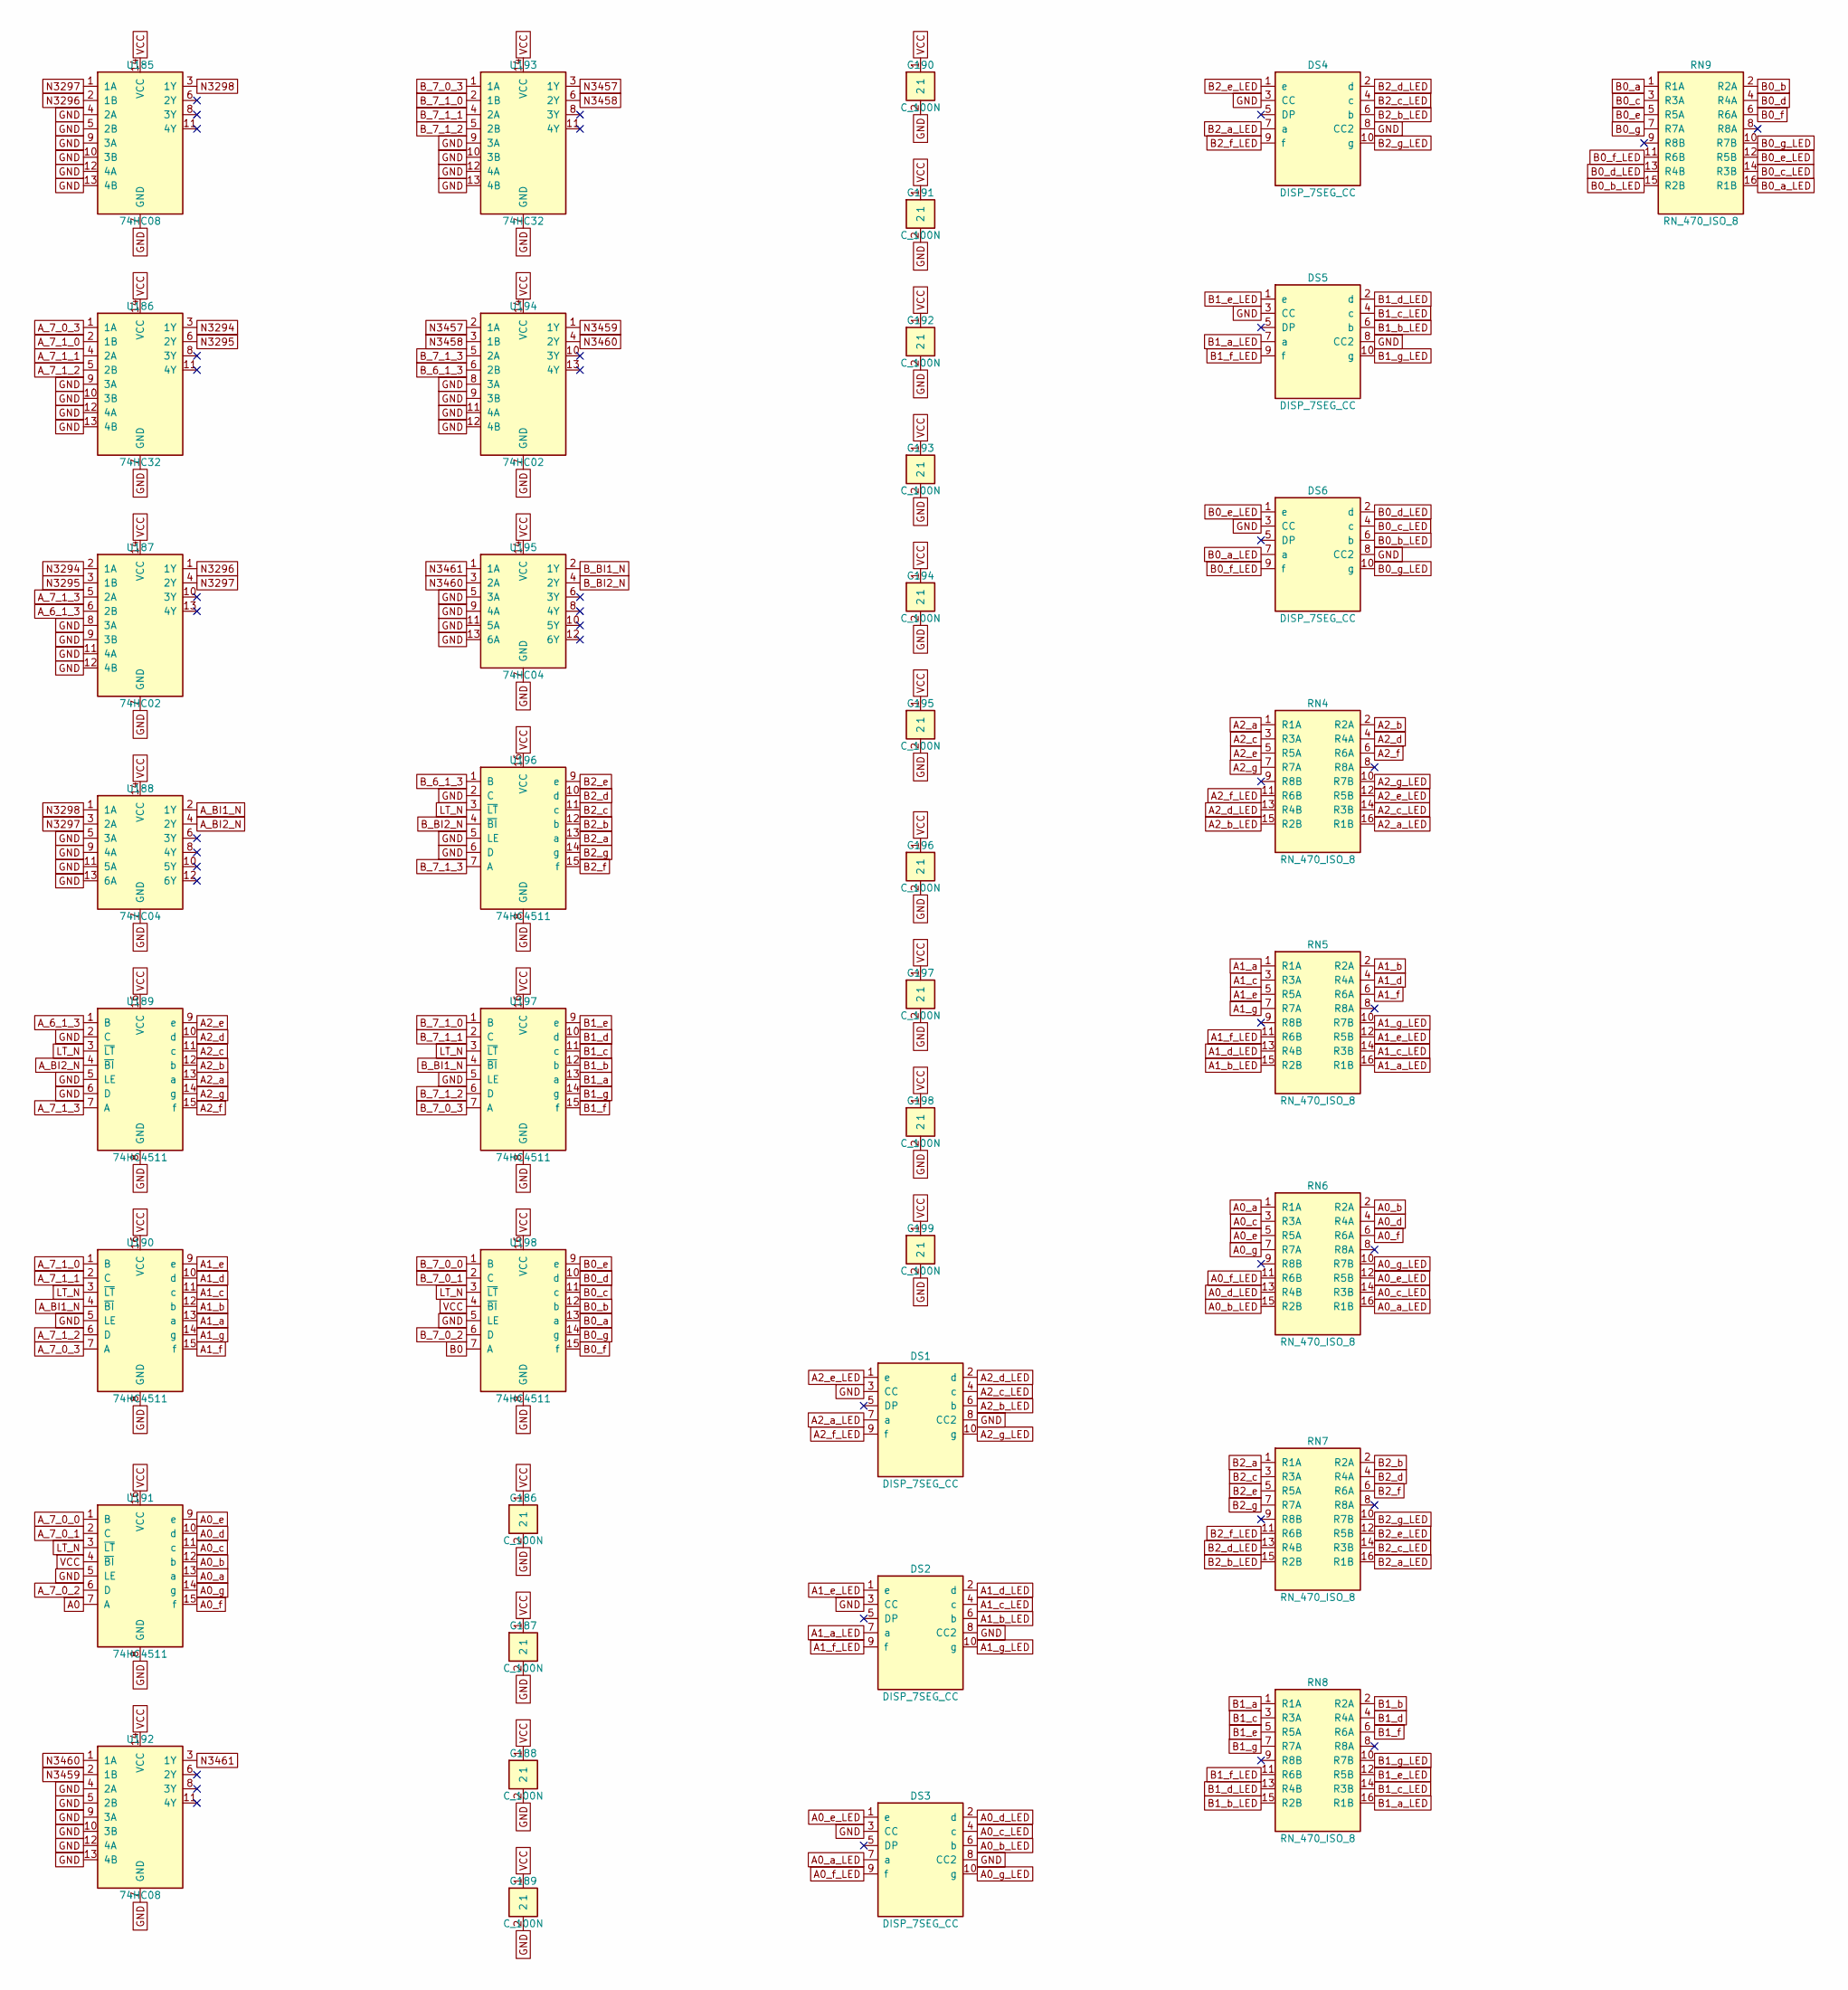
[picture p18: schematic hesap-gosterge-ab.kicad_sch]

Parts:
C186, C187, C188, C189, C190, C191, C192, C193, C194, C195, C196, C197, C198, C199: C_100N; C_Disc_D5.0mm_W2.5mm_P5.00mm
DS1, DS2, DS3, DS4, DS5, DS6: DISP_7SEG_CC; 7SegmentLED_LTS6760_LTS6780
RN4, RN5, RN6, RN7, RN8, RN9: RN_470_ISO_8; DIP-16_W7.62mm
U185, U192: 74HC08; DIP-14_W7.62mm
U186, U193: 74HC32; DIP-14_W7.62mm
U187, U194: 74HC02; DIP-14_W7.62mm
U188, U195: 74HC04; DIP-14_W7.62mm
U189, U190, U191, U196, U197, U198: 74HC4511; DIP-16_W7.62mm

Connections:
A0: U191.7 (A)
A0_a: RN6.1 (R1A), U191.13 (a)
A0_a_LED: DS3.7 (a), RN6.16 (R1B)
A0_b: RN6.2 (R2A), U191.12 (b)
A0_b_LED: DS3.6 (b), RN6.15 (R2B)
A0_c: RN6.3 (R3A), U191.11 (c)
A0_c_LED: DS3.4 (c), RN6.14 (R3B)
A0_d: RN6.4 (R4A), U191.10 (d)
A0_d_LED: DS3.2 (d), RN6.13 (R4B)
A0_e: RN6.5 (R5A), U191.9 (e)
A0_e_LED: DS3.1 (e), RN6.12 (R5B)
A0_f: RN6.6 (R6A), U191.15 (f)
A0_f_LED: DS3.9 (f), RN6.11 (R6B)
A0_g: RN6.7 (R7A), U191.14 (g)
A0_g_LED: DS3.10 (g), RN6.10 (R7B)
A1_a: RN5.1 (R1A), U190.13 (a)
A1_a_LED: DS2.7 (a), RN5.16 (R1B)
A1_b: RN5.2 (R2A), U190.12 (b)
A1_b_LED: DS2.6 (b), RN5.15 (R2B)
A1_c: RN5.3 (R3A), U190.11 (c)
A1_c_LED: DS2.4 (c), RN5.14 (R3B)
A1_d: RN5.4 (R4A), U190.10 (d)
A1_d_LED: DS2.2 (d), RN5.13 (R4B)
A1_e: RN5.5 (R5A), U190.9 (e)
A1_e_LED: DS2.1 (e), RN5.12 (R5B)
A1_f: RN5.6 (R6A), U190.15 (f)
A1_f_LED: DS2.9 (f), RN5.11 (R6B)
A1_g: RN5.7 (R7A), U190.14 (g)
A1_g_LED: DS2.10 (g), RN5.10 (R7B)
A2_a: RN4.1 (R1A), U189.13 (a)
A2_a_LED: DS1.7 (a), RN4.16 (R1B)
A2_b: RN4.2 (R2A), U189.12 (b)
A2_b_LED: DS1.6 (b), RN4.15 (R2B)
A2_c: RN4.3 (R3A), U189.11 (c)
A2_c_LED: DS1.4 (c), RN4.14 (R3B)
A2_d: RN4.4 (R4A), U189.10 (d)
A2_d_LED: DS1.2 (d), RN4.13 (R4B)
A2_e: RN4.5 (R5A), U189.9 (e)
A2_e_LED: DS1.1 (e), RN4.12 (R5B)
A2_f: RN4.6 (R6A), U189.15 (f)
A2_f_LED: DS1.9 (f), RN4.11 (R6B)
A2_g: RN4.7 (R7A), U189.14 (g)
A2_g_LED: DS1.10 (g), RN4.10 (R7B)
A_6_1_3: U187.6 (2B), U189.1 (B)
A_7_0_0: U191.1 (B)
A_7_0_1: U191.2 (C)
A_7_0_2: U191.6 (D)
A_7_0_3: U186.1 (1A), U190.7 (A)
A_7_1_0: U186.2 (1B), U190.1 (B)
A_7_1_1: U186.4 (2A), U190.2 (C)
A_7_1_2: U186.5 (2B), U190.6 (D)
A_7_1_3: U187.5 (2A), U189.7 (A)
A_BI1_N: U188.2 (1Y), U190.4 (~BI)
A_BI2_N: U188.4 (2Y), U189.4 (~BI)
B0: U198.7 (A)
B0_a: RN9.1 (R1A), U198.13 (a)
B0_a_LED: DS6.7 (a), RN9.16 (R1B)
B0_b: RN9.2 (R2A), U198.12 (b)
B0_b_LED: DS6.6 (b), RN9.15 (R2B)
B0_c: RN9.3 (R3A), U198.11 (c)
B0_c_LED: DS6.4 (c), RN9.14 (R3B)
B0_d: RN9.4 (R4A), U198.10 (d)
B0_d_LED: DS6.2 (d), RN9.13 (R4B)
B0_e: RN9.5 (R5A), U198.9 (e)
B0_e_LED: DS6.1 (e), RN9.12 (R5B)
B0_f: RN9.6 (R6A), U198.15 (f)
B0_f_LED: DS6.9 (f), RN9.11 (R6B)
B0_g: RN9.7 (R7A), U198.14 (g)
B0_g_LED: DS6.10 (g), RN9.10 (R7B)
B1_a: RN8.1 (R1A), U197.13 (a)
B1_a_LED: DS5.7 (a), RN8.16 (R1B)
B1_b: RN8.2 (R2A), U197.12 (b)
B1_b_LED: DS5.6 (b), RN8.15 (R2B)
B1_c: RN8.3 (R3A), U197.11 (c)
B1_c_LED: DS5.4 (c), RN8.14 (R3B)
B1_d: RN8.4 (R4A), U197.10 (d)
B1_d_LED: DS5.2 (d), RN8.13 (R4B)
B1_e: RN8.5 (R5A), U197.9 (e)
B1_e_LED: DS5.1 (e), RN8.12 (R5B)
B1_f: RN8.6 (R6A), U197.15 (f)
B1_f_LED: DS5.9 (f), RN8.11 (R6B)
B1_g: RN8.7 (R7A), U197.14 (g)
B1_g_LED: DS5.10 (g), RN8.10 (R7B)
B2_a: RN7.1 (R1A), U196.13 (a)
B2_a_LED: DS4.7 (a), RN7.16 (R1B)
B2_b: RN7.2 (R2A), U196.12 (b)
B2_b_LED: DS4.6 (b), RN7.15 (R2B)
B2_c: RN7.3 (R3A), U196.11 (c)
B2_c_LED: DS4.4 (c), RN7.14 (R3B)
B2_d: RN7.4 (R4A), U196.10 (d)
B2_d_LED: DS4.2 (d), RN7.13 (R4B)
B2_e: RN7.5 (R5A), U196.9 (e)
B2_e_LED: DS4.1 (e), RN7.12 (R5B)
B2_f: RN7.6 (R6A), U196.15 (f)
B2_f_LED: DS4.9 (f), RN7.11 (R6B)
B2_g: RN7.7 (R7A), U196.14 (g)
B2_g_LED: DS4.10 (g), RN7.10 (R7B)
B_6_1_3: U194.6 (2B), U196.1 (B)
B_7_0_0: U198.1 (B)
B_7_0_1: U198.2 (C)
B_7_0_2: U198.6 (D)
B_7_0_3: U193.1 (1A), U197.7 (A)
B_7_1_0: U193.2 (1B), U197.1 (B)
B_7_1_1: U193.4 (2A), U197.2 (C)
B_7_1_2: U193.5 (2B), U197.6 (D)
B_7_1_3: U194.5 (2A), U196.7 (A)
B_BI1_N: U195.2 (1Y), U197.4 (~BI)
B_BI2_N: U195.4 (2Y), U196.4 (~BI)
GND: C186.2, C187.2, C188.2, C189.2, C190.2, C191.2, C192.2, C193.2, C194.2, C195.2, C196.2, C197.2, C198.2, C199.2, DS1.3 (CC), DS1.8 (CC2), DS2.3 (CC), DS2.8 (CC2), DS3.3 (CC), DS3.8 (CC2), DS4.3 (CC), DS4.8 (CC2), DS5.3 (CC), DS5.8 (CC2), DS6.3 (CC), DS6.8 (CC2), U185.4 (2A), U185.5 (2B), U185.7 (GND), U185.9 (3A), U185.10 (3B), U185.12 (4A), U185.13 (4B), U186.7 (GND), U186.9 (3A), U186.10 (3B), U186.12 (4A), U186.13 (4B), U187.7 (GND), U187.8 (3A), U187.9 (3B), U187.11 (4A), U187.12 (4B), U188.5 (3A), U188.7 (GND), U188.9 (4A), U188.11 (5A), U188.13 (6A), U189.2 (C), U189.5 (LE), U189.6 (D), U189.8 (GND), U190.5 (LE), U190.8 (GND), U191.5 (LE), U191.8 (GND), U192.4 (2A), U192.5 (2B), U192.7 (GND), U192.9 (3A), U192.10 (3B), U192.12 (4A), U192.13 (4B), U193.7 (GND), U193.9 (3A), U193.10 (3B), U193.12 (4A), U193.13 (4B), U194.7 (GND), U194.8 (3A), U194.9 (3B), U194.11 (4A), U194.12 (4B), U195.5 (3A), U195.7 (GND), U195.9 (4A), U195.11 (5A), U195.13 (6A), U196.2 (C), U196.5 (LE), U196.6 (D), U196.8 (GND), U197.5 (LE), U197.8 (GND), U198.5 (LE), U198.8 (GND)
LT_N: U189.3 (~LT), U190.3 (~LT), U191.3 (~LT), U196.3 (~LT), U197.3 (~LT), U198.3 (~LT)
N3294: U186.3 (1Y), U187.2 (1A)
N3295: U186.6 (2Y), U187.3 (1B)
N3296: U185.2 (1B), U187.1 (1Y)
N3297: U185.1 (1A), U187.4 (2Y), U188.3 (2A)
N3298: U185.3 (1Y), U188.1 (1A)
N3457: U193.3 (1Y), U194.2 (1A)
N3458: U193.6 (2Y), U194.3 (1B)
N3459: U192.2 (1B), U194.1 (1Y)
N3460: U192.1 (1A), U194.4 (2Y), U195.3 (2A)
N3461: U192.3 (1Y), U195.1 (1A)
VCC: C186.1, C187.1, C188.1, C189.1, C190.1, C191.1, C192.1, C193.1, C194.1, C195.1, C196.1, C197.1, C198.1, C199.1, U185.14 (VCC), U186.14 (VCC), U187.14 (VCC), U188.14 (VCC), U189.16 (VCC), U190.16 (VCC), U191.4 (~BI), U191.16 (VCC), U192.14 (VCC), U193.14 (VCC), U194.14 (VCC), U195.14 (VCC), U196.16 (VCC), U197.16 (VCC), U198.4 (~BI), U198.16 (VCC)
