MihrimatriX/breadboarding/cpu16/kicad/hesap/hesap-gosterge-sonuc.kicad_sch

## KiCad design cpu16/kicad/hesap/hesap-gosterge-sonuc.kicad_sch (2026-10-12)

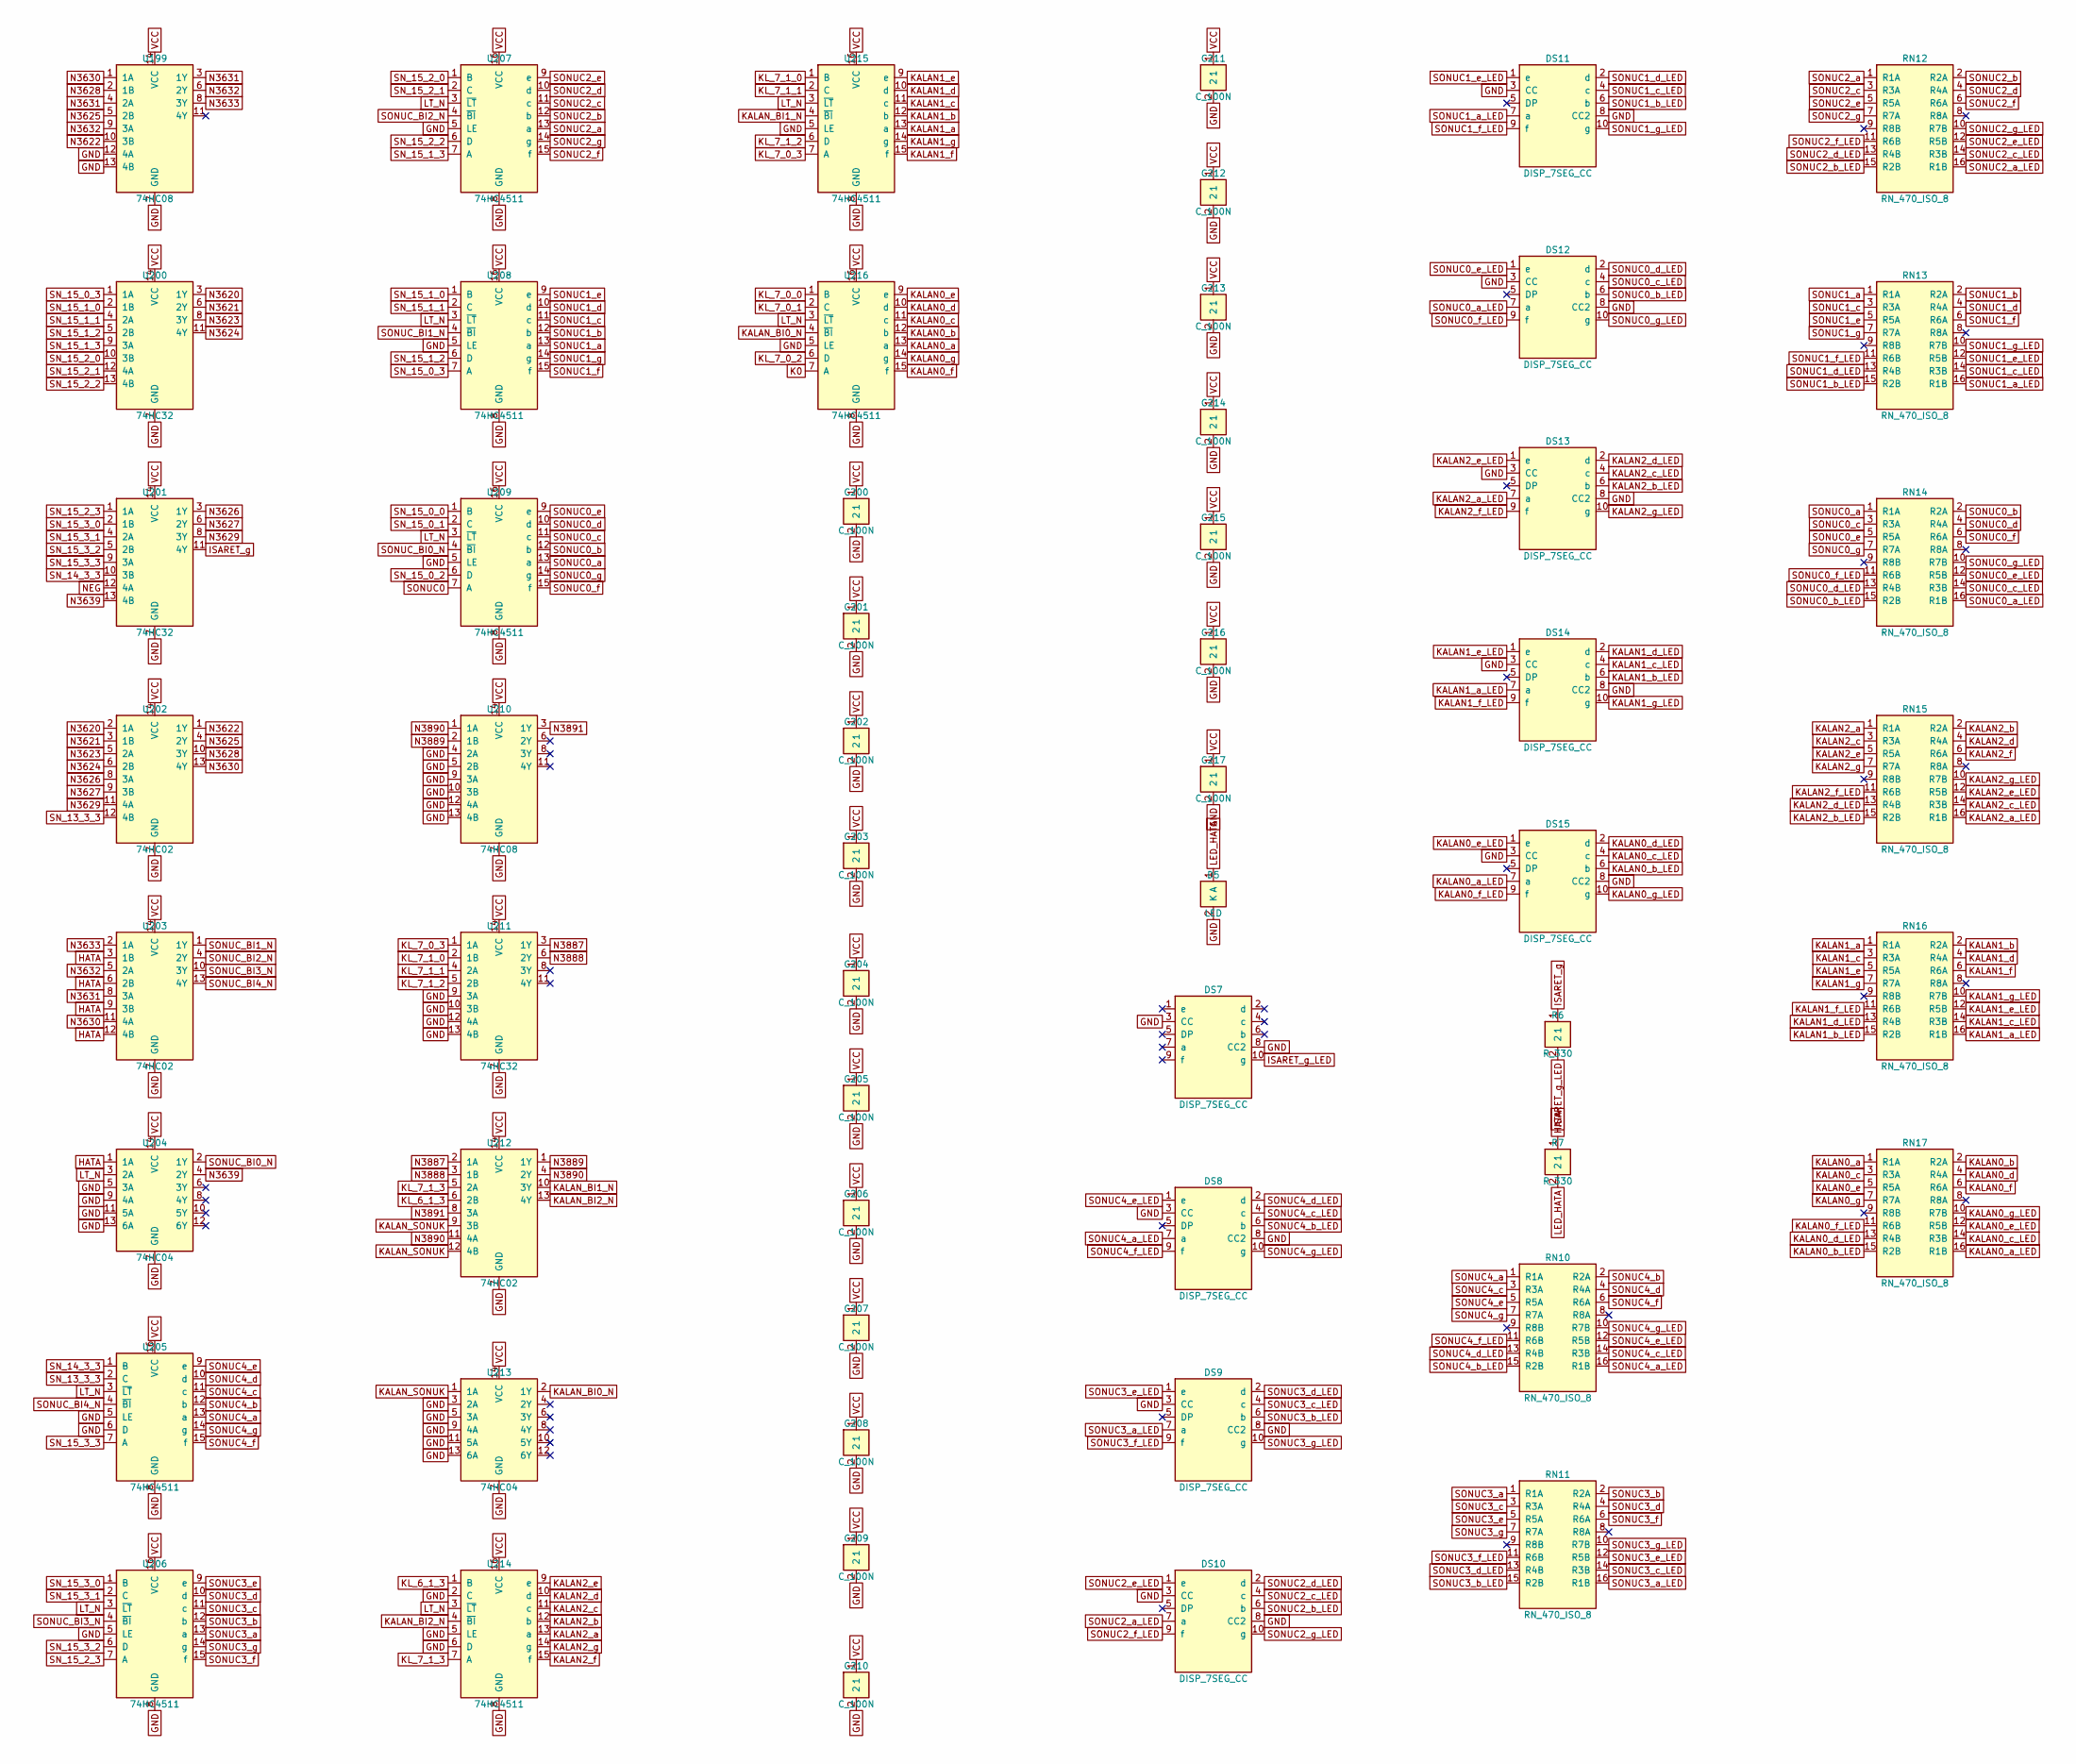
[picture p19: schematic hesap-gosterge-sonuc.kicad_sch]

Parts:
C200, C201, C202, C203, C204, C205, C206, C207, C208, C209, C210, C211, C212, C213, C214, C215, C216, C217: C_100N; C_Disc_D5.0mm_W2.5mm_P5.00mm
D5: LED; LED_D3.0mm
DS7, DS8, DS9, DS10, DS11, DS12, DS13, DS14, DS15: DISP_7SEG_CC; 7SegmentLED_LTS6760_LTS6780
R6, R7: R_330; R_Axial_DIN0207_L6.3mm_D2.5mm_P7.62mm_Horizontal
RN10, RN11, RN12, RN13, RN14, RN15, RN16, RN17: RN_470_ISO_8; DIP-16_W7.62mm
U199, U210: 74HC08; DIP-14_W7.62mm
U200, U201, U211: 74HC32; DIP-14_W7.62mm
U202, U203, U212: 74HC02; DIP-14_W7.62mm
U204, U213: 74HC04; DIP-14_W7.62mm
U205, U206, U207, U208, U209, U214, U215, U216: 74HC4511; DIP-16_W7.62mm

Connections:
GND: C200.2, C201.2, C202.2, C203.2, C204.2, C205.2, C206.2, C207.2, C208.2, C209.2, C210.2, C211.2, C212.2, C213.2, C214.2, C215.2, C216.2, C217.2, D5.2 (K), DS7.3 (CC), DS7.8 (CC2), DS8.3 (CC), DS8.8 (CC2), DS9.3 (CC), DS9.8 (CC2), DS10.3 (CC), DS10.8 (CC2), DS11.3 (CC), DS11.8 (CC2), DS12.3 (CC), DS12.8 (CC2), DS13.3 (CC), DS13.8 (CC2), DS14.3 (CC), DS14.8 (CC2), DS15.3 (CC), DS15.8 (CC2), U199.7 (GND), U199.12 (4A), U199.13 (4B), U200.7 (GND), U201.7 (GND), U202.7 (GND), U203.7 (GND), U204.5 (3A), U204.7 (GND), U204.9 (4A), U204.11 (5A), U204.13 (6A), U205.5 (LE), U205.6 (D), U205.8 (GND), U206.5 (LE), U206.8 (GND), U207.5 (LE), U207.8 (GND), U208.5 (LE), U208.8 (GND), U209.5 (LE), U209.8 (GND), U210.4 (2A), U210.5 (2B), U210.7 (GND), U210.9 (3A), U210.10 (3B), U210.12 (4A), U210.13 (4B), U211.7 (GND), U211.9 (3A), U211.10 (3B), U211.12 (4A), U211.13 (4B), U212.7 (GND), U213.3 (2A), U213.5 (3A), U213.7 (GND), U213.9 (4A), U213.11 (5A), U213.13 (6A), U214.2 (C), U214.5 (LE), U214.6 (D), U214.8 (GND), U215.5 (LE), U215.8 (GND), U216.5 (LE), U216.8 (GND)
HATA: R7.1, U203.3 (1B), U203.6 (2B), U203.9 (3B), U203.12 (4B), U204.1 (1A)
ISARET_g: R6.1, U201.11 (4Y)
ISARET_g_LED: DS7.10 (g), R6.2
K0: U216.7 (A)
KALAN0_a: RN17.1 (R1A), U216.13 (a)
KALAN0_a_LED: DS15.7 (a), RN17.16 (R1B)
KALAN0_b: RN17.2 (R2A), U216.12 (b)
KALAN0_b_LED: DS15.6 (b), RN17.15 (R2B)
KALAN0_c: RN17.3 (R3A), U216.11 (c)
KALAN0_c_LED: DS15.4 (c), RN17.14 (R3B)
KALAN0_d: RN17.4 (R4A), U216.10 (d)
KALAN0_d_LED: DS15.2 (d), RN17.13 (R4B)
KALAN0_e: RN17.5 (R5A), U216.9 (e)
KALAN0_e_LED: DS15.1 (e), RN17.12 (R5B)
KALAN0_f: RN17.6 (R6A), U216.15 (f)
KALAN0_f_LED: DS15.9 (f), RN17.11 (R6B)
KALAN0_g: RN17.7 (R7A), U216.14 (g)
KALAN0_g_LED: DS15.10 (g), RN17.10 (R7B)
KALAN1_a: RN16.1 (R1A), U215.13 (a)
KALAN1_a_LED: DS14.7 (a), RN16.16 (R1B)
KALAN1_b: RN16.2 (R2A), U215.12 (b)
KALAN1_b_LED: DS14.6 (b), RN16.15 (R2B)
KALAN1_c: RN16.3 (R3A), U215.11 (c)
KALAN1_c_LED: DS14.4 (c), RN16.14 (R3B)
KALAN1_d: RN16.4 (R4A), U215.10 (d)
KALAN1_d_LED: DS14.2 (d), RN16.13 (R4B)
KALAN1_e: RN16.5 (R5A), U215.9 (e)
KALAN1_e_LED: DS14.1 (e), RN16.12 (R5B)
KALAN1_f: RN16.6 (R6A), U215.15 (f)
KALAN1_f_LED: DS14.9 (f), RN16.11 (R6B)
KALAN1_g: RN16.7 (R7A), U215.14 (g)
KALAN1_g_LED: DS14.10 (g), RN16.10 (R7B)
KALAN2_a: RN15.1 (R1A), U214.13 (a)
KALAN2_a_LED: DS13.7 (a), RN15.16 (R1B)
KALAN2_b: RN15.2 (R2A), U214.12 (b)
KALAN2_b_LED: DS13.6 (b), RN15.15 (R2B)
KALAN2_c: RN15.3 (R3A), U214.11 (c)
KALAN2_c_LED: DS13.4 (c), RN15.14 (R3B)
KALAN2_d: RN15.4 (R4A), U214.10 (d)
KALAN2_d_LED: DS13.2 (d), RN15.13 (R4B)
KALAN2_e: RN15.5 (R5A), U214.9 (e)
KALAN2_e_LED: DS13.1 (e), RN15.12 (R5B)
KALAN2_f: RN15.6 (R6A), U214.15 (f)
KALAN2_f_LED: DS13.9 (f), RN15.11 (R6B)
KALAN2_g: RN15.7 (R7A), U214.14 (g)
KALAN2_g_LED: DS13.10 (g), RN15.10 (R7B)
KALAN_BI0_N: U213.2 (1Y), U216.4 (~BI)
KALAN_BI1_N: U212.10 (3Y), U215.4 (~BI)
KALAN_BI2_N: U212.13 (4Y), U214.4 (~BI)
KALAN_SONUK: U212.9 (3B), U212.12 (4B), U213.1 (1A)
KL_6_1_3: U212.6 (2B), U214.1 (B)
KL_7_0_0: U216.1 (B)
KL_7_0_1: U216.2 (C)
KL_7_0_2: U216.6 (D)
KL_7_0_3: U211.1 (1A), U215.7 (A)
KL_7_1_0: U211.2 (1B), U215.1 (B)
KL_7_1_1: U211.4 (2A), U215.2 (C)
KL_7_1_2: U211.5 (2B), U215.6 (D)
KL_7_1_3: U212.5 (2A), U214.7 (A)
LED_HATA: D5.1 (A), R7.2
LT_N: U204.3 (2A), U205.3 (~LT), U206.3 (~LT), U207.3 (~LT), U208.3 (~LT), U209.3 (~LT), U214.3 (~LT), U215.3 (~LT), U216.3 (~LT)
N3620: U200.3 (1Y), U202.2 (1A)
N3621: U200.6 (2Y), U202.3 (1B)
N3622: U199.10 (3B), U202.1 (1Y)
N3623: U200.8 (3Y), U202.5 (2A)
N3624: U200.11 (4Y), U202.6 (2B)
N3625: U199.5 (2B), U202.4 (2Y)
N3626: U201.3 (1Y), U202.8 (3A)
N3627: U201.6 (2Y), U202.9 (3B)
N3628: U199.2 (1B), U202.10 (3Y)
N3629: U201.8 (3Y), U202.11 (4A)
N3630: U199.1 (1A), U202.13 (4Y), U203.11 (4A)
N3631: U199.3 (1Y), U199.4 (2A), U203.8 (3A)
N3632: U199.6 (2Y), U199.9 (3A), U203.5 (2A)
N3633: U199.8 (3Y), U203.2 (1A)
N3639: U201.13 (4B), U204.4 (2Y)
N3887: U211.3 (1Y), U212.2 (1A)
N3888: U211.6 (2Y), U212.3 (1B)
N3889: U210.2 (1B), U212.1 (1Y)
N3890: U210.1 (1A), U212.4 (2Y), U212.11 (4A)
N3891: U210.3 (1Y), U212.8 (3A)
NEG: U201.12 (4A)
SN_13_3_3: U202.12 (4B), U205.2 (C)
SN_14_3_3: U201.10 (3B), U205.1 (B)
SN_15_0_0: U209.1 (B)
SN_15_0_1: U209.2 (C)
SN_15_0_2: U209.6 (D)
SN_15_0_3: U200.1 (1A), U208.7 (A)
SN_15_1_0: U200.2 (1B), U208.1 (B)
SN_15_1_1: U200.4 (2A), U208.2 (C)
SN_15_1_2: U200.5 (2B), U208.6 (D)
SN_15_1_3: U200.9 (3A), U207.7 (A)
SN_15_2_0: U200.10 (3B), U207.1 (B)
SN_15_2_1: U200.12 (4A), U207.2 (C)
SN_15_2_2: U200.13 (4B), U207.6 (D)
SN_15_2_3: U201.1 (1A), U206.7 (A)
SN_15_3_0: U201.2 (1B), U206.1 (B)
SN_15_3_1: U201.4 (2A), U206.2 (C)
SN_15_3_2: U201.5 (2B), U206.6 (D)
SN_15_3_3: U201.9 (3A), U205.7 (A)
SONUC0: U209.7 (A)
SONUC0_a: RN14.1 (R1A), U209.13 (a)
SONUC0_a_LED: DS12.7 (a), RN14.16 (R1B)
SONUC0_b: RN14.2 (R2A), U209.12 (b)
SONUC0_b_LED: DS12.6 (b), RN14.15 (R2B)
SONUC0_c: RN14.3 (R3A), U209.11 (c)
SONUC0_c_LED: DS12.4 (c), RN14.14 (R3B)
SONUC0_d: RN14.4 (R4A), U209.10 (d)
SONUC0_d_LED: DS12.2 (d), RN14.13 (R4B)
SONUC0_e: RN14.5 (R5A), U209.9 (e)
SONUC0_e_LED: DS12.1 (e), RN14.12 (R5B)
SONUC0_f: RN14.6 (R6A), U209.15 (f)
SONUC0_f_LED: DS12.9 (f), RN14.11 (R6B)
SONUC0_g: RN14.7 (R7A), U209.14 (g)
SONUC0_g_LED: DS12.10 (g), RN14.10 (R7B)
SONUC1_a: RN13.1 (R1A), U208.13 (a)
SONUC1_a_LED: DS11.7 (a), RN13.16 (R1B)
SONUC1_b: RN13.2 (R2A), U208.12 (b)
SONUC1_b_LED: DS11.6 (b), RN13.15 (R2B)
SONUC1_c: RN13.3 (R3A), U208.11 (c)
SONUC1_c_LED: DS11.4 (c), RN13.14 (R3B)
SONUC1_d: RN13.4 (R4A), U208.10 (d)
SONUC1_d_LED: DS11.2 (d), RN13.13 (R4B)
SONUC1_e: RN13.5 (R5A), U208.9 (e)
SONUC1_e_LED: DS11.1 (e), RN13.12 (R5B)
SONUC1_f: RN13.6 (R6A), U208.15 (f)
SONUC1_f_LED: DS11.9 (f), RN13.11 (R6B)
SONUC1_g: RN13.7 (R7A), U208.14 (g)
SONUC1_g_LED: DS11.10 (g), RN13.10 (R7B)
SONUC2_a: RN12.1 (R1A), U207.13 (a)
SONUC2_a_LED: DS10.7 (a), RN12.16 (R1B)
SONUC2_b: RN12.2 (R2A), U207.12 (b)
SONUC2_b_LED: DS10.6 (b), RN12.15 (R2B)
SONUC2_c: RN12.3 (R3A), U207.11 (c)
SONUC2_c_LED: DS10.4 (c), RN12.14 (R3B)
SONUC2_d: RN12.4 (R4A), U207.10 (d)
SONUC2_d_LED: DS10.2 (d), RN12.13 (R4B)
SONUC2_e: RN12.5 (R5A), U207.9 (e)
SONUC2_e_LED: DS10.1 (e), RN12.12 (R5B)
SONUC2_f: RN12.6 (R6A), U207.15 (f)
SONUC2_f_LED: DS10.9 (f), RN12.11 (R6B)
SONUC2_g: RN12.7 (R7A), U207.14 (g)
SONUC2_g_LED: DS10.10 (g), RN12.10 (R7B)
SONUC3_a: RN11.1 (R1A), U206.13 (a)
SONUC3_a_LED: DS9.7 (a), RN11.16 (R1B)
SONUC3_b: RN11.2 (R2A), U206.12 (b)
SONUC3_b_LED: DS9.6 (b), RN11.15 (R2B)
SONUC3_c: RN11.3 (R3A), U206.11 (c)
SONUC3_c_LED: DS9.4 (c), RN11.14 (R3B)
SONUC3_d: RN11.4 (R4A), U206.10 (d)
SONUC3_d_LED: DS9.2 (d), RN11.13 (R4B)
SONUC3_e: RN11.5 (R5A), U206.9 (e)
SONUC3_e_LED: DS9.1 (e), RN11.12 (R5B)
SONUC3_f: RN11.6 (R6A), U206.15 (f)
SONUC3_f_LED: DS9.9 (f), RN11.11 (R6B)
SONUC3_g: RN11.7 (R7A), U206.14 (g)
SONUC3_g_LED: DS9.10 (g), RN11.10 (R7B)
SONUC4_a: RN10.1 (R1A), U205.13 (a)
SONUC4_a_LED: DS8.7 (a), RN10.16 (R1B)
SONUC4_b: RN10.2 (R2A), U205.12 (b)
SONUC4_b_LED: DS8.6 (b), RN10.15 (R2B)
SONUC4_c: RN10.3 (R3A), U205.11 (c)
SONUC4_c_LED: DS8.4 (c), RN10.14 (R3B)
SONUC4_d: RN10.4 (R4A), U205.10 (d)
SONUC4_d_LED: DS8.2 (d), RN10.13 (R4B)
SONUC4_e: RN10.5 (R5A), U205.9 (e)
SONUC4_e_LED: DS8.1 (e), RN10.12 (R5B)
SONUC4_f: RN10.6 (R6A), U205.15 (f)
SONUC4_f_LED: DS8.9 (f), RN10.11 (R6B)
SONUC4_g: RN10.7 (R7A), U205.14 (g)
SONUC4_g_LED: DS8.10 (g), RN10.10 (R7B)
SONUC_BI0_N: U204.2 (1Y), U209.4 (~BI)
SONUC_BI1_N: U203.1 (1Y), U208.4 (~BI)
SONUC_BI2_N: U203.4 (2Y), U207.4 (~BI)
SONUC_BI3_N: U203.10 (3Y), U206.4 (~BI)
SONUC_BI4_N: U203.13 (4Y), U205.4 (~BI)
VCC: C200.1, C201.1, C202.1, C203.1, C204.1, C205.1, C206.1, C207.1, C208.1, C209.1, C210.1, C211.1, C212.1, C213.1, C214.1, C215.1, C216.1, C217.1, U199.14 (VCC), U200.14 (VCC), U201.14 (VCC), U202.14 (VCC), U203.14 (VCC), U204.14 (VCC), U205.16 (VCC), U206.16 (VCC), U207.16 (VCC), U208.16 (VCC), U209.16 (VCC), U210.14 (VCC), U211.14 (VCC), U212.14 (VCC), U213.14 (VCC), U214.16 (VCC), U215.16 (VCC), U216.16 (VCC)
