MihrimatriX/breadboarding/cpu16/kicad/hesap/hesap-onluk-ab.kicad_sch

## KiCad design cpu16/kicad/hesap/hesap-onluk-ab.kicad_sch (2026-10-12)

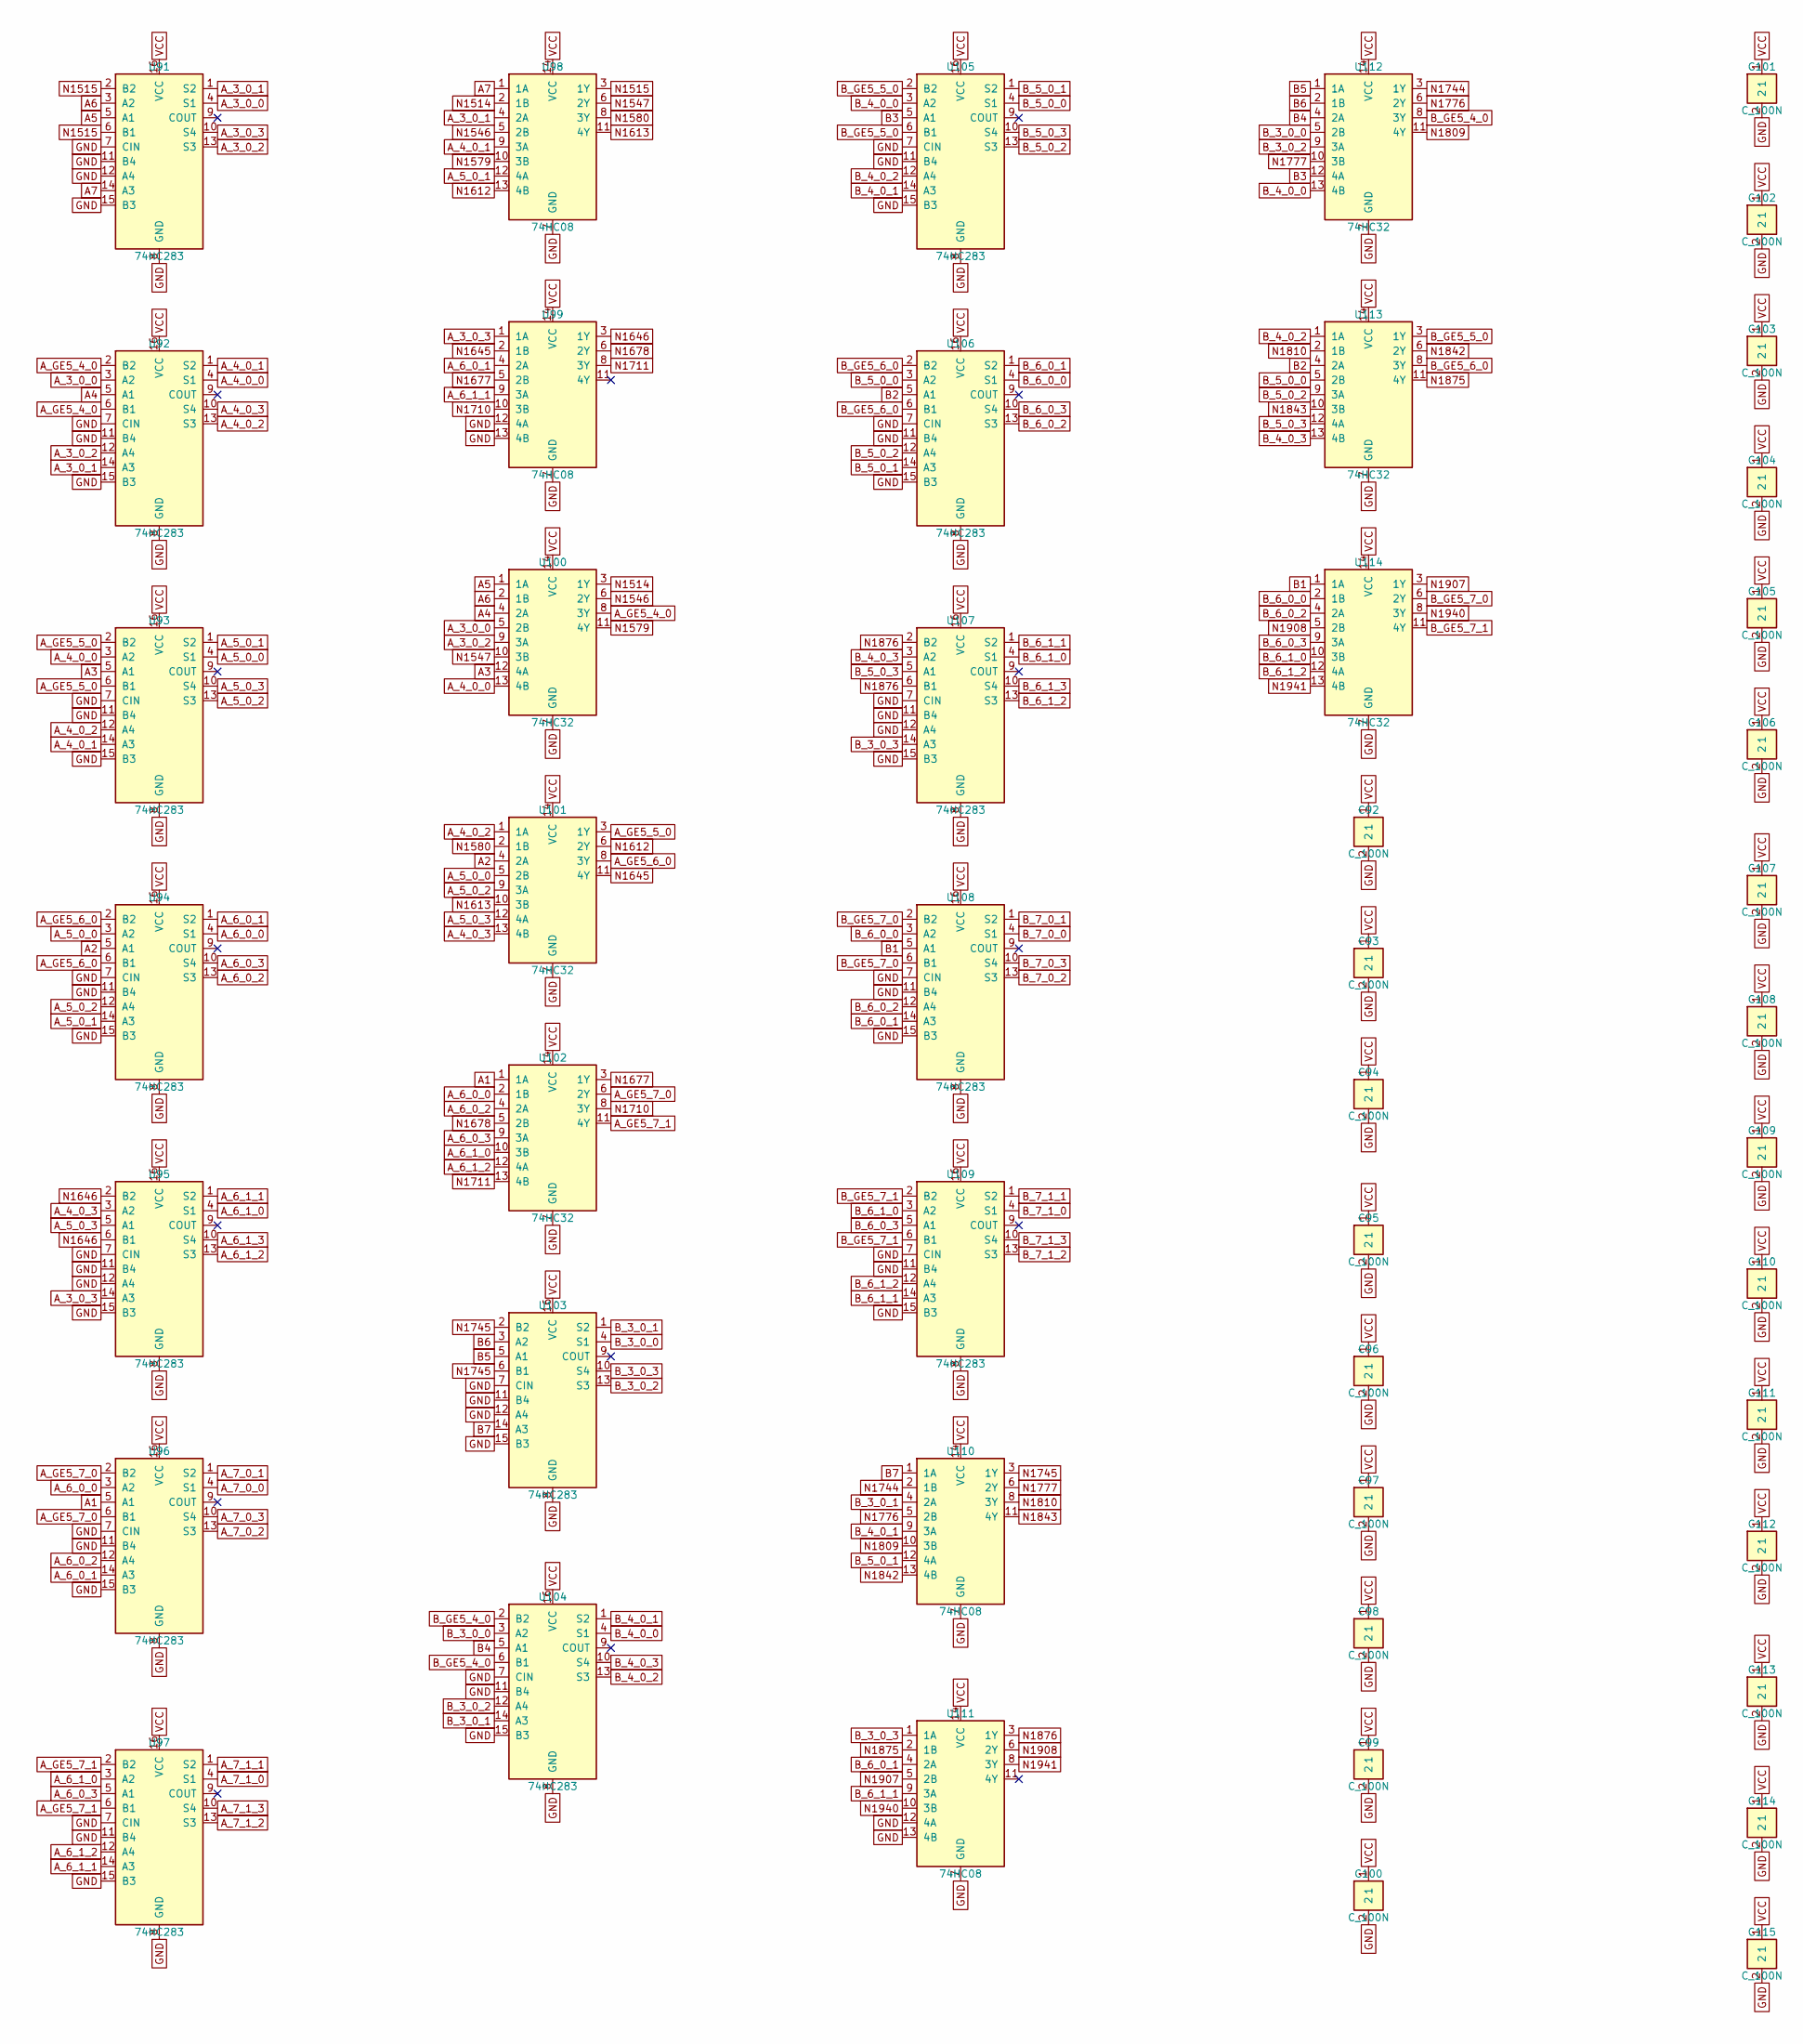
[picture p20: schematic hesap-onluk-ab.kicad_sch]

Parts:
C92, C93, C94, C95, C96, C97, C98, C99, C100, C101, C102, C103, C104, C105, C106, C107, C108, C109, C110, C111, C112, C113, C114, C115: C_100N; C_Disc_D5.0mm_W2.5mm_P5.00mm
U91, U92, U93, U94, U95, U96, U97, U103, U104, U105, U106, U107, U108, U109: 74HC283; DIP-16_W7.62mm
U98, U99, U110, U111: 74HC08; DIP-14_W7.62mm
U100, U101, U102, U112, U113, U114: 74HC32; DIP-14_W7.62mm

Connections:
A1: U96.5 (A1), U102.1 (1A)
A2: U94.5 (A1), U101.4 (2A)
A3: U93.5 (A1), U100.12 (4A)
A4: U92.5 (A1), U100.4 (2A)
A5: U91.5 (A1), U100.1 (1A)
A6: U91.3 (A2), U100.2 (1B)
A7: U91.14 (A3), U98.1 (1A)
A_3_0_0: U91.4 (S1), U92.3 (A2), U100.5 (2B)
A_3_0_1: U91.1 (S2), U92.14 (A3), U98.4 (2A)
A_3_0_2: U91.13 (S3), U92.12 (A4), U100.9 (3A)
A_3_0_3: U91.10 (S4), U95.14 (A3), U99.1 (1A)
A_4_0_0: U92.4 (S1), U93.3 (A2), U100.13 (4B)
A_4_0_1: U92.1 (S2), U93.14 (A3), U98.9 (3A)
A_4_0_2: U92.13 (S3), U93.12 (A4), U101.1 (1A)
A_4_0_3: U92.10 (S4), U95.3 (A2), U101.13 (4B)
A_5_0_0: U93.4 (S1), U94.3 (A2), U101.5 (2B)
A_5_0_1: U93.1 (S2), U94.14 (A3), U98.12 (4A)
A_5_0_2: U93.13 (S3), U94.12 (A4), U101.9 (3A)
A_5_0_3: U93.10 (S4), U95.5 (A1), U101.12 (4A)
A_6_0_0: U94.4 (S1), U96.3 (A2), U102.2 (1B)
A_6_0_1: U94.1 (S2), U96.14 (A3), U99.4 (2A)
A_6_0_2: U94.13 (S3), U96.12 (A4), U102.4 (2A)
A_6_0_3: U94.10 (S4), U97.5 (A1), U102.9 (3A)
A_6_1_0: U95.4 (S1), U97.3 (A2), U102.10 (3B)
A_6_1_1: U95.1 (S2), U97.14 (A3), U99.9 (3A)
A_6_1_2: U95.13 (S3), U97.12 (A4), U102.12 (4A)
A_6_1_3: U95.10 (S4)
A_7_0_0: U96.4 (S1)
A_7_0_1: U96.1 (S2)
A_7_0_2: U96.13 (S3)
A_7_0_3: U96.10 (S4)
A_7_1_0: U97.4 (S1)
A_7_1_1: U97.1 (S2)
A_7_1_2: U97.13 (S3)
A_7_1_3: U97.10 (S4)
A_GE5_4_0: U92.2 (B2), U92.6 (B1), U100.8 (3Y)
A_GE5_5_0: U93.2 (B2), U93.6 (B1), U101.3 (1Y)
A_GE5_6_0: U94.2 (B2), U94.6 (B1), U101.8 (3Y)
A_GE5_7_0: U96.2 (B2), U96.6 (B1), U102.6 (2Y)
A_GE5_7_1: U97.2 (B2), U97.6 (B1), U102.11 (4Y)
B1: U108.5 (A1), U114.1 (1A)
B2: U106.5 (A1), U113.4 (2A)
B3: U105.5 (A1), U112.12 (4A)
B4: U104.5 (A1), U112.4 (2A)
B5: U103.5 (A1), U112.1 (1A)
B6: U103.3 (A2), U112.2 (1B)
B7: U103.14 (A3), U110.1 (1A)
B_3_0_0: U103.4 (S1), U104.3 (A2), U112.5 (2B)
B_3_0_1: U103.1 (S2), U104.14 (A3), U110.4 (2A)
B_3_0_2: U103.13 (S3), U104.12 (A4), U112.9 (3A)
B_3_0_3: U103.10 (S4), U107.14 (A3), U111.1 (1A)
B_4_0_0: U104.4 (S1), U105.3 (A2), U112.13 (4B)
B_4_0_1: U104.1 (S2), U105.14 (A3), U110.9 (3A)
B_4_0_2: U104.13 (S3), U105.12 (A4), U113.1 (1A)
B_4_0_3: U104.10 (S4), U107.3 (A2), U113.13 (4B)
B_5_0_0: U105.4 (S1), U106.3 (A2), U113.5 (2B)
B_5_0_1: U105.1 (S2), U106.14 (A3), U110.12 (4A)
B_5_0_2: U105.13 (S3), U106.12 (A4), U113.9 (3A)
B_5_0_3: U105.10 (S4), U107.5 (A1), U113.12 (4A)
B_6_0_0: U106.4 (S1), U108.3 (A2), U114.2 (1B)
B_6_0_1: U106.1 (S2), U108.14 (A3), U111.4 (2A)
B_6_0_2: U106.13 (S3), U108.12 (A4), U114.4 (2A)
B_6_0_3: U106.10 (S4), U109.5 (A1), U114.9 (3A)
B_6_1_0: U107.4 (S1), U109.3 (A2), U114.10 (3B)
B_6_1_1: U107.1 (S2), U109.14 (A3), U111.9 (3A)
B_6_1_2: U107.13 (S3), U109.12 (A4), U114.12 (4A)
B_6_1_3: U107.10 (S4)
B_7_0_0: U108.4 (S1)
B_7_0_1: U108.1 (S2)
B_7_0_2: U108.13 (S3)
B_7_0_3: U108.10 (S4)
B_7_1_0: U109.4 (S1)
B_7_1_1: U109.1 (S2)
B_7_1_2: U109.13 (S3)
B_7_1_3: U109.10 (S4)
B_GE5_4_0: U104.2 (B2), U104.6 (B1), U112.8 (3Y)
B_GE5_5_0: U105.2 (B2), U105.6 (B1), U113.3 (1Y)
B_GE5_6_0: U106.2 (B2), U106.6 (B1), U113.8 (3Y)
B_GE5_7_0: U108.2 (B2), U108.6 (B1), U114.6 (2Y)
B_GE5_7_1: U109.2 (B2), U109.6 (B1), U114.11 (4Y)
GND: C92.2, C93.2, C94.2, C95.2, C96.2, C97.2, C98.2, C99.2, C100.2, C101.2, C102.2, C103.2, C104.2, C105.2, C106.2, C107.2, C108.2, C109.2, C110.2, C111.2, C112.2, C113.2, C114.2, C115.2, U91.7 (CIN), U91.8 (GND), U91.11 (B4), U91.12 (A4), U91.15 (B3), U92.7 (CIN), U92.8 (GND), U92.11 (B4), U92.15 (B3), U93.7 (CIN), U93.8 (GND), U93.11 (B4), U93.15 (B3), U94.7 (CIN), U94.8 (GND), U94.11 (B4), U94.15 (B3), U95.7 (CIN), U95.8 (GND), U95.11 (B4), U95.12 (A4), U95.15 (B3), U96.7 (CIN), U96.8 (GND), U96.11 (B4), U96.15 (B3), U97.7 (CIN), U97.8 (GND), U97.11 (B4), U97.15 (B3), U98.7 (GND), U99.7 (GND), U99.12 (4A), U99.13 (4B), U100.7 (GND), U101.7 (GND), U102.7 (GND), U103.7 (CIN), U103.8 (GND), U103.11 (B4), U103.12 (A4), U103.15 (B3), U104.7 (CIN), U104.8 (GND), U104.11 (B4), U104.15 (B3), U105.7 (CIN), U105.8 (GND), U105.11 (B4), U105.15 (B3), U106.7 (CIN), U106.8 (GND), U106.11 (B4), U106.15 (B3), U107.7 (CIN), U107.8 (GND), U107.11 (B4), U107.12 (A4), U107.15 (B3), U108.7 (CIN), U108.8 (GND), U108.11 (B4), U108.15 (B3), U109.7 (CIN), U109.8 (GND), U109.11 (B4), U109.15 (B3), U110.7 (GND), U111.7 (GND), U111.12 (4A), U111.13 (4B), U112.7 (GND), U113.7 (GND), U114.7 (GND)
N1514: U98.2 (1B), U100.3 (1Y)
N1515: U91.2 (B2), U91.6 (B1), U98.3 (1Y)
N1546: U98.5 (2B), U100.6 (2Y)
N1547: U98.6 (2Y), U100.10 (3B)
N1579: U98.10 (3B), U100.11 (4Y)
N1580: U98.8 (3Y), U101.2 (1B)
N1612: U98.13 (4B), U101.6 (2Y)
N1613: U98.11 (4Y), U101.10 (3B)
N1645: U99.2 (1B), U101.11 (4Y)
N1646: U95.2 (B2), U95.6 (B1), U99.3 (1Y)
N1677: U99.5 (2B), U102.3 (1Y)
N1678: U99.6 (2Y), U102.5 (2B)
N1710: U99.10 (3B), U102.8 (3Y)
N1711: U99.8 (3Y), U102.13 (4B)
N1744: U110.2 (1B), U112.3 (1Y)
N1745: U103.2 (B2), U103.6 (B1), U110.3 (1Y)
N1776: U110.5 (2B), U112.6 (2Y)
N1777: U110.6 (2Y), U112.10 (3B)
N1809: U110.10 (3B), U112.11 (4Y)
N1810: U110.8 (3Y), U113.2 (1B)
N1842: U110.13 (4B), U113.6 (2Y)
N1843: U110.11 (4Y), U113.10 (3B)
N1875: U111.2 (1B), U113.11 (4Y)
N1876: U107.2 (B2), U107.6 (B1), U111.3 (1Y)
N1907: U111.5 (2B), U114.3 (1Y)
N1908: U111.6 (2Y), U114.5 (2B)
N1940: U111.10 (3B), U114.8 (3Y)
N1941: U111.8 (3Y), U114.13 (4B)
VCC: C92.1, C93.1, C94.1, C95.1, C96.1, C97.1, C98.1, C99.1, C100.1, C101.1, C102.1, C103.1, C104.1, C105.1, C106.1, C107.1, C108.1, C109.1, C110.1, C111.1, C112.1, C113.1, C114.1, C115.1, U91.16 (VCC), U92.16 (VCC), U93.16 (VCC), U94.16 (VCC), U95.16 (VCC), U96.16 (VCC), U97.16 (VCC), U98.14 (VCC), U99.14 (VCC), U100.14 (VCC), U101.14 (VCC), U102.14 (VCC), U103.16 (VCC), U104.16 (VCC), U105.16 (VCC), U106.16 (VCC), U107.16 (VCC), U108.16 (VCC), U109.16 (VCC), U110.14 (VCC), U111.14 (VCC), U112.14 (VCC), U113.14 (VCC), U114.14 (VCC)
