MihrimatriX/breadboarding/cpu16/kicad/hesap/hesap-onluk-kalan.kicad_sch

## KiCad design cpu16/kicad/hesap/hesap-onluk-kalan.kicad_sch (2026-10-12)

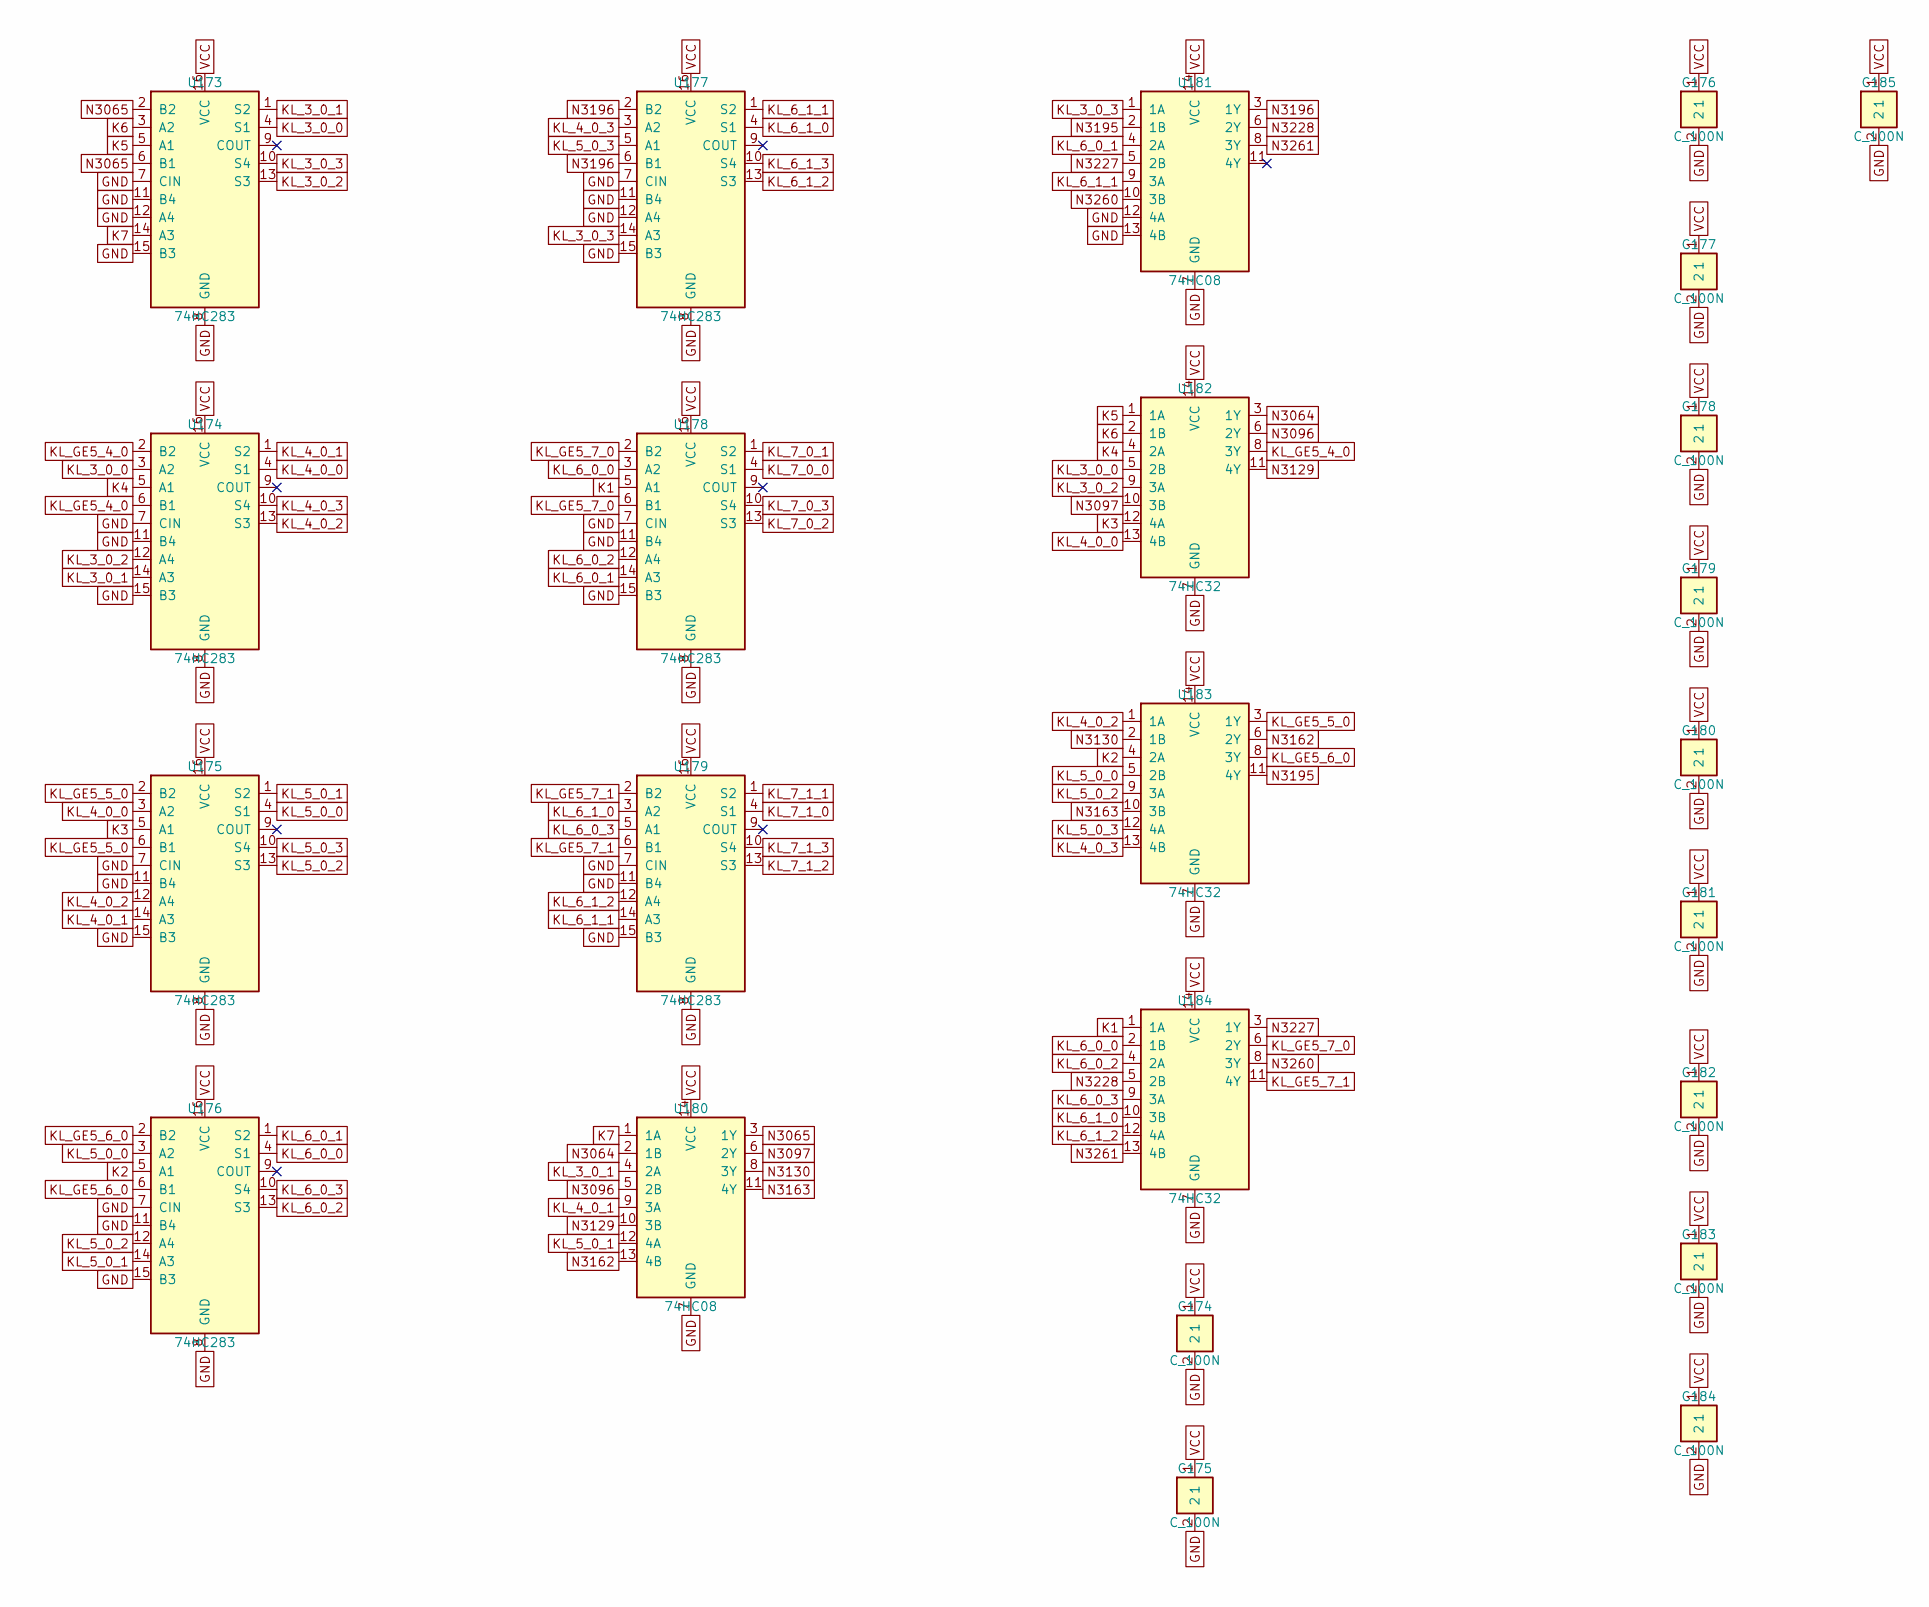
[picture p21: schematic hesap-onluk-kalan.kicad_sch]

Parts:
C174, C175, C176, C177, C178, C179, C180, C181, C182, C183, C184, C185: C_100N; C_Disc_D5.0mm_W2.5mm_P5.00mm
U173, U174, U175, U176, U177, U178, U179: 74HC283; DIP-16_W7.62mm
U180, U181: 74HC08; DIP-14_W7.62mm
U182, U183, U184: 74HC32; DIP-14_W7.62mm

Connections:
GND: C174.2, C175.2, C176.2, C177.2, C178.2, C179.2, C180.2, C181.2, C182.2, C183.2, C184.2, C185.2, U173.7 (CIN), U173.8 (GND), U173.11 (B4), U173.12 (A4), U173.15 (B3), U174.7 (CIN), U174.8 (GND), U174.11 (B4), U174.15 (B3), U175.7 (CIN), U175.8 (GND), U175.11 (B4), U175.15 (B3), U176.7 (CIN), U176.8 (GND), U176.11 (B4), U176.15 (B3), U177.7 (CIN), U177.8 (GND), U177.11 (B4), U177.12 (A4), U177.15 (B3), U178.7 (CIN), U178.8 (GND), U178.11 (B4), U178.15 (B3), U179.7 (CIN), U179.8 (GND), U179.11 (B4), U179.15 (B3), U180.7 (GND), U181.7 (GND), U181.12 (4A), U181.13 (4B), U182.7 (GND), U183.7 (GND), U184.7 (GND)
K1: U178.5 (A1), U184.1 (1A)
K2: U176.5 (A1), U183.4 (2A)
K3: U175.5 (A1), U182.12 (4A)
K4: U174.5 (A1), U182.4 (2A)
K5: U173.5 (A1), U182.1 (1A)
K6: U173.3 (A2), U182.2 (1B)
K7: U173.14 (A3), U180.1 (1A)
KL_3_0_0: U173.4 (S1), U174.3 (A2), U182.5 (2B)
KL_3_0_1: U173.1 (S2), U174.14 (A3), U180.4 (2A)
KL_3_0_2: U173.13 (S3), U174.12 (A4), U182.9 (3A)
KL_3_0_3: U173.10 (S4), U177.14 (A3), U181.1 (1A)
KL_4_0_0: U174.4 (S1), U175.3 (A2), U182.13 (4B)
KL_4_0_1: U174.1 (S2), U175.14 (A3), U180.9 (3A)
KL_4_0_2: U174.13 (S3), U175.12 (A4), U183.1 (1A)
KL_4_0_3: U174.10 (S4), U177.3 (A2), U183.13 (4B)
KL_5_0_0: U175.4 (S1), U176.3 (A2), U183.5 (2B)
KL_5_0_1: U175.1 (S2), U176.14 (A3), U180.12 (4A)
KL_5_0_2: U175.13 (S3), U176.12 (A4), U183.9 (3A)
KL_5_0_3: U175.10 (S4), U177.5 (A1), U183.12 (4A)
KL_6_0_0: U176.4 (S1), U178.3 (A2), U184.2 (1B)
KL_6_0_1: U176.1 (S2), U178.14 (A3), U181.4 (2A)
KL_6_0_2: U176.13 (S3), U178.12 (A4), U184.4 (2A)
KL_6_0_3: U176.10 (S4), U179.5 (A1), U184.9 (3A)
KL_6_1_0: U177.4 (S1), U179.3 (A2), U184.10 (3B)
KL_6_1_1: U177.1 (S2), U179.14 (A3), U181.9 (3A)
KL_6_1_2: U177.13 (S3), U179.12 (A4), U184.12 (4A)
KL_6_1_3: U177.10 (S4)
KL_7_0_0: U178.4 (S1)
KL_7_0_1: U178.1 (S2)
KL_7_0_2: U178.13 (S3)
KL_7_0_3: U178.10 (S4)
KL_7_1_0: U179.4 (S1)
KL_7_1_1: U179.1 (S2)
KL_7_1_2: U179.13 (S3)
KL_7_1_3: U179.10 (S4)
KL_GE5_4_0: U174.2 (B2), U174.6 (B1), U182.8 (3Y)
KL_GE5_5_0: U175.2 (B2), U175.6 (B1), U183.3 (1Y)
KL_GE5_6_0: U176.2 (B2), U176.6 (B1), U183.8 (3Y)
KL_GE5_7_0: U178.2 (B2), U178.6 (B1), U184.6 (2Y)
KL_GE5_7_1: U179.2 (B2), U179.6 (B1), U184.11 (4Y)
N3064: U180.2 (1B), U182.3 (1Y)
N3065: U173.2 (B2), U173.6 (B1), U180.3 (1Y)
N3096: U180.5 (2B), U182.6 (2Y)
N3097: U180.6 (2Y), U182.10 (3B)
N3129: U180.10 (3B), U182.11 (4Y)
N3130: U180.8 (3Y), U183.2 (1B)
N3162: U180.13 (4B), U183.6 (2Y)
N3163: U180.11 (4Y), U183.10 (3B)
N3195: U181.2 (1B), U183.11 (4Y)
N3196: U177.2 (B2), U177.6 (B1), U181.3 (1Y)
N3227: U181.5 (2B), U184.3 (1Y)
N3228: U181.6 (2Y), U184.5 (2B)
N3260: U181.10 (3B), U184.8 (3Y)
N3261: U181.8 (3Y), U184.13 (4B)
VCC: C174.1, C175.1, C176.1, C177.1, C178.1, C179.1, C180.1, C181.1, C182.1, C183.1, C184.1, C185.1, U173.16 (VCC), U174.16 (VCC), U175.16 (VCC), U176.16 (VCC), U177.16 (VCC), U178.16 (VCC), U179.16 (VCC), U180.14 (VCC), U181.14 (VCC), U182.14 (VCC), U183.14 (VCC), U184.14 (VCC)
