MihrimatriX/breadboarding/cpu16/kicad/hesap/hesap-onluk-sonuc.kicad_sch

## KiCad design cpu16/kicad/hesap/hesap-onluk-sonuc.kicad_sch (2026-10-12)

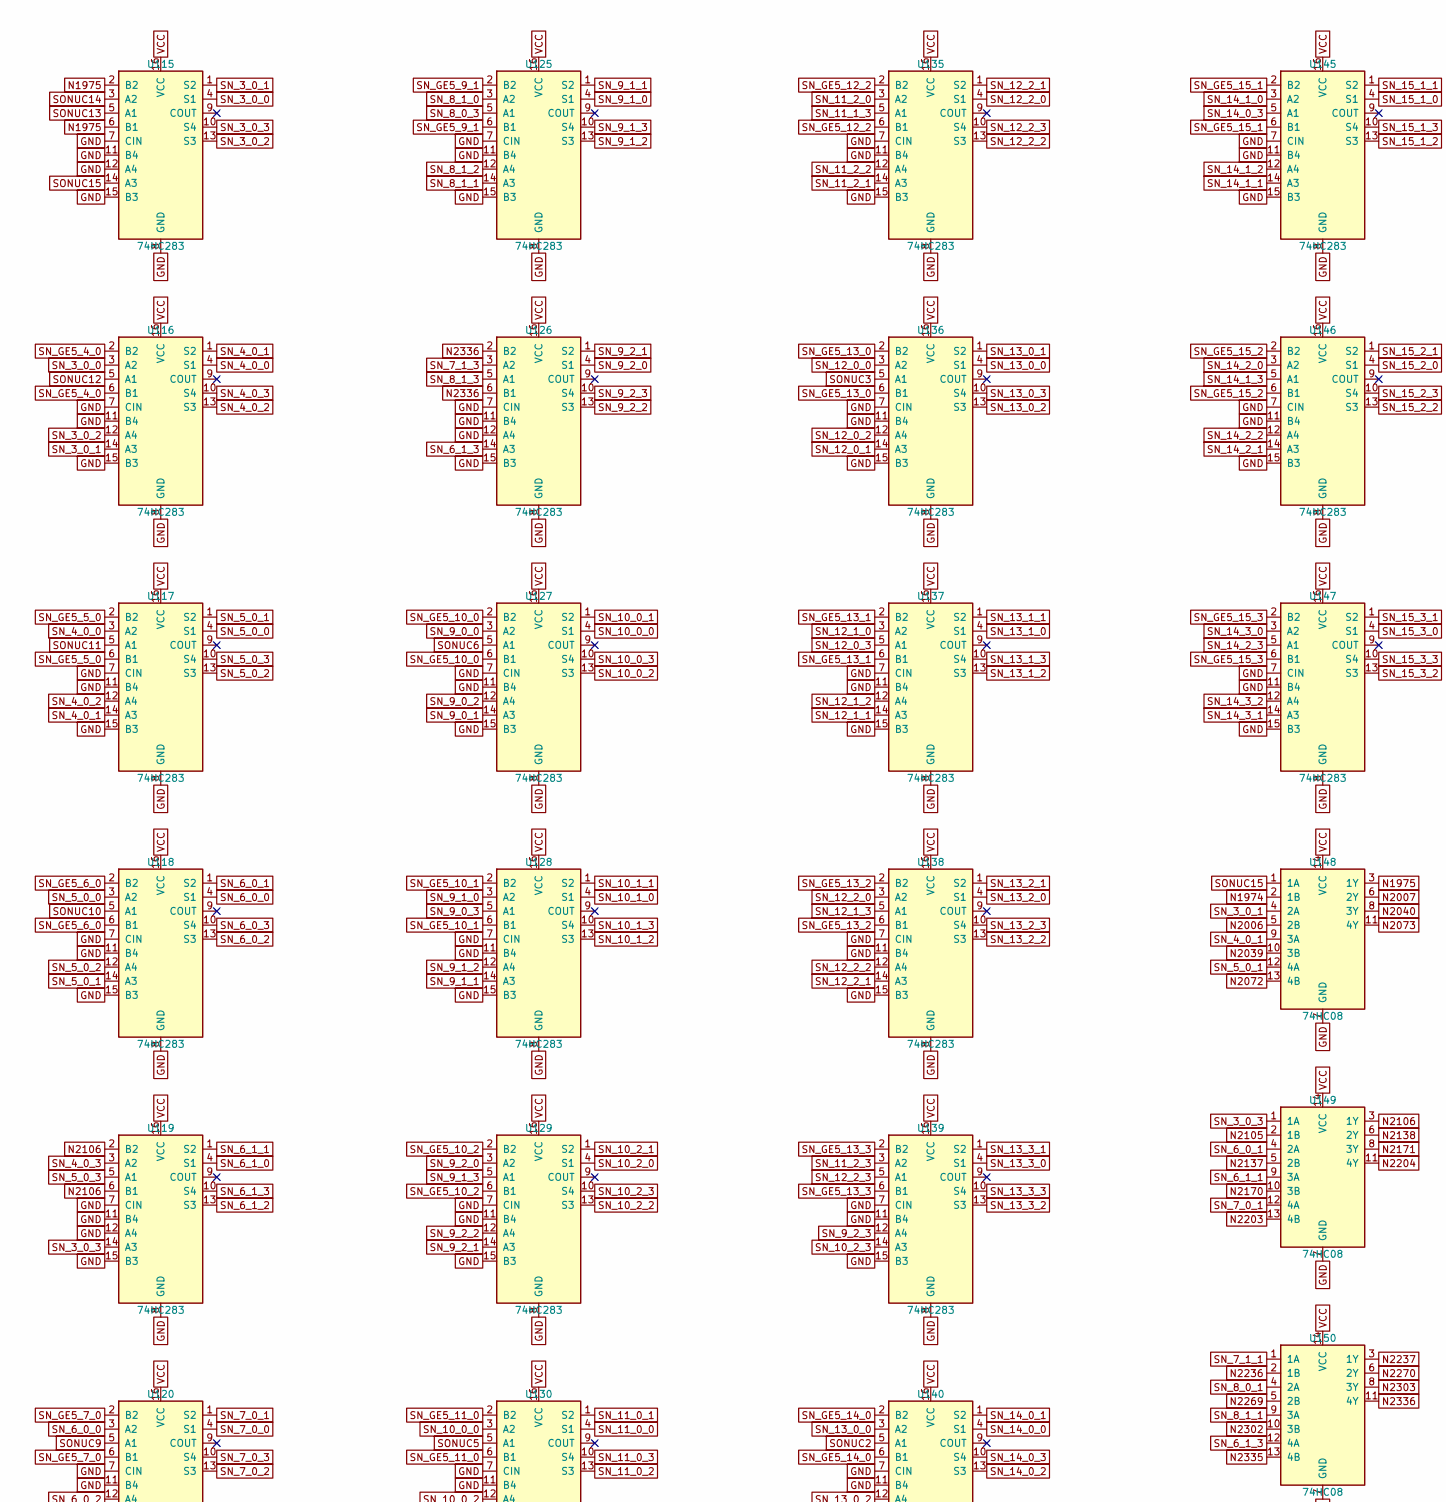
[picture p22: schematic hesap-onluk-sonuc.kicad_sch, part in row 1, column 1]

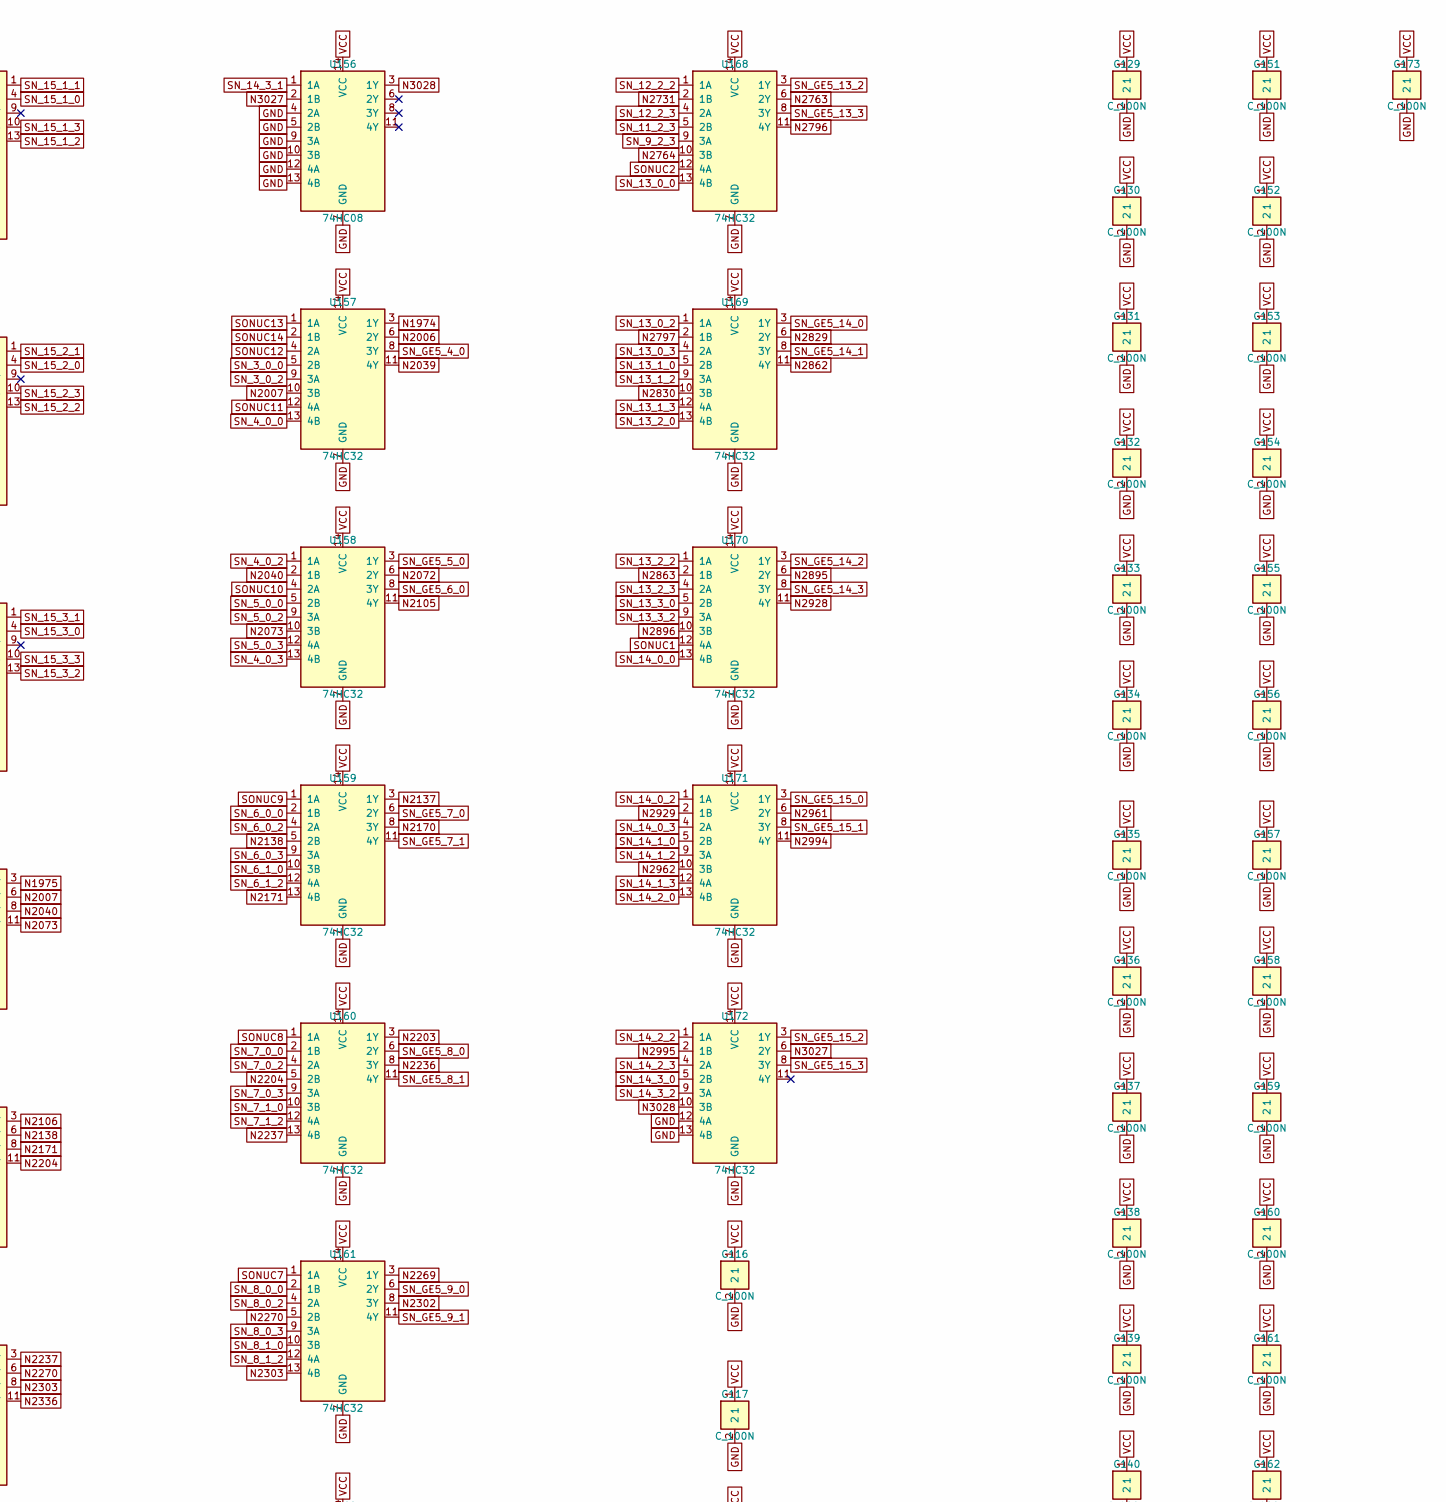
[picture p23: schematic hesap-onluk-sonuc.kicad_sch, part in row 1, column 2]

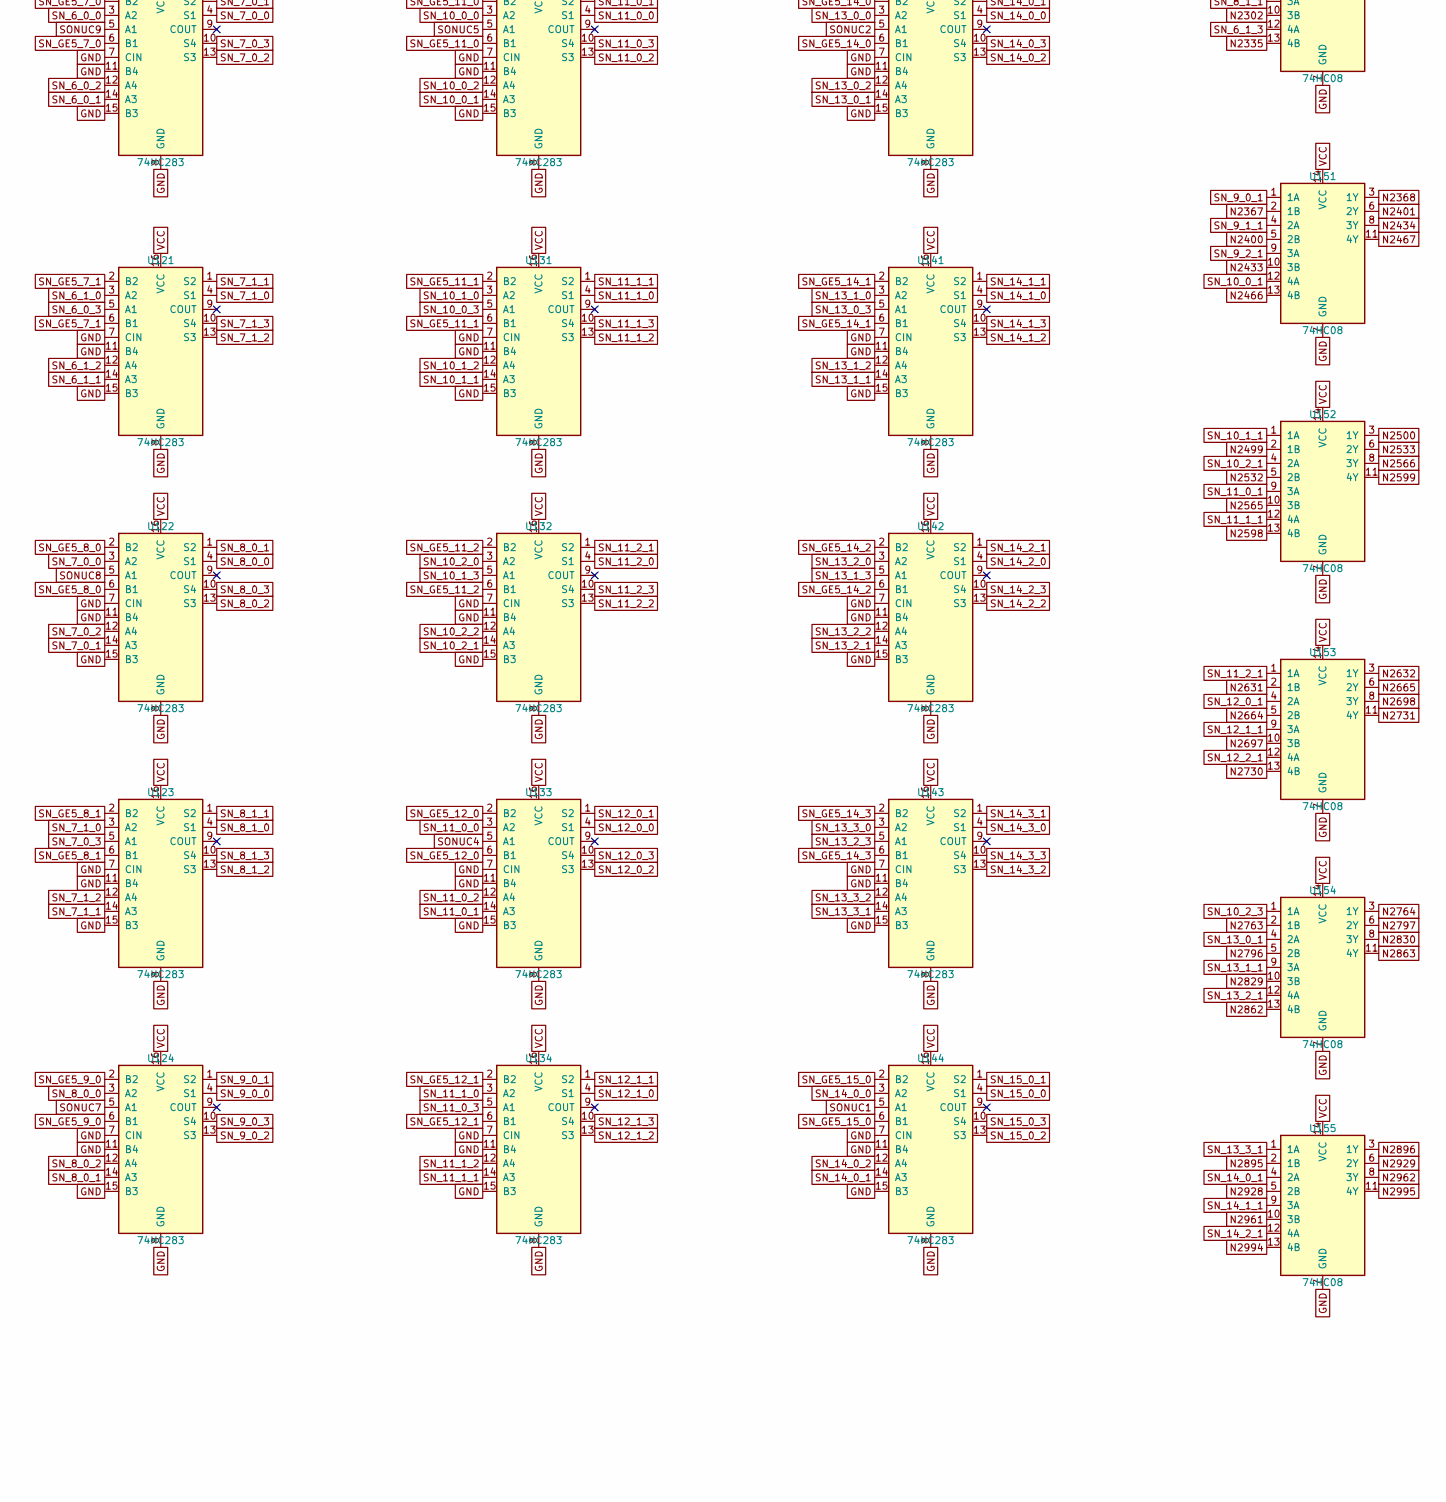
[picture p24: schematic hesap-onluk-sonuc.kicad_sch, part in row 2, column 1]

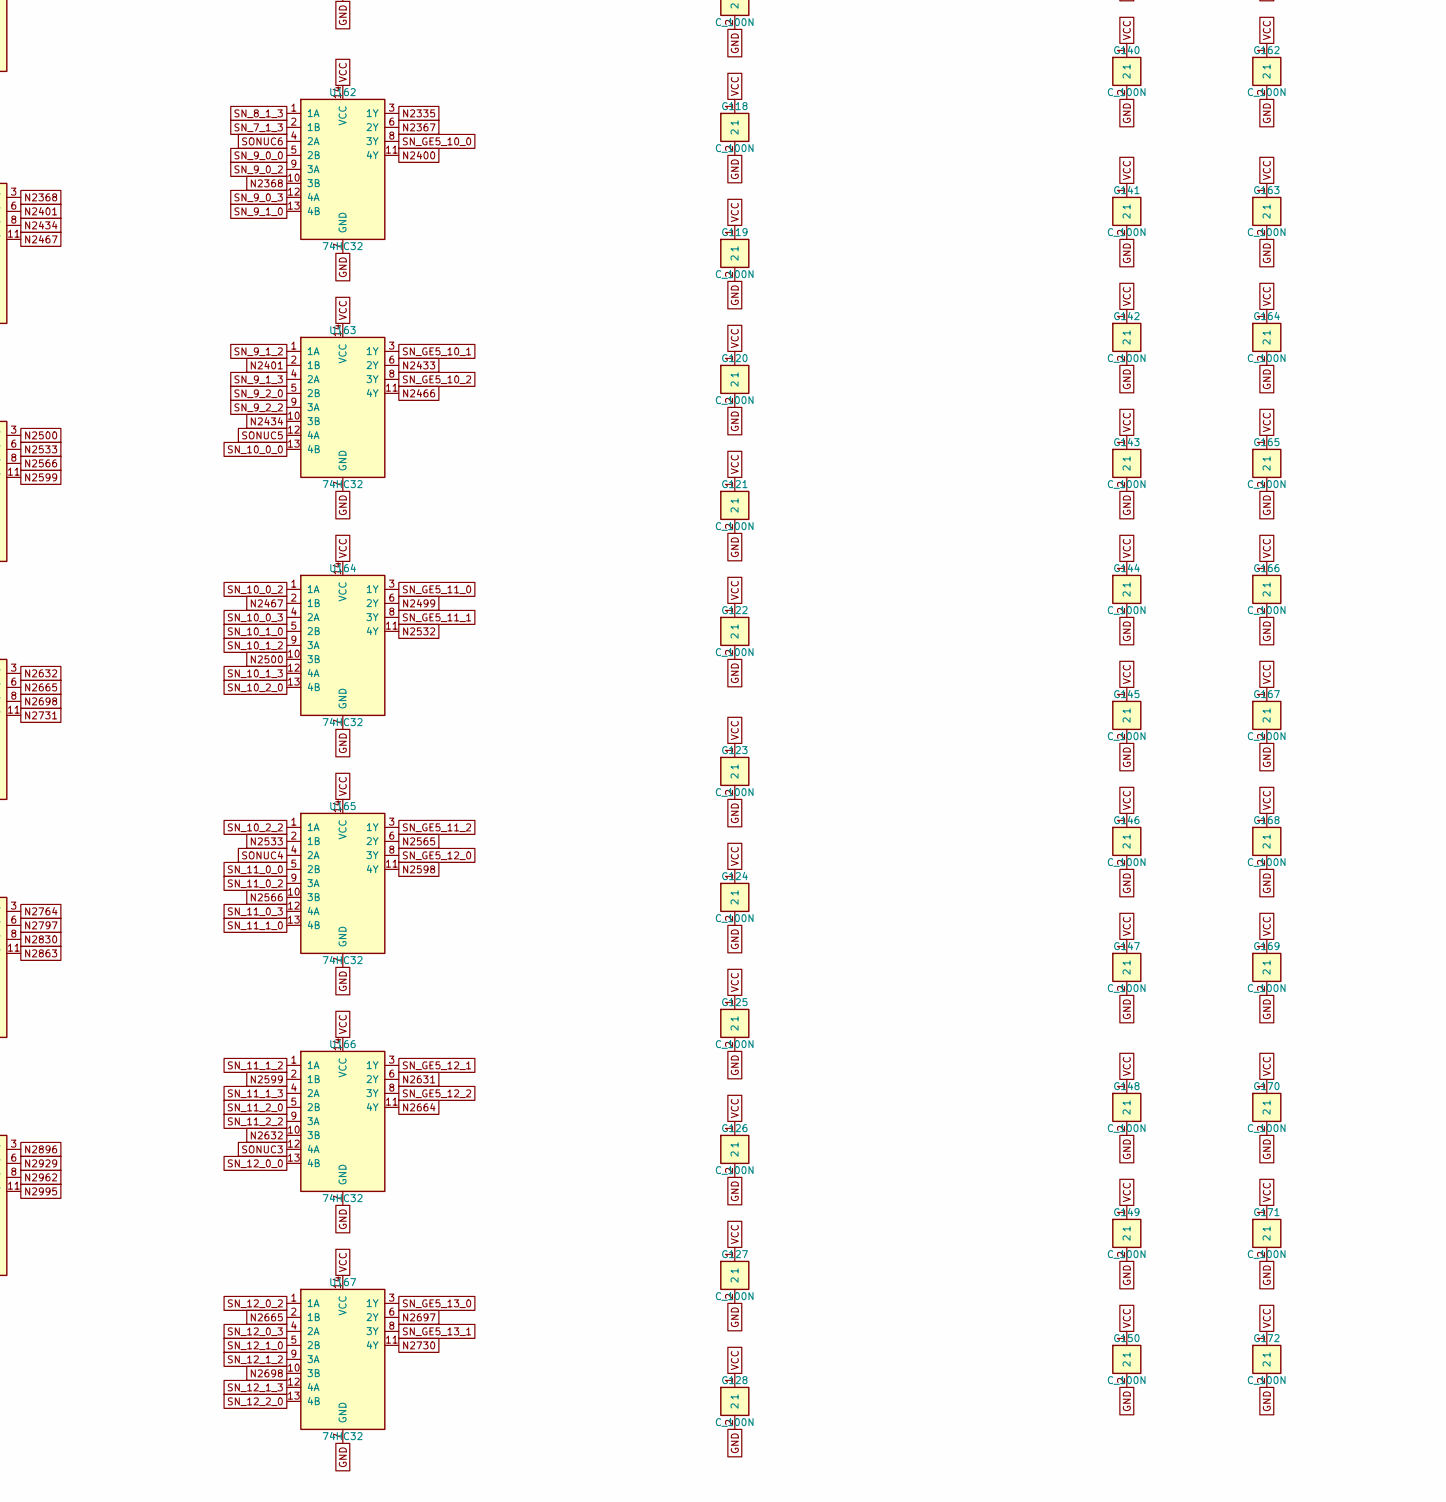
[picture p25: schematic hesap-onluk-sonuc.kicad_sch, part in row 2, column 2]

Parts:
C116, C117, C118, C119, C120, C121, C122, C123, C124, C125, C126, C127, C128, C129, C130, C131, C132, C133, C134, C135, C136, C137, C138, C139, C140, C141, C142, C143, C144, C145, C146, C147, C148, C149, C150, C151, C152, C153, C154, C155, C156, C157, C158, C159, C160, C161, C162, C163, C164, C165, C166, C167, C168, C169, C170, C171, C172, C173: C_100N; C_Disc_D5.0mm_W2.5mm_P5.00mm
U115, U116, U117, U118, U119, U120, U121, U122, U123, U124, U125, U126, U127, U128, U129, U130, U131, U132, U133, U134, U135, U136, U137, U138, U139, U140, U141, U142, U143, U144, U145, U146, U147: 74HC283; DIP-16_W7.62mm
U148, U149, U150, U151, U152, U153, U154, U155, U156: 74HC08; DIP-14_W7.62mm
U157, U158, U159, U160, U161, U162, U163, U164, U165, U166, U167, U168, U169, U170, U171, U172: 74HC32; DIP-14_W7.62mm

Connections:
GND: C116.2, C117.2, C118.2, C119.2, C120.2, C121.2, C122.2, C123.2, C124.2, C125.2, C126.2, C127.2, C128.2, C129.2, C130.2, C131.2, C132.2, C133.2, C134.2, C135.2, C136.2, C137.2, C138.2, C139.2, C140.2, C141.2, C142.2, C143.2, C144.2, C145.2, C146.2, C147.2, C148.2, C149.2, C150.2, C151.2, C152.2, C153.2, C154.2, C155.2, C156.2, C157.2, C158.2, C159.2, C160.2, C161.2, C162.2, C163.2, C164.2, C165.2, C166.2, C167.2, C168.2, C169.2, C170.2, C171.2, C172.2, C173.2, U115.7 (CIN), U115.8 (GND), U115.11 (B4), U115.12 (A4), U115.15 (B3), U116.7 (CIN), U116.8 (GND), U116.11 (B4), U116.15 (B3), U117.7 (CIN), U117.8 (GND), U117.11 (B4), U117.15 (B3), U118.7 (CIN), U118.8 (GND), U118.11 (B4), U118.15 (B3), U119.7 (CIN), U119.8 (GND), U119.11 (B4), U119.12 (A4), U119.15 (B3), U120.7 (CIN), U120.8 (GND), U120.11 (B4), U120.15 (B3), U121.7 (CIN), U121.8 (GND), U121.11 (B4), U121.15 (B3), U122.7 (CIN), U122.8 (GND), U122.11 (B4), U122.15 (B3), U123.7 (CIN), U123.8 (GND), U123.11 (B4), U123.15 (B3), U124.7 (CIN), U124.8 (GND), U124.11 (B4), U124.15 (B3), U125.7 (CIN), U125.8 (GND), U125.11 (B4), U125.15 (B3), U126.7 (CIN), U126.8 (GND), U126.11 (B4), U126.12 (A4), U126.15 (B3), U127.7 (CIN), U127.8 (GND), U127.11 (B4), U127.15 (B3), U128.7 (CIN), U128.8 (GND), U128.11 (B4), U128.15 (B3), U129.7 (CIN), U129.8 (GND), U129.11 (B4), U129.15 (B3), U130.7 (CIN), U130.8 (GND), U130.11 (B4), U130.15 (B3), U131.7 (CIN), U131.8 (GND), U131.11 (B4), U131.15 (B3), U132.7 (CIN), U132.8 (GND), U132.11 (B4), U132.15 (B3), U133.7 (CIN), U133.8 (GND), U133.11 (B4), U133.15 (B3), U134.7 (CIN), U134.8 (GND), U134.11 (B4), U134.15 (B3), U135.7 (CIN), U135.8 (GND), U135.11 (B4), U135.15 (B3), U136.7 (CIN), U136.8 (GND), U136.11 (B4), U136.15 (B3), U137.7 (CIN), U137.8 (GND), U137.11 (B4), U137.15 (B3), U138.7 (CIN), U138.8 (GND), U138.11 (B4), U138.15 (B3), U139.7 (CIN), U139.8 (GND), U139.11 (B4), U139.15 (B3), U140.7 (CIN), U140.8 (GND), U140.11 (B4), U140.15 (B3), U141.7 (CIN), U141.8 (GND), U141.11 (B4), U141.15 (B3), U142.7 (CIN), U142.8 (GND), U142.11 (B4), U142.15 (B3), U143.7 (CIN), U143.8 (GND), U143.11 (B4), U143.15 (B3), U144.7 (CIN), U144.8 (GND), U144.11 (B4), U144.15 (B3), U145.7 (CIN), U145.8 (GND), U145.11 (B4), U145.15 (B3), U146.7 (CIN), U146.8 (GND), U146.11 (B4), U146.15 (B3), U147.7 (CIN), U147.8 (GND), U147.11 (B4), U147.15 (B3), U148.7 (GND), U149.7 (GND), U150.7 (GND), U151.7 (GND), U152.7 (GND), U153.7 (GND), U154.7 (GND), U155.7 (GND), U156.4 (2A), U156.5 (2B), U156.7 (GND), U156.9 (3A), U156.10 (3B), U156.12 (4A), U156.13 (4B), U157.7 (GND), U158.7 (GND), U159.7 (GND), U160.7 (GND), U161.7 (GND), U162.7 (GND), U163.7 (GND), U164.7 (GND), U165.7 (GND), U166.7 (GND), U167.7 (GND), U168.7 (GND), U169.7 (GND), U170.7 (GND), U171.7 (GND), U172.7 (GND), U172.12 (4A), U172.13 (4B)
N1974: U148.2 (1B), U157.3 (1Y)
N1975: U115.2 (B2), U115.6 (B1), U148.3 (1Y)
N2006: U148.5 (2B), U157.6 (2Y)
N2007: U148.6 (2Y), U157.10 (3B)
N2039: U148.10 (3B), U157.11 (4Y)
N2040: U148.8 (3Y), U158.2 (1B)
N2072: U148.13 (4B), U158.6 (2Y)
N2073: U148.11 (4Y), U158.10 (3B)
N2105: U149.2 (1B), U158.11 (4Y)
N2106: U119.2 (B2), U119.6 (B1), U149.3 (1Y)
N2137: U149.5 (2B), U159.3 (1Y)
N2138: U149.6 (2Y), U159.5 (2B)
N2170: U149.10 (3B), U159.8 (3Y)
N2171: U149.8 (3Y), U159.13 (4B)
N2203: U149.13 (4B), U160.3 (1Y)
N2204: U149.11 (4Y), U160.5 (2B)
N2236: U150.2 (1B), U160.8 (3Y)
N2237: U150.3 (1Y), U160.13 (4B)
N2269: U150.5 (2B), U161.3 (1Y)
N2270: U150.6 (2Y), U161.5 (2B)
N2302: U150.10 (3B), U161.8 (3Y)
N2303: U150.8 (3Y), U161.13 (4B)
N2335: U150.13 (4B), U162.3 (1Y)
N2336: U126.2 (B2), U126.6 (B1), U150.11 (4Y)
N2367: U151.2 (1B), U162.6 (2Y)
N2368: U151.3 (1Y), U162.10 (3B)
N2400: U151.5 (2B), U162.11 (4Y)
N2401: U151.6 (2Y), U163.2 (1B)
N2433: U151.10 (3B), U163.6 (2Y)
N2434: U151.8 (3Y), U163.10 (3B)
N2466: U151.13 (4B), U163.11 (4Y)
N2467: U151.11 (4Y), U164.2 (1B)
N2499: U152.2 (1B), U164.6 (2Y)
N2500: U152.3 (1Y), U164.10 (3B)
N2532: U152.5 (2B), U164.11 (4Y)
N2533: U152.6 (2Y), U165.2 (1B)
N2565: U152.10 (3B), U165.6 (2Y)
N2566: U152.8 (3Y), U165.10 (3B)
N2598: U152.13 (4B), U165.11 (4Y)
N2599: U152.11 (4Y), U166.2 (1B)
N2631: U153.2 (1B), U166.6 (2Y)
N2632: U153.3 (1Y), U166.10 (3B)
N2664: U153.5 (2B), U166.11 (4Y)
N2665: U153.6 (2Y), U167.2 (1B)
N2697: U153.10 (3B), U167.6 (2Y)
N2698: U153.8 (3Y), U167.10 (3B)
N2730: U153.13 (4B), U167.11 (4Y)
N2731: U153.11 (4Y), U168.2 (1B)
N2763: U154.2 (1B), U168.6 (2Y)
N2764: U154.3 (1Y), U168.10 (3B)
N2796: U154.5 (2B), U168.11 (4Y)
N2797: U154.6 (2Y), U169.2 (1B)
N2829: U154.10 (3B), U169.6 (2Y)
N2830: U154.8 (3Y), U169.10 (3B)
N2862: U154.13 (4B), U169.11 (4Y)
N2863: U154.11 (4Y), U170.2 (1B)
N2895: U155.2 (1B), U170.6 (2Y)
N2896: U155.3 (1Y), U170.10 (3B)
N2928: U155.5 (2B), U170.11 (4Y)
N2929: U155.6 (2Y), U171.2 (1B)
N2961: U155.10 (3B), U171.6 (2Y)
N2962: U155.8 (3Y), U171.10 (3B)
N2994: U155.13 (4B), U171.11 (4Y)
N2995: U155.11 (4Y), U172.2 (1B)
N3027: U156.2 (1B), U172.6 (2Y)
N3028: U156.3 (1Y), U172.10 (3B)
SN_3_0_0: U115.4 (S1), U116.3 (A2), U157.5 (2B)
SN_3_0_1: U115.1 (S2), U116.14 (A3), U148.4 (2A)
SN_3_0_2: U115.13 (S3), U116.12 (A4), U157.9 (3A)
SN_3_0_3: U115.10 (S4), U119.14 (A3), U149.1 (1A)
SN_4_0_0: U116.4 (S1), U117.3 (A2), U157.13 (4B)
SN_4_0_1: U116.1 (S2), U117.14 (A3), U148.9 (3A)
SN_4_0_2: U116.13 (S3), U117.12 (A4), U158.1 (1A)
SN_4_0_3: U116.10 (S4), U119.3 (A2), U158.13 (4B)
SN_5_0_0: U117.4 (S1), U118.3 (A2), U158.5 (2B)
SN_5_0_1: U117.1 (S2), U118.14 (A3), U148.12 (4A)
SN_5_0_2: U117.13 (S3), U118.12 (A4), U158.9 (3A)
SN_5_0_3: U117.10 (S4), U119.5 (A1), U158.12 (4A)
SN_6_0_0: U118.4 (S1), U120.3 (A2), U159.2 (1B)
SN_6_0_1: U118.1 (S2), U120.14 (A3), U149.4 (2A)
SN_6_0_2: U118.13 (S3), U120.12 (A4), U159.4 (2A)
SN_6_0_3: U118.10 (S4), U121.5 (A1), U159.9 (3A)
SN_6_1_0: U119.4 (S1), U121.3 (A2), U159.10 (3B)
SN_6_1_1: U119.1 (S2), U121.14 (A3), U149.9 (3A)
SN_6_1_2: U119.13 (S3), U121.12 (A4), U159.12 (4A)
SN_6_1_3: U119.10 (S4), U126.14 (A3), U150.12 (4A)
SN_7_0_0: U120.4 (S1), U122.3 (A2), U160.2 (1B)
SN_7_0_1: U120.1 (S2), U122.14 (A3), U149.12 (4A)
SN_7_0_2: U120.13 (S3), U122.12 (A4), U160.4 (2A)
SN_7_0_3: U120.10 (S4), U123.5 (A1), U160.9 (3A)
SN_7_1_0: U121.4 (S1), U123.3 (A2), U160.10 (3B)
SN_7_1_1: U121.1 (S2), U123.14 (A3), U150.1 (1A)
SN_7_1_2: U121.13 (S3), U123.12 (A4), U160.12 (4A)
SN_7_1_3: U121.10 (S4), U126.3 (A2), U162.2 (1B)
SN_8_0_0: U122.4 (S1), U124.3 (A2), U161.2 (1B)
SN_8_0_1: U122.1 (S2), U124.14 (A3), U150.4 (2A)
SN_8_0_2: U122.13 (S3), U124.12 (A4), U161.4 (2A)
SN_8_0_3: U122.10 (S4), U125.5 (A1), U161.9 (3A)
SN_8_1_0: U123.4 (S1), U125.3 (A2), U161.10 (3B)
SN_8_1_1: U123.1 (S2), U125.14 (A3), U150.9 (3A)
SN_8_1_2: U123.13 (S3), U125.12 (A4), U161.12 (4A)
SN_8_1_3: U123.10 (S4), U126.5 (A1), U162.1 (1A)
SN_9_0_0: U124.4 (S1), U127.3 (A2), U162.5 (2B)
SN_9_0_1: U124.1 (S2), U127.14 (A3), U151.1 (1A)
SN_9_0_2: U124.13 (S3), U127.12 (A4), U162.9 (3A)
SN_9_0_3: U124.10 (S4), U128.5 (A1), U162.12 (4A)
SN_9_1_0: U125.4 (S1), U128.3 (A2), U162.13 (4B)
SN_9_1_1: U125.1 (S2), U128.14 (A3), U151.4 (2A)
SN_9_1_2: U125.13 (S3), U128.12 (A4), U163.1 (1A)
SN_9_1_3: U125.10 (S4), U129.5 (A1), U163.4 (2A)
SN_9_2_0: U126.4 (S1), U129.3 (A2), U163.5 (2B)
SN_9_2_1: U126.1 (S2), U129.14 (A3), U151.9 (3A)
SN_9_2_2: U126.13 (S3), U129.12 (A4), U163.9 (3A)
SN_9_2_3: U126.10 (S4), U139.12 (A4), U168.9 (3A)
SN_10_0_0: U127.4 (S1), U130.3 (A2), U163.13 (4B)
SN_10_0_1: U127.1 (S2), U130.14 (A3), U151.12 (4A)
SN_10_0_2: U127.13 (S3), U130.12 (A4), U164.1 (1A)
SN_10_0_3: U127.10 (S4), U131.5 (A1), U164.4 (2A)
SN_10_1_0: U128.4 (S1), U131.3 (A2), U164.5 (2B)
SN_10_1_1: U128.1 (S2), U131.14 (A3), U152.1 (1A)
SN_10_1_2: U128.13 (S3), U131.12 (A4), U164.9 (3A)
SN_10_1_3: U128.10 (S4), U132.5 (A1), U164.12 (4A)
SN_10_2_0: U129.4 (S1), U132.3 (A2), U164.13 (4B)
SN_10_2_1: U129.1 (S2), U132.14 (A3), U152.4 (2A)
SN_10_2_2: U129.13 (S3), U132.12 (A4), U165.1 (1A)
SN_10_2_3: U129.10 (S4), U139.14 (A3), U154.1 (1A)
SN_11_0_0: U130.4 (S1), U133.3 (A2), U165.5 (2B)
SN_11_0_1: U130.1 (S2), U133.14 (A3), U152.9 (3A)
SN_11_0_2: U130.13 (S3), U133.12 (A4), U165.9 (3A)
SN_11_0_3: U130.10 (S4), U134.5 (A1), U165.12 (4A)
SN_11_1_0: U131.4 (S1), U134.3 (A2), U165.13 (4B)
SN_11_1_1: U131.1 (S2), U134.14 (A3), U152.12 (4A)
SN_11_1_2: U131.13 (S3), U134.12 (A4), U166.1 (1A)
SN_11_1_3: U131.10 (S4), U135.5 (A1), U166.4 (2A)
SN_11_2_0: U132.4 (S1), U135.3 (A2), U166.5 (2B)
SN_11_2_1: U132.1 (S2), U135.14 (A3), U153.1 (1A)
SN_11_2_2: U132.13 (S3), U135.12 (A4), U166.9 (3A)
SN_11_2_3: U132.10 (S4), U139.3 (A2), U168.5 (2B)
SN_12_0_0: U133.4 (S1), U136.3 (A2), U166.13 (4B)
SN_12_0_1: U133.1 (S2), U136.14 (A3), U153.4 (2A)
SN_12_0_2: U133.13 (S3), U136.12 (A4), U167.1 (1A)
SN_12_0_3: U133.10 (S4), U137.5 (A1), U167.4 (2A)
SN_12_1_0: U134.4 (S1), U137.3 (A2), U167.5 (2B)
SN_12_1_1: U134.1 (S2), U137.14 (A3), U153.9 (3A)
SN_12_1_2: U134.13 (S3), U137.12 (A4), U167.9 (3A)
SN_12_1_3: U134.10 (S4), U138.5 (A1), U167.12 (4A)
SN_12_2_0: U135.4 (S1), U138.3 (A2), U167.13 (4B)
SN_12_2_1: U135.1 (S2), U138.14 (A3), U153.12 (4A)
SN_12_2_2: U135.13 (S3), U138.12 (A4), U168.1 (1A)
SN_12_2_3: U135.10 (S4), U139.5 (A1), U168.4 (2A)
SN_13_0_0: U136.4 (S1), U140.3 (A2), U168.13 (4B)
SN_13_0_1: U136.1 (S2), U140.14 (A3), U154.4 (2A)
SN_13_0_2: U136.13 (S3), U140.12 (A4), U169.1 (1A)
SN_13_0_3: U136.10 (S4), U141.5 (A1), U169.4 (2A)
SN_13_1_0: U137.4 (S1), U141.3 (A2), U169.5 (2B)
SN_13_1_1: U137.1 (S2), U141.14 (A3), U154.9 (3A)
SN_13_1_2: U137.13 (S3), U141.12 (A4), U169.9 (3A)
SN_13_1_3: U137.10 (S4), U142.5 (A1), U169.12 (4A)
SN_13_2_0: U138.4 (S1), U142.3 (A2), U169.13 (4B)
SN_13_2_1: U138.1 (S2), U142.14 (A3), U154.12 (4A)
SN_13_2_2: U138.13 (S3), U142.12 (A4), U170.1 (1A)
SN_13_2_3: U138.10 (S4), U143.5 (A1), U170.4 (2A)
SN_13_3_0: U139.4 (S1), U143.3 (A2), U170.5 (2B)
SN_13_3_1: U139.1 (S2), U143.14 (A3), U155.1 (1A)
SN_13_3_2: U139.13 (S3), U143.12 (A4), U170.9 (3A)
SN_13_3_3: U139.10 (S4)
SN_14_0_0: U140.4 (S1), U144.3 (A2), U170.13 (4B)
SN_14_0_1: U140.1 (S2), U144.14 (A3), U155.4 (2A)
SN_14_0_2: U140.13 (S3), U144.12 (A4), U171.1 (1A)
SN_14_0_3: U140.10 (S4), U145.5 (A1), U171.4 (2A)
SN_14_1_0: U141.4 (S1), U145.3 (A2), U171.5 (2B)
SN_14_1_1: U141.1 (S2), U145.14 (A3), U155.9 (3A)
SN_14_1_2: U141.13 (S3), U145.12 (A4), U171.9 (3A)
SN_14_1_3: U141.10 (S4), U146.5 (A1), U171.12 (4A)
SN_14_2_0: U142.4 (S1), U146.3 (A2), U171.13 (4B)
SN_14_2_1: U142.1 (S2), U146.14 (A3), U155.12 (4A)
SN_14_2_2: U142.13 (S3), U146.12 (A4), U172.1 (1A)
SN_14_2_3: U142.10 (S4), U147.5 (A1), U172.4 (2A)
SN_14_3_0: U143.4 (S1), U147.3 (A2), U172.5 (2B)
SN_14_3_1: U143.1 (S2), U147.14 (A3), U156.1 (1A)
SN_14_3_2: U143.13 (S3), U147.12 (A4), U172.9 (3A)
SN_14_3_3: U143.10 (S4)
SN_15_0_0: U144.4 (S1)
SN_15_0_1: U144.1 (S2)
SN_15_0_2: U144.13 (S3)
SN_15_0_3: U144.10 (S4)
SN_15_1_0: U145.4 (S1)
SN_15_1_1: U145.1 (S2)
SN_15_1_2: U145.13 (S3)
SN_15_1_3: U145.10 (S4)
SN_15_2_0: U146.4 (S1)
SN_15_2_1: U146.1 (S2)
SN_15_2_2: U146.13 (S3)
SN_15_2_3: U146.10 (S4)
SN_15_3_0: U147.4 (S1)
SN_15_3_1: U147.1 (S2)
SN_15_3_2: U147.13 (S3)
SN_15_3_3: U147.10 (S4)
SN_GE5_4_0: U116.2 (B2), U116.6 (B1), U157.8 (3Y)
SN_GE5_5_0: U117.2 (B2), U117.6 (B1), U158.3 (1Y)
SN_GE5_6_0: U118.2 (B2), U118.6 (B1), U158.8 (3Y)
SN_GE5_7_0: U120.2 (B2), U120.6 (B1), U159.6 (2Y)
SN_GE5_7_1: U121.2 (B2), U121.6 (B1), U159.11 (4Y)
SN_GE5_8_0: U122.2 (B2), U122.6 (B1), U160.6 (2Y)
SN_GE5_8_1: U123.2 (B2), U123.6 (B1), U160.11 (4Y)
SN_GE5_9_0: U124.2 (B2), U124.6 (B1), U161.6 (2Y)
SN_GE5_9_1: U125.2 (B2), U125.6 (B1), U161.11 (4Y)
SN_GE5_10_0: U127.2 (B2), U127.6 (B1), U162.8 (3Y)
SN_GE5_10_1: U128.2 (B2), U128.6 (B1), U163.3 (1Y)
SN_GE5_10_2: U129.2 (B2), U129.6 (B1), U163.8 (3Y)
SN_GE5_11_0: U130.2 (B2), U130.6 (B1), U164.3 (1Y)
SN_GE5_11_1: U131.2 (B2), U131.6 (B1), U164.8 (3Y)
SN_GE5_11_2: U132.2 (B2), U132.6 (B1), U165.3 (1Y)
SN_GE5_12_0: U133.2 (B2), U133.6 (B1), U165.8 (3Y)
SN_GE5_12_1: U134.2 (B2), U134.6 (B1), U166.3 (1Y)
SN_GE5_12_2: U135.2 (B2), U135.6 (B1), U166.8 (3Y)
SN_GE5_13_0: U136.2 (B2), U136.6 (B1), U167.3 (1Y)
SN_GE5_13_1: U137.2 (B2), U137.6 (B1), U167.8 (3Y)
SN_GE5_13_2: U138.2 (B2), U138.6 (B1), U168.3 (1Y)
SN_GE5_13_3: U139.2 (B2), U139.6 (B1), U168.8 (3Y)
SN_GE5_14_0: U140.2 (B2), U140.6 (B1), U169.3 (1Y)
SN_GE5_14_1: U141.2 (B2), U141.6 (B1), U169.8 (3Y)
SN_GE5_14_2: U142.2 (B2), U142.6 (B1), U170.3 (1Y)
SN_GE5_14_3: U143.2 (B2), U143.6 (B1), U170.8 (3Y)
SN_GE5_15_0: U144.2 (B2), U144.6 (B1), U171.3 (1Y)
SN_GE5_15_1: U145.2 (B2), U145.6 (B1), U171.8 (3Y)
SN_GE5_15_2: U146.2 (B2), U146.6 (B1), U172.3 (1Y)
SN_GE5_15_3: U147.2 (B2), U147.6 (B1), U172.8 (3Y)
SONUC1: U144.5 (A1), U170.12 (4A)
SONUC2: U140.5 (A1), U168.12 (4A)
SONUC3: U136.5 (A1), U166.12 (4A)
SONUC4: U133.5 (A1), U165.4 (2A)
SONUC5: U130.5 (A1), U163.12 (4A)
SONUC6: U127.5 (A1), U162.4 (2A)
SONUC7: U124.5 (A1), U161.1 (1A)
SONUC8: U122.5 (A1), U160.1 (1A)
SONUC9: U120.5 (A1), U159.1 (1A)
SONUC10: U118.5 (A1), U158.4 (2A)
SONUC11: U117.5 (A1), U157.12 (4A)
SONUC12: U116.5 (A1), U157.4 (2A)
SONUC13: U115.5 (A1), U157.1 (1A)
SONUC14: U115.3 (A2), U157.2 (1B)
SONUC15: U115.14 (A3), U148.1 (1A)
VCC: C116.1, C117.1, C118.1, C119.1, C120.1, C121.1, C122.1, C123.1, C124.1, C125.1, C126.1, C127.1, C128.1, C129.1, C130.1, C131.1, C132.1, C133.1, C134.1, C135.1, C136.1, C137.1, C138.1, C139.1, C140.1, C141.1, C142.1, C143.1, C144.1, C145.1, C146.1, C147.1, C148.1, C149.1, C150.1, C151.1, C152.1, C153.1, C154.1, C155.1, C156.1, C157.1, C158.1, C159.1, C160.1, C161.1, C162.1, C163.1, C164.1, C165.1, C166.1, C167.1, C168.1, C169.1, C170.1, C171.1, C172.1, C173.1, U115.16 (VCC), U116.16 (VCC), U117.16 (VCC), U118.16 (VCC), U119.16 (VCC), U120.16 (VCC), U121.16 (VCC), U122.16 (VCC), U123.16 (VCC), U124.16 (VCC), U125.16 (VCC), U126.16 (VCC), U127.16 (VCC), U128.16 (VCC), U129.16 (VCC), U130.16 (VCC), U131.16 (VCC), U132.16 (VCC), U133.16 (VCC), U134.16 (VCC), U135.16 (VCC), U136.16 (VCC), U137.16 (VCC), U138.16 (VCC), U139.16 (VCC), U140.16 (VCC), U141.16 (VCC), U142.16 (VCC), U143.16 (VCC), U144.16 (VCC), U145.16 (VCC), U146.16 (VCC), U147.16 (VCC), U148.14 (VCC), U149.14 (VCC), U150.14 (VCC), U151.14 (VCC), U152.14 (VCC), U153.14 (VCC), U154.14 (VCC), U155.14 (VCC), U156.14 (VCC), U157.14 (VCC), U158.14 (VCC), U159.14 (VCC), U160.14 (VCC), U161.14 (VCC), U162.14 (VCC), U163.14 (VCC), U164.14 (VCC), U165.14 (VCC), U166.14 (VCC), U167.14 (VCC), U168.14 (VCC), U169.14 (VCC), U170.14 (VCC), U171.14 (VCC), U172.14 (VCC)
