MihrimatriX/breadboarding/cpu16/kicad/hesap/hesap-secici.kicad_sch

## KiCad design cpu16/kicad/hesap/hesap-secici.kicad_sch (2026-10-12)

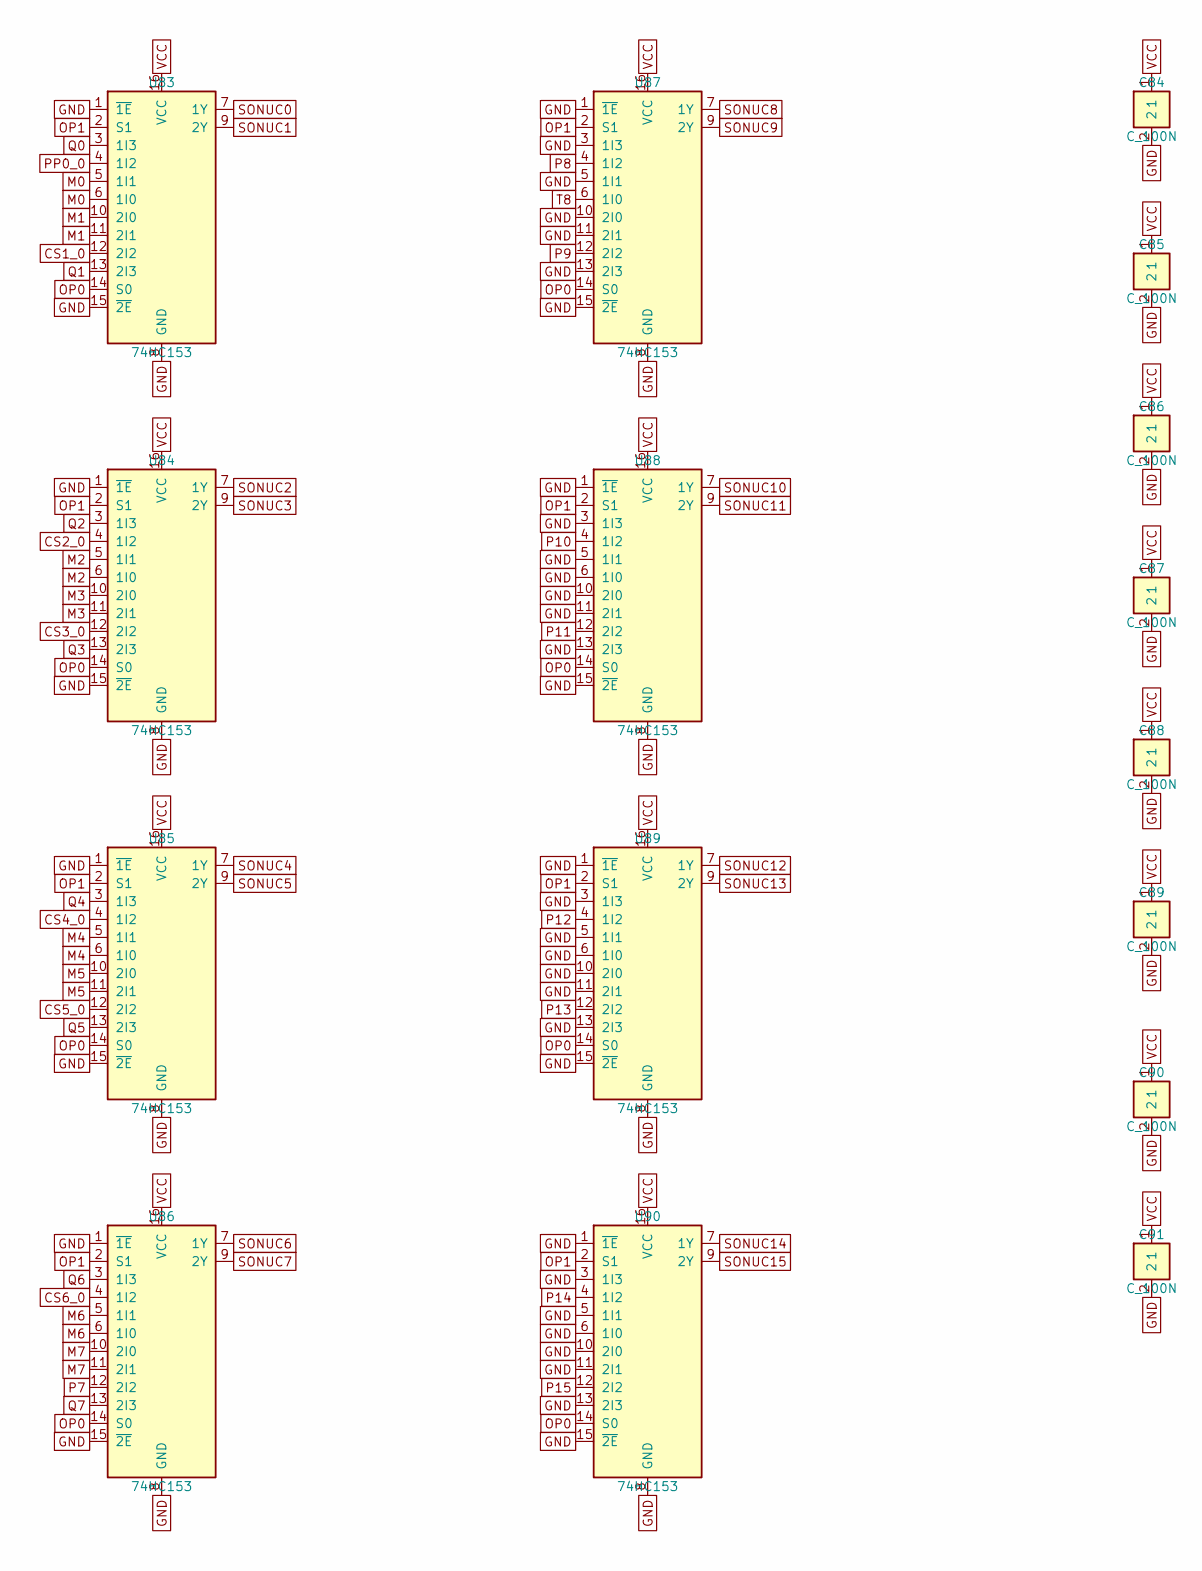
[picture p26: schematic hesap-secici.kicad_sch]

Parts:
C84, C85, C86, C87, C88, C89, C90, C91: C_100N; C_Disc_D5.0mm_W2.5mm_P5.00mm
U83, U84, U85, U86, U87, U88, U89, U90: 74HC153; DIP-16_W7.62mm

Connections:
CS1_0: U83.12 (2I2)
CS2_0: U84.4 (1I2)
CS3_0: U84.12 (2I2)
CS4_0: U85.4 (1I2)
CS5_0: U85.12 (2I2)
CS6_0: U86.4 (1I2)
GND: C84.2, C85.2, C86.2, C87.2, C88.2, C89.2, C90.2, C91.2, U83.1 (~1E), U83.8 (GND), U83.15 (~2E), U84.1 (~1E), U84.8 (GND), U84.15 (~2E), U85.1 (~1E), U85.8 (GND), U85.15 (~2E), U86.1 (~1E), U86.8 (GND), U86.15 (~2E), U87.1 (~1E), U87.3 (1I3), U87.5 (1I1), U87.8 (GND), U87.10 (2I0), U87.11 (2I1), U87.13 (2I3), U87.15 (~2E), U88.1 (~1E), U88.3 (1I3), U88.5 (1I1), U88.6 (1I0), U88.8 (GND), U88.10 (2I0), U88.11 (2I1), U88.13 (2I3), U88.15 (~2E), U89.1 (~1E), U89.3 (1I3), U89.5 (1I1), U89.6 (1I0), U89.8 (GND), U89.10 (2I0), U89.11 (2I1), U89.13 (2I3), U89.15 (~2E), U90.1 (~1E), U90.3 (1I3), U90.5 (1I1), U90.6 (1I0), U90.8 (GND), U90.10 (2I0), U90.11 (2I1), U90.13 (2I3), U90.15 (~2E)
M0: U83.5 (1I1), U83.6 (1I0)
M1: U83.10 (2I0), U83.11 (2I1)
M2: U84.5 (1I1), U84.6 (1I0)
M3: U84.10 (2I0), U84.11 (2I1)
M4: U85.5 (1I1), U85.6 (1I0)
M5: U85.10 (2I0), U85.11 (2I1)
M6: U86.5 (1I1), U86.6 (1I0)
M7: U86.10 (2I0), U86.11 (2I1)
OP0: U83.14 (S0), U84.14 (S0), U85.14 (S0), U86.14 (S0), U87.14 (S0), U88.14 (S0), U89.14 (S0), U90.14 (S0)
OP1: U83.2 (S1), U84.2 (S1), U85.2 (S1), U86.2 (S1), U87.2 (S1), U88.2 (S1), U89.2 (S1), U90.2 (S1)
P7: U86.12 (2I2)
P8: U87.4 (1I2)
P9: U87.12 (2I2)
P10: U88.4 (1I2)
P11: U88.12 (2I2)
P12: U89.4 (1I2)
P13: U89.12 (2I2)
P14: U90.4 (1I2)
P15: U90.12 (2I2)
PP0_0: U83.4 (1I2)
Q0: U83.3 (1I3)
Q1: U83.13 (2I3)
Q2: U84.3 (1I3)
Q3: U84.13 (2I3)
Q4: U85.3 (1I3)
Q5: U85.13 (2I3)
Q6: U86.3 (1I3)
Q7: U86.13 (2I3)
SONUC0: U83.7 (1Y)
SONUC1: U83.9 (2Y)
SONUC2: U84.7 (1Y)
SONUC3: U84.9 (2Y)
SONUC4: U85.7 (1Y)
SONUC5: U85.9 (2Y)
SONUC6: U86.7 (1Y)
SONUC7: U86.9 (2Y)
SONUC8: U87.7 (1Y)
SONUC9: U87.9 (2Y)
SONUC10: U88.7 (1Y)
SONUC11: U88.9 (2Y)
SONUC12: U89.7 (1Y)
SONUC13: U89.9 (2Y)
SONUC14: U90.7 (1Y)
SONUC15: U90.9 (2Y)
T8: U87.6 (1I0)
VCC: C84.1, C85.1, C86.1, C87.1, C88.1, C89.1, C90.1, C91.1, U83.16 (VCC), U84.16 (VCC), U85.16 (VCC), U86.16 (VCC), U87.16 (VCC), U88.16 (VCC), U89.16 (VCC), U90.16 (VCC)
