MihrimatriX/breadboarding/cpu16/kicad/hesap/hesap-toplama.kicad_sch

## KiCad design cpu16/kicad/hesap/hesap-toplama.kicad_sch (2026-10-12)

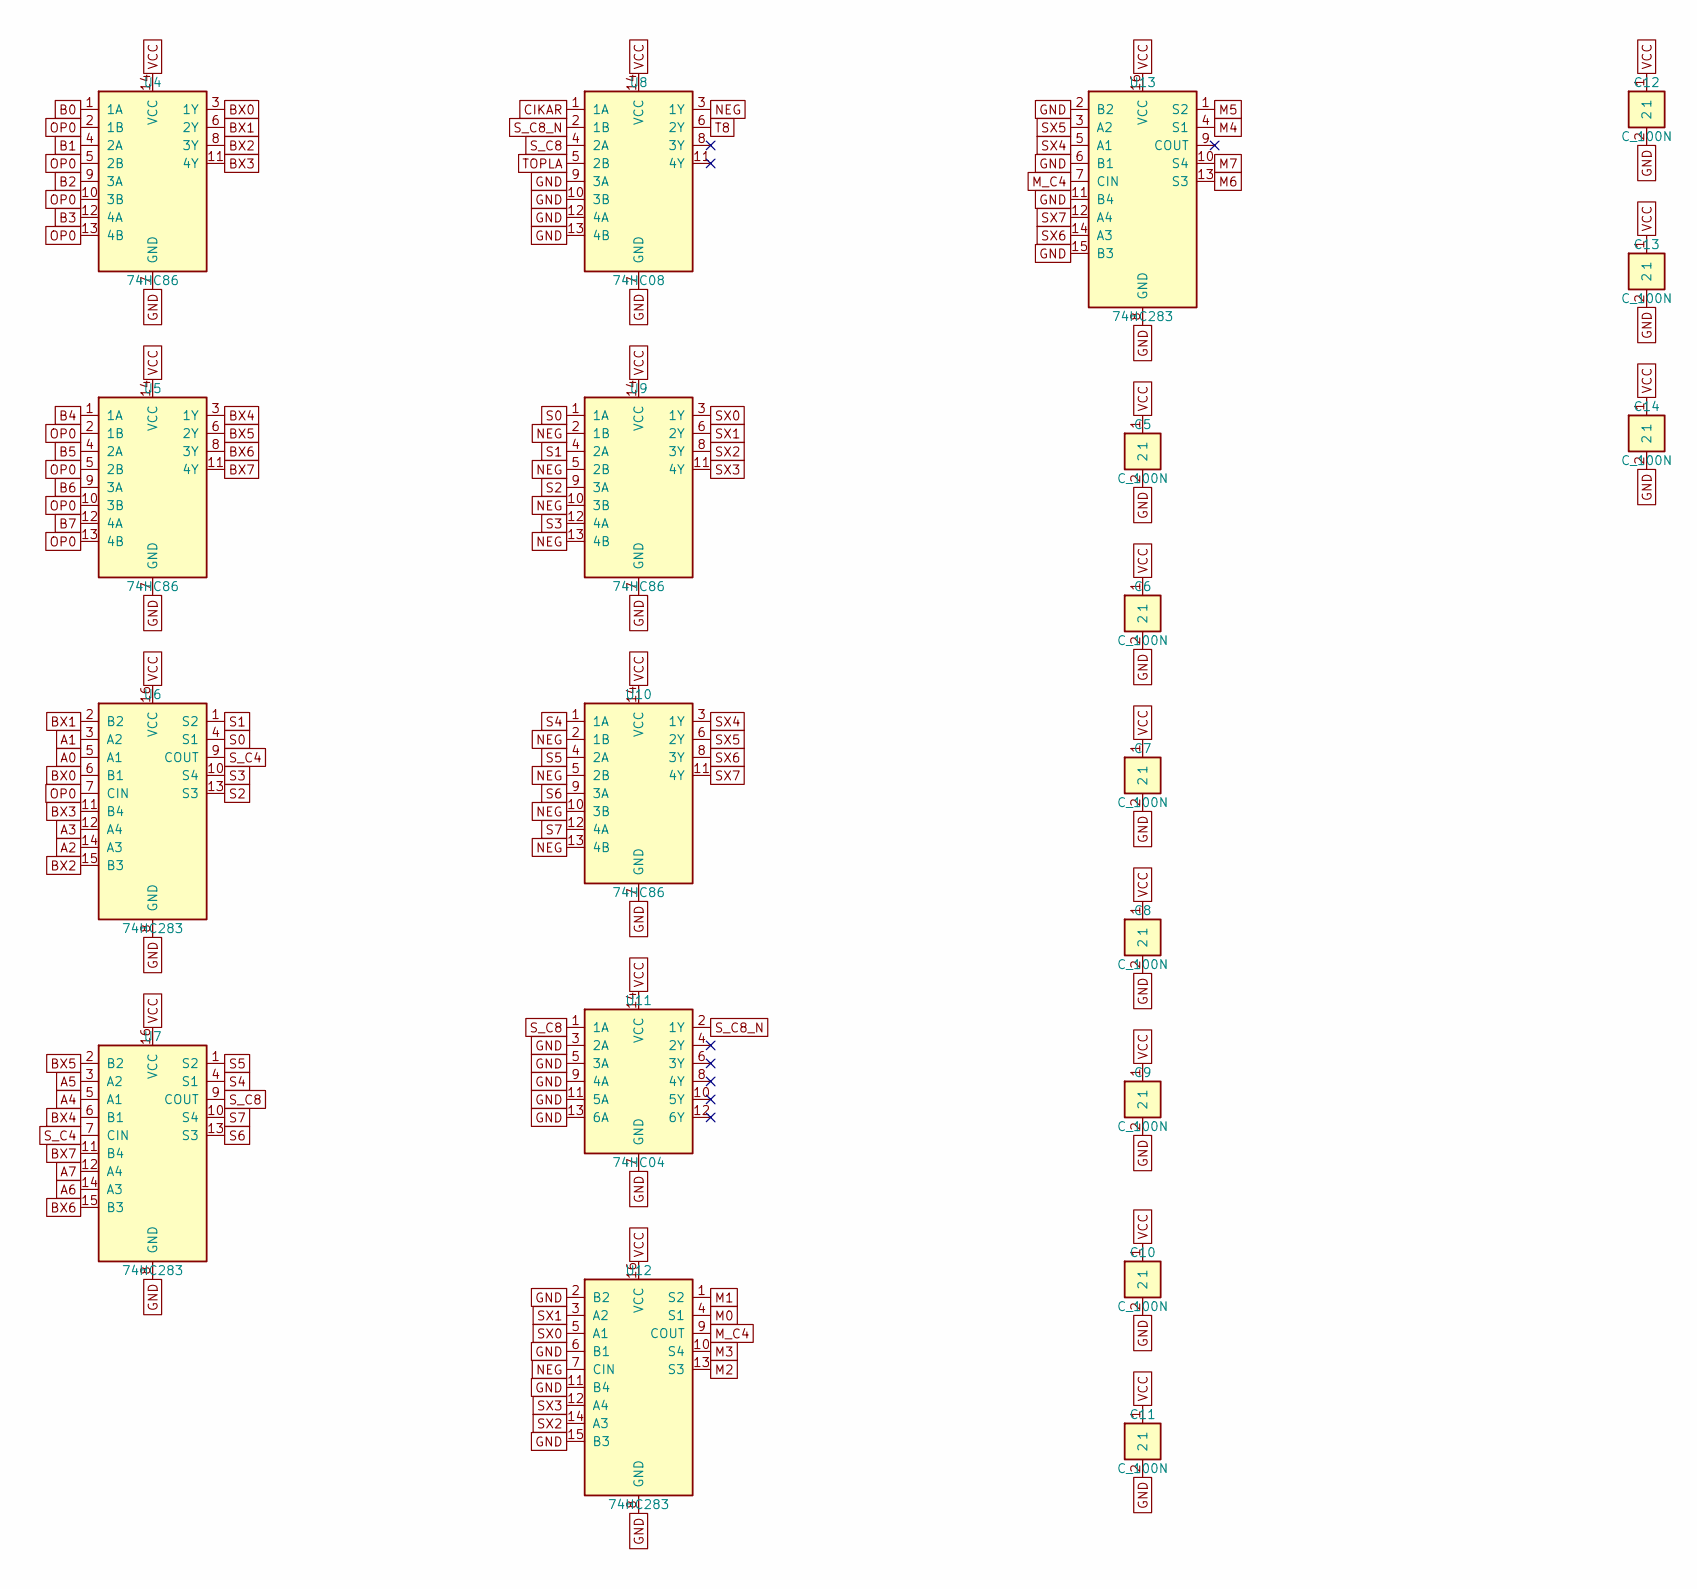
[picture p27: schematic hesap-toplama.kicad_sch]

Parts:
C5, C6, C7, C8, C9, C10, C11, C12, C13, C14: C_100N; C_Disc_D5.0mm_W2.5mm_P5.00mm
U4, U5, U9, U10: 74HC86; DIP-14_W7.62mm
U6, U7, U12, U13: 74HC283; DIP-16_W7.62mm
U8: 74HC08; DIP-14_W7.62mm
U11: 74HC04; DIP-14_W7.62mm

Connections:
A0: U6.5 (A1)
A1: U6.3 (A2)
A2: U6.14 (A3)
A3: U6.12 (A4)
A4: U7.5 (A1)
A5: U7.3 (A2)
A6: U7.14 (A3)
A7: U7.12 (A4)
B0: U4.1 (1A)
B1: U4.4 (2A)
B2: U4.9 (3A)
B3: U4.12 (4A)
B4: U5.1 (1A)
B5: U5.4 (2A)
B6: U5.9 (3A)
B7: U5.12 (4A)
BX0: U4.3 (1Y), U6.6 (B1)
BX1: U4.6 (2Y), U6.2 (B2)
BX2: U4.8 (3Y), U6.15 (B3)
BX3: U4.11 (4Y), U6.11 (B4)
BX4: U5.3 (1Y), U7.6 (B1)
BX5: U5.6 (2Y), U7.2 (B2)
BX6: U5.8 (3Y), U7.15 (B3)
BX7: U5.11 (4Y), U7.11 (B4)
CIKAR: U8.1 (1A)
GND: C5.2, C6.2, C7.2, C8.2, C9.2, C10.2, C11.2, C12.2, C13.2, C14.2, U4.7 (GND), U5.7 (GND), U6.8 (GND), U7.8 (GND), U8.7 (GND), U8.9 (3A), U8.10 (3B), U8.12 (4A), U8.13 (4B), U9.7 (GND), U10.7 (GND), U11.3 (2A), U11.5 (3A), U11.7 (GND), U11.9 (4A), U11.11 (5A), U11.13 (6A), U12.2 (B2), U12.6 (B1), U12.8 (GND), U12.11 (B4), U12.15 (B3), U13.2 (B2), U13.6 (B1), U13.8 (GND), U13.11 (B4), U13.15 (B3)
M0: U12.4 (S1)
M1: U12.1 (S2)
M2: U12.13 (S3)
M3: U12.10 (S4)
M4: U13.4 (S1)
M5: U13.1 (S2)
M6: U13.13 (S3)
M7: U13.10 (S4)
M_C4: U12.9 (COUT), U13.7 (CIN)
NEG: U8.3 (1Y), U9.2 (1B), U9.5 (2B), U9.10 (3B), U9.13 (4B), U10.2 (1B), U10.5 (2B), U10.10 (3B), U10.13 (4B), U12.7 (CIN)
OP0: U4.2 (1B), U4.5 (2B), U4.10 (3B), U4.13 (4B), U5.2 (1B), U5.5 (2B), U5.10 (3B), U5.13 (4B), U6.7 (CIN)
S0: U6.4 (S1), U9.1 (1A)
S1: U6.1 (S2), U9.4 (2A)
S2: U6.13 (S3), U9.9 (3A)
S3: U6.10 (S4), U9.12 (4A)
S4: U7.4 (S1), U10.1 (1A)
S5: U7.1 (S2), U10.4 (2A)
S6: U7.13 (S3), U10.9 (3A)
S7: U7.10 (S4), U10.12 (4A)
SX0: U9.3 (1Y), U12.5 (A1)
SX1: U9.6 (2Y), U12.3 (A2)
SX2: U9.8 (3Y), U12.14 (A3)
SX3: U9.11 (4Y), U12.12 (A4)
SX4: U10.3 (1Y), U13.5 (A1)
SX5: U10.6 (2Y), U13.3 (A2)
SX6: U10.8 (3Y), U13.14 (A3)
SX7: U10.11 (4Y), U13.12 (A4)
S_C4: U6.9 (COUT), U7.7 (CIN)
S_C8: U7.9 (COUT), U8.4 (2A), U11.1 (1A)
S_C8_N: U8.2 (1B), U11.2 (1Y)
T8: U8.6 (2Y)
TOPLA: U8.5 (2B)
VCC: C5.1, C6.1, C7.1, C8.1, C9.1, C10.1, C11.1, C12.1, C13.1, C14.1, U4.14 (VCC), U5.14 (VCC), U6.16 (VCC), U7.16 (VCC), U8.14 (VCC), U9.14 (VCC), U10.14 (VCC), U11.14 (VCC), U12.16 (VCC), U13.16 (VCC)
