MihrimatriX/breadboarding/cpu16/kicad/kyb/kyb.kicad_sch

## KiCad design cpu16/kicad/kyb/kyb.kicad_sch (2026-10-11)

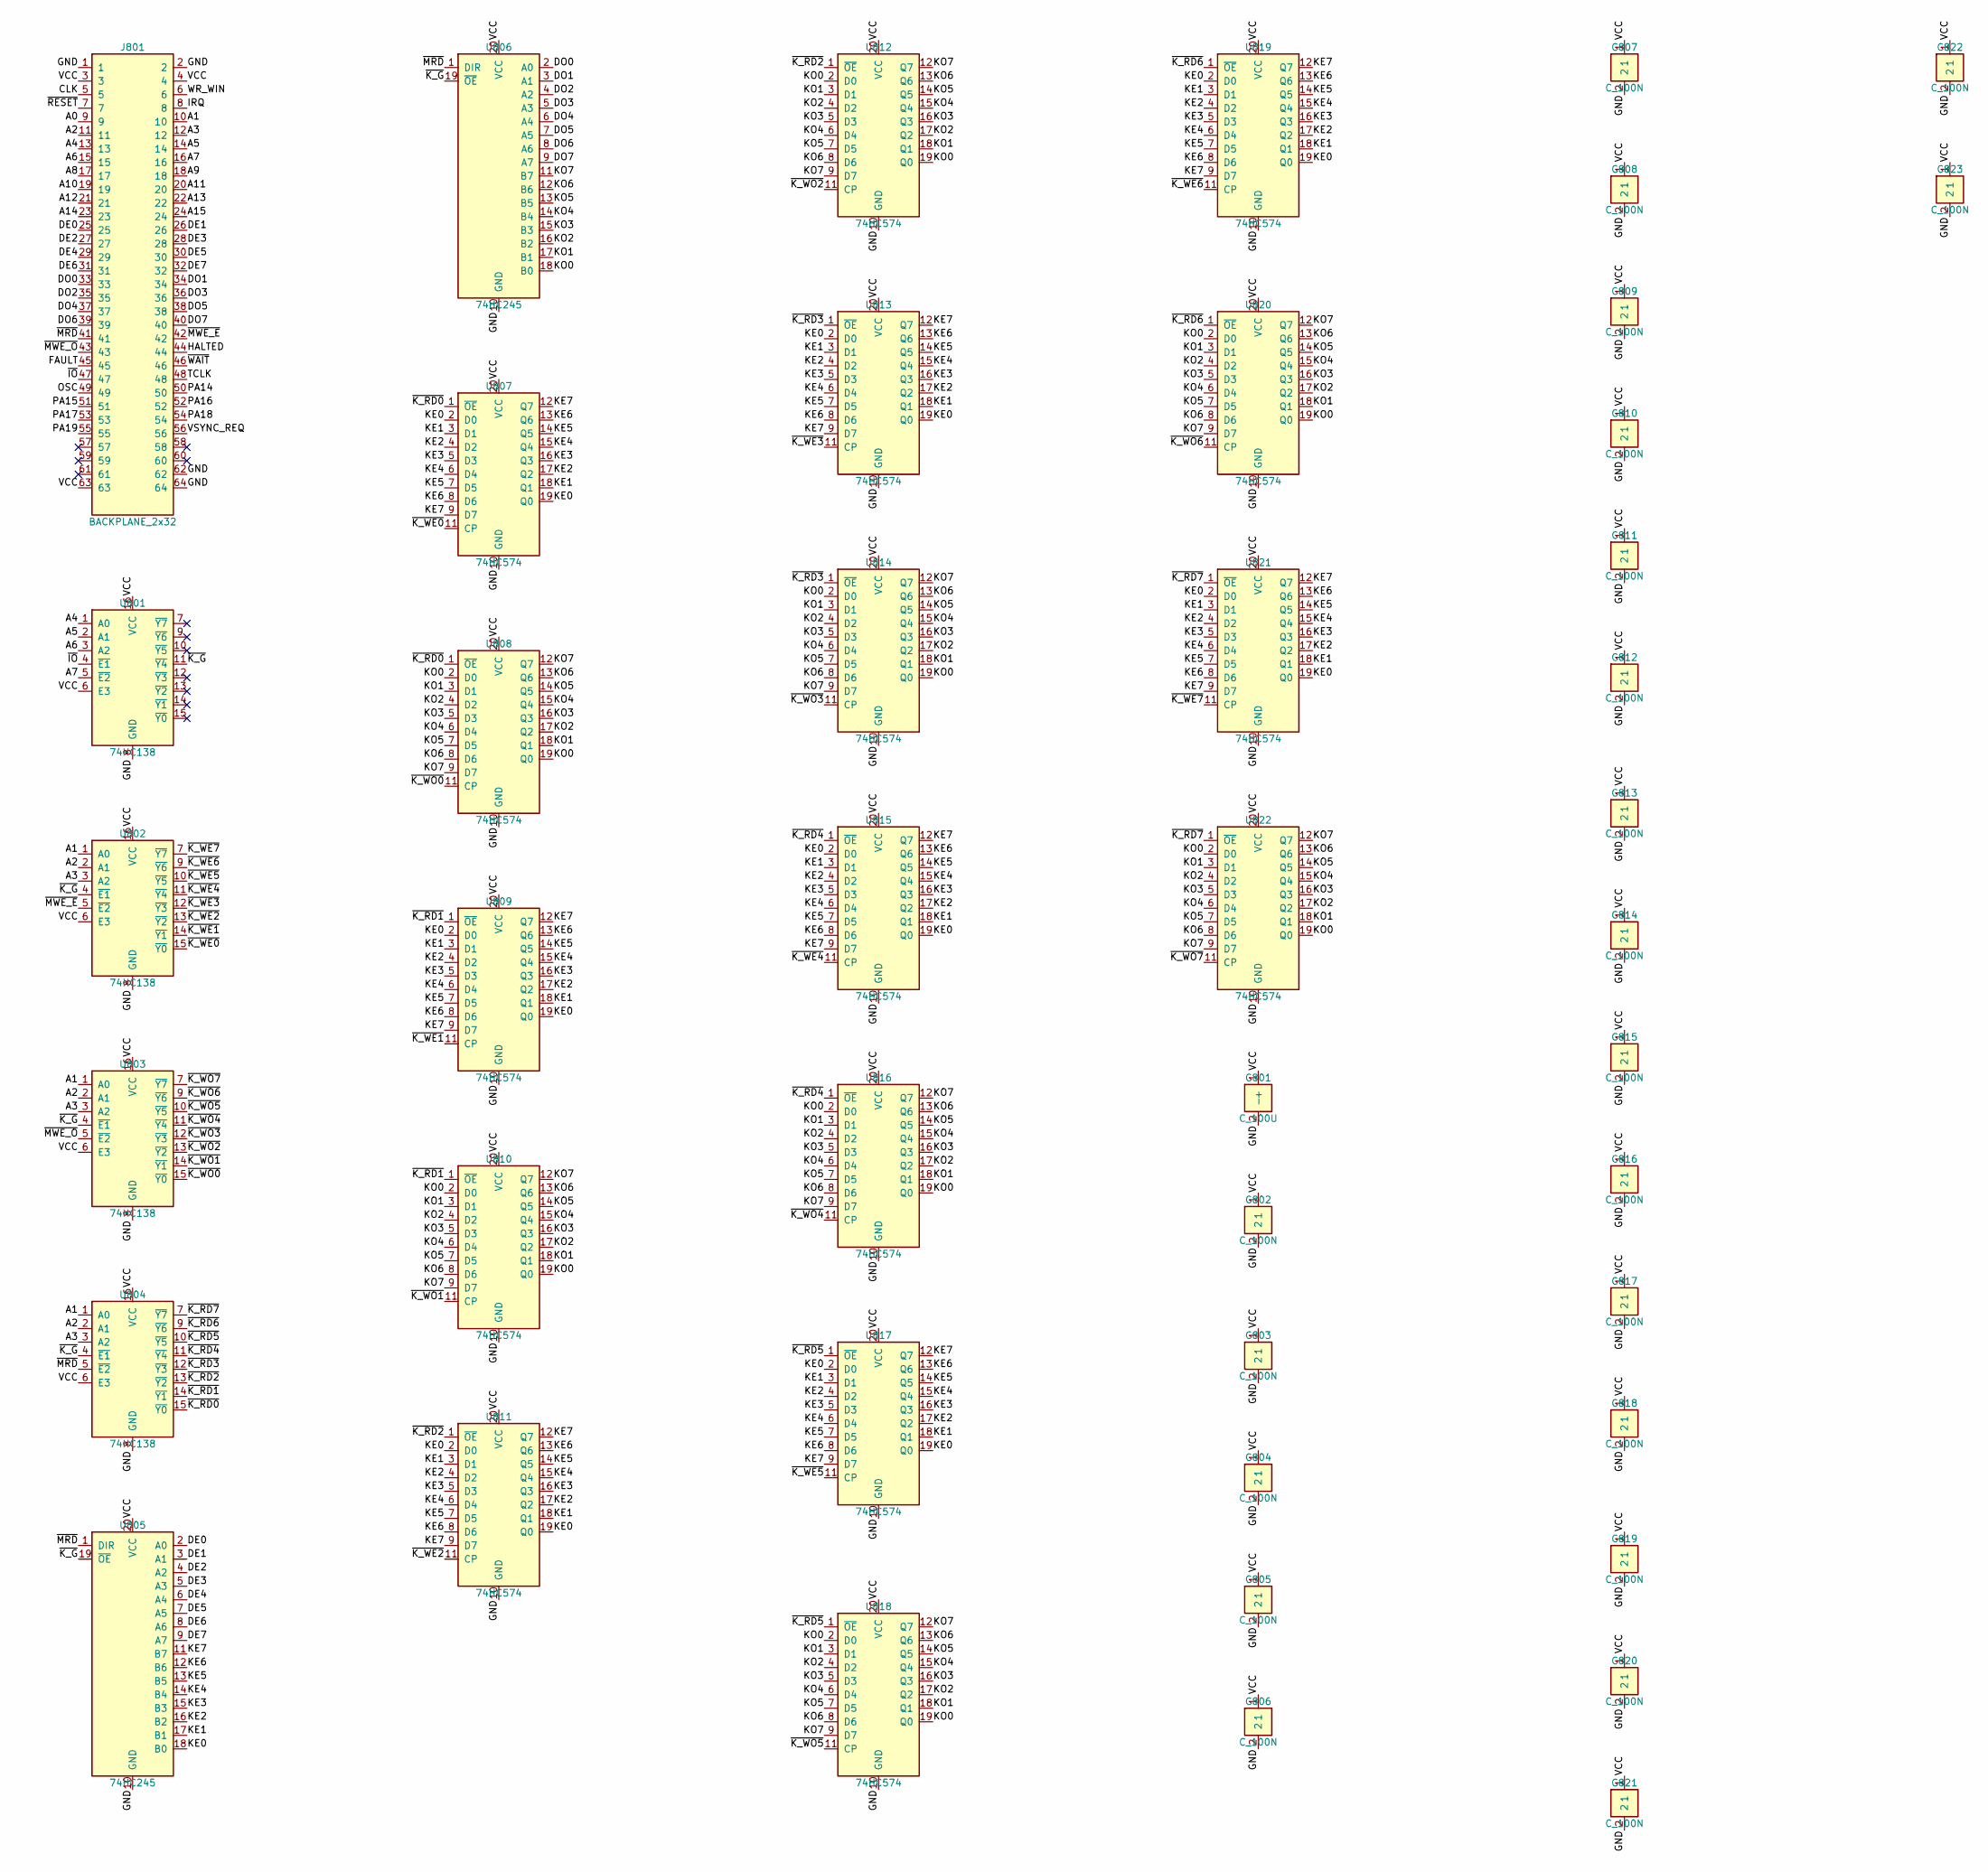
[picture p28: schematic kyb.kicad_sch]

Parts:
C801: C_100U; CP_Radial_D6.3mm_P2.50mm
C802, C803, C804, C805, C806, C807, C808, C809, C810, C811, C812, C813, C814, C815, C816, C817, C818, C819, C820, C821, C822, C823: C_100N; C_Disc_D5.0mm_W2.5mm_P5.00mm
J801: BACKPLANE_2x32; PinHeader_2x32_P2.54mm_Vertical
U801, U802, U803, U804: 74HC138; DIP-16_W7.62mm
U805, U806: 74HC245; DIP-20_W7.62mm
U807, U808, U809, U810, U811, U812, U813, U814, U815, U816, U817, U818, U819, U820, U821, U822: 74HC574; DIP-20_W7.62mm

Connections:
A0: J801.9
A1: J801.10, U802.1 (A0), U803.1 (A0), U804.1 (A0)
A2: J801.11, U802.2 (A1), U803.2 (A1), U804.2 (A1)
A3: J801.12, U802.3 (A2), U803.3 (A2), U804.3 (A2)
A4: J801.13, U801.1 (A0)
A5: J801.14, U801.2 (A1)
A6: J801.15, U801.3 (A2)
A7: J801.16, U801.5 (~E2)
A8: J801.17
A9: J801.18
A10: J801.19
A11: J801.20
A12: J801.21
A13: J801.22
A14: J801.23
A15: J801.24
CLK: J801.5
DE0: J801.25, U805.2 (A0)
DE1: J801.26, U805.3 (A1)
DE2: J801.27, U805.4 (A2)
DE3: J801.28, U805.5 (A3)
DE4: J801.29, U805.6 (A4)
DE5: J801.30, U805.7 (A5)
DE6: J801.31, U805.8 (A6)
DE7: J801.32, U805.9 (A7)
DO0: J801.33, U806.2 (A0)
DO1: J801.34, U806.3 (A1)
DO2: J801.35, U806.4 (A2)
DO3: J801.36, U806.5 (A3)
DO4: J801.37, U806.6 (A4)
DO5: J801.38, U806.7 (A5)
DO6: J801.39, U806.8 (A6)
DO7: J801.40, U806.9 (A7)
FAULT: J801.45
GND: C801.2 (-), C802.2, C803.2, C804.2, C805.2, C806.2, C807.2, C808.2, C809.2, C810.2, C811.2, C812.2, C813.2, C814.2, C815.2, C816.2, C817.2, C818.2, C819.2, C820.2, C821.2, C822.2, C823.2, J801.1, J801.2, J801.62, J801.64, U801.8 (GND), U802.8 (GND), U803.8 (GND), U804.8 (GND), U805.10 (GND), U806.10 (GND), U807.10 (GND), U808.10 (GND), U809.10 (GND), U810.10 (GND), U811.10 (GND), U812.10 (GND), U813.10 (GND), U814.10 (GND), U815.10 (GND), U816.10 (GND), U817.10 (GND), U818.10 (GND), U819.10 (GND), U820.10 (GND), U821.10 (GND), U822.10 (GND)
HALTED: J801.44
IRQ: J801.8
KE0: U805.18 (B0), U807.2 (D0), U807.19 (Q0), U809.2 (D0), U809.19 (Q0), U811.2 (D0), U811.19 (Q0), U813.2 (D0), U813.19 (Q0), U815.2 (D0), U815.19 (Q0), U817.2 (D0), U817.19 (Q0), U819.2 (D0), U819.19 (Q0), U821.2 (D0), U821.19 (Q0)
KE1: U805.17 (B1), U807.3 (D1), U807.18 (Q1), U809.3 (D1), U809.18 (Q1), U811.3 (D1), U811.18 (Q1), U813.3 (D1), U813.18 (Q1), U815.3 (D1), U815.18 (Q1), U817.3 (D1), U817.18 (Q1), U819.3 (D1), U819.18 (Q1), U821.3 (D1), U821.18 (Q1)
KE2: U805.16 (B2), U807.4 (D2), U807.17 (Q2), U809.4 (D2), U809.17 (Q2), U811.4 (D2), U811.17 (Q2), U813.4 (D2), U813.17 (Q2), U815.4 (D2), U815.17 (Q2), U817.4 (D2), U817.17 (Q2), U819.4 (D2), U819.17 (Q2), U821.4 (D2), U821.17 (Q2)
KE3: U805.15 (B3), U807.5 (D3), U807.16 (Q3), U809.5 (D3), U809.16 (Q3), U811.5 (D3), U811.16 (Q3), U813.5 (D3), U813.16 (Q3), U815.5 (D3), U815.16 (Q3), U817.5 (D3), U817.16 (Q3), U819.5 (D3), U819.16 (Q3), U821.5 (D3), U821.16 (Q3)
KE4: U805.14 (B4), U807.6 (D4), U807.15 (Q4), U809.6 (D4), U809.15 (Q4), U811.6 (D4), U811.15 (Q4), U813.6 (D4), U813.15 (Q4), U815.6 (D4), U815.15 (Q4), U817.6 (D4), U817.15 (Q4), U819.6 (D4), U819.15 (Q4), U821.6 (D4), U821.15 (Q4)
KE5: U805.13 (B5), U807.7 (D5), U807.14 (Q5), U809.7 (D5), U809.14 (Q5), U811.7 (D5), U811.14 (Q5), U813.7 (D5), U813.14 (Q5), U815.7 (D5), U815.14 (Q5), U817.7 (D5), U817.14 (Q5), U819.7 (D5), U819.14 (Q5), U821.7 (D5), U821.14 (Q5)
KE6: U805.12 (B6), U807.8 (D6), U807.13 (Q6), U809.8 (D6), U809.13 (Q6), U811.8 (D6), U811.13 (Q6), U813.8 (D6), U813.13 (Q6), U815.8 (D6), U815.13 (Q6), U817.8 (D6), U817.13 (Q6), U819.8 (D6), U819.13 (Q6), U821.8 (D6), U821.13 (Q6)
KE7: U805.11 (B7), U807.9 (D7), U807.12 (Q7), U809.9 (D7), U809.12 (Q7), U811.9 (D7), U811.12 (Q7), U813.9 (D7), U813.12 (Q7), U815.9 (D7), U815.12 (Q7), U817.9 (D7), U817.12 (Q7), U819.9 (D7), U819.12 (Q7), U821.9 (D7), U821.12 (Q7)
KO0: U806.18 (B0), U808.2 (D0), U808.19 (Q0), U810.2 (D0), U810.19 (Q0), U812.2 (D0), U812.19 (Q0), U814.2 (D0), U814.19 (Q0), U816.2 (D0), U816.19 (Q0), U818.2 (D0), U818.19 (Q0), U820.2 (D0), U820.19 (Q0), U822.2 (D0), U822.19 (Q0)
KO1: U806.17 (B1), U808.3 (D1), U808.18 (Q1), U810.3 (D1), U810.18 (Q1), U812.3 (D1), U812.18 (Q1), U814.3 (D1), U814.18 (Q1), U816.3 (D1), U816.18 (Q1), U818.3 (D1), U818.18 (Q1), U820.3 (D1), U820.18 (Q1), U822.3 (D1), U822.18 (Q1)
KO2: U806.16 (B2), U808.4 (D2), U808.17 (Q2), U810.4 (D2), U810.17 (Q2), U812.4 (D2), U812.17 (Q2), U814.4 (D2), U814.17 (Q2), U816.4 (D2), U816.17 (Q2), U818.4 (D2), U818.17 (Q2), U820.4 (D2), U820.17 (Q2), U822.4 (D2), U822.17 (Q2)
KO3: U806.15 (B3), U808.5 (D3), U808.16 (Q3), U810.5 (D3), U810.16 (Q3), U812.5 (D3), U812.16 (Q3), U814.5 (D3), U814.16 (Q3), U816.5 (D3), U816.16 (Q3), U818.5 (D3), U818.16 (Q3), U820.5 (D3), U820.16 (Q3), U822.5 (D3), U822.16 (Q3)
KO4: U806.14 (B4), U808.6 (D4), U808.15 (Q4), U810.6 (D4), U810.15 (Q4), U812.6 (D4), U812.15 (Q4), U814.6 (D4), U814.15 (Q4), U816.6 (D4), U816.15 (Q4), U818.6 (D4), U818.15 (Q4), U820.6 (D4), U820.15 (Q4), U822.6 (D4), U822.15 (Q4)
KO5: U806.13 (B5), U808.7 (D5), U808.14 (Q5), U810.7 (D5), U810.14 (Q5), U812.7 (D5), U812.14 (Q5), U814.7 (D5), U814.14 (Q5), U816.7 (D5), U816.14 (Q5), U818.7 (D5), U818.14 (Q5), U820.7 (D5), U820.14 (Q5), U822.7 (D5), U822.14 (Q5)
KO6: U806.12 (B6), U808.8 (D6), U808.13 (Q6), U810.8 (D6), U810.13 (Q6), U812.8 (D6), U812.13 (Q6), U814.8 (D6), U814.13 (Q6), U816.8 (D6), U816.13 (Q6), U818.8 (D6), U818.13 (Q6), U820.8 (D6), U820.13 (Q6), U822.8 (D6), U822.13 (Q6)
KO7: U806.11 (B7), U808.9 (D7), U808.12 (Q7), U810.9 (D7), U810.12 (Q7), U812.9 (D7), U812.12 (Q7), U814.9 (D7), U814.12 (Q7), U816.9 (D7), U816.12 (Q7), U818.9 (D7), U818.12 (Q7), U820.9 (D7), U820.12 (Q7), U822.9 (D7), U822.12 (Q7)
OSC: J801.49
PA14: J801.50
PA15: J801.51
PA16: J801.52
PA17: J801.53
PA18: J801.54
PA19: J801.55
TCLK: J801.48
VCC: C801.1 (+), C802.1, C803.1, C804.1, C805.1, C806.1, C807.1, C808.1, C809.1, C810.1, C811.1, C812.1, C813.1, C814.1, C815.1, C816.1, C817.1, C818.1, C819.1, C820.1, C821.1, C822.1, C823.1, J801.3, J801.4, J801.63, U801.6 (E3), U801.16 (VCC), U802.6 (E3), U802.16 (VCC), U803.6 (E3), U803.16 (VCC), U804.6 (E3), U804.16 (VCC), U805.20 (VCC), U806.20 (VCC), U807.20 (VCC), U808.20 (VCC), U809.20 (VCC), U810.20 (VCC), U811.20 (VCC), U812.20 (VCC), U813.20 (VCC), U814.20 (VCC), U815.20 (VCC), U816.20 (VCC), U817.20 (VCC), U818.20 (VCC), U819.20 (VCC), U820.20 (VCC), U821.20 (VCC), U822.20 (VCC)
VSYNC_REQ: J801.56
WR_WIN: J801.6
~IO: J801.47, U801.4 (~E1)
~K_G: U801.11 (~Y4), U802.4 (~E1), U803.4 (~E1), U804.4 (~E1), U805.19 (~OE), U806.19 (~OE)
~K_RD0: U804.15 (~Y0), U807.1 (~OE), U808.1 (~OE)
~K_RD1: U804.14 (~Y1), U809.1 (~OE), U810.1 (~OE)
~K_RD2: U804.13 (~Y2), U811.1 (~OE), U812.1 (~OE)
~K_RD3: U804.12 (~Y3), U813.1 (~OE), U814.1 (~OE)
~K_RD4: U804.11 (~Y4), U815.1 (~OE), U816.1 (~OE)
~K_RD5: U804.10 (~Y5), U817.1 (~OE), U818.1 (~OE)
~K_RD6: U804.9 (~Y6), U819.1 (~OE), U820.1 (~OE)
~K_RD7: U804.7 (~Y7), U821.1 (~OE), U822.1 (~OE)
~K_WE0: U802.15 (~Y0), U807.11 (CP)
~K_WE1: U802.14 (~Y1), U809.11 (CP)
~K_WE2: U802.13 (~Y2), U811.11 (CP)
~K_WE3: U802.12 (~Y3), U813.11 (CP)
~K_WE4: U802.11 (~Y4), U815.11 (CP)
~K_WE5: U802.10 (~Y5), U817.11 (CP)
~K_WE6: U802.9 (~Y6), U819.11 (CP)
~K_WE7: U802.7 (~Y7), U821.11 (CP)
~K_WO0: U803.15 (~Y0), U808.11 (CP)
~K_WO1: U803.14 (~Y1), U810.11 (CP)
~K_WO2: U803.13 (~Y2), U812.11 (CP)
~K_WO3: U803.12 (~Y3), U814.11 (CP)
~K_WO4: U803.11 (~Y4), U816.11 (CP)
~K_WO5: U803.10 (~Y5), U818.11 (CP)
~K_WO6: U803.9 (~Y6), U820.11 (CP)
~K_WO7: U803.7 (~Y7), U822.11 (CP)
~MRD: J801.41, U804.5 (~E2), U805.1 (DIR), U806.1 (DIR)
~MWE_E: J801.42, U802.5 (~E2)
~MWE_O: J801.43, U803.5 (~E2)
~RESET: J801.7
~WAIT: J801.46
