MihrimatriX/breadboarding/cpu16/kicad/mem/mem.kicad_sch

## KiCad design cpu16/kicad/mem/mem.kicad_sch (2026-10-11)

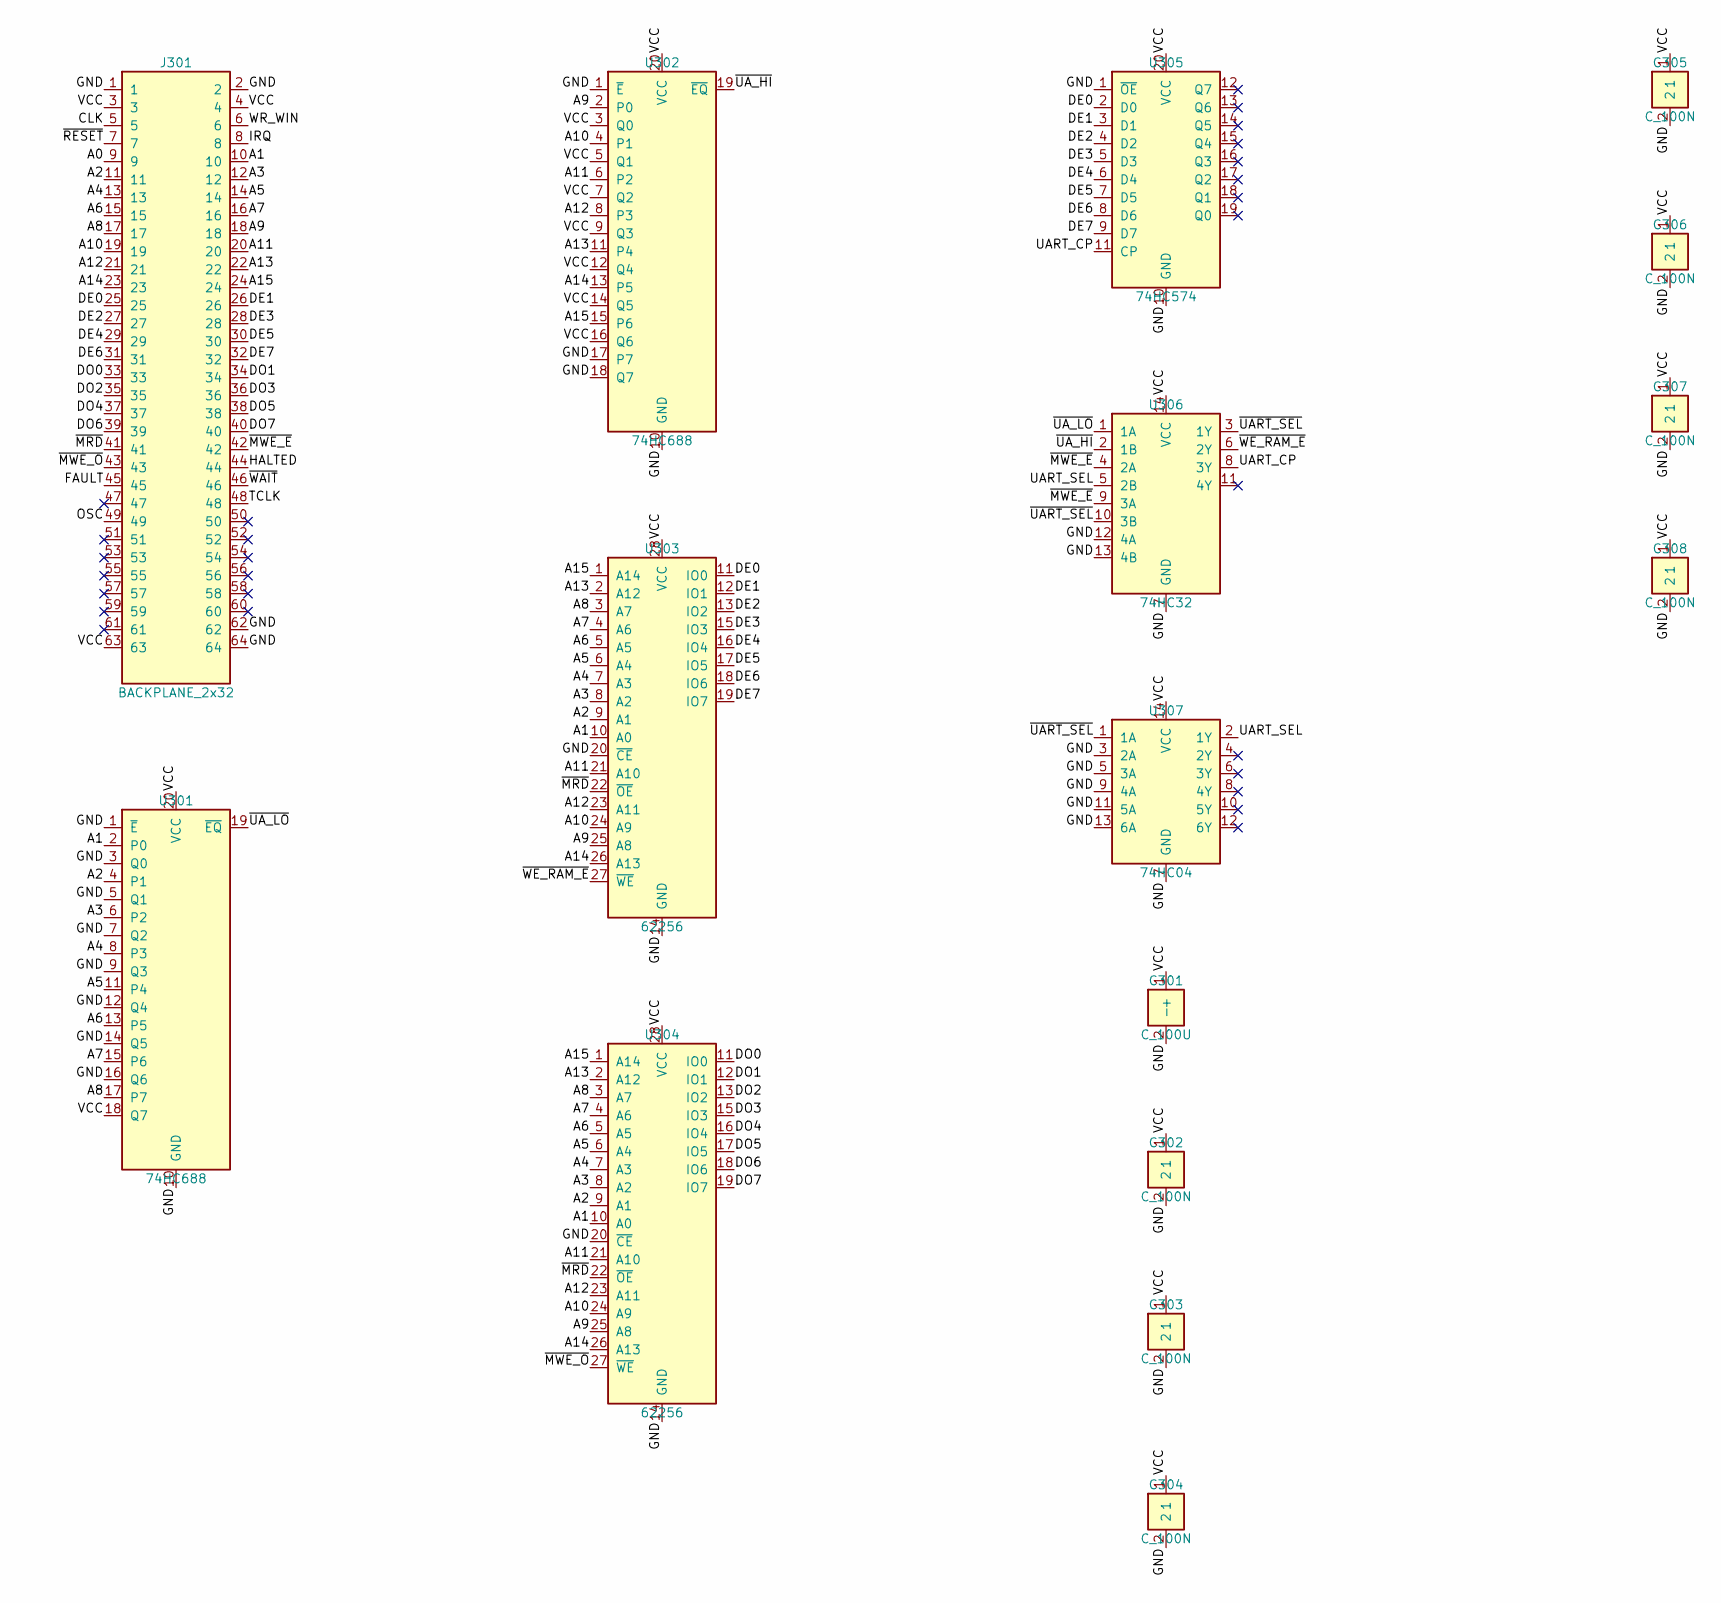
[picture p29: schematic mem.kicad_sch]

Parts:
C301: C_100U; CP_Radial_D6.3mm_P2.50mm
C302, C303, C304, C305, C306, C307, C308: C_100N; C_Disc_D5.0mm_W2.5mm_P5.00mm
J301: BACKPLANE_2x32; PinHeader_2x32_P2.54mm_Vertical
U301, U302: 74HC688; DIP-20_W7.62mm
U303, U304: 62256; DIP-28_W15.24mm
U305: 74HC574; DIP-20_W7.62mm
U306: 74HC32; DIP-14_W7.62mm
U307: 74HC04; DIP-14_W7.62mm

Connections:
A0: J301.9
A1: J301.10, U301.2 (P0), U303.10 (A0), U304.10 (A0)
A2: J301.11, U301.4 (P1), U303.9 (A1), U304.9 (A1)
A3: J301.12, U301.6 (P2), U303.8 (A2), U304.8 (A2)
A4: J301.13, U301.8 (P3), U303.7 (A3), U304.7 (A3)
A5: J301.14, U301.11 (P4), U303.6 (A4), U304.6 (A4)
A6: J301.15, U301.13 (P5), U303.5 (A5), U304.5 (A5)
A7: J301.16, U301.15 (P6), U303.4 (A6), U304.4 (A6)
A8: J301.17, U301.17 (P7), U303.3 (A7), U304.3 (A7)
A9: J301.18, U302.2 (P0), U303.25 (A8), U304.25 (A8)
A10: J301.19, U302.4 (P1), U303.24 (A9), U304.24 (A9)
A11: J301.20, U302.6 (P2), U303.21 (A10), U304.21 (A10)
A12: J301.21, U302.8 (P3), U303.23 (A11), U304.23 (A11)
A13: J301.22, U302.11 (P4), U303.2 (A12), U304.2 (A12)
A14: J301.23, U302.13 (P5), U303.26 (A13), U304.26 (A13)
A15: J301.24, U302.15 (P6), U303.1 (A14), U304.1 (A14)
CLK: J301.5
DE0: J301.25, U303.11 (IO0), U305.2 (D0)
DE1: J301.26, U303.12 (IO1), U305.3 (D1)
DE2: J301.27, U303.13 (IO2), U305.4 (D2)
DE3: J301.28, U303.15 (IO3), U305.5 (D3)
DE4: J301.29, U303.16 (IO4), U305.6 (D4)
DE5: J301.30, U303.17 (IO5), U305.7 (D5)
DE6: J301.31, U303.18 (IO6), U305.8 (D6)
DE7: J301.32, U303.19 (IO7), U305.9 (D7)
DO0: J301.33, U304.11 (IO0)
DO1: J301.34, U304.12 (IO1)
DO2: J301.35, U304.13 (IO2)
DO3: J301.36, U304.15 (IO3)
DO4: J301.37, U304.16 (IO4)
DO5: J301.38, U304.17 (IO5)
DO6: J301.39, U304.18 (IO6)
DO7: J301.40, U304.19 (IO7)
FAULT: J301.45
GND: C301.2 (-), C302.2, C303.2, C304.2, C305.2, C306.2, C307.2, C308.2, J301.1, J301.2, J301.62, J301.64, U301.1 (~E), U301.3 (Q0), U301.5 (Q1), U301.7 (Q2), U301.9 (Q3), U301.10 (GND), U301.12 (Q4), U301.14 (Q5), U301.16 (Q6), U302.1 (~E), U302.10 (GND), U302.17 (P7), U302.18 (Q7), U303.14 (GND), U303.20 (~CE), U304.14 (GND), U304.20 (~CE), U305.1 (~OE), U305.10 (GND), U306.7 (GND), U306.12 (4A), U306.13 (4B), U307.3 (2A), U307.5 (3A), U307.7 (GND), U307.9 (4A), U307.11 (5A), U307.13 (6A)
HALTED: J301.44
IRQ: J301.8
OSC: J301.49
TCLK: J301.48
UART_CP: U305.11 (CP), U306.8 (3Y)
UART_SEL: U306.5 (2B), U307.2 (1Y)
VCC: C301.1 (+), C302.1, C303.1, C304.1, C305.1, C306.1, C307.1, C308.1, J301.3, J301.4, J301.63, U301.18 (Q7), U301.20 (VCC), U302.3 (Q0), U302.5 (Q1), U302.7 (Q2), U302.9 (Q3), U302.12 (Q4), U302.14 (Q5), U302.16 (Q6), U302.20 (VCC), U303.28 (VCC), U304.28 (VCC), U305.20 (VCC), U306.14 (VCC), U307.14 (VCC)
WR_WIN: J301.6
~MRD: J301.41, U303.22 (~OE), U304.22 (~OE)
~MWE_E: J301.42, U306.4 (2A), U306.9 (3A)
~MWE_O: J301.43, U304.27 (~WE)
~RESET: J301.7
~UART_SEL: U306.3 (1Y), U306.10 (3B), U307.1 (1A)
~UA_HI: U302.19 (~EQ), U306.2 (1B)
~UA_LO: U301.19 (~EQ), U306.1 (1A)
~WAIT: J301.46
~WE_RAM_E: U303.27 (~WE), U306.6 (2Y)
