MihrimatriX/breadboarding/cpu16/kicad/onbellek/onbellek.kicad_sch

## KiCad design cpu16/kicad/onbellek/onbellek.kicad_sch (2026-10-12)

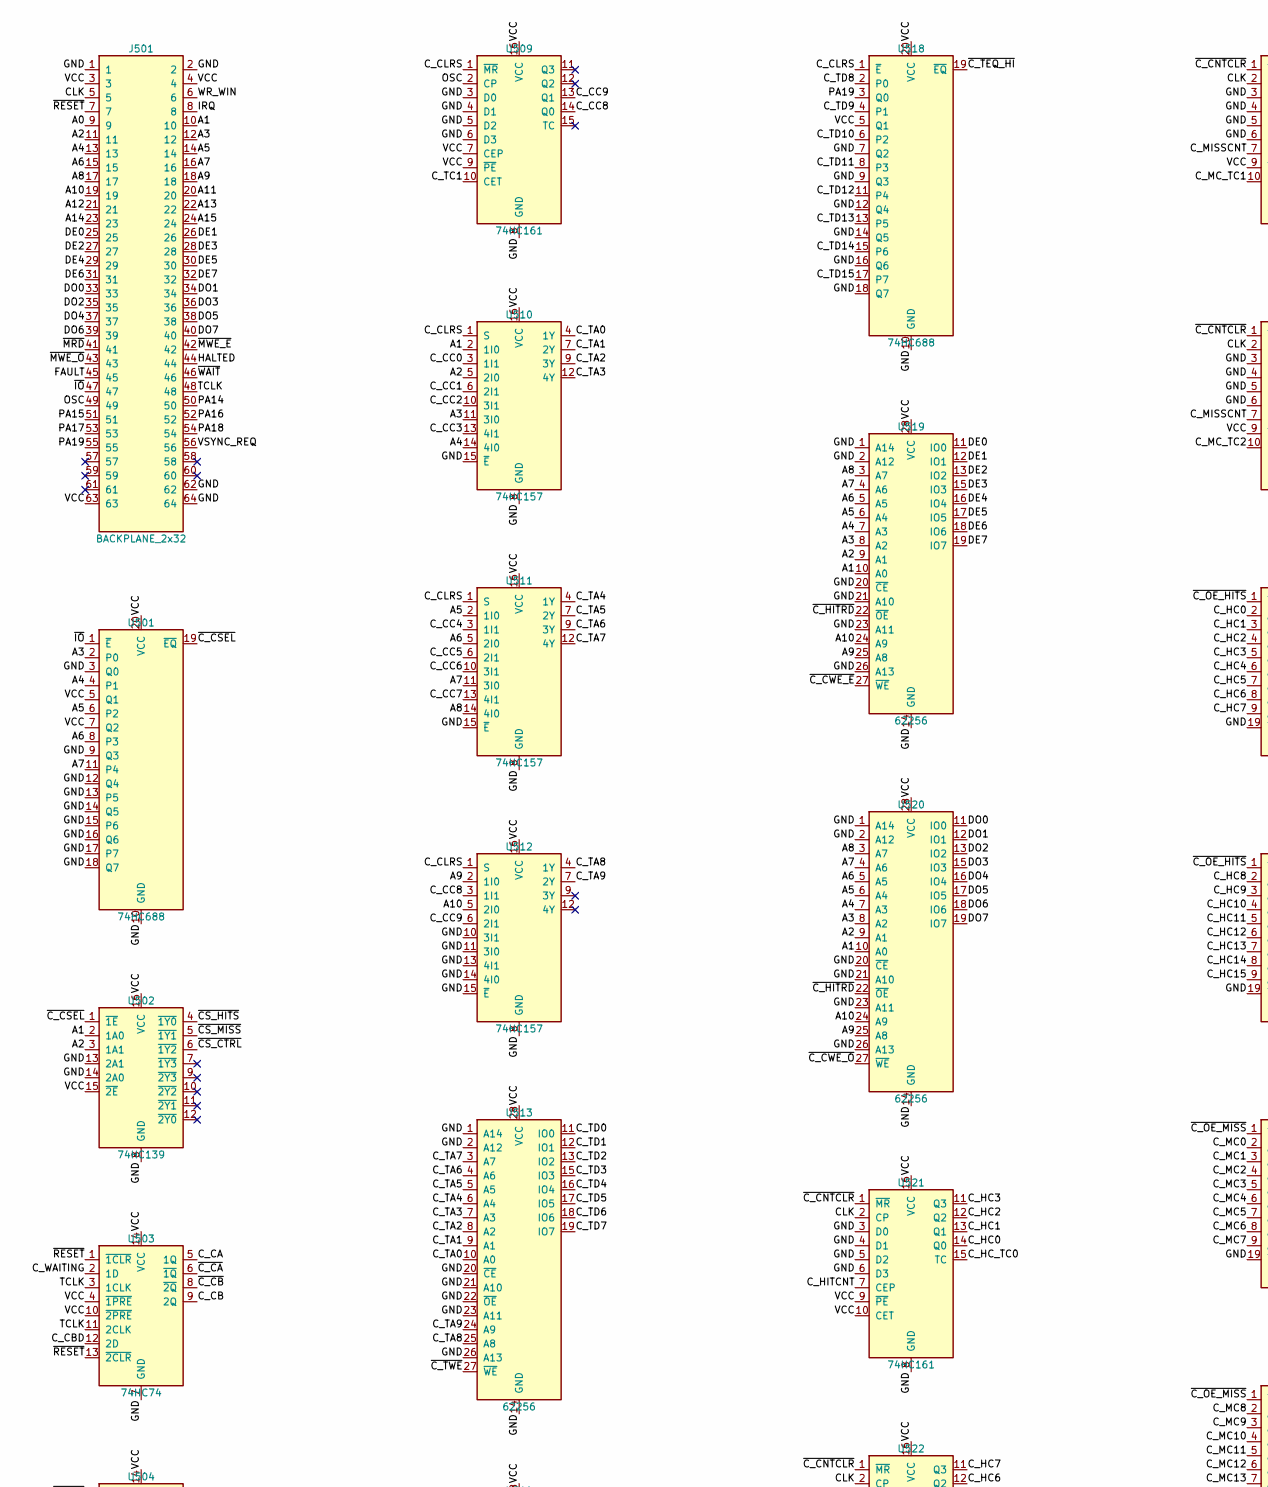
[picture p30: schematic onbellek.kicad_sch, part in row 1, column 1]

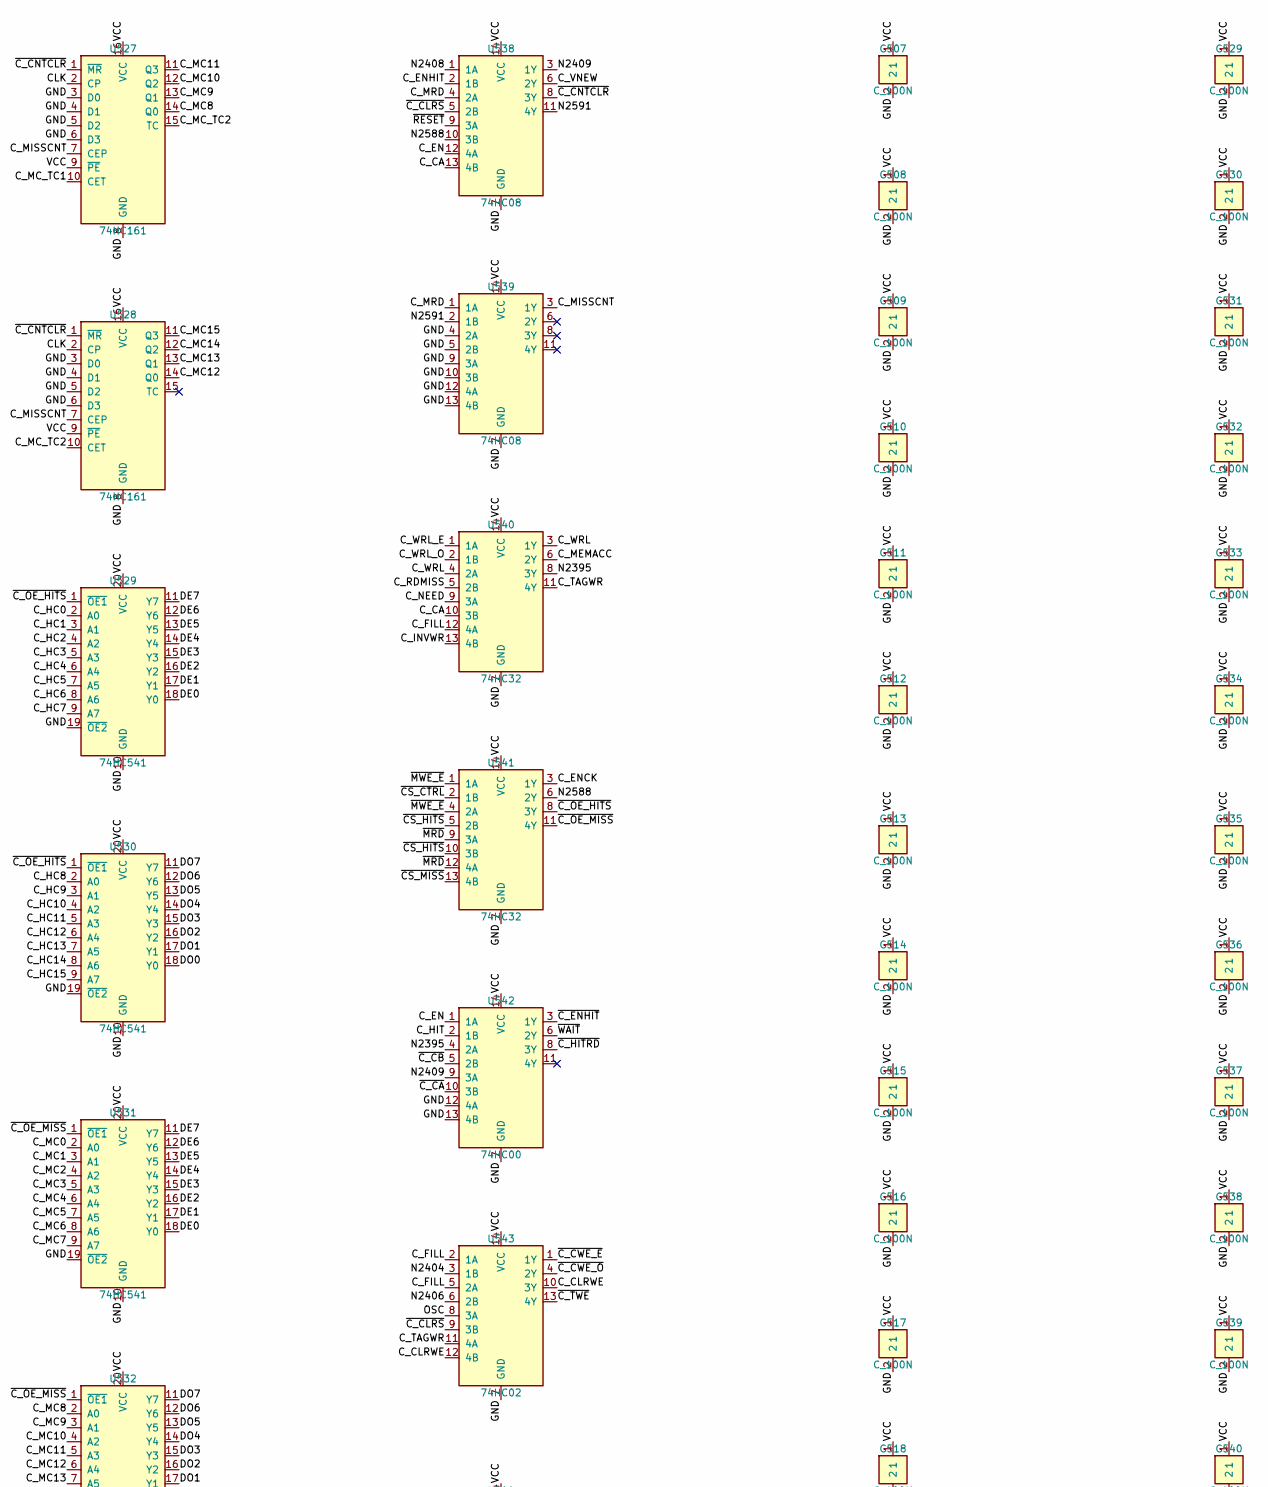
[picture p31: schematic onbellek.kicad_sch, part in row 1, column 2]

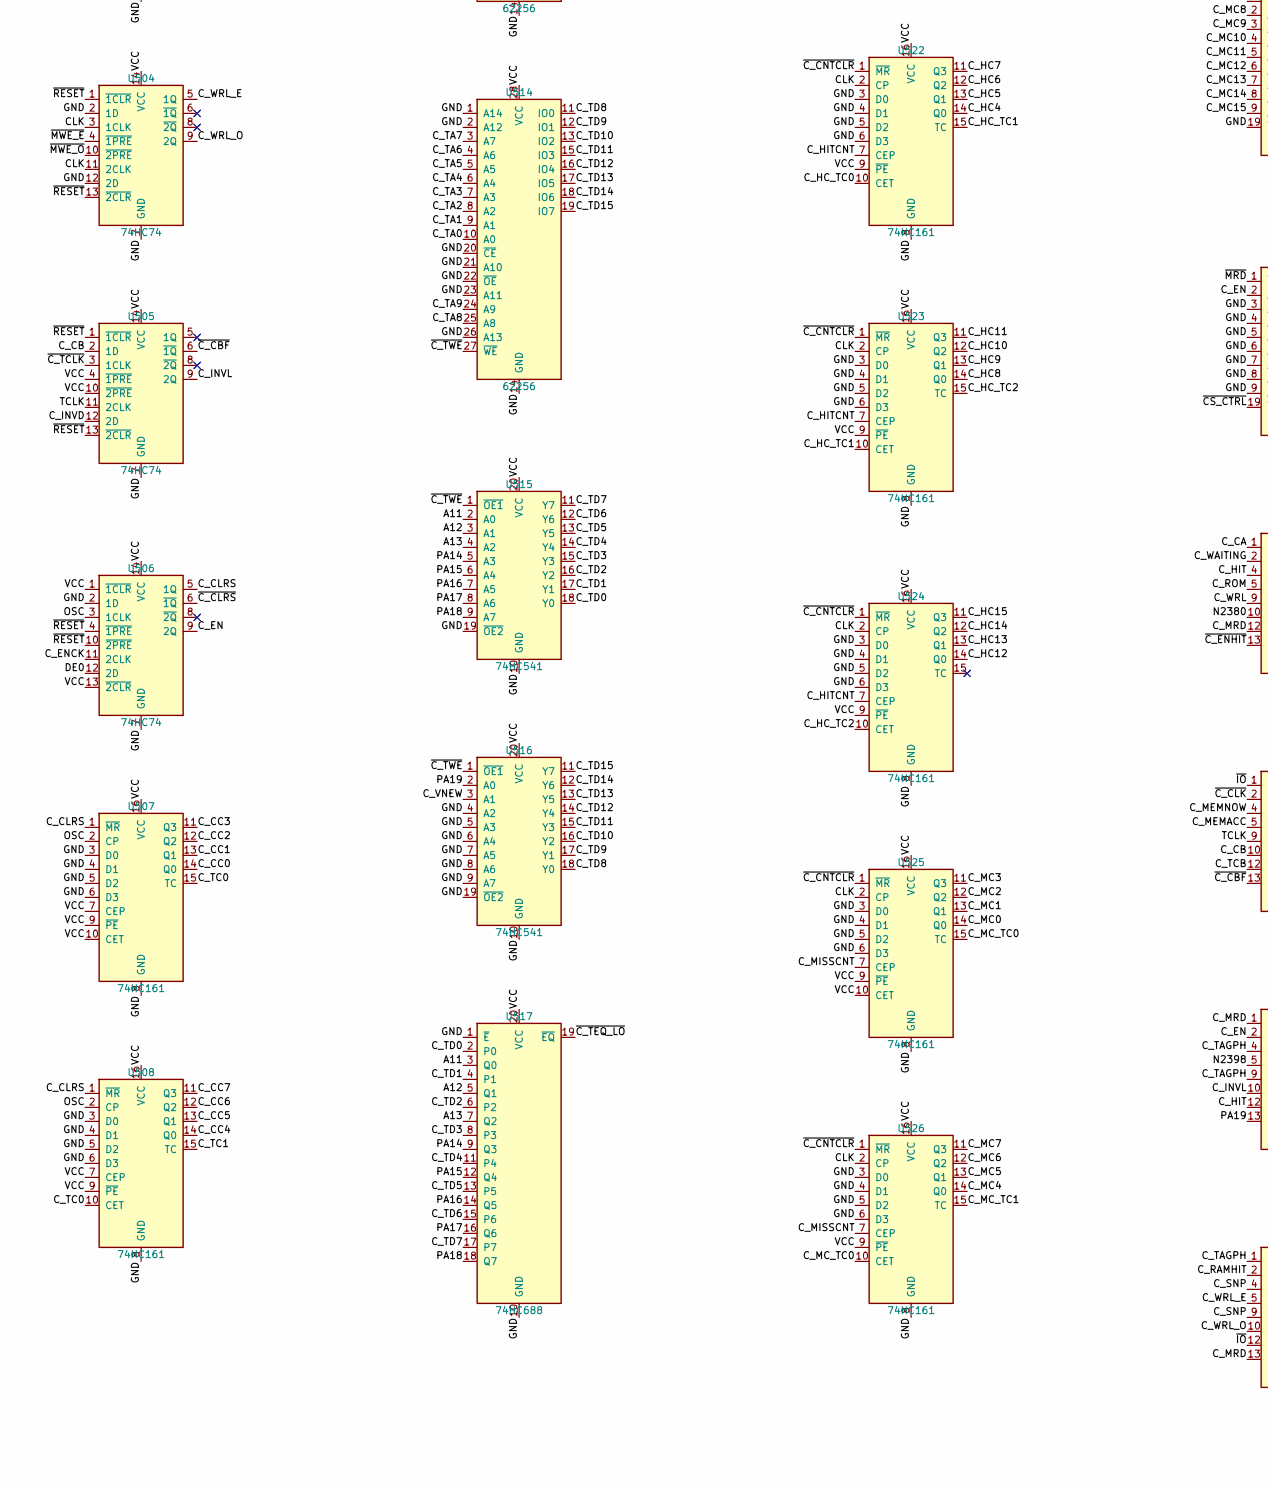
[picture p32: schematic onbellek.kicad_sch, part in row 2, column 1]

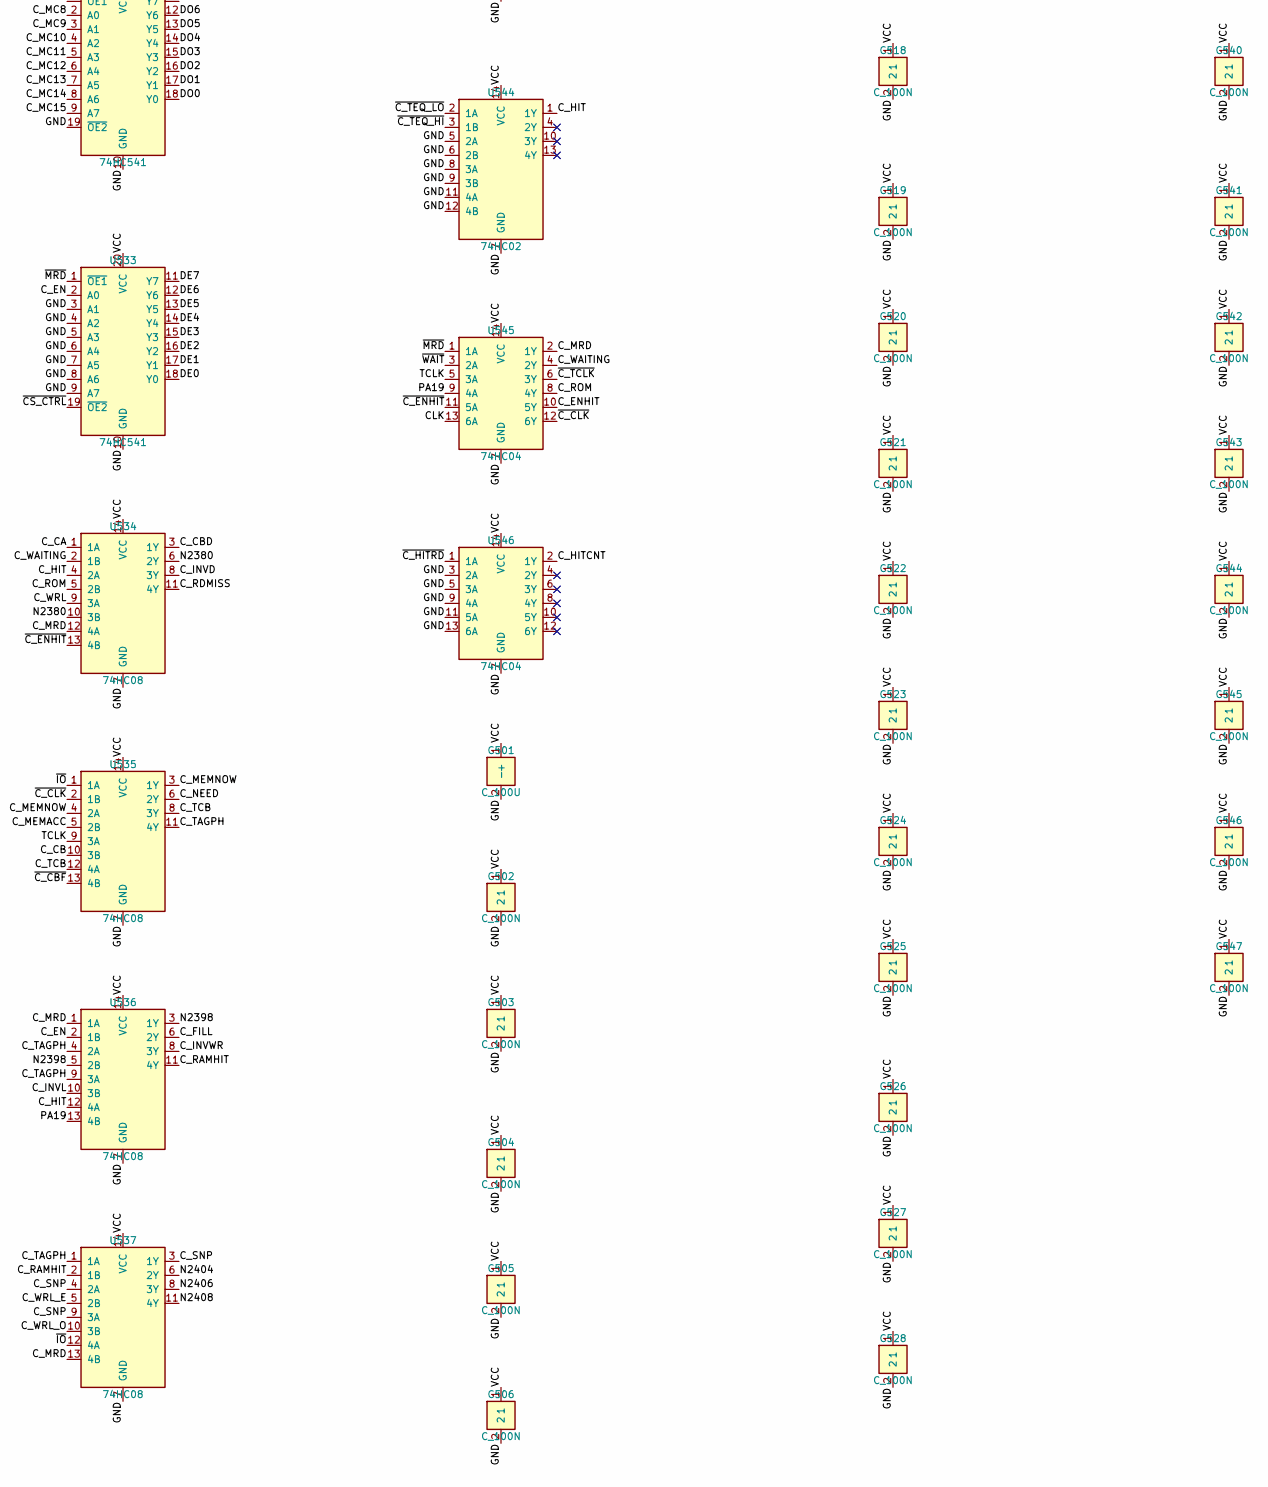
[picture p33: schematic onbellek.kicad_sch, part in row 2, column 2]

Parts:
C501: C_100U; CP_Radial_D6.3mm_P2.50mm
C502, C503, C504, C505, C506, C507, C508, C509, C510, C511, C512, C513, C514, C515, C516, C517, C518, C519, C520, C521, C522, C523, C524, C525, C526, C527, C528, C529, C530, C531, C532, C533, C534, C535, C536, C537, C538, C539, C540, C541, C542, C543, C544, C545, C546, C547: C_100N; C_Disc_D5.0mm_W2.5mm_P5.00mm
J501: BACKPLANE_2x32; PinHeader_2x32_P2.54mm_Vertical
U501, U517, U518: 74HC688; DIP-20_W7.62mm
U502: 74HC139; DIP-16_W7.62mm
U503, U504, U505, U506: 74HC74; DIP-14_W7.62mm
U507, U508, U509, U521, U522, U523, U524, U525, U526, U527, U528: 74HC161; DIP-16_W7.62mm
U510, U511, U512: 74HC157; DIP-16_W7.62mm
U513, U514, U519, U520: 62256; DIP-28_W15.24mm
U515, U516, U529, U530, U531, U532, U533: 74HC541; DIP-20_W7.62mm
U534, U535, U536, U537, U538, U539: 74HC08; DIP-14_W7.62mm
U540, U541: 74HC32; DIP-14_W7.62mm
U542: 74HC00; DIP-14_W7.62mm
U543, U544: 74HC02; DIP-14_W7.62mm
U545, U546: 74HC04; DIP-14_W7.62mm

Connections:
A0: J501.9
A1: J501.10, U502.2 (1A0), U510.2 (1I0), U519.10 (A0), U520.10 (A0)
A2: J501.11, U502.3 (1A1), U510.5 (2I0), U519.9 (A1), U520.9 (A1)
A3: J501.12, U501.2 (P0), U510.11 (3I0), U519.8 (A2), U520.8 (A2)
A4: J501.13, U501.4 (P1), U510.14 (4I0), U519.7 (A3), U520.7 (A3)
A5: J501.14, U501.6 (P2), U511.2 (1I0), U519.6 (A4), U520.6 (A4)
A6: J501.15, U501.8 (P3), U511.5 (2I0), U519.5 (A5), U520.5 (A5)
A7: J501.16, U501.11 (P4), U511.11 (3I0), U519.4 (A6), U520.4 (A6)
A8: J501.17, U511.14 (4I0), U519.3 (A7), U520.3 (A7)
A9: J501.18, U512.2 (1I0), U519.25 (A8), U520.25 (A8)
A10: J501.19, U512.5 (2I0), U519.24 (A9), U520.24 (A9)
A11: J501.20, U515.2 (A0), U517.3 (Q0)
A12: J501.21, U515.3 (A1), U517.5 (Q1)
A13: J501.22, U515.4 (A2), U517.7 (Q2)
A14: J501.23
A15: J501.24
CLK: J501.5, U504.3 (1CLK), U504.11 (2CLK), U521.2 (CP), U522.2 (CP), U523.2 (CP), U524.2 (CP), U525.2 (CP), U526.2 (CP), U527.2 (CP), U528.2 (CP), U545.13 (6A)
C_CA: U503.5 (1Q), U534.1 (1A), U538.13 (4B), U540.10 (3B)
C_CB: U503.9 (2Q), U505.2 (1D), U535.10 (3B)
C_CBD: U503.12 (2D), U534.3 (1Y)
C_CC0: U507.14 (Q0), U510.3 (1I1)
C_CC1: U507.13 (Q1), U510.6 (2I1)
C_CC2: U507.12 (Q2), U510.10 (3I1)
C_CC3: U507.11 (Q3), U510.13 (4I1)
C_CC4: U508.14 (Q0), U511.3 (1I1)
C_CC5: U508.13 (Q1), U511.6 (2I1)
C_CC6: U508.12 (Q2), U511.10 (3I1)
C_CC7: U508.11 (Q3), U511.13 (4I1)
C_CC8: U509.14 (Q0), U512.3 (1I1)
C_CC9: U509.13 (Q1), U512.6 (2I1)
C_CLRS: U506.5 (1Q), U507.1 (~MR), U508.1 (~MR), U509.1 (~MR), U510.1 (S), U511.1 (S), U512.1 (S), U518.1 (~E)
C_CLRWE: U543.10 (3Y), U543.12 (4B)
C_EN: U506.9 (2Q), U533.2 (A0), U536.2 (1B), U538.12 (4A), U542.1 (1A)
C_ENCK: U506.11 (2CLK), U541.3 (1Y)
C_ENHIT: U538.2 (1B), U545.10 (5Y)
C_FILL: U536.6 (2Y), U540.12 (4A), U543.2 (1A), U543.5 (2A)
C_HC0: U521.14 (Q0), U529.2 (A0)
C_HC1: U521.13 (Q1), U529.3 (A1)
C_HC2: U521.12 (Q2), U529.4 (A2)
C_HC3: U521.11 (Q3), U529.5 (A3)
C_HC4: U522.14 (Q0), U529.6 (A4)
C_HC5: U522.13 (Q1), U529.7 (A5)
C_HC6: U522.12 (Q2), U529.8 (A6)
C_HC7: U522.11 (Q3), U529.9 (A7)
C_HC8: U523.14 (Q0), U530.2 (A0)
C_HC9: U523.13 (Q1), U530.3 (A1)
C_HC10: U523.12 (Q2), U530.4 (A2)
C_HC11: U523.11 (Q3), U530.5 (A3)
C_HC12: U524.14 (Q0), U530.6 (A4)
C_HC13: U524.13 (Q1), U530.7 (A5)
C_HC14: U524.12 (Q2), U530.8 (A6)
C_HC15: U524.11 (Q3), U530.9 (A7)
C_HC_TC0: U521.15 (TC), U522.10 (CET)
C_HC_TC1: U522.15 (TC), U523.10 (CET)
C_HC_TC2: U523.15 (TC), U524.10 (CET)
C_HIT: U534.4 (2A), U536.12 (4A), U542.2 (1B), U544.1 (1Y)
C_HITCNT: U521.7 (CEP), U522.7 (CEP), U523.7 (CEP), U524.7 (CEP), U546.2 (1Y)
C_INVD: U505.12 (2D), U534.8 (3Y)
C_INVL: U505.9 (2Q), U536.10 (3B)
C_INVWR: U536.8 (3Y), U540.13 (4B)
C_MC0: U525.14 (Q0), U531.2 (A0)
C_MC1: U525.13 (Q1), U531.3 (A1)
C_MC2: U525.12 (Q2), U531.4 (A2)
C_MC3: U525.11 (Q3), U531.5 (A3)
C_MC4: U526.14 (Q0), U531.6 (A4)
C_MC5: U526.13 (Q1), U531.7 (A5)
C_MC6: U526.12 (Q2), U531.8 (A6)
C_MC7: U526.11 (Q3), U531.9 (A7)
C_MC8: U527.14 (Q0), U532.2 (A0)
C_MC9: U527.13 (Q1), U532.3 (A1)
C_MC10: U527.12 (Q2), U532.4 (A2)
C_MC11: U527.11 (Q3), U532.5 (A3)
C_MC12: U528.14 (Q0), U532.6 (A4)
C_MC13: U528.13 (Q1), U532.7 (A5)
C_MC14: U528.12 (Q2), U532.8 (A6)
C_MC15: U528.11 (Q3), U532.9 (A7)
C_MC_TC0: U525.15 (TC), U526.10 (CET)
C_MC_TC1: U526.15 (TC), U527.10 (CET)
C_MC_TC2: U527.15 (TC), U528.10 (CET)
C_MEMACC: U535.5 (2B), U540.6 (2Y)
C_MEMNOW: U535.3 (1Y), U535.4 (2A)
C_MISSCNT: U525.7 (CEP), U526.7 (CEP), U527.7 (CEP), U528.7 (CEP), U539.3 (1Y)
C_MRD: U534.12 (4A), U536.1 (1A), U537.13 (4B), U538.4 (2A), U539.1 (1A), U545.2 (1Y)
C_NEED: U535.6 (2Y), U540.9 (3A)
C_RAMHIT: U536.11 (4Y), U537.2 (1B)
C_RDMISS: U534.11 (4Y), U540.5 (2B)
C_ROM: U534.5 (2B), U545.8 (4Y)
C_SNP: U537.3 (1Y), U537.4 (2A), U537.9 (3A)
C_TA0: U510.4 (1Y), U513.10 (A0), U514.10 (A0)
C_TA1: U510.7 (2Y), U513.9 (A1), U514.9 (A1)
C_TA2: U510.9 (3Y), U513.8 (A2), U514.8 (A2)
C_TA3: U510.12 (4Y), U513.7 (A3), U514.7 (A3)
C_TA4: U511.4 (1Y), U513.6 (A4), U514.6 (A4)
C_TA5: U511.7 (2Y), U513.5 (A5), U514.5 (A5)
C_TA6: U511.9 (3Y), U513.4 (A6), U514.4 (A6)
C_TA7: U511.12 (4Y), U513.3 (A7), U514.3 (A7)
C_TA8: U512.4 (1Y), U513.25 (A8), U514.25 (A8)
C_TA9: U512.7 (2Y), U513.24 (A9), U514.24 (A9)
C_TAGPH: U535.11 (4Y), U536.4 (2A), U536.9 (3A), U537.1 (1A)
C_TAGWR: U540.11 (4Y), U543.11 (4A)
C_TC0: U507.15 (TC), U508.10 (CET)
C_TC1: U508.15 (TC), U509.10 (CET)
C_TCB: U535.8 (3Y), U535.12 (4A)
C_TD0: U513.11 (IO0), U515.18 (Y0), U517.2 (P0)
C_TD1: U513.12 (IO1), U515.17 (Y1), U517.4 (P1)
C_TD2: U513.13 (IO2), U515.16 (Y2), U517.6 (P2)
C_TD3: U513.15 (IO3), U515.15 (Y3), U517.8 (P3)
C_TD4: U513.16 (IO4), U515.14 (Y4), U517.11 (P4)
C_TD5: U513.17 (IO5), U515.13 (Y5), U517.13 (P5)
C_TD6: U513.18 (IO6), U515.12 (Y6), U517.15 (P6)
C_TD7: U513.19 (IO7), U515.11 (Y7), U517.17 (P7)
C_TD8: U514.11 (IO0), U516.18 (Y0), U518.2 (P0)
C_TD9: U514.12 (IO1), U516.17 (Y1), U518.4 (P1)
C_TD10: U514.13 (IO2), U516.16 (Y2), U518.6 (P2)
C_TD11: U514.15 (IO3), U516.15 (Y3), U518.8 (P3)
C_TD12: U514.16 (IO4), U516.14 (Y4), U518.11 (P4)
C_TD13: U514.17 (IO5), U516.13 (Y5), U518.13 (P5)
C_TD14: U514.18 (IO6), U516.12 (Y6), U518.15 (P6)
C_TD15: U514.19 (IO7), U516.11 (Y7), U518.17 (P7)
C_VNEW: U516.3 (A1), U538.6 (2Y)
C_WAITING: U503.2 (1D), U534.2 (1B), U545.4 (2Y)
C_WRL: U534.9 (3A), U540.3 (1Y), U540.4 (2A)
C_WRL_E: U504.5 (1Q), U537.5 (2B), U540.1 (1A)
C_WRL_O: U504.9 (2Q), U537.10 (3B), U540.2 (1B)
DE0: J501.25, U506.12 (2D), U519.11 (IO0), U529.18 (Y0), U531.18 (Y0), U533.18 (Y0)
DE1: J501.26, U519.12 (IO1), U529.17 (Y1), U531.17 (Y1), U533.17 (Y1)
DE2: J501.27, U519.13 (IO2), U529.16 (Y2), U531.16 (Y2), U533.16 (Y2)
DE3: J501.28, U519.15 (IO3), U529.15 (Y3), U531.15 (Y3), U533.15 (Y3)
DE4: J501.29, U519.16 (IO4), U529.14 (Y4), U531.14 (Y4), U533.14 (Y4)
DE5: J501.30, U519.17 (IO5), U529.13 (Y5), U531.13 (Y5), U533.13 (Y5)
DE6: J501.31, U519.18 (IO6), U529.12 (Y6), U531.12 (Y6), U533.12 (Y6)
DE7: J501.32, U519.19 (IO7), U529.11 (Y7), U531.11 (Y7), U533.11 (Y7)
DO0: J501.33, U520.11 (IO0), U530.18 (Y0), U532.18 (Y0)
DO1: J501.34, U520.12 (IO1), U530.17 (Y1), U532.17 (Y1)
DO2: J501.35, U520.13 (IO2), U530.16 (Y2), U532.16 (Y2)
DO3: J501.36, U520.15 (IO3), U530.15 (Y3), U532.15 (Y3)
DO4: J501.37, U520.16 (IO4), U530.14 (Y4), U532.14 (Y4)
DO5: J501.38, U520.17 (IO5), U530.13 (Y5), U532.13 (Y5)
DO6: J501.39, U520.18 (IO6), U530.12 (Y6), U532.12 (Y6)
DO7: J501.40, U520.19 (IO7), U530.11 (Y7), U532.11 (Y7)
FAULT: J501.45
GND: C501.2 (-), C502.2, C503.2, C504.2, C505.2, C506.2, C507.2, C508.2, C509.2, C510.2, C511.2, C512.2, C513.2, C514.2, C515.2, C516.2, C517.2, C518.2, C519.2, C520.2, C521.2, C522.2, C523.2, C524.2, C525.2, C526.2, C527.2, C528.2, C529.2, C530.2, C531.2, C532.2, C533.2, C534.2, C535.2, C536.2, C537.2, C538.2, C539.2, C540.2, C541.2, C542.2, C543.2, C544.2, C545.2, C546.2, C547.2, J501.1, J501.2, J501.62, J501.64, U501.3 (Q0), U501.9 (Q3), U501.10 (GND), U501.12 (Q4), U501.13 (P5), U501.14 (Q5), U501.15 (P6), U501.16 (Q6), U501.17 (P7), U501.18 (Q7), U502.8 (GND), U502.13 (2A1), U502.14 (2A0), U503.7 (GND), U504.2 (1D), U504.7 (GND), U504.12 (2D), U505.7 (GND), U506.2 (1D), U506.7 (GND), U507.3 (D0), U507.4 (D1), U507.5 (D2), U507.6 (D3), U507.8 (GND), U508.3 (D0), U508.4 (D1), U508.5 (D2), U508.6 (D3), U508.8 (GND), U509.3 (D0), U509.4 (D1), U509.5 (D2), U509.6 (D3), U509.8 (GND), U510.8 (GND), U510.15 (~E), U511.8 (GND), U511.15 (~E), U512.8 (GND), U512.10 (3I1), U512.11 (3I0), U512.13 (4I1), U512.14 (4I0), U512.15 (~E), U513.1 (A14), U513.2 (A12), U513.14 (GND), U513.20 (~CE), U513.21 (A10), U513.22 (~OE), U513.23 (A11), U513.26 (A13), U514.1 (A14), U514.2 (A12), U514.14 (GND), U514.20 (~CE), U514.21 (A10), U514.22 (~OE), U514.23 (A11), U514.26 (A13), U515.10 (GND), U515.19 (~OE2), U516.4 (A2), U516.5 (A3), U516.6 (A4), U516.7 (A5), U516.8 (A6), U516.9 (A7), U516.10 (GND), U516.19 (~OE2), U517.1 (~E), U517.10 (GND), U518.7 (Q2), U518.9 (Q3), U518.10 (GND), U518.12 (Q4), U518.14 (Q5), U518.16 (Q6), U518.18 (Q7), U519.1 (A14), U519.2 (A12), U519.14 (GND), U519.20 (~CE), U519.21 (A10), U519.23 (A11), U519.26 (A13), U520.1 (A14), U520.2 (A12), U520.14 (GND), U520.20 (~CE), U520.21 (A10), U520.23 (A11), U520.26 (A13), U521.3 (D0), U521.4 (D1), U521.5 (D2), U521.6 (D3), U521.8 (GND), U522.3 (D0), U522.4 (D1), U522.5 (D2), U522.6 (D3), U522.8 (GND), U523.3 (D0), U523.4 (D1), U523.5 (D2), U523.6 (D3), U523.8 (GND), U524.3 (D0), U524.4 (D1), U524.5 (D2), U524.6 (D3), U524.8 (GND), U525.3 (D0), U525.4 (D1), U525.5 (D2), U525.6 (D3), U525.8 (GND), U526.3 (D0), U526.4 (D1), U526.5 (D2), U526.6 (D3), U526.8 (GND), U527.3 (D0), U527.4 (D1), U527.5 (D2), U527.6 (D3), U527.8 (GND), U528.3 (D0), U528.4 (D1), U528.5 (D2), U528.6 (D3), U528.8 (GND), U529.10 (GND), U529.19 (~OE2), U530.10 (GND), U530.19 (~OE2), U531.10 (GND), U531.19 (~OE2), U532.10 (GND), U532.19 (~OE2), U533.3 (A1), U533.4 (A2), U533.5 (A3), U533.6 (A4), U533.7 (A5), U533.8 (A6), U533.9 (A7), U533.10 (GND), U534.7 (GND), U535.7 (GND), U536.7 (GND), U537.7 (GND), U538.7 (GND), U539.4 (2A), U539.5 (2B), U539.7 (GND), U539.9 (3A), U539.10 (3B), U539.12 (4A), U539.13 (4B), U540.7 (GND), U541.7 (GND), U542.7 (GND), U542.12 (4A), U542.13 (4B), U543.7 (GND), U544.5 (2A), U544.6 (2B), U544.7 (GND), U544.8 (3A), U544.9 (3B), U544.11 (4A), U544.12 (4B), U545.7 (GND), U546.3 (2A), U546.5 (3A), U546.7 (GND), U546.9 (4A), U546.11 (5A), U546.13 (6A)
HALTED: J501.44
IRQ: J501.8
N2380: U534.6 (2Y), U534.10 (3B)
N2395: U540.8 (3Y), U542.4 (2A)
N2398: U536.3 (1Y), U536.5 (2B)
N2404: U537.6 (2Y), U543.3 (1B)
N2406: U537.8 (3Y), U543.6 (2B)
N2408: U537.11 (4Y), U538.1 (1A)
N2409: U538.3 (1Y), U542.9 (3A)
N2588: U538.10 (3B), U541.6 (2Y)
N2591: U538.11 (4Y), U539.2 (1B)
OSC: J501.49, U506.3 (1CLK), U507.2 (CP), U508.2 (CP), U509.2 (CP), U543.8 (3A)
PA14: J501.50, U515.5 (A3), U517.9 (Q3)
PA15: J501.51, U515.6 (A4), U517.12 (Q4)
PA16: J501.52, U515.7 (A5), U517.14 (Q5)
PA17: J501.53, U515.8 (A6), U517.16 (Q6)
PA18: J501.54, U515.9 (A7), U517.18 (Q7)
PA19: J501.55, U516.2 (A0), U518.3 (Q0), U536.13 (4B), U545.9 (4A)
TCLK: J501.48, U503.3 (1CLK), U503.11 (2CLK), U505.11 (2CLK), U535.9 (3A), U545.5 (3A)
VCC: C501.1 (+), C502.1, C503.1, C504.1, C505.1, C506.1, C507.1, C508.1, C509.1, C510.1, C511.1, C512.1, C513.1, C514.1, C515.1, C516.1, C517.1, C518.1, C519.1, C520.1, C521.1, C522.1, C523.1, C524.1, C525.1, C526.1, C527.1, C528.1, C529.1, C530.1, C531.1, C532.1, C533.1, C534.1, C535.1, C536.1, C537.1, C538.1, C539.1, C540.1, C541.1, C542.1, C543.1, C544.1, C545.1, C546.1, C547.1, J501.3, J501.4, J501.63, U501.5 (Q1), U501.7 (Q2), U501.20 (VCC), U502.15 (~2E), U502.16 (VCC), U503.4 (~1PRE), U503.10 (~2PRE), U503.14 (VCC), U504.14 (VCC), U505.4 (~1PRE), U505.10 (~2PRE), U505.14 (VCC), U506.1 (~1CLR), U506.13 (~2CLR), U506.14 (VCC), U507.7 (CEP), U507.9 (~PE), U507.10 (CET), U507.16 (VCC), U508.7 (CEP), U508.9 (~PE), U508.16 (VCC), U509.7 (CEP), U509.9 (~PE), U509.16 (VCC), U510.16 (VCC), U511.16 (VCC), U512.16 (VCC), U513.28 (VCC), U514.28 (VCC), U515.20 (VCC), U516.20 (VCC), U517.20 (VCC), U518.5 (Q1), U518.20 (VCC), U519.28 (VCC), U520.28 (VCC), U521.9 (~PE), U521.10 (CET), U521.16 (VCC), U522.9 (~PE), U522.16 (VCC), U523.9 (~PE), U523.16 (VCC), U524.9 (~PE), U524.16 (VCC), U525.9 (~PE), U525.10 (CET), U525.16 (VCC), U526.9 (~PE), U526.16 (VCC), U527.9 (~PE), U527.16 (VCC), U528.9 (~PE), U528.16 (VCC), U529.20 (VCC), U530.20 (VCC), U531.20 (VCC), U532.20 (VCC), U533.20 (VCC), U534.14 (VCC), U535.14 (VCC), U536.14 (VCC), U537.14 (VCC), U538.14 (VCC), U539.14 (VCC), U540.14 (VCC), U541.14 (VCC), U542.14 (VCC), U543.14 (VCC), U544.14 (VCC), U545.14 (VCC), U546.14 (VCC)
VSYNC_REQ: J501.56
WR_WIN: J501.6
~CS_CTRL: U502.6 (~1Y2), U533.19 (~OE2), U541.2 (1B)
~CS_HITS: U502.4 (~1Y0), U541.5 (2B), U541.10 (3B)
~CS_MISS: U502.5 (~1Y1), U541.13 (4B)
~C_CA: U503.6 (~1Q), U542.10 (3B)
~C_CBF: U505.6 (~1Q), U535.13 (4B)
~C_CB: U503.8 (~2Q), U542.5 (2B)
~C_CLK: U535.2 (1B), U545.12 (6Y)
~C_CLRS: U506.6 (~1Q), U538.5 (2B), U543.9 (3B)
~C_CNTCLR: U521.1 (~MR), U522.1 (~MR), U523.1 (~MR), U524.1 (~MR), U525.1 (~MR), U526.1 (~MR), U527.1 (~MR), U528.1 (~MR), U538.8 (3Y)
~C_CSEL: U501.19 (~EQ), U502.1 (~1E)
~C_CWE_E: U519.27 (~WE), U543.1 (1Y)
~C_CWE_O: U520.27 (~WE), U543.4 (2Y)
~C_ENHIT: U534.13 (4B), U542.3 (1Y), U545.11 (5A)
~C_HITRD: U519.22 (~OE), U520.22 (~OE), U542.8 (3Y), U546.1 (1A)
~C_OE_HITS: U529.1 (~OE1), U530.1 (~OE1), U541.8 (3Y)
~C_OE_MISS: U531.1 (~OE1), U532.1 (~OE1), U541.11 (4Y)
~C_TCLK: U505.3 (1CLK), U545.6 (3Y)
~C_TEQ_HI: U518.19 (~EQ), U544.3 (1B)
~C_TEQ_LO: U517.19 (~EQ), U544.2 (1A)
~C_TWE: U513.27 (~WE), U514.27 (~WE), U515.1 (~OE1), U516.1 (~OE1), U543.13 (4Y)
~IO: J501.47, U501.1 (~E), U535.1 (1A), U537.12 (4A)
~MRD: J501.41, U533.1 (~OE1), U541.9 (3A), U541.12 (4A), U545.1 (1A)
~MWE_E: J501.42, U504.4 (~1PRE), U541.1 (1A), U541.4 (2A)
~MWE_O: J501.43, U504.10 (~2PRE)
~RESET: J501.7, U503.1 (~1CLR), U503.13 (~2CLR), U504.1 (~1CLR), U504.13 (~2CLR), U505.1 (~1CLR), U505.13 (~2CLR), U506.4 (~1PRE), U506.10 (~2PRE), U538.9 (3A)
~WAIT: J501.46, U542.6 (2Y), U545.3 (2A)
