MihrimatriX/breadboarding/cpu16/kicad/prog/prog.kicad_sch

## KiCad design cpu16/kicad/prog/prog.kicad_sch (2026-10-11)

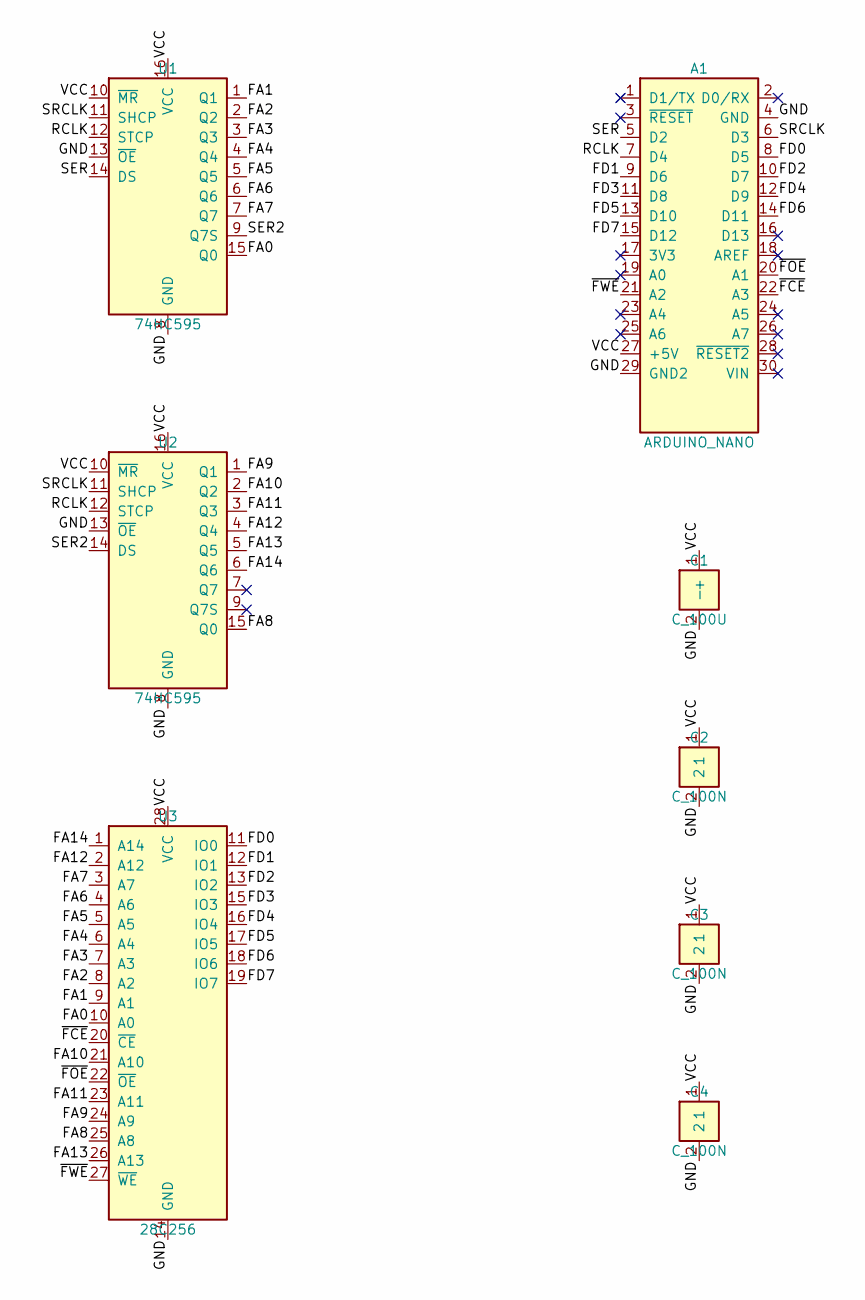
[picture p34: schematic prog.kicad_sch]

Parts:
A1: ARDUINO_NANO; Arduino_Nano
C1: C_100U; CP_Radial_D6.3mm_P2.50mm
C2, C3, C4: C_100N; C_Disc_D5.0mm_W2.5mm_P5.00mm
U1, U2: 74HC595; DIP-16_W7.62mm
U3: 28C256; DIP-28_W15.24mm_Socket

Connections:
FA0: U1.15 (Q0), U3.10 (A0)
FA1: U1.1 (Q1), U3.9 (A1)
FA2: U1.2 (Q2), U3.8 (A2)
FA3: U1.3 (Q3), U3.7 (A3)
FA4: U1.4 (Q4), U3.6 (A4)
FA5: U1.5 (Q5), U3.5 (A5)
FA6: U1.6 (Q6), U3.4 (A6)
FA7: U1.7 (Q7), U3.3 (A7)
FA8: U2.15 (Q0), U3.25 (A8)
FA9: U2.1 (Q1), U3.24 (A9)
FA10: U2.2 (Q2), U3.21 (A10)
FA11: U2.3 (Q3), U3.23 (A11)
FA12: U2.4 (Q4), U3.2 (A12)
FA13: U2.5 (Q5), U3.26 (A13)
FA14: U2.6 (Q6), U3.1 (A14)
FD0: A1.8 (D5), U3.11 (IO0)
FD1: A1.9 (D6), U3.12 (IO1)
FD2: A1.10 (D7), U3.13 (IO2)
FD3: A1.11 (D8), U3.15 (IO3)
FD4: A1.12 (D9), U3.16 (IO4)
FD5: A1.13 (D10), U3.17 (IO5)
FD6: A1.14 (D11), U3.18 (IO6)
FD7: A1.15 (D12), U3.19 (IO7)
GND: A1.4 (GND), A1.29 (GND2), C1.2 (-), C2.2, C3.2, C4.2, U1.8 (GND), U1.13 (~OE), U2.8 (GND), U2.13 (~OE), U3.14 (GND)
RCLK: A1.7 (D4), U1.12 (STCP), U2.12 (STCP)
SER: A1.5 (D2), U1.14 (DS)
SER2: U1.9 (Q7S), U2.14 (DS)
SRCLK: A1.6 (D3), U1.11 (SHCP), U2.11 (SHCP)
VCC: A1.27 (+5V), C1.1 (+), C2.1, C3.1, C4.1, U1.10 (~MR), U1.16 (VCC), U2.10 (~MR), U2.16 (VCC), U3.28 (VCC)
~FCE: A1.22 (A3), U3.20 (~CE)
~FOE: A1.20 (A1), U3.22 (~OE)
~FWE: A1.21 (A2), U3.27 (~WE)
