MihrimatriX/breadboarding/cpu16/kicad/video/video.kicad_sch

## KiCad design cpu16/kicad/video/video.kicad_sch (2026-10-12)

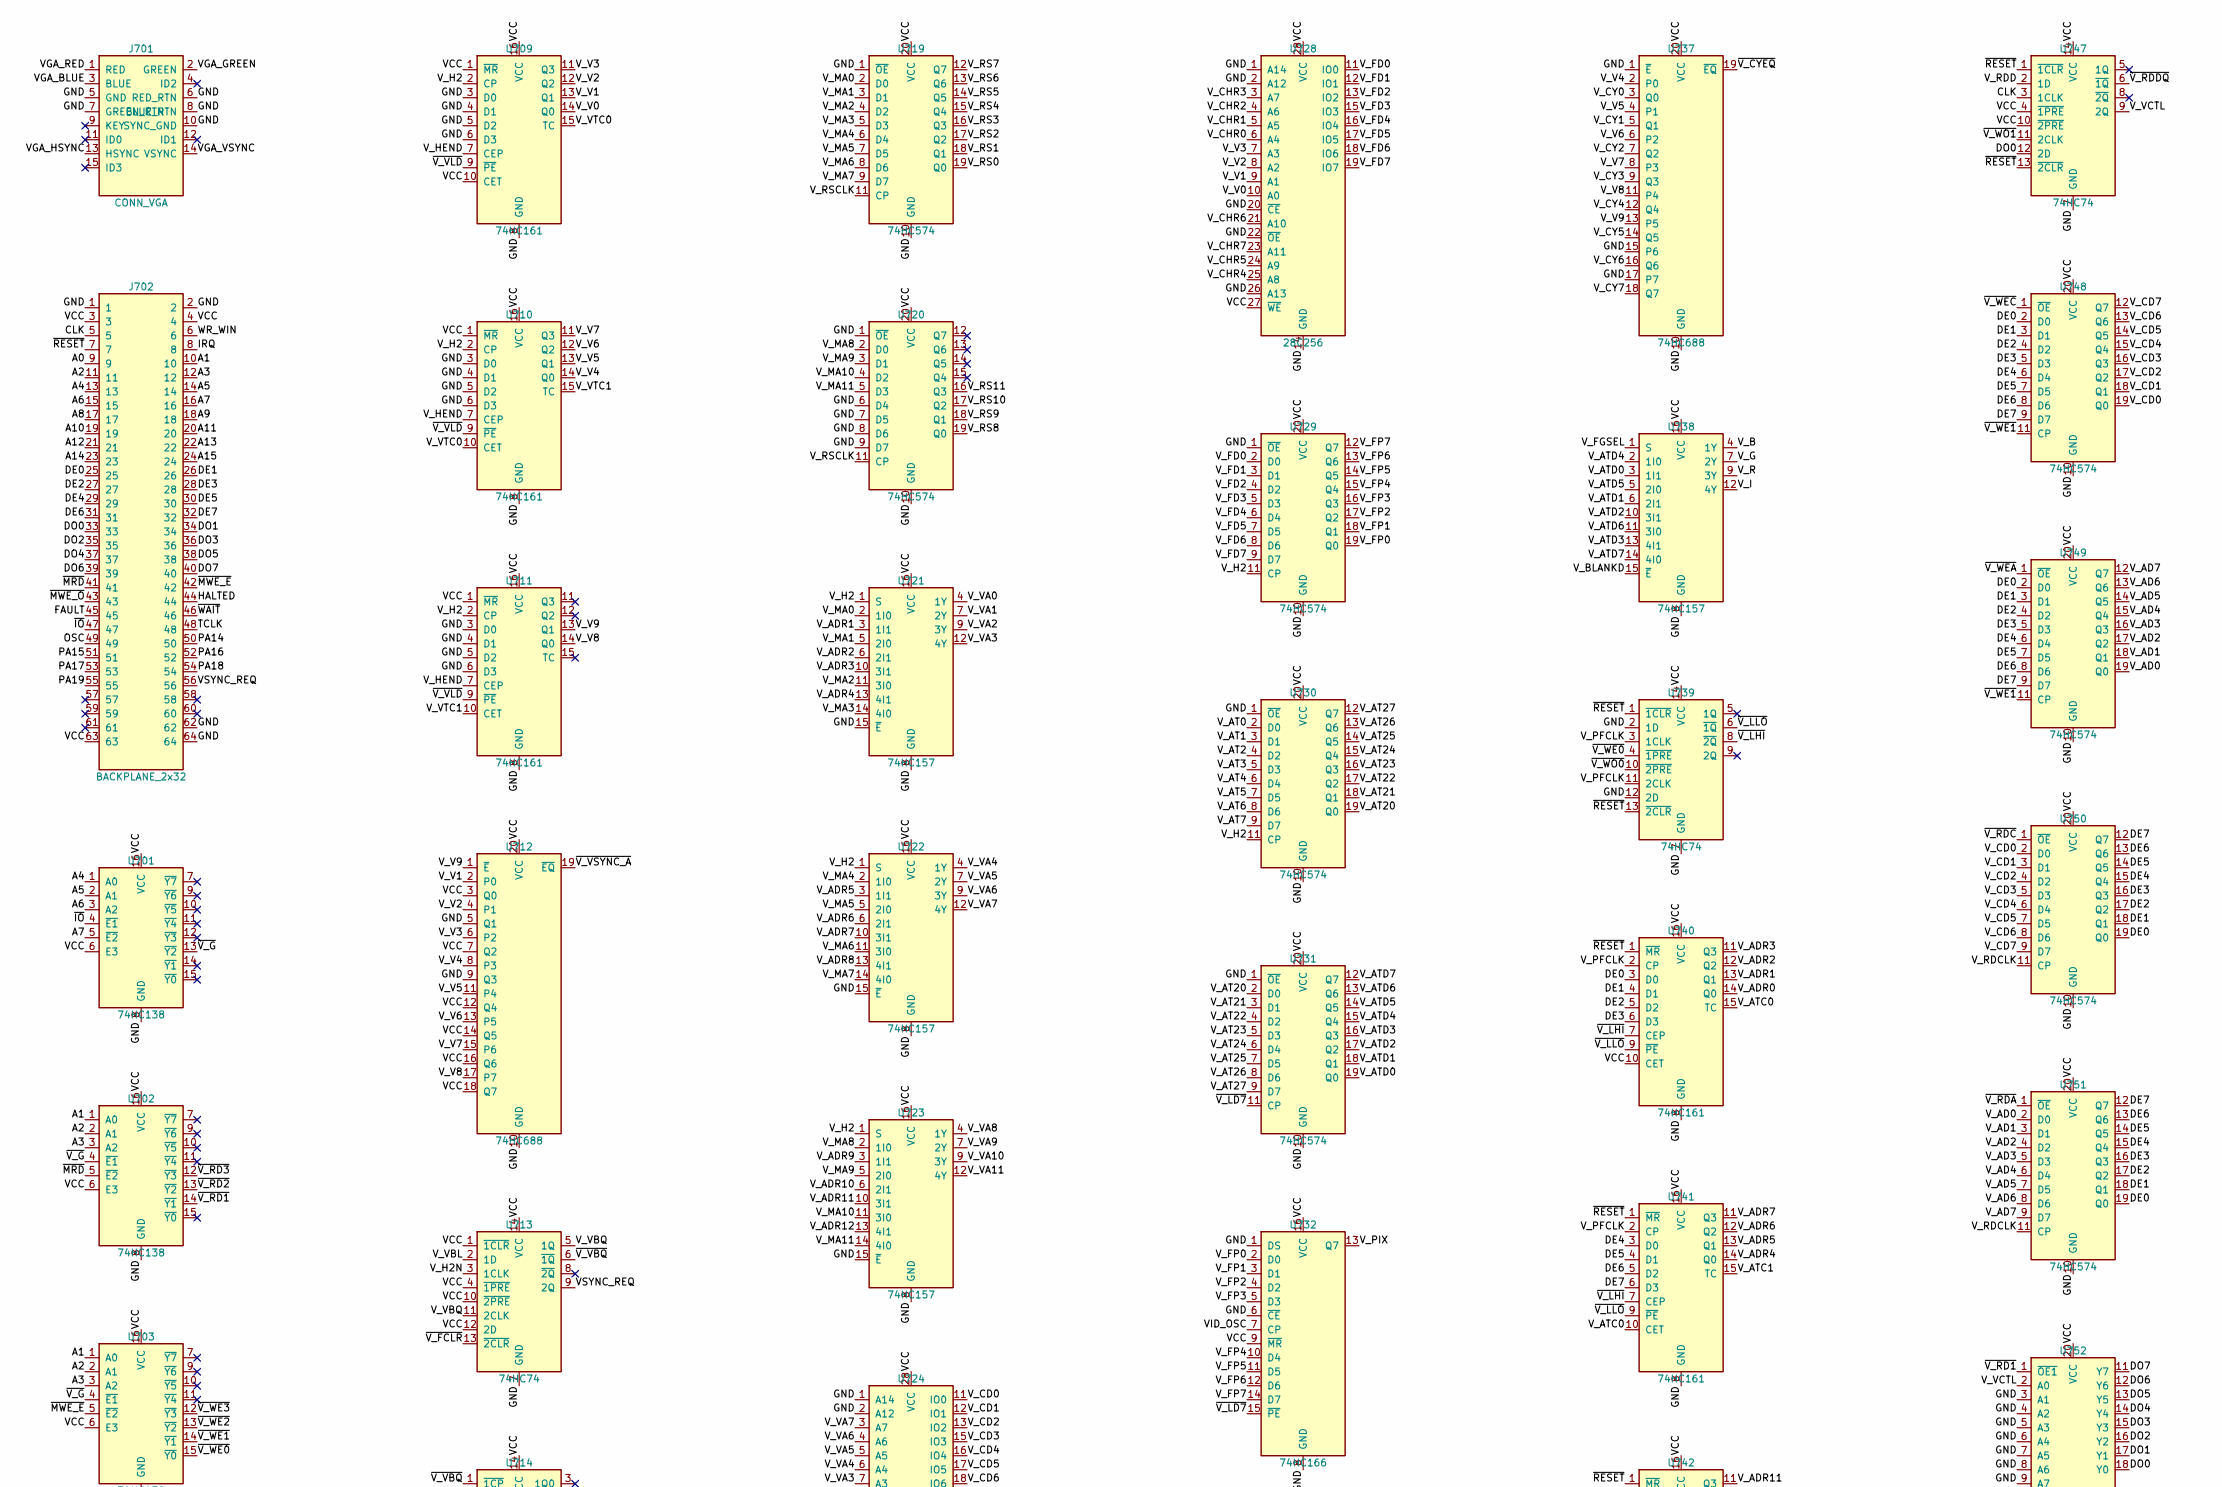
[picture p35: schematic video.kicad_sch, part in row 1, column 1]

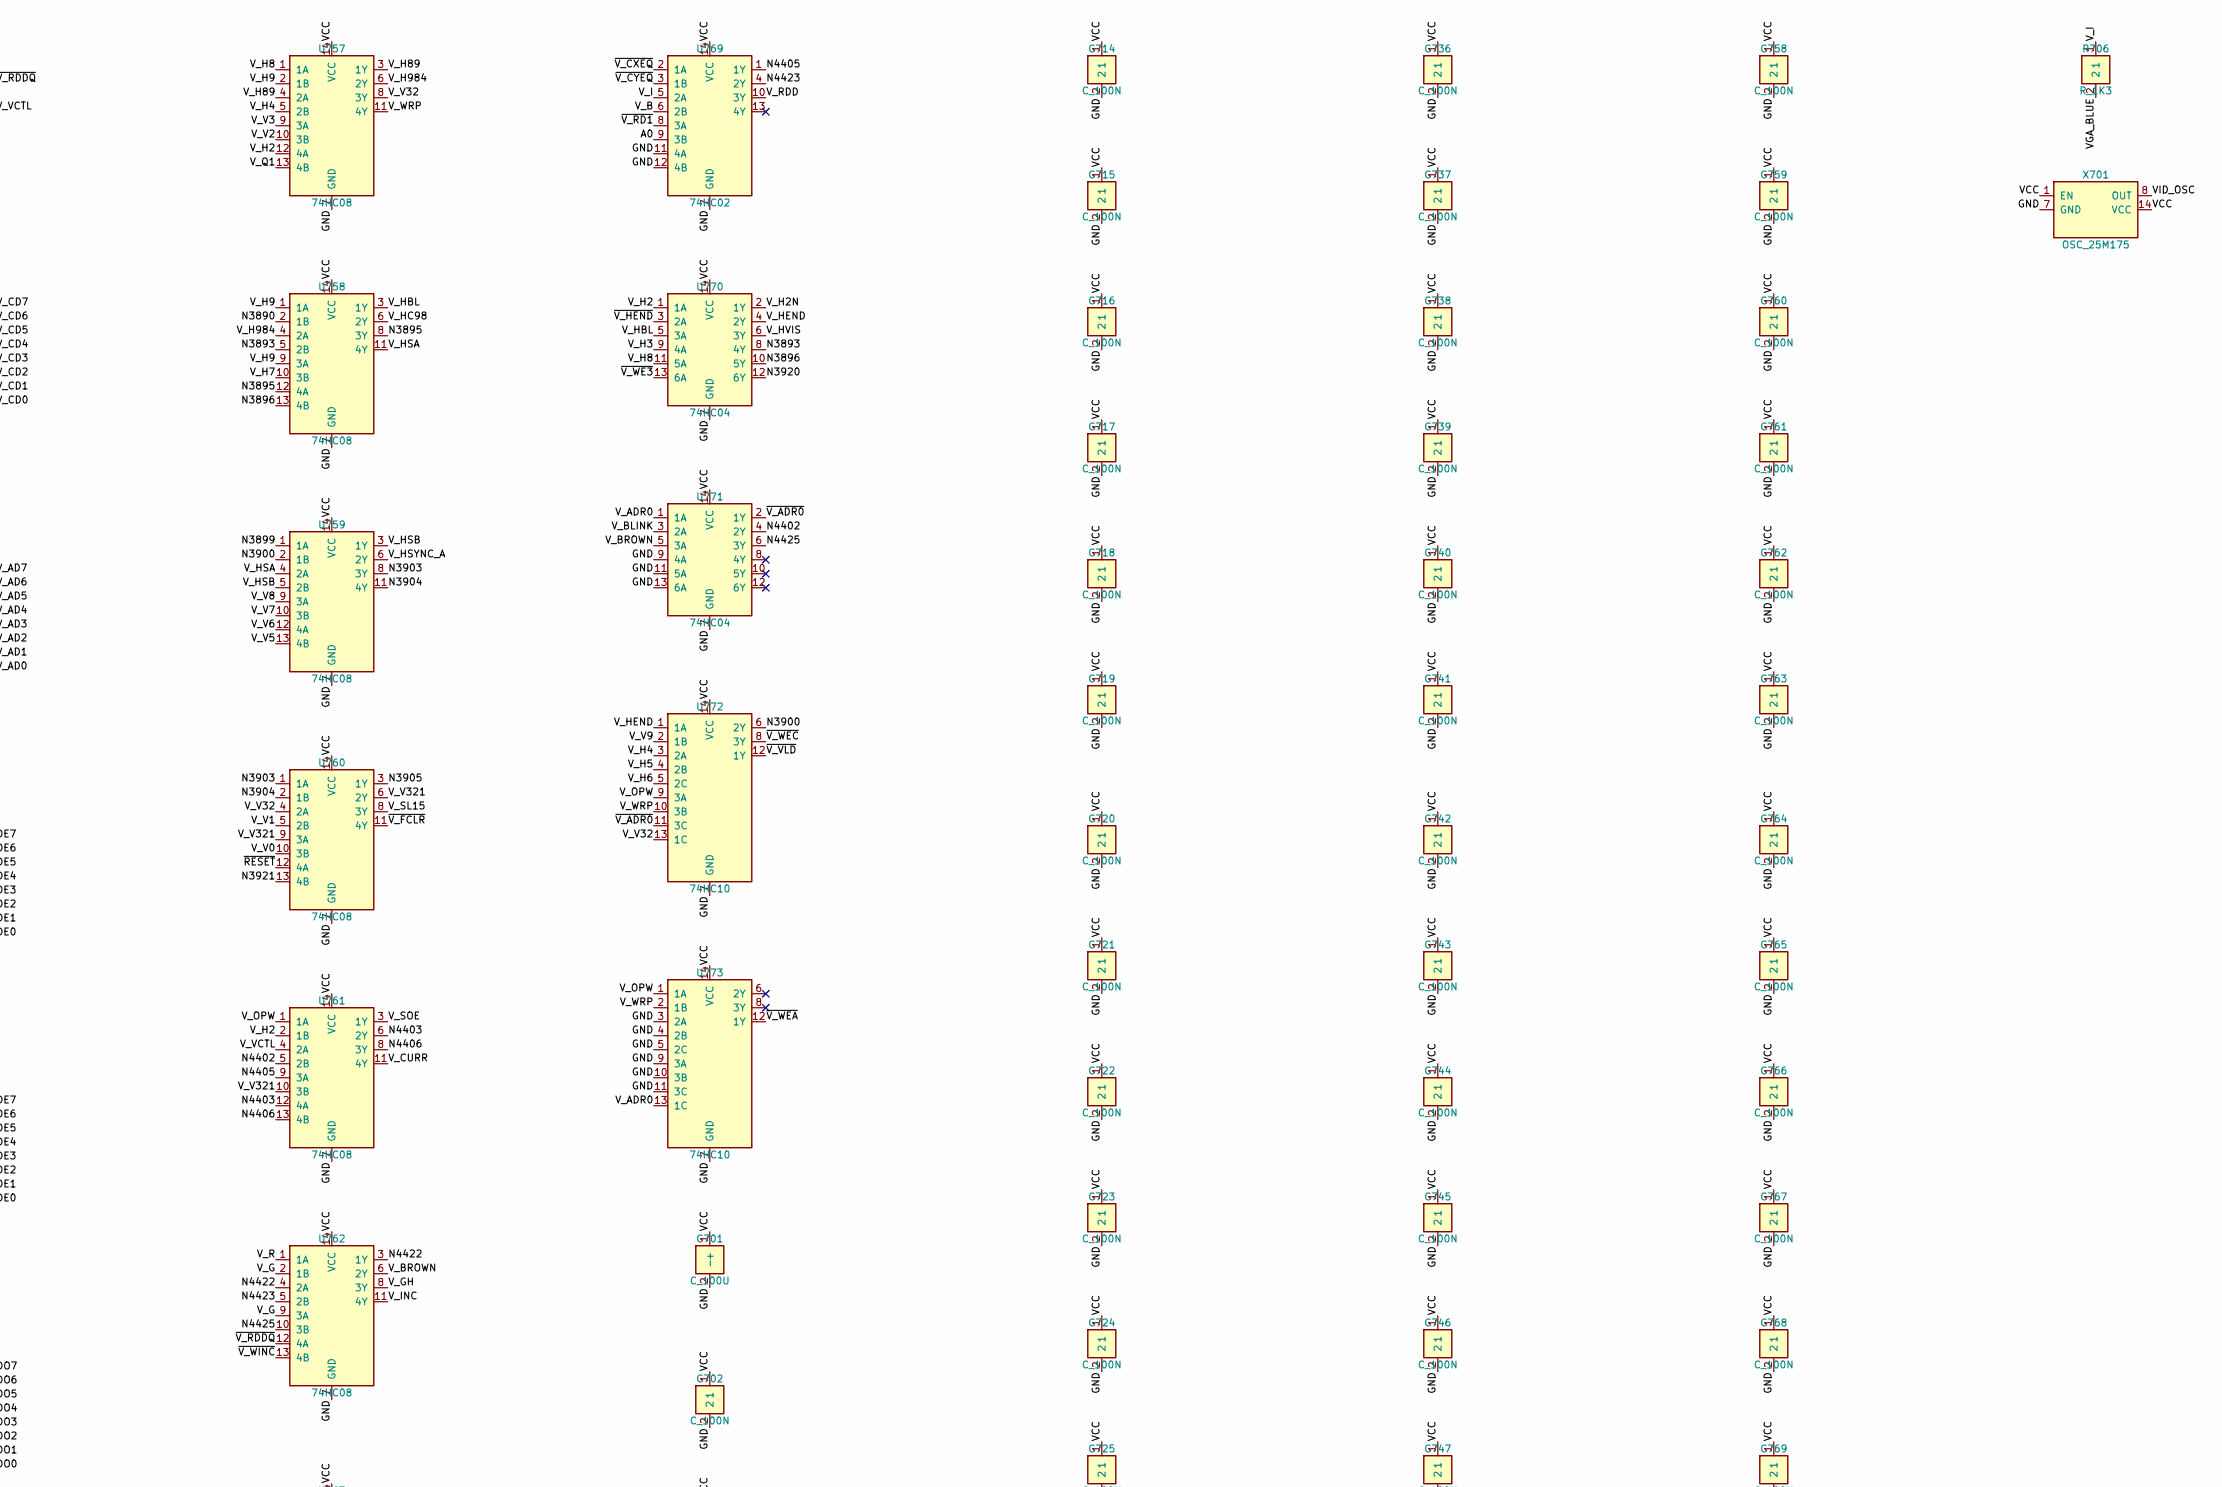
[picture p36: schematic video.kicad_sch, part in row 1, column 2]

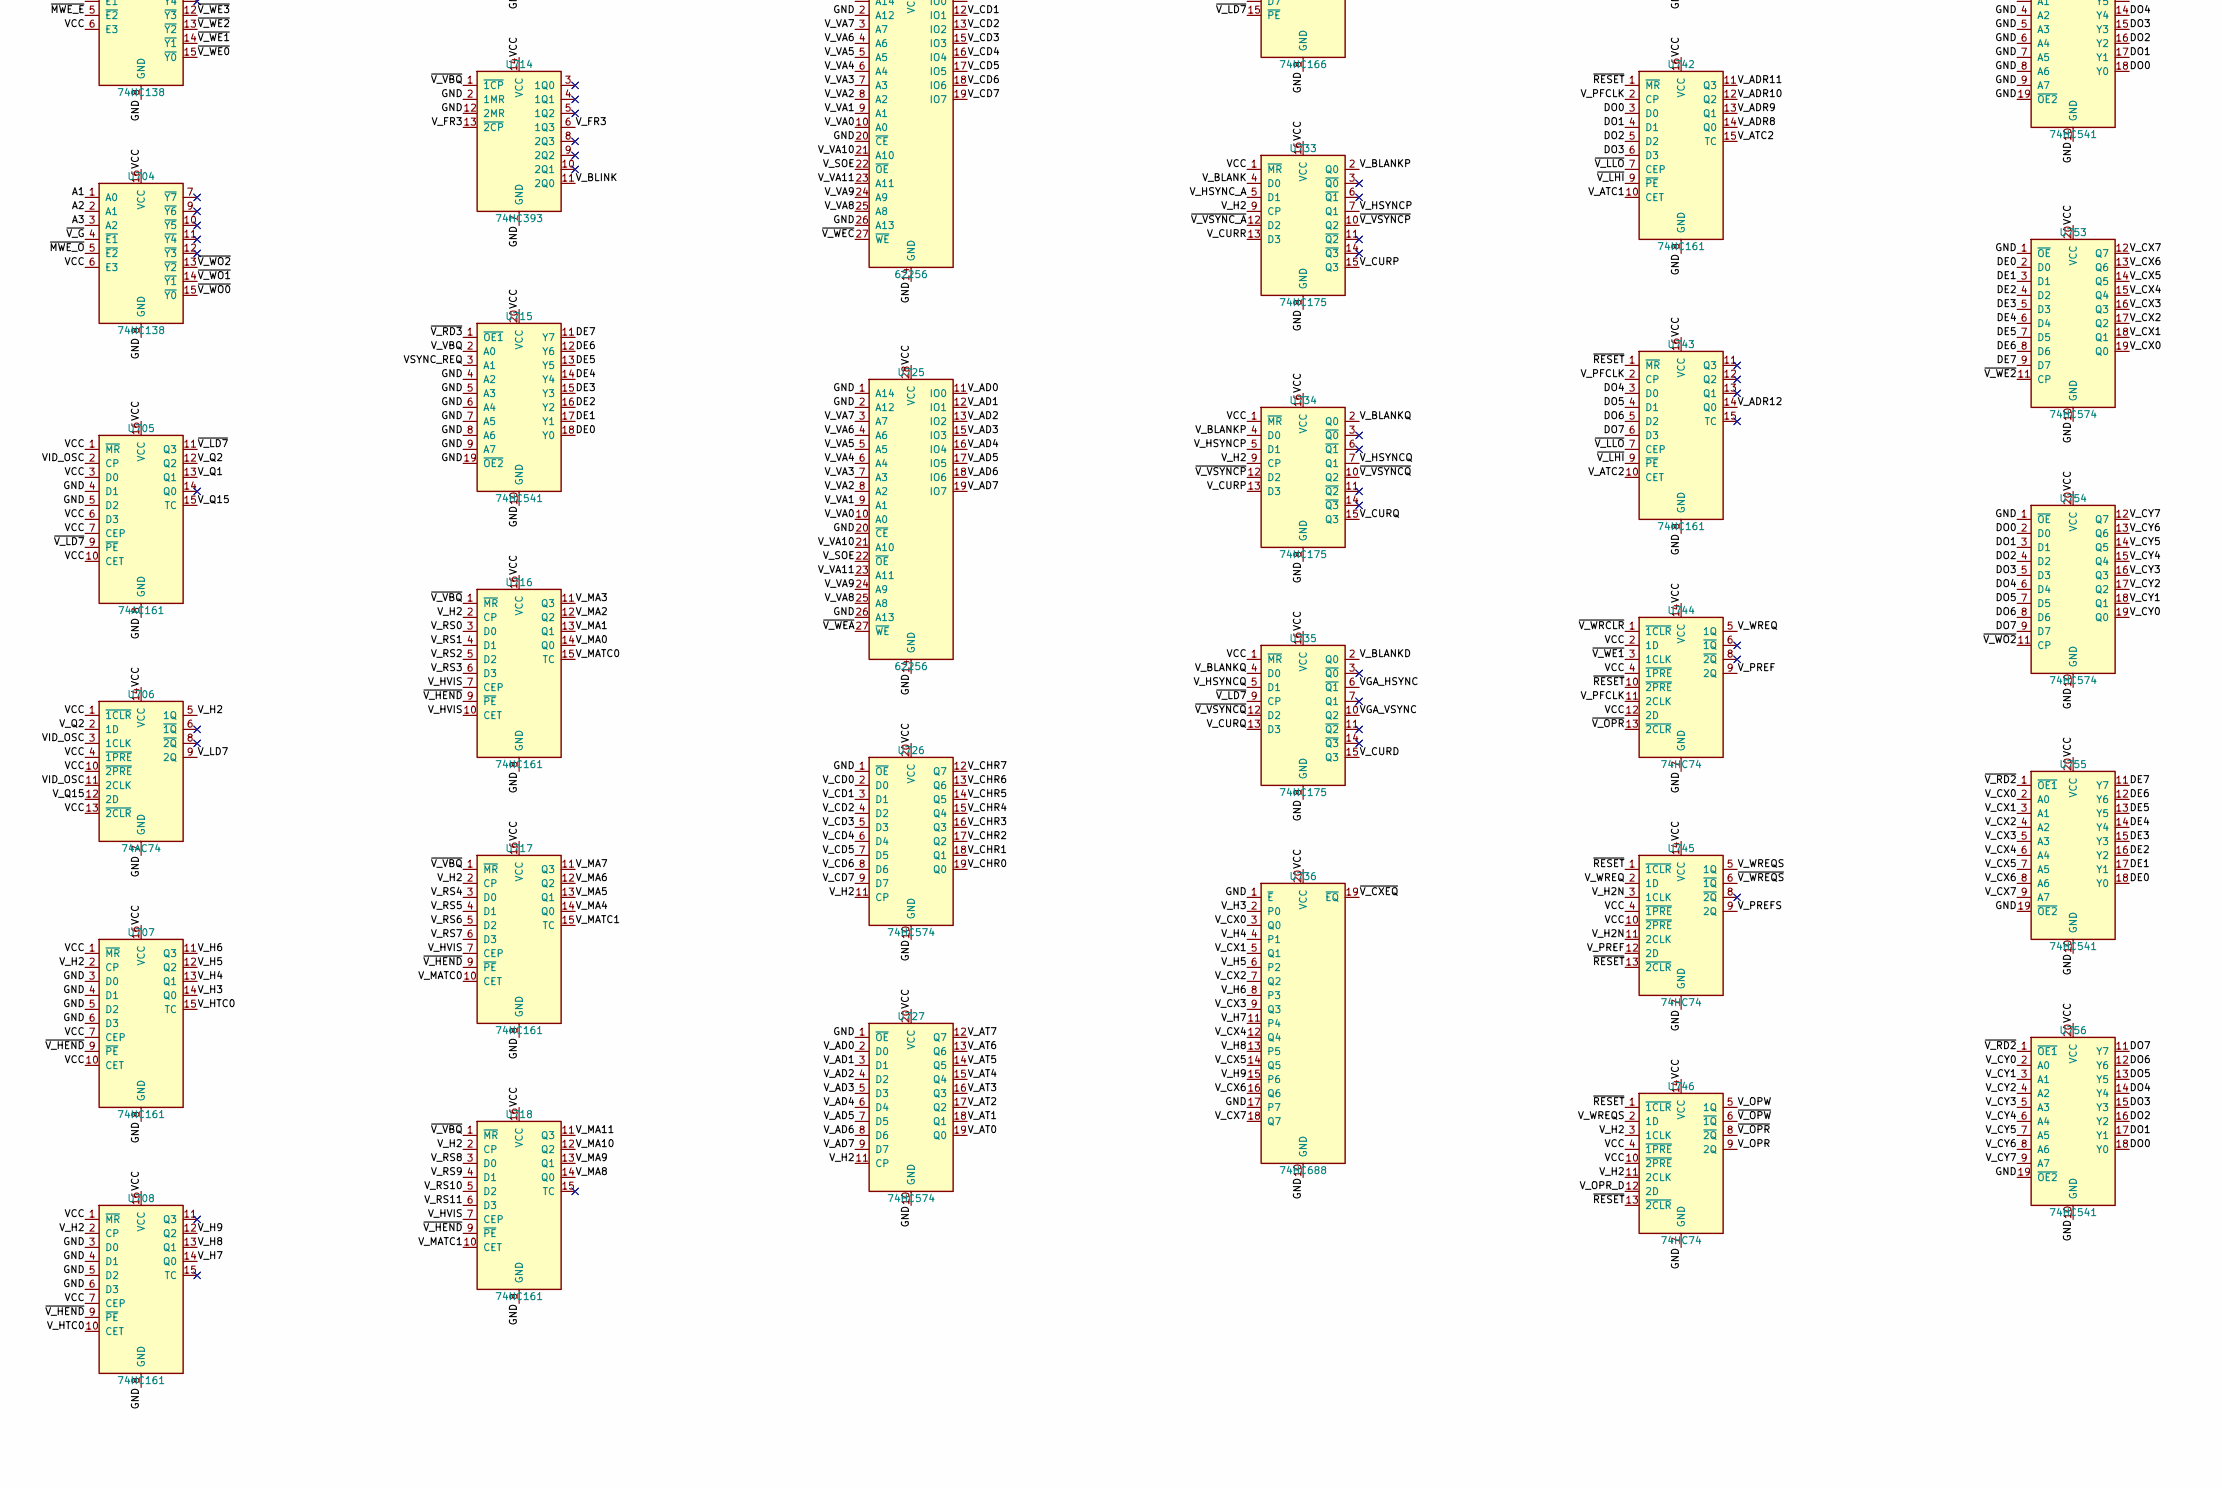
[picture p37: schematic video.kicad_sch, part in row 2, column 1]

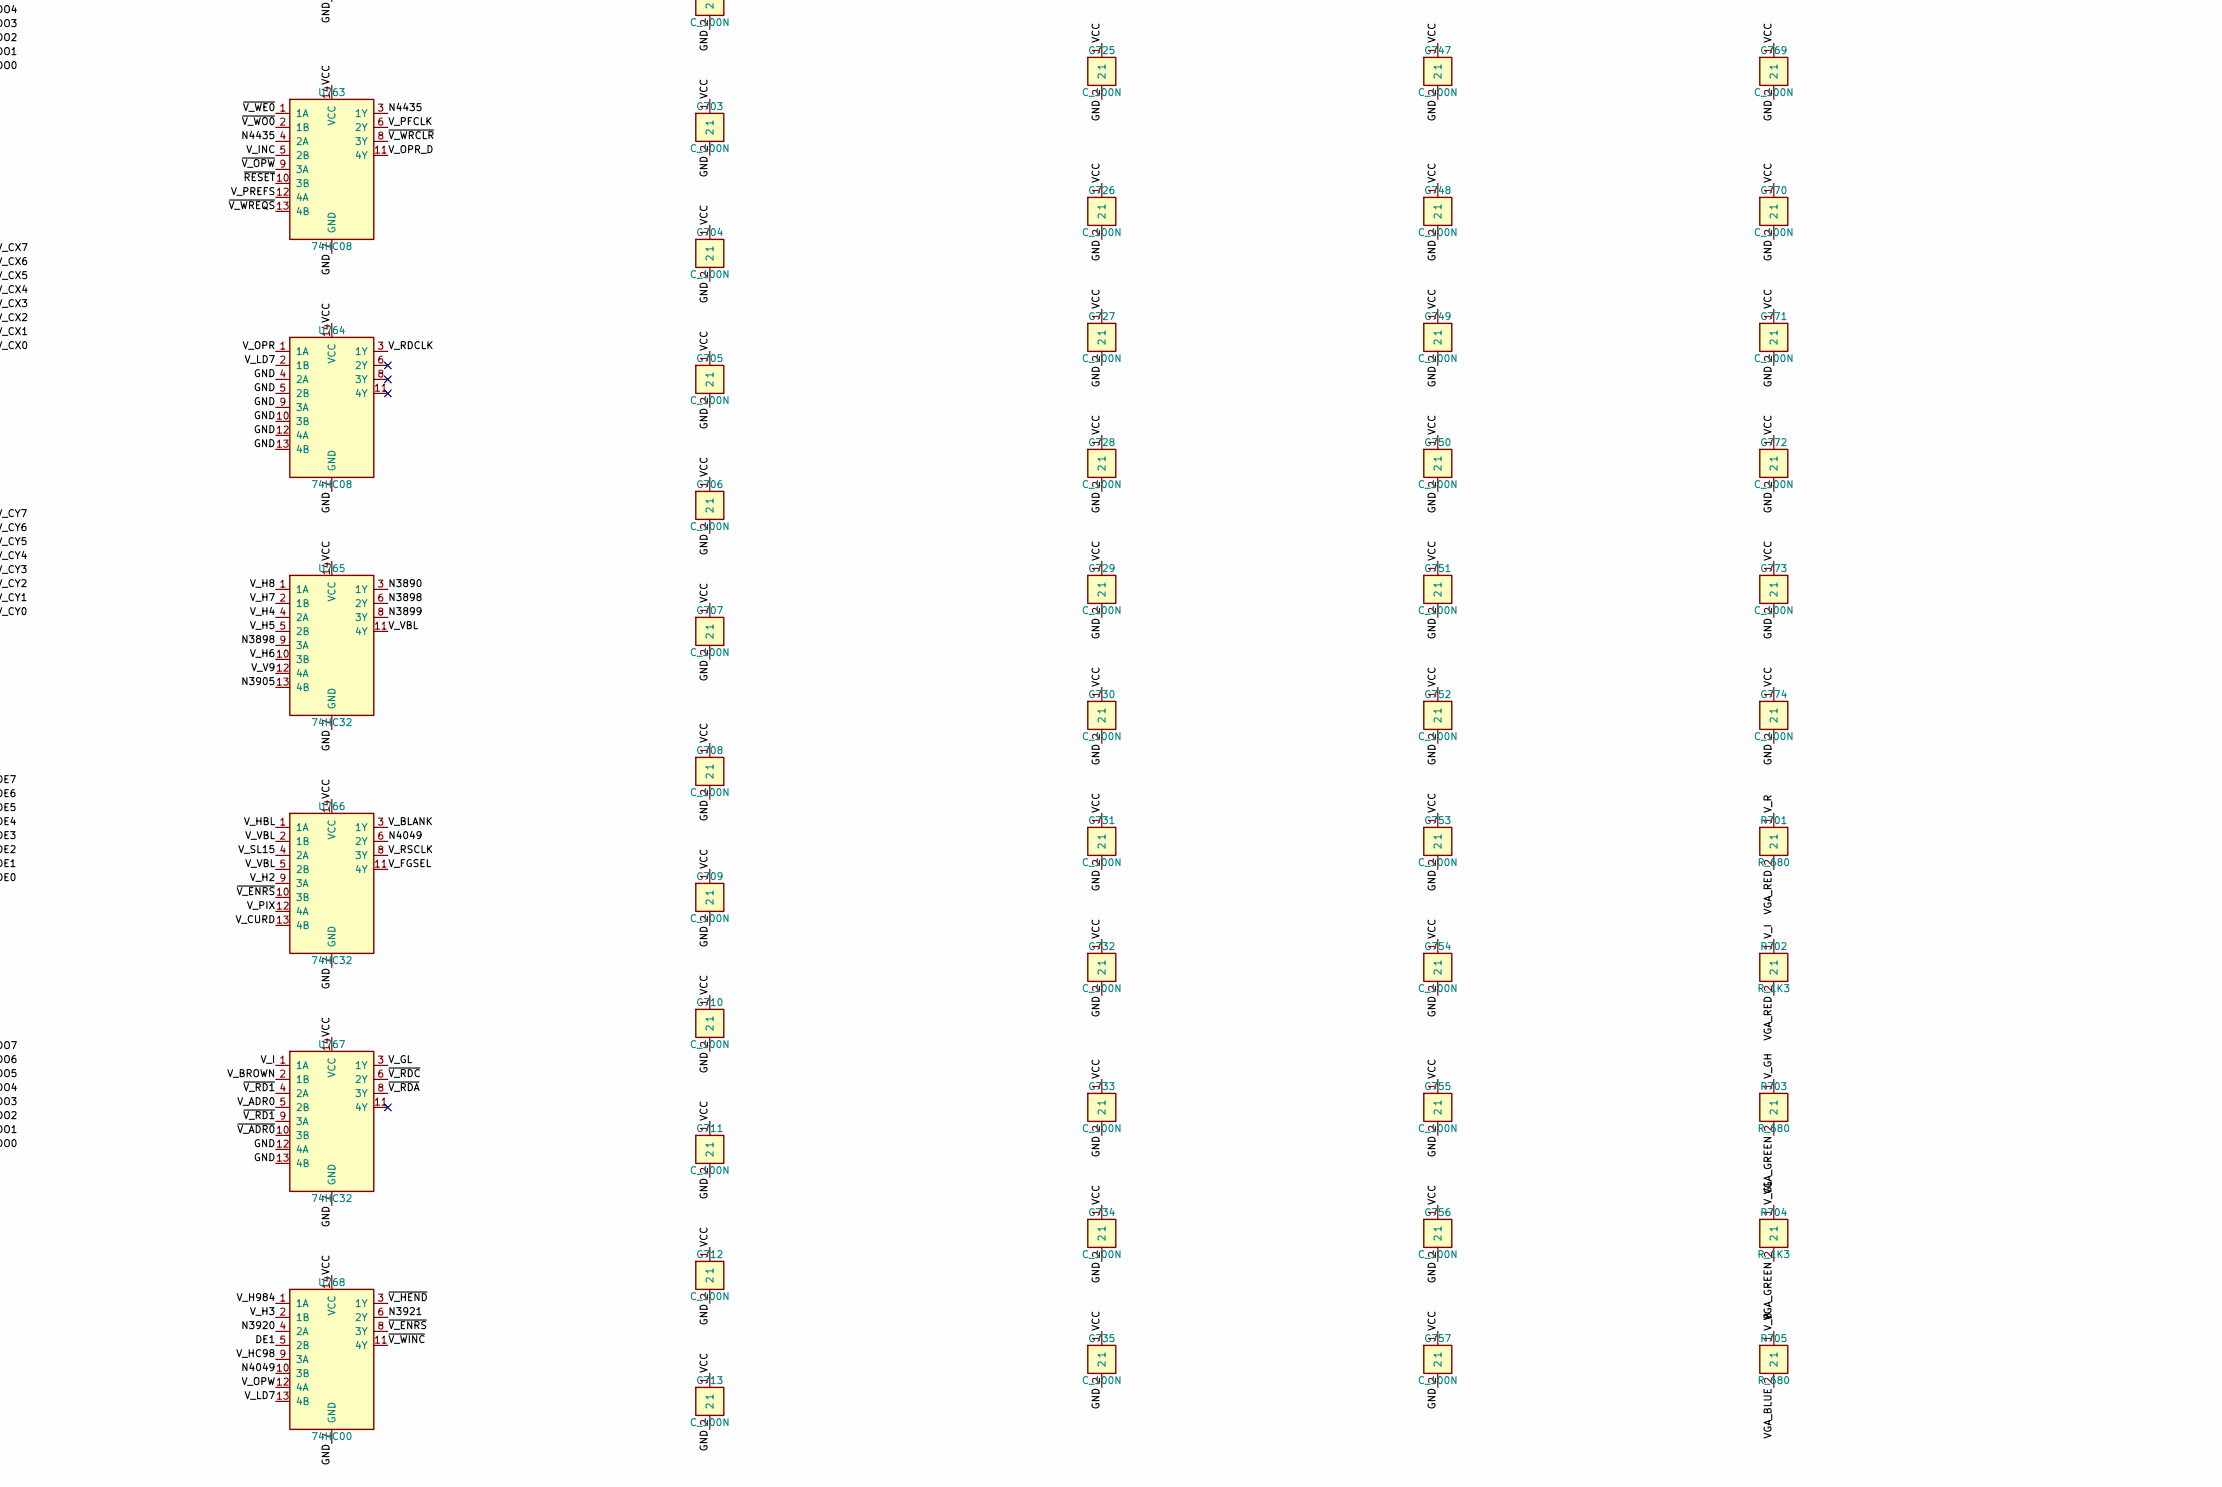
[picture p38: schematic video.kicad_sch, part in row 2, column 2]

Parts:
C701: C_100U; CP_Radial_D6.3mm_P2.50mm
C702, C703, C704, C705, C706, C707, C708, C709, C710, C711, C712, C713, C714, C715, C716, C717, C718, C719, C720, C721, C722, C723, C724, C725, C726, C727, C728, C729, C730, C731, C732, C733, C734, C735, C736, C737, C738, C739, C740, C741, C742, C743, C744, C745, C746, C747, C748, C749, C750, C751, C752, C753, C754, C755, C756, C757, C758, C759, C760, C761, C762, C763, C764, C765, C766, C767, C768, C769, C770, C771, C772, C773, C774: C_100N; C_Disc_D5.0mm_W2.5mm_P5.00mm
J701: CONN_VGA; DSUB-15-HD_Female_Horizontal_P2.29x1.98mm_EdgePinOffset3.03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
J702: BACKPLANE_2x32; PinHeader_2x32_P2.54mm_Vertical
R701, R703, R705: R_680; R_Axial_DIN0207_L6.3mm_D2.5mm_P7.62mm_Horizontal
R702, R704, R706: R_1K3; R_Axial_DIN0207_L6.3mm_D2.5mm_P7.62mm_Horizontal
U701, U702, U703, U704: 74HC138; DIP-16_W7.62mm
U705: 74AC161; DIP-16_W7.62mm
U706: 74AC74; DIP-14_W7.62mm
U707, U708, U709, U710, U711, U716, U717, U718, U740, U741, U742, U743: 74HC161; DIP-16_W7.62mm
U712, U736, U737: 74HC688; DIP-20_W7.62mm
U713, U739, U744, U745, U746, U747: 74HC74; DIP-14_W7.62mm
U714: 74HC393; DIP-14_W7.62mm
U715, U752, U755, U756: 74HC541; DIP-20_W7.62mm
U719, U720, U726, U727, U729, U730, U731, U748, U749, U750, U751, U753, U754: 74HC574; DIP-20_W7.62mm
U721, U722, U723, U738: 74HC157; DIP-16_W7.62mm
U724, U725: 62256; DIP-28_W15.24mm
U728: 28C256; DIP-28_W15.24mm
U732: 74HC166; DIP-16_W7.62mm
U733, U734, U735: 74HC175; DIP-16_W7.62mm
U757, U758, U759, U760, U761, U762, U763, U764: 74HC08; DIP-14_W7.62mm
U765, U766, U767: 74HC32; DIP-14_W7.62mm
U768: 74HC00; DIP-14_W7.62mm
U769: 74HC02; DIP-14_W7.62mm
U770, U771: 74HC04; DIP-14_W7.62mm
U772, U773: 74HC10; DIP-14_W7.62mm
X701: OSC_25M175; Oscillator_DIP-14

Connections:
A0: J702.9, U769.9 (3B)
A1: J702.10, U702.1 (A0), U703.1 (A0), U704.1 (A0)
A2: J702.11, U702.2 (A1), U703.2 (A1), U704.2 (A1)
A3: J702.12, U702.3 (A2), U703.3 (A2), U704.3 (A2)
A4: J702.13, U701.1 (A0)
A5: J702.14, U701.2 (A1)
A6: J702.15, U701.3 (A2)
A7: J702.16, U701.5 (~E2)
A8: J702.17
A9: J702.18
A10: J702.19
A11: J702.20
A12: J702.21
A13: J702.22
A14: J702.23
A15: J702.24
CLK: J702.5, U747.3 (1CLK)
DE0: J702.25, U715.18 (Y0), U740.3 (D0), U748.2 (D0), U749.2 (D0), U750.19 (Q0), U751.19 (Q0), U753.2 (D0), U755.18 (Y0)
DE1: J702.26, U715.17 (Y1), U740.4 (D1), U748.3 (D1), U749.3 (D1), U750.18 (Q1), U751.18 (Q1), U753.3 (D1), U755.17 (Y1), U768.5 (2B)
DE2: J702.27, U715.16 (Y2), U740.5 (D2), U748.4 (D2), U749.4 (D2), U750.17 (Q2), U751.17 (Q2), U753.4 (D2), U755.16 (Y2)
DE3: J702.28, U715.15 (Y3), U740.6 (D3), U748.5 (D3), U749.5 (D3), U750.16 (Q3), U751.16 (Q3), U753.5 (D3), U755.15 (Y3)
DE4: J702.29, U715.14 (Y4), U741.3 (D0), U748.6 (D4), U749.6 (D4), U750.15 (Q4), U751.15 (Q4), U753.6 (D4), U755.14 (Y4)
DE5: J702.30, U715.13 (Y5), U741.4 (D1), U748.7 (D5), U749.7 (D5), U750.14 (Q5), U751.14 (Q5), U753.7 (D5), U755.13 (Y5)
DE6: J702.31, U715.12 (Y6), U741.5 (D2), U748.8 (D6), U749.8 (D6), U750.13 (Q6), U751.13 (Q6), U753.8 (D6), U755.12 (Y6)
DE7: J702.32, U715.11 (Y7), U741.6 (D3), U748.9 (D7), U749.9 (D7), U750.12 (Q7), U751.12 (Q7), U753.9 (D7), U755.11 (Y7)
DO0: J702.33, U742.3 (D0), U747.12 (2D), U752.18 (Y0), U754.2 (D0), U756.18 (Y0)
DO1: J702.34, U742.4 (D1), U752.17 (Y1), U754.3 (D1), U756.17 (Y1)
DO2: J702.35, U742.5 (D2), U752.16 (Y2), U754.4 (D2), U756.16 (Y2)
DO3: J702.36, U742.6 (D3), U752.15 (Y3), U754.5 (D3), U756.15 (Y3)
DO4: J702.37, U743.3 (D0), U752.14 (Y4), U754.6 (D4), U756.14 (Y4)
DO5: J702.38, U743.4 (D1), U752.13 (Y5), U754.7 (D5), U756.13 (Y5)
DO6: J702.39, U743.5 (D2), U752.12 (Y6), U754.8 (D6), U756.12 (Y6)
DO7: J702.40, U743.6 (D3), U752.11 (Y7), U754.9 (D7), U756.11 (Y7)
FAULT: J702.45
GND: C701.2 (-), C702.2, C703.2, C704.2, C705.2, C706.2, C707.2, C708.2, C709.2, C710.2, C711.2, C712.2, C713.2, C714.2, C715.2, C716.2, C717.2, C718.2, C719.2, C720.2, C721.2, C722.2, C723.2, C724.2, C725.2, C726.2, C727.2, C728.2, C729.2, C730.2, C731.2, C732.2, C733.2, C734.2, C735.2, C736.2, C737.2, C738.2, C739.2, C740.2, C741.2, C742.2, C743.2, C744.2, C745.2, C746.2, C747.2, C748.2, C749.2, C750.2, C751.2, C752.2, C753.2, C754.2, C755.2, C756.2, C757.2, C758.2, C759.2, C760.2, C761.2, C762.2, C763.2, C764.2, C765.2, C766.2, C767.2, C768.2, C769.2, C770.2, C771.2, C772.2, C773.2, C774.2, J701.5 (GND), J701.6 (RED_RTN), J701.7 (GREEN_RTN), J701.8 (BLUE_RTN), J701.10 (SYNC_GND), J702.1, J702.2, J702.62, J702.64, U701.8 (GND), U702.8 (GND), U703.8 (GND), U704.8 (GND), U705.4 (D1), U705.5 (D2), U705.8 (GND), U706.7 (GND), U707.3 (D0), U707.4 (D1), U707.5 (D2), U707.6 (D3), U707.8 (GND), U708.3 (D0), U708.4 (D1), U708.5 (D2), U708.6 (D3), U708.8 (GND), U709.3 (D0), U709.4 (D1), U709.5 (D2), U709.6 (D3), U709.8 (GND), U710.3 (D0), U710.4 (D1), U710.5 (D2), U710.6 (D3), U710.8 (GND), U711.3 (D0), U711.4 (D1), U711.5 (D2), U711.6 (D3), U711.8 (GND), U712.5 (Q1), U712.9 (Q3), U712.10 (GND), U713.7 (GND), U714.2 (1MR), U714.7 (GND), U714.12 (2MR), U715.4 (A2), U715.5 (A3), U715.6 (A4), U715.7 (A5), U715.8 (A6), U715.9 (A7), U715.10 (GND), U715.19 (~OE2), U716.8 (GND), U717.8 (GND), U718.8 (GND), U719.1 (~OE), U719.10 (GND), U720.1 (~OE), U720.6 (D4), U720.7 (D5), U720.8 (D6), U720.9 (D7), U720.10 (GND), U721.8 (GND), U721.15 (~E), U722.8 (GND), U722.15 (~E), U723.8 (GND), U723.15 (~E), U724.1 (A14), U724.2 (A12), U724.14 (GND), U724.20 (~CE), U724.26 (A13), U725.1 (A14), U725.2 (A12), U725.14 (GND), U725.20 (~CE), U725.26 (A13), U726.1 (~OE), U726.10 (GND), U727.1 (~OE), U727.10 (GND), U728.1 (A14), U728.2 (A12), U728.14 (GND), U728.20 (~CE), U728.22 (~OE), U728.26 (A13), U729.1 (~OE), U729.10 (GND), U730.1 (~OE), U730.10 (GND), U731.1 (~OE), U731.10 (GND), U732.1 (DS), U732.6 (~CE), U732.8 (GND), U733.8 (GND), U734.8 (GND), U735.8 (GND), U736.1 (~E), U736.10 (GND), U736.17 (P7), U737.1 (~E), U737.10 (GND), U737.15 (P6), U737.17 (P7), U738.8 (GND), U739.2 (1D), U739.7 (GND), U739.12 (2D), U740.8 (GND), U741.8 (GND), U742.8 (GND), U743.8 (GND), U744.7 (GND), U745.7 (GND), U746.7 (GND), U747.7 (GND), U748.10 (GND), U749.10 (GND), U750.10 (GND), U751.10 (GND), U752.3 (A1), U752.4 (A2), U752.5 (A3), U752.6 (A4), U752.7 (A5), U752.8 (A6), U752.9 (A7), U752.10 (GND), U752.19 (~OE2), U753.1 (~OE), U753.10 (GND), U754.1 (~OE), U754.10 (GND), U755.10 (GND), U755.19 (~OE2), U756.10 (GND), U756.19 (~OE2), U757.7 (GND), U758.7 (GND), U759.7 (GND), U760.7 (GND), U761.7 (GND), U762.7 (GND), U763.7 (GND), U764.4 (2A), U764.5 (2B), U764.7 (GND), U764.9 (3A), U764.10 (3B), U764.12 (4A), U764.13 (4B), U765.7 (GND), U766.7 (GND), U767.7 (GND), U767.12 (4A), U767.13 (4B), U768.7 (GND), U769.7 (GND), U769.11 (4A), U769.12 (4B), U770.7 (GND), U771.7 (GND), U771.9 (4A), U771.11 (5A), U771.13 (6A), U772.7 (GND), U773.3 (2A), U773.4 (2B), U773.5 (2C), U773.7 (GND), U773.9 (3A), U773.10 (3B), U773.11 (3C), X701.7 (GND)
HALTED: J702.44
IRQ: J702.8
N3890: U758.2 (1B), U765.3 (1Y)
N3893: U758.5 (2B), U770.8 (4Y)
N3895: U758.8 (3Y), U758.12 (4A)
N3896: U758.13 (4B), U770.10 (5Y)
N3898: U765.6 (2Y), U765.9 (3A)
N3899: U759.1 (1A), U765.8 (3Y)
N3900: U759.2 (1B), U772.6 (2Y)
N3903: U759.8 (3Y), U760.1 (1A)
N3904: U759.11 (4Y), U760.2 (1B)
N3905: U760.3 (1Y), U765.13 (4B)
N3920: U768.4 (2A), U770.12 (6Y)
N3921: U760.13 (4B), U768.6 (2Y)
N4049: U766.6 (2Y), U768.10 (3B)
N4402: U761.5 (2B), U771.4 (2Y)
N4403: U761.6 (2Y), U761.12 (4A)
N4405: U761.9 (3A), U769.1 (1Y)
N4406: U761.8 (3Y), U761.13 (4B)
N4422: U762.3 (1Y), U762.4 (2A)
N4423: U762.5 (2B), U769.4 (2Y)
N4425: U762.10 (3B), U771.6 (3Y)
N4435: U763.3 (1Y), U763.4 (2A)
OSC: J702.49
PA14: J702.50
PA15: J702.51
PA16: J702.52
PA17: J702.53
PA18: J702.54
PA19: J702.55
TCLK: J702.48
VCC: C701.1 (+), C702.1, C703.1, C704.1, C705.1, C706.1, C707.1, C708.1, C709.1, C710.1, C711.1, C712.1, C713.1, C714.1, C715.1, C716.1, C717.1, C718.1, C719.1, C720.1, C721.1, C722.1, C723.1, C724.1, C725.1, C726.1, C727.1, C728.1, C729.1, C730.1, C731.1, C732.1, C733.1, C734.1, C735.1, C736.1, C737.1, C738.1, C739.1, C740.1, C741.1, C742.1, C743.1, C744.1, C745.1, C746.1, C747.1, C748.1, C749.1, C750.1, C751.1, C752.1, C753.1, C754.1, C755.1, C756.1, C757.1, C758.1, C759.1, C760.1, C761.1, C762.1, C763.1, C764.1, C765.1, C766.1, C767.1, C768.1, C769.1, C770.1, C771.1, C772.1, C773.1, C774.1, J702.3, J702.4, J702.63, U701.6 (E3), U701.16 (VCC), U702.6 (E3), U702.16 (VCC), U703.6 (E3), U703.16 (VCC), U704.6 (E3), U704.16 (VCC), U705.1 (~MR), U705.3 (D0), U705.6 (D3), U705.7 (CEP), U705.10 (CET), U705.16 (VCC), U706.1 (~1CLR), U706.4 (~1PRE), U706.10 (~2PRE), U706.13 (~2CLR), U706.14 (VCC), U707.1 (~MR), U707.7 (CEP), U707.10 (CET), U707.16 (VCC), U708.1 (~MR), U708.7 (CEP), U708.16 (VCC), U709.1 (~MR), U709.10 (CET), U709.16 (VCC), U710.1 (~MR), U710.16 (VCC), U711.1 (~MR), U711.16 (VCC), U712.3 (Q0), U712.7 (Q2), U712.12 (Q4), U712.14 (Q5), U712.16 (Q6), U712.18 (Q7), U712.20 (VCC), U713.1 (~1CLR), U713.4 (~1PRE), U713.10 (~2PRE), U713.12 (2D), U713.14 (VCC), U714.14 (VCC), U715.20 (VCC), U716.16 (VCC), U717.16 (VCC), U718.16 (VCC), U719.20 (VCC), U720.20 (VCC), U721.16 (VCC), U722.16 (VCC), U723.16 (VCC), U724.28 (VCC), U725.28 (VCC), U726.20 (VCC), U727.20 (VCC), U728.27 (~WE), U728.28 (VCC), U729.20 (VCC), U730.20 (VCC), U731.20 (VCC), U732.9 (~MR), U732.16 (VCC), U733.1 (~MR), U733.16 (VCC), U734.1 (~MR), U734.16 (VCC), U735.1 (~MR), U735.16 (VCC), U736.20 (VCC), U737.20 (VCC), U738.16 (VCC), U739.14 (VCC), U740.10 (CET), U740.16 (VCC), U741.16 (VCC), U742.16 (VCC), U743.16 (VCC), U744.2 (1D), U744.4 (~1PRE), U744.12 (2D), U744.14 (VCC), U745.4 (~1PRE), U745.10 (~2PRE), U745.14 (VCC), U746.4 (~1PRE), U746.10 (~2PRE), U746.14 (VCC), U747.4 (~1PRE), U747.10 (~2PRE), U747.14 (VCC), U748.20 (VCC), U749.20 (VCC), U750.20 (VCC), U751.20 (VCC), U752.20 (VCC), U753.20 (VCC), U754.20 (VCC), U755.20 (VCC), U756.20 (VCC), U757.14 (VCC), U758.14 (VCC), U759.14 (VCC), U760.14 (VCC), U761.14 (VCC), U762.14 (VCC), U763.14 (VCC), U764.14 (VCC), U765.14 (VCC), U766.14 (VCC), U767.14 (VCC), U768.14 (VCC), U769.14 (VCC), U770.14 (VCC), U771.14 (VCC), U772.14 (VCC), U773.14 (VCC), X701.1 (EN), X701.14 (VCC)
VGA_BLUE: J701.3 (BLUE), R705.2, R706.2
VGA_GREEN: J701.2 (GREEN), R703.2, R704.2
VGA_HSYNC: J701.13 (HSYNC), U735.6 (~Q1)
VGA_RED: J701.1 (RED), R701.2, R702.2
VGA_VSYNC: J701.14 (VSYNC), U735.10 (Q2)
VID_OSC: U705.2 (CP), U706.3 (1CLK), U706.11 (2CLK), U732.7 (CP), X701.8 (OUT)
VSYNC_REQ: J702.56, U713.9 (2Q), U715.3 (A1)
V_AD0: U725.11 (IO0), U727.2 (D0), U749.19 (Q0), U751.2 (D0)
V_AD1: U725.12 (IO1), U727.3 (D1), U749.18 (Q1), U751.3 (D1)
V_AD2: U725.13 (IO2), U727.4 (D2), U749.17 (Q2), U751.4 (D2)
V_AD3: U725.15 (IO3), U727.5 (D3), U749.16 (Q3), U751.5 (D3)
V_AD4: U725.16 (IO4), U727.6 (D4), U749.15 (Q4), U751.6 (D4)
V_AD5: U725.17 (IO5), U727.7 (D5), U749.14 (Q5), U751.7 (D5)
V_AD6: U725.18 (IO6), U727.8 (D6), U749.13 (Q6), U751.8 (D6)
V_AD7: U725.19 (IO7), U727.9 (D7), U749.12 (Q7), U751.9 (D7)
V_ADR0: U740.14 (Q0), U767.5 (2B), U771.1 (1A), U773.13 (1C)
V_ADR1: U721.3 (1I1), U740.13 (Q1)
V_ADR2: U721.6 (2I1), U740.12 (Q2)
V_ADR3: U721.10 (3I1), U740.11 (Q3)
V_ADR4: U721.13 (4I1), U741.14 (Q0)
V_ADR5: U722.3 (1I1), U741.13 (Q1)
V_ADR6: U722.6 (2I1), U741.12 (Q2)
V_ADR7: U722.10 (3I1), U741.11 (Q3)
V_ADR8: U722.13 (4I1), U742.14 (Q0)
V_ADR9: U723.3 (1I1), U742.13 (Q1)
V_ADR10: U723.6 (2I1), U742.12 (Q2)
V_ADR11: U723.10 (3I1), U742.11 (Q3)
V_ADR12: U723.13 (4I1), U743.14 (Q0)
V_AT0: U727.19 (Q0), U730.2 (D0)
V_AT1: U727.18 (Q1), U730.3 (D1)
V_AT2: U727.17 (Q2), U730.4 (D2)
V_AT3: U727.16 (Q3), U730.5 (D3)
V_AT4: U727.15 (Q4), U730.6 (D4)
V_AT5: U727.14 (Q5), U730.7 (D5)
V_AT6: U727.13 (Q6), U730.8 (D6)
V_AT7: U727.12 (Q7), U730.9 (D7)
V_AT20: U730.19 (Q0), U731.2 (D0)
V_AT21: U730.18 (Q1), U731.3 (D1)
V_AT22: U730.17 (Q2), U731.4 (D2)
V_AT23: U730.16 (Q3), U731.5 (D3)
V_AT24: U730.15 (Q4), U731.6 (D4)
V_AT25: U730.14 (Q5), U731.7 (D5)
V_AT26: U730.13 (Q6), U731.8 (D6)
V_AT27: U730.12 (Q7), U731.9 (D7)
V_ATC0: U740.15 (TC), U741.10 (CET)
V_ATC1: U741.15 (TC), U742.10 (CET)
V_ATC2: U742.15 (TC), U743.10 (CET)
V_ATD0: U731.19 (Q0), U738.3 (1I1)
V_ATD1: U731.18 (Q1), U738.6 (2I1)
V_ATD2: U731.17 (Q2), U738.10 (3I1)
V_ATD3: U731.16 (Q3), U738.13 (4I1)
V_ATD4: U731.15 (Q4), U738.2 (1I0)
V_ATD5: U731.14 (Q5), U738.5 (2I0)
V_ATD6: U731.13 (Q6), U738.11 (3I0)
V_ATD7: U731.12 (Q7), U738.14 (4I0)
V_B: R705.1, U738.4 (1Y), U769.6 (2B)
V_BLANK: U733.4 (D0), U766.3 (1Y)
V_BLANKD: U735.2 (Q0), U738.15 (~E)
V_BLANKP: U733.2 (Q0), U734.4 (D0)
V_BLANKQ: U734.2 (Q0), U735.4 (D0)
V_BLINK: U714.11 (2Q0), U771.3 (2A)
V_BROWN: U762.6 (2Y), U767.2 (1B), U771.5 (3A)
V_CD0: U724.11 (IO0), U726.2 (D0), U748.19 (Q0), U750.2 (D0)
V_CD1: U724.12 (IO1), U726.3 (D1), U748.18 (Q1), U750.3 (D1)
V_CD2: U724.13 (IO2), U726.4 (D2), U748.17 (Q2), U750.4 (D2)
V_CD3: U724.15 (IO3), U726.5 (D3), U748.16 (Q3), U750.5 (D3)
V_CD4: U724.16 (IO4), U726.6 (D4), U748.15 (Q4), U750.6 (D4)
V_CD5: U724.17 (IO5), U726.7 (D5), U748.14 (Q5), U750.7 (D5)
V_CD6: U724.18 (IO6), U726.8 (D6), U748.13 (Q6), U750.8 (D6)
V_CD7: U724.19 (IO7), U726.9 (D7), U748.12 (Q7), U750.9 (D7)
V_CHR0: U726.19 (Q0), U728.6 (A4)
V_CHR1: U726.18 (Q1), U728.5 (A5)
V_CHR2: U726.17 (Q2), U728.4 (A6)
V_CHR3: U726.16 (Q3), U728.3 (A7)
V_CHR4: U726.15 (Q4), U728.25 (A8)
V_CHR5: U726.14 (Q5), U728.24 (A9)
V_CHR6: U726.13 (Q6), U728.21 (A10)
V_CHR7: U726.12 (Q7), U728.23 (A11)
V_CURD: U735.15 (Q3), U766.13 (4B)
V_CURP: U733.15 (Q3), U734.13 (D3)
V_CURQ: U734.15 (Q3), U735.13 (D3)
V_CURR: U733.13 (D3), U761.11 (4Y)
V_CX0: U736.3 (Q0), U753.19 (Q0), U755.2 (A0)
V_CX1: U736.5 (Q1), U753.18 (Q1), U755.3 (A1)
V_CX2: U736.7 (Q2), U753.17 (Q2), U755.4 (A2)
V_CX3: U736.9 (Q3), U753.16 (Q3), U755.5 (A3)
V_CX4: U736.12 (Q4), U753.15 (Q4), U755.6 (A4)
V_CX5: U736.14 (Q5), U753.14 (Q5), U755.7 (A5)
V_CX6: U736.16 (Q6), U753.13 (Q6), U755.8 (A6)
V_CX7: U736.18 (Q7), U753.12 (Q7), U755.9 (A7)
V_CY0: U737.3 (Q0), U754.19 (Q0), U756.2 (A0)
V_CY1: U737.5 (Q1), U754.18 (Q1), U756.3 (A1)
V_CY2: U737.7 (Q2), U754.17 (Q2), U756.4 (A2)
V_CY3: U737.9 (Q3), U754.16 (Q3), U756.5 (A3)
V_CY4: U737.12 (Q4), U754.15 (Q4), U756.6 (A4)
V_CY5: U737.14 (Q5), U754.14 (Q5), U756.7 (A5)
V_CY6: U737.16 (Q6), U754.13 (Q6), U756.8 (A6)
V_CY7: U737.18 (Q7), U754.12 (Q7), U756.9 (A7)
V_FD0: U728.11 (IO0), U729.2 (D0)
V_FD1: U728.12 (IO1), U729.3 (D1)
V_FD2: U728.13 (IO2), U729.4 (D2)
V_FD3: U728.15 (IO3), U729.5 (D3)
V_FD4: U728.16 (IO4), U729.6 (D4)
V_FD5: U728.17 (IO5), U729.7 (D5)
V_FD6: U728.18 (IO6), U729.8 (D6)
V_FD7: U728.19 (IO7), U729.9 (D7)
V_FGSEL: U738.1 (S), U766.11 (4Y)
V_FP0: U729.19 (Q0), U732.2 (D0)
V_FP1: U729.18 (Q1), U732.3 (D1)
V_FP2: U729.17 (Q2), U732.4 (D2)
V_FP3: U729.16 (Q3), U732.5 (D3)
V_FP4: U729.15 (Q4), U732.10 (D4)
V_FP5: U729.14 (Q5), U732.11 (D5)
V_FP6: U729.13 (Q6), U732.12 (D6)
V_FP7: U729.12 (Q7), U732.14 (D7)
V_FR3: U714.6 (1Q3), U714.13 (~2CP)
V_G: U738.7 (2Y), U762.2 (1B), U762.9 (3A)
V_GH: R703.1, U762.8 (3Y)
V_GL: R704.1, U767.3 (1Y)
V_H2: U706.5 (1Q), U707.2 (CP), U708.2 (CP), U709.2 (CP), U710.2 (CP), U711.2 (CP), U716.2 (CP), U717.2 (CP), U718.2 (CP), U721.1 (S), U722.1 (S), U723.1 (S), U726.11 (CP), U727.11 (CP), U729.11 (CP), U730.11 (CP), U733.9 (CP), U734.9 (CP), U746.3 (1CLK), U746.11 (2CLK), U757.12 (4A), U761.2 (1B), U766.9 (3A), U770.1 (1A)
V_H2N: U713.3 (1CLK), U745.3 (1CLK), U745.11 (2CLK), U770.2 (1Y)
V_H3: U707.14 (Q0), U736.2 (P0), U768.2 (1B), U770.9 (4A)
V_H4: U707.13 (Q1), U736.4 (P1), U757.5 (2B), U765.4 (2A), U772.3 (2A)
V_H5: U707.12 (Q2), U736.6 (P2), U765.5 (2B), U772.4 (2B)
V_H6: U707.11 (Q3), U736.8 (P3), U765.10 (3B), U772.5 (2C)
V_H7: U708.14 (Q0), U736.11 (P4), U758.10 (3B), U765.2 (1B)
V_H8: U708.13 (Q1), U736.13 (P5), U757.1 (1A), U765.1 (1A), U770.11 (5A)
V_H9: U708.12 (Q2), U736.15 (P6), U757.2 (1B), U758.1 (1A), U758.9 (3A)
V_H89: U757.3 (1Y), U757.4 (2A)
V_H984: U757.6 (2Y), U758.4 (2A), U768.1 (1A)
V_HBL: U758.3 (1Y), U766.1 (1A), U770.5 (3A)
V_HC98: U758.6 (2Y), U768.9 (3A)
V_HEND: U709.7 (CEP), U710.7 (CEP), U711.7 (CEP), U770.4 (2Y), U772.1 (1A)
V_HSA: U758.11 (4Y), U759.4 (2A)
V_HSB: U759.3 (1Y), U759.5 (2B)
V_HSYNCP: U733.7 (Q1), U734.5 (D1)
V_HSYNCQ: U734.7 (Q1), U735.5 (D1)
V_HSYNC_A: U733.5 (D1), U759.6 (2Y)
V_HTC0: U707.15 (TC), U708.10 (CET)
V_HVIS: U716.7 (CEP), U716.10 (CET), U717.7 (CEP), U718.7 (CEP), U770.6 (3Y)
V_I: R702.1, R706.1, U738.12 (4Y), U767.1 (1A), U769.5 (2A)
V_INC: U762.11 (4Y), U763.5 (2B)
V_LD7: U706.9 (2Q), U764.2 (1B), U768.13 (4B)
V_MA0: U716.14 (Q0), U719.2 (D0), U721.2 (1I0)
V_MA1: U716.13 (Q1), U719.3 (D1), U721.5 (2I0)
V_MA2: U716.12 (Q2), U719.4 (D2), U721.11 (3I0)
V_MA3: U716.11 (Q3), U719.5 (D3), U721.14 (4I0)
V_MA4: U717.14 (Q0), U719.6 (D4), U722.2 (1I0)
V_MA5: U717.13 (Q1), U719.7 (D5), U722.5 (2I0)
V_MA6: U717.12 (Q2), U719.8 (D6), U722.11 (3I0)
V_MA7: U717.11 (Q3), U719.9 (D7), U722.14 (4I0)
V_MA8: U718.14 (Q0), U720.2 (D0), U723.2 (1I0)
V_MA9: U718.13 (Q1), U720.3 (D1), U723.5 (2I0)
V_MA10: U718.12 (Q2), U720.4 (D2), U723.11 (3I0)
V_MA11: U718.11 (Q3), U720.5 (D3), U723.14 (4I0)
V_MATC0: U716.15 (TC), U717.10 (CET)
V_MATC1: U717.15 (TC), U718.10 (CET)
V_OPR: U746.9 (2Q), U764.1 (1A)
V_OPR_D: U746.12 (2D), U763.11 (4Y)
V_OPW: U746.5 (1Q), U761.1 (1A), U768.12 (4A), U772.9 (3A), U773.1 (1A)
V_PFCLK: U739.3 (1CLK), U739.11 (2CLK), U740.2 (CP), U741.2 (CP), U742.2 (CP), U743.2 (CP), U744.11 (2CLK), U763.6 (2Y)
V_PIX: U732.13 (Q7), U766.12 (4A)
V_PREF: U744.9 (2Q), U745.12 (2D)
V_PREFS: U745.9 (2Q), U763.12 (4A)
V_Q1: U705.13 (Q1), U757.13 (4B)
V_Q2: U705.12 (Q2), U706.2 (1D)
V_Q15: U705.15 (TC), U706.12 (2D)
V_R: R701.1, U738.9 (3Y), U762.1 (1A)
V_RDCLK: U750.11 (CP), U751.11 (CP), U764.3 (1Y)
V_RDD: U747.2 (1D), U769.10 (3Y)
V_RS0: U716.3 (D0), U719.19 (Q0)
V_RS1: U716.4 (D1), U719.18 (Q1)
V_RS2: U716.5 (D2), U719.17 (Q2)
V_RS3: U716.6 (D3), U719.16 (Q3)
V_RS4: U717.3 (D0), U719.15 (Q4)
V_RS5: U717.4 (D1), U719.14 (Q5)
V_RS6: U717.5 (D2), U719.13 (Q6)
V_RS7: U717.6 (D3), U719.12 (Q7)
V_RS8: U718.3 (D0), U720.19 (Q0)
V_RS9: U718.4 (D1), U720.18 (Q1)
V_RS10: U718.5 (D2), U720.17 (Q2)
V_RS11: U718.6 (D3), U720.16 (Q3)
V_RSCLK: U719.11 (CP), U720.11 (CP), U766.8 (3Y)
V_SL15: U760.8 (3Y), U766.4 (2A)
V_SOE: U724.22 (~OE), U725.22 (~OE), U761.3 (1Y)
V_V0: U709.14 (Q0), U728.10 (A0), U760.10 (3B)
V_V1: U709.13 (Q1), U712.2 (P0), U728.9 (A1), U760.5 (2B)
V_V2: U709.12 (Q2), U712.4 (P1), U728.8 (A2), U757.10 (3B)
V_V3: U709.11 (Q3), U712.6 (P2), U728.7 (A3), U757.9 (3A)
V_V4: U710.14 (Q0), U712.8 (P3), U737.2 (P0)
V_V5: U710.13 (Q1), U712.11 (P4), U737.4 (P1), U759.13 (4B)
V_V6: U710.12 (Q2), U712.13 (P5), U737.6 (P2), U759.12 (4A)
V_V7: U710.11 (Q3), U712.15 (P6), U737.8 (P3), U759.10 (3B)
V_V8: U711.14 (Q0), U712.17 (P7), U737.11 (P4), U759.9 (3A)
V_V9: U711.13 (Q1), U712.1 (~E), U737.13 (P5), U765.12 (4A), U772.2 (1B)
V_V32: U757.8 (3Y), U760.4 (2A), U772.13 (1C)
V_V321: U760.6 (2Y), U760.9 (3A), U761.10 (3B)
V_VA0: U721.4 (1Y), U724.10 (A0), U725.10 (A0)
V_VA1: U721.7 (2Y), U724.9 (A1), U725.9 (A1)
V_VA2: U721.9 (3Y), U724.8 (A2), U725.8 (A2)
V_VA3: U721.12 (4Y), U724.7 (A3), U725.7 (A3)
V_VA4: U722.4 (1Y), U724.6 (A4), U725.6 (A4)
V_VA5: U722.7 (2Y), U724.5 (A5), U725.5 (A5)
V_VA6: U722.9 (3Y), U724.4 (A6), U725.4 (A6)
V_VA7: U722.12 (4Y), U724.3 (A7), U725.3 (A7)
V_VA8: U723.4 (1Y), U724.25 (A8), U725.25 (A8)
V_VA9: U723.7 (2Y), U724.24 (A9), U725.24 (A9)
V_VA10: U723.9 (3Y), U724.21 (A10), U725.21 (A10)
V_VA11: U723.12 (4Y), U724.23 (A11), U725.23 (A11)
V_VBL: U713.2 (1D), U765.11 (4Y), U766.2 (1B), U766.5 (2B)
V_VBQ: U713.5 (1Q), U713.11 (2CLK), U715.2 (A0)
V_VCTL: U747.9 (2Q), U752.2 (A0), U761.4 (2A)
V_VTC0: U709.15 (TC), U710.10 (CET)
V_VTC1: U710.15 (TC), U711.10 (CET)
V_WREQ: U744.5 (1Q), U745.2 (1D)
V_WREQS: U745.5 (1Q), U746.2 (1D)
V_WRP: U757.11 (4Y), U772.10 (3B), U773.2 (1B)
WR_WIN: J702.6
~IO: J702.47, U701.4 (~E1)
~MRD: J702.41, U702.5 (~E2)
~MWE_E: J702.42, U703.5 (~E2)
~MWE_O: J702.43, U704.5 (~E2)
~RESET: J702.7, U739.1 (~1CLR), U739.13 (~2CLR), U740.1 (~MR), U741.1 (~MR), U742.1 (~MR), U743.1 (~MR), U744.10 (~2PRE), U745.1 (~1CLR), U745.13 (~2CLR), U746.1 (~1CLR), U746.13 (~2CLR), U747.1 (~1CLR), U747.13 (~2CLR), U760.12 (4A), U763.10 (3B)
~V_ADR0: U767.10 (3B), U771.2 (1Y), U772.11 (3C)
~V_CXEQ: U736.19 (~EQ), U769.2 (1A)
~V_CYEQ: U737.19 (~EQ), U769.3 (1B)
~V_ENRS: U766.10 (3B), U768.8 (3Y)
~V_FCLR: U713.13 (~2CLR), U760.11 (4Y)
~V_G: U701.13 (~Y2), U702.4 (~E1), U703.4 (~E1), U704.4 (~E1)
~V_HEND: U707.9 (~PE), U708.9 (~PE), U716.9 (~PE), U717.9 (~PE), U718.9 (~PE), U768.3 (1Y), U770.3 (2A)
~V_LD7: U705.9 (~PE), U705.11 (Q3), U731.11 (CP), U732.15 (~PE), U735.9 (CP)
~V_LHI: U739.8 (~2Q), U740.7 (CEP), U741.7 (CEP), U742.9 (~PE), U743.9 (~PE)
~V_LLO: U739.6 (~1Q), U740.9 (~PE), U741.9 (~PE), U742.7 (CEP), U743.7 (CEP)
~V_OPR: U744.13 (~2CLR), U746.8 (~2Q)
~V_OPW: U746.6 (~1Q), U763.9 (3A)
~V_RD1: U702.14 (~Y1), U752.1 (~OE1), U767.4 (2A), U767.9 (3A), U769.8 (3A)
~V_RD2: U702.13 (~Y2), U755.1 (~OE1), U756.1 (~OE1)
~V_RD3: U702.12 (~Y3), U715.1 (~OE1)
~V_RDA: U751.1 (~OE), U767.8 (3Y)
~V_RDC: U750.1 (~OE), U767.6 (2Y)
~V_RDDQ: U747.6 (~1Q), U762.12 (4A)
~V_VBQ: U713.6 (~1Q), U714.1 (~1CP), U716.1 (~MR), U717.1 (~MR), U718.1 (~MR)
~V_VLD: U709.9 (~PE), U710.9 (~PE), U711.9 (~PE), U772.12 (1Y)
~V_VSYNCP: U733.10 (Q2), U734.12 (D2)
~V_VSYNCQ: U734.10 (Q2), U735.12 (D2)
~V_VSYNC_A: U712.19 (~EQ), U733.12 (D2)
~V_WE0: U703.15 (~Y0), U739.4 (~1PRE), U763.1 (1A)
~V_WE1: U703.14 (~Y1), U744.3 (1CLK), U748.11 (CP), U749.11 (CP)
~V_WE2: U703.13 (~Y2), U753.11 (CP)
~V_WE3: U703.12 (~Y3), U770.13 (6A)
~V_WEA: U725.27 (~WE), U749.1 (~OE), U773.12 (1Y)
~V_WEC: U724.27 (~WE), U748.1 (~OE), U772.8 (3Y)
~V_WINC: U762.13 (4B), U768.11 (4Y)
~V_WO0: U704.15 (~Y0), U739.10 (~2PRE), U763.2 (1B)
~V_WO1: U704.14 (~Y1), U747.11 (2CLK)
~V_WO2: U704.13 (~Y2), U754.11 (CP)
~V_WRCLR: U744.1 (~1CLR), U763.8 (3Y)
~V_WREQS: U745.6 (~1Q), U763.13 (4B)
~WAIT: J702.46
