MihrimatriX/breadboarding/(commit log)

2026-10-11 Silikon3D: transistör seviyesi 3D 6502 die simülatörü
2026-10-11 CPU16 Faz 1: referans emülatör, as16 assembler, disassembler ve CLI
    - emu/cpu.ts: komut seviyesi altın model (NZCV, IRQ/SWI/RETI, HALT uyanma)
    - asm/assembler.ts: iki geçişli as16 (ifadeler, direktifler, LI sözde komutu)
    - asm/hex.ts: Intel HEX okuma/yazma (EEPROM programlayıcı için)
    - tools/cli.ts: npm run cpu16 -- asm|run|dis
    - programs/: hello, fib, add32 (yazılımla çarpma), bubble, irq
    - 52 test; disassembler tüm 65 536 kelimede gidiş-dönüş
    - docs: isa-ayrintilari.md, as16.md; yol haritası Faz 2'ye ilerledi
2026-10-11 Silikon3D'ye CPU16 tezgâhı bölümü ekle
    Üst çubuktaki '6502 die | CPU16 tezgâhı' geçişiyle (#cpu16) as16 ile
    derleyip referans emülatörde adım adım çalıştırma: register LED'leri,
    bayraklar, komut izi, UART ve bellek görünümü. 6502 görünümü bağlı
    kalır; CPU16'ya geçince simülasyonu duraklatılır ve 3D sahne kapanır.
2026-10-11 CPU16 Faz 3: 74HC parça kütüphanesi, CMOS transistör açılımı ve KiCad sembolleri
    29 çip (26 kapı seviyesi 74HC + 3 davranışsal bellek): veri sayfası pin
    düzenleri, kapı devreleri ve bağımsız yazılmış fonksiyon tabloları.
    Kapı modeli tabloya karşı (birleşimsel çiplerde bütün kombinasyonlar),
    transistör açılımı Silikon3D anahtar seviyesi motorunda kapı modeline
    karşı adım adım test ediliyor. KiCad 7 sembol kütüphanesi aynı kaynaktan
    üretiliyor. SwitchLevelEngine'e release() eklendi.
2026-10-11 CPU16 Faz 6-7: anakart modeli, karakter ROM'u, BIOS ve önyükleyici
    Machine (Bus): bank register'ları, SST39SF010 Flash (komut dizileri, ID
    modu, sektör/çip silme), 512 KB RAM, 2 KB doğrudan eşlemeli write-through
    önbellek, UART, PS/2 klavye (set 2), zamanlayıcı, 74HC148 tarzı kesme
    denetleyicisi, VGA metin kartı; döngü sayımı mikromimari tablosu + bekleme
    durumlarıyla. Karakter ROM'u X11 Misc-Fixed 8x13'ten (kamu malı), CP857.
    BIOS: atlama tablosu, monitör, Intel HEX önyükleyici (RAM / Flash).
2026-10-11 CPU16 Faz 4: kart şemaları kod olarak, kapı seviyesi bilgisayar ve KiCad çıktıları
    - cpu16/board: Board (şema = kod), CPU kartı (146 entegre), test bellek kartı (7 entegre),
    yapıştırıcı kapıların çiplere paketlenmesi, ERC, ALU kod çözme ROM'u
    - Kapı seviyesi bilgisayar saat döngüsü modeliyle her döngüde, emülatörle program sonunda aynı
    (5 program + 150 rastgele akış)
    - KiCad 7 şemaları, sembol kütüphanesi (pasifler dahil) ve BOM; kicad-cli netlist'i kart netleriyle
    karşılaştırılır
    - Yazma darbeleri WR_WIN penceresinde; IMM8 iki bayta kopyalanır (davranış aynı)
    - LogicSim: çekme dirençleri, setState, yalnızca saat değişince kenar algıla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
    [bom.csv, cpu.kicad_sch, mem.kicad_sch]
2026-10-11 CPU16: anakart ve BIOS testleri, örnek programlar, CLI bios/charrom/machine
    machine.test.ts: bank eşleme ve 1 MB alan, Flash komut dizileri ve ID modu,
    UART, PS/2 set 2, zamanlayıcı, IRQ öncelik/maske, vsync, VRAM portu,
    önbellek sayaçları ve bekleme durumlarının döngüye etkisi.
    bios.test.ts: açılış afişi (VGA + UART), monitör komutları, klavyeden
    satır, önyükleyici (RAM, Flash, 04 kaydı, hata yanıtları), örnekler.
2026-10-11 CPU16 Web IDE: anakart + BIOS kipi
    Tezgâhta iki kip: "Anakart + BIOS" (varsayılan) ve "Düz bellek" (Faz 1
    örnekleri, SimpleBus). Anakart kipi:
    - BIOS'lu tam Machine, requestAnimationFrame ile gerçek zamanlı (4 MHz;
    1/10, ×4 ve turbo seçenekleri), etkin MHz göstergesi
    - VGA tuvali: VRAM + karakter ROM'u (8x16, CP857), CGA paleti, yanıp
    sönen imleç; sadece değişen hücreler çizilir
    - Ekran odaktayken tuşlar PS/2 set 2 tarama kodlarına çevrilir
    - UART terminali (tuşlar ve satır gönderme)
    - as16 editörü: "Derle ve RAM'e yükle" ve "Flash'a yaz" gerçek karttaki
    akışla (reset, BIOS, L/F, Intel HEX, G); Flash'tan çalıştır kısayolu
    - "Karta gönder (Web Serial)":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
2026-10-11 CPU16 Faz 5: kart → çip → kapı → transistör 3D görünümü
    - Silikon3D'ye "CPU16 kartı 3D" bölümü (#kart): kapı seviyesi bilgisayar Web Worker'da saat saat
    çalışır; kartlar, entegreler, pinler, arka panel ve LED'ler canlı renkte
    - Çipe tıklayınca üstünde kalıbı (kapılar ve teller) açılır; alt panelde kapı seviyesi şema,
    kapıya tıklayınca CMOS transistör şeması (anahtar seviyesi motorda canlı)
    - Net seçimi: bağlı bütün pinler 3D'de birleşir
    - cpu16/board/layout.ts (fiziksel yerleşim), inside.ts (çip içi ve transistör şemaları, GateProbe),
    Board'a işlev bloğu etiketi
    - Testler: yerleşim çakışmasız, her kapının girişi bağlı,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
2026-10-11 CPU16 belgeleri: anakart.md ve bios.md
    anakart.md: blok şeması, 1 MB fiziksel harita ve bank pencereleri, G/Ç
    haritası (FF00–FF34), kesme denetleyicisi (74HC148), zamanlayıcı, önbellek
    kartı ve bekleme durumları (döngü hesabı örneği), video zamanlaması ve VRAM
    portu, karakter ROM'u ve fontun kaynağı/lisansı (X11 Misc-Fixed 8x13, kamu
    malı; CP857), PS/2, UART ve akış denetimi, SST39SF010 komut dizileri, blok
    başına 74HC çip listesi, model ile gerçek kart farkları.
    bios.md: ROM imajı üretme (bios/charrom/machine komutları), açılış, bellek
    yerleşimi, atlama tablosu ABI'si, kesmeler ve kullanıcı kancası, klavye,
    monitör komutları, önyükleyici protokol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
2026-10-11 Faz 8: cc16 API, libc16, örnek C programları ve testler
    - cc/index.ts: compile/buildProgram (tarayıcı uyumlu, dosya haritası)
    - cc/run.ts: ROM korumalı veriyolu ve runProgram
    - cc/node.ts, cc/lib-vite.ts: kütüphaneyi diskten / Vite ile yükleme
    - lib/libc16.c: string, ctype, stdlib (malloc, qsort, strtol, rand), printf ailesi
    - rt.s: __udiv32 hızlı yolundaki bölen hatası düzeltildi
    - programs/c: hello, fib, primes, sort, structs, long, strings, switch, multi/
    - tests: operatörlerin JS referansıyla uç değer testleri ve dil/kütüphane testleri
2026-10-11 CPU16 Faz 9 (1): saat/reset kartı, Flash programlayıcı ve ROM imajları
    - Saat ve reset kartı (9 entegre): kristal / yavaş RC osilatör seçimi, 8 durumlu Johnson sayacıyla
    parazitsiz CLK ve WR_WIN, açılış reseti, tek döngü ADIM butonu (eşzamanlı), saat sürücüsü.
    Kapı seviyesi bilgisayar artık yalnızca osilatörü sürer; bütün testler kartla birlikte geçer
    - Flash programlayıcı: Arduino Nano yazılımı (Intel HEX, SST komut dizileri, DQ7 sorgulama,
    READ/SUM), yaz.py (pyserial), KiCad şeması ve BOM. Uçtan uca test: yazılımın kendisi derlenip
    kartın kapı seviyesi modeline (2 × 74HC595 + SST39SF010A) bağlanır
    - cpu16/roms: mikrokod (4) ve ALU (3) F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
    [bom.csv, clk.kicad_sch, cpu.kicad_sch, mem.kicad_sch, prog.kicad_sch]
2026-10-11 Arka panel: Faz 6 anakart kartları için pin ataması (~WAIT, ~IO, TCLK, OSC, PA14..19, VSYNC_REQ)
2026-10-11 Faz 8: cc CLI komutu, bileşik sabitler, iç içe göstergeler, önişlemci/bağlayıcı testleri
    - tools/cc.ts + cli.ts: npm run cpu16 -- cc dosya.c ... [-o .hex|.bin|.s] [--run] [-I] [-D] [-O0] [--map]
    - (tip){...} bileşik sabitler, .a.b / [i].x göstergeleri, __func__, register/auto
    - sözcük hataları atlanan #if bloklarında hata vermez
    - gözetleme deliği: blok içinde gereksiz LI/LW/LBU yüklemeleri silinir
    - assembly yerel etiketleri RAM'de de kullanılabilir (harfle başlayan ad)
2026-10-11 Kart başına kararlı referans numaraları; yapıştırıcı kapı ve pasiflerde blok bilgisi
    Her kart kendi KiCad projesi olduğu için numaralar kart içinde verilir (cpu U1.., clk U201..,
    mem U301..). Deney rehberi bir bloğun hangi kapı birimlerini kullandığını bilsin diye yapıştırıcı
    lojik çiplerine birim → blok eşlemesi eklendi.
    [bom.csv, clk.kicad_sch, cpu.kicad_sch, mem.kicad_sch]
2026-10-11 Faz 10 (1): deney rehberi üreticisi ve ilk 7 deneyin rehberleri
    Bağlantı listeleri, malzeme ve sınır netleri kart tanımlarından üretilir (npm run cpu16 -- kit).
    CPU kartında TA/TB ile MAR/IR ayrı bloklara ayrıldı; veriyolu çekme dirençleri register
    bloğunda, durum LED'leri kontrol bloğunda (elektriksel değişiklik yok).
2026-10-11 Faz 8 sonu: cc --hedef bios, BIOS üzerinde C, yılan oyunu
    - cc16'ya BIOS hedefi: kod 0x4000'dan RAM'e, veri 0xA000'dan; crt0 BIOS
    yığınını saklayıp main'den monitöre döner, putchar/exit BIOS API'sine gider
    - bios.h: BIOS çağrıları, renkler, video portlarıyla doğrudan ekran erişimi
    - bios/ornekler/selam.c ve yilan.c (VGA ekranda klavyeyle yılan oyunu)
    - cc --hedef bios --run: anakart modelinde BIOS açılır, program G 4000 ile çalışır
    - Web IDE (Anakart + BIOS): C örnekleri tarayıcıda derlenip UART'tan yüklenir
    - cc-bios testleri: UART önyükleyicisiyle yükleme, yılanın duvara çarpması,
    otomatik pilotla yem yeme ve skor
2026-10-11 Faz 9: şemadan statik zamanlama analizi; C/V bayrak saati düzeltmesi
    - board/zamanlama.ts: saat ağacı, flip-flop'tan flip-flop'a en uzun yollar, yarım/tam periyot,
    kapılı saat kurulum ve tutma kontrolleri; 74HC veri sayfası gecikmeleri (tip / maks) ve yük
    düzeltmesi. npm run cpu16 -- zamanlama [--tip]
    - Sonuç: en kötü durumda CPU 1,16 MHz, tipik 2,1 MHz; kritik yol kontrol register'ı → ALU ROM'u
    → 4 × 74HC283 → veriyolu (yarım periyot)
    - Analizin bulduğu risk: C/V bayraklarının saat izni ALU ROM'unun SETSCV çıkışından geliyordu;
    ROM adresindeki CFLAG tam o kenarda değiştiği için ROM çıkışındaki bir sıçrama ikinci saat
    darbesi üretebilirdi.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
    [bom.csv, clk.kicad_sch, cpu.kicad_sch]
2026-10-11 Faz 9: kart testi; gerçek kart UART üzerinden simülatörle karşılaştırılır
    - bios/testler: 4 test programı (CPU/ALU ve C çalışma zamanı, 464 KB bellek + bank + bayt
    hatları, önbellek etiketi/gözetleme/sayaçlar, zamanlayıcı kesmesi + VRAM). Çıktıları zamandan
    bağımsız; ALU sağlama toplamları ayrıca bilgisayarda hesaplanıp testte sabitlendi
    - bios/kart-testi.ts: programları önce simülatörde çalıştırıp beklenen çıktıyı alır, sonra aynı
    yoldan (monitör, Intel HEX, G) karta yükler ve ilk farklı satırı gösterir
    - npm run cpu16 -- kart-testi --port /dev/ttyUSB0 (Linux/macOS, stty + tty akışları); pty
    üzerinden gerçek zamanlı makineye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
2026-10-11 Anakart G/Ç kartı (gc): UART, PS/2, zamanlayıcı, kesme denetleyicisi kapı seviyesinde
    - cpu16/board/io-card.ts: buildIoCard(b), FF00–FF0A; zamanlama TCLK'den (Machine ile aynı:
    TX 347 döngü = 7 × 35 + 3 × 34, 1 kHz tık = TCLK / 4000)
    - Yeni parçalar (chips/parts/gc-ek.ts): 74HC05, 74HC166, 74HC193, 74HC393
    - Yeni pasifler: 25,175 MHz osilatör, VGA DAC dirençleri, VGA / PS/2 / CH340 konnektörleri
    - tests/anakart-gc.test.ts: tezgâh, UART/PS/2 dalga biçimleri, Machine ile adım adım
    zamanlayıcı/IRQ, BIOS izinin tekrarı, KiCad netlist karşılaştırması
2026-10-11 Faz 9: üretim ve devreye alma belgesi; Web IDE'de kartın UART hızı
    - docs/uretim.md: zamanlama analizinin sonucu (ilk hedef 1 MHz) ve gerekçesi, analizin bulduğu
    sorun, kapılı saat kuralları, 4 MHz'e giden yol; UART/zamanlayıcının CPU saatine bağlılığı
    (1 MHz'de 28 800 baud); programlanacak çipler; besleme hesabı; kurulum sırası ve her adımın
    testi; kart testi ve arıza bulma; PCB notları
    - Web IDE: Web Serial bağlantıları için baud seçimi (115 200 / 57 600 / 28 800)
2026-10-11 Faz 10: Deney 12 (BIOS, önyükleyici, kart testi) ve Deney 13 (C, yılan) rehberleri
    - Deney 12: BIOS'u Flash'a yazma, USB-UART bağlantısı (1 MHz'de 28 800 baud), monitör komutları,
    Web Serial ile yükleme ve kart testi 4/4 ölçütü
    - Deney 13: cc16 ile BIOS hedefi, yilan.c ve selam.c, simülatörde ve kartta oynama
    - charrom -o x.hex: karakter ROM'u programlayıcı için Intel HEX olarak da üretilir
2026-10-11 Kütüphane: 74HC273 ve 74HC590 (anakart bellek ve önbellek kartları)
    74HC273: 8 bit D flip-flop register, ortak asenkron reset (bank register'ları).
    74HC590: 8 bit sayıcı + çıkış register'ı, üç durumlu çıkış, ~RCO (önbellek sayaçları).
    Kapı modeli, veri sayfası referans modeli ve transistör açılımı aynı testlerden geçer;
    cpu16/chips/parts/bellek-ek.ts, kütüphaneye ayrı bir push ile eklenir. KiCad sembol
    kütüphanesi yeniden üretildi (31 sembol).
2026-10-11 Anakart: bekleme durumlu saat kartı, bellek ve önbellek kartları (kapı seviyesi)
    Saat kartı: ~WAIT (10 kΩ ile 1'e çekili) s7'nin ortasında W flip-flop'una örneklenir;
    W = 1 iken CLK ve WR_WIN kapalı kalır, her bekleme tam bir CPU saati (8 OSC) sürer.
    TCLK (uzatılmayan OSC/8, Johnson Q1) ve tamponlu OSC arka panele çıkar. ADIM kipinde
    bir basış bekleme turları dahil tam bir döngü. 9 → 10 entegre.
    Bellek kartı (bellek, 31 entegre): ~IO çözümü, 4 × 74HC273 bank register'ı (reset
    0/32/33/34, geri okuma), PA14..PA19, Flash SST39SF010A + RAM AS6C4008 8 bit, TCLK ile
    yürüyen bayt sıralayıcı, boş bölge 0xFF, DE/DO çekme dirençleri.
    Önbellek kartı (onbellek,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
    [bellek.kicad_sch, bom.csv, clk.kicad_sch, cpu.kicad_sch, mem.kicad_sch, onbellek.kicad_sch]
2026-10-11 G/Ç kartı zamanlaması: sıçramasız yeniden yükleme darbesi; analizde yanlış yollar
    Zamanlama analizi G/Ç kartında iki şey buldu:
    - Zamanlayıcının yeniden yükleme darbesi AND(GC_TRL, TCLK) idi. GC_TRL bir sonraki
    yükselen kenarda düşmeden önce TCLK yükseldiği için ~PL'de kısa bir sıçrama
    oluyordu; tıktan hemen sonraki döngüde RELOAD'a yazılırsa sayaç yeni değeri
    erken alabilirdi. Darbe artık TRL ∧ ¬TRL2 (TRL2: aynı bilginin TCLK düşen
    kenarındaki kopyası, yeni 74HC74): girişler hiç aynı anda değişmez, darbe yine
    tık kenarını izleyen yarım döngüdedir. Kapı seviyesi kilit adım testleri geçiyor.
    - Okuma sürücülerinin veriyoluna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
2026-10-11 Belgeler: anakart kartları (saat, bellek, önbellek) kapı seviyesinde
    Yeni cpu16/docs/anakart-kartlari.md: kart ve blok → çip eşlemesi, çip sayıları (saat 10,
    bellek 31, önbellek 37), Faz 6 arka panel pinlerini kimin sürdüğü, bekleme durumlu bir
    erişimin zamanlama çizimi, doğrulama zinciri, Machine ile bilinen farklar ve gerçek kartta
    zamanlama payı. kartlar.md (arka panel tablosu, KiCad/BOM çıktıları), anakart.md (kesin
    çip sayıları ve bağlantılar), parcalar.md (74HC273, 74HC590) güncellendi.
2026-10-11 Faz 10: Deney 10 rehberi ve G/Ç deneme programı; machine --rom
    - kit/programlar/gc-deneme.s: BIOS'suz, Flash'tan çalışan G/Ç kartı denemesi (UART
    başlığı, zamanlayıcı kesmesiyle saniyede bir nokta, UART yankısı, klavye tarama kodu).
    - deney-10-gc.md: elle yazılan bölümler (ne öğreneceksin, nasıl çalışır, kurulum,
    beklenen sonuç, sorun giderme).
    - npm run cpu16 -- machine dosya.s --rom: programı Flash bank 0'a yazılmış gibi
    çalıştırır (BIOS'tan önceki deneyler için).
    - kit.test.ts: deney programları simülatörde rehberdeki sonucu verir.
    - G/Ç kartı: CH340 yuvasının VCC pini boş; USB'nin 5 V'u kartın 5 V'una bağlanmaz.
2026-10-11 Anakart video kartı: 80 × 30 metin, VGA 640 × 480, ön okumalı VDATA, kapı seviyesinde
    - cpu16/board/video-card.ts: buildVideoCard(b), FF20–FF26; kendi piksel osilatörü (VID_OSC),
    800 × 525 sayaçlar, iki 62256 VRAM şeridi, SST39SF010A karakter ROM'u, 74HC166 piksel
    kaydırıcı, imleç (tarama satırı 14–15, 16 karede bir yanıp söner), IRGB → direnç DAC → VGA
    - VRAM erişimi karakter başına iki yuva (tarama / CPU): CPU yazması taramayı bozmaz,
    VDATA okuması ön okuma latch'inden aynı veriyolu döngüsünde
    - Testler: Machine ile döngü döngüsüne port erişimleri ve VSTAT / VSYNC_REQ, bir karenin
    IRGB'si font/renk referansıyla, HSYNC/VSYNC zamanlaması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
2026-10-11 Belgeler: anakart G/Ç ve video kartları (blok → çip, zamanlama, doğrulama, farklar)
    - cpu16/docs/anakart-gc-video.md: kart başına blok → çip eşlemesi ve sayıları (G/Ç 64,
    video 69 entegre), TCLK / piksel saati zamanlaması, Machine ile doğrulama zinciri,
    Machine ve anakart.md'den farklar (Machine sabitleri değişmedi)
    - parcalar.md: 74HC05, 74HC166, 74HC193, 74HC393
2026-10-11 Anakart: G/Ç kartı takılıyken BIOS kapı seviyesinde monitör istemine kadar açılıyor
    Bellek kartlarıyla birleştirince G/Ç kartında iki reset sorunu çıktı: saat kartı TCLK'yi
    reset boyunca durdurur (Johnson sayacı s0'da), oysa G/Ç kartı reset sırasında TCLK
    kenarı bekliyordu.
    - RX eşzamanlayıcı flip-flop'ları resette 1'e (boşta) kurulur; yoksa açılışta rastgele
    bir başlangıç biti sahte bir bayt alabilirdi.
    - Ön bölücü 96'yı resetten sonraki ilk TCLK kenarında yükler (GC_RSTD, TRL2'nin boş
    yarısı); tıklar Machine'deki gibi 4000k kenarlarında kalır.
    - UART_RXD'de 10 kΩ çekme direnci: modül takılı değilken alıcı boşta.
    GateMachine vide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
2026-10-11 Zamanlama: bütün anakartın analizi; 74AC ailesi seçeneği
    - npm run cpu16 -- zamanlama --anakart: altı kart, beş saat alanı (CLK, OSC, TCLK,
    PS/2, piksel saati). Mantıksal olarak duyarsız yollar nedenleriyle analiz dışı:
    çevre kartlarına veriyolundan giren yollar (veri yalnızca yazma darbesinde alınır).
    - b.place(..., { aile: "AC" }): aynı bacak düzenli 74AC çipi. Simülasyon aynı; şema ve
    BOM'da değer 74ACxxx, zamanlama analizi kötümser AC gecikmeleriyle (HC × 0,7 / 0,5).
2026-10-11 Anakart zamanlama testi; önbellek kartında adlandırılmış ara netler
    Bütün anakartın zamanlaması testte: 1 MHz CPU en kötü durumda sığar, tutma payları
    ≥ 5 ns, kapı açıkken değişebilen izinler yalnızca tasarımı gereği güvenli olanlar
    (~WSEL, C_MEMACC; önbellek yazma evresindeki C_CB, C_INVL, C_RAMHIT). Bu izinlerin
    netleri önbellek kartında adlandırıldı (C_MEMACC, C_TCB, C_INVWR, C_RAMHIT) ki rapor
    ve test kararlı olsun.
    [onbellek.kicad_sch]
2026-10-11 Deney seti: 8, 9 ve 11 anakart kartlarında; deneme programları ve rehberler
    - Deneyler artık bütün anakarttan üretiliyor (bilgisayar + anakart + programlayıcı); CPU ve saat
    kartının elemanları bilgisayardaki deney numarasını alıyor.
    - bellek-deneme.s: 512 KB RAM'i iki desenle sınar, FF00 LED'lerinde bank sayar, 0xA5 ve kayan ışık.
    - onbellek-deneme.s: önbellek açık/kapalı turlarla kayan ışık (≈ 1,4 kat hız farkı).
    - video-deneme.s: "Merhaba, CPU16!", 16 renk çubuğu, VSYNC kare sayacı.
    - machine --rom --led: FF00'a yazılanları 8 LED satırı olarak 1 MHz zamanıyla gösterir.
    - Deney 8, 9, 11 rehber metinleri; Deney 12 UART bağlantısı Deney 10 ile aynı;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
2026-10-11 Belgeler: yol haritasında fazların sonuçları, README, anakart ve üretim güncellemesi
    - roadmap.md: "Şu an" satırı, Faz 3–10 sonuçları, gerçek depo düzeni.
    - README.md: bütün belgelerin ve komutların listesi.
    - spec.md / anakart.md: ilk kart 1 MHz; UART ve zamanlayıcı TCLK'den, kesin çip sayıları.
    - kartlar.md: bütün anakart (358 entegre), KiCad klasörleri.
    - uretim.md: bütün anakartın zamanlama sonuçları ve analiz dışı bırakılan yollar.
2026-10-11 Video kartı zamanlaması: sayaçlar karakter saatinde; piksel saatinde yalnız 74AC161, 74AC74 ve kaydırıcı
    Statik zamanlama analizi piksel saatinde (VID_OSC, hedef 39,7 ns) en kötü 127 ns (7,87 MHz),
    tipik 89 ns (11,24 MHz) buluyordu: yatay sayaç → satır sonu çözümü → dikey sayacın ~PE'si.
    - Piksel fazı ayrı bir 74AC161: 9..15, 0 diye sayar; Q3 hem kendi ~PE'sine hem 74HC166'nın
    ~PE'sine doğrudan gider (çözücü kapı yok).
    - 74AC74: H2 = Q2'nin bir piksel gecikmişi (parazitsiz karakter saati), LD7 = TC'nin.
    - Karakter sayacı (0..99), dikey sayaç, MA, satır başı ve CPU istekleri H2'de (p4), VBQ ve
    eşzamanlayıcılar H2'nin düşen kenarında (p0); satır s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
    [bom.csv, video.kicad_sch]
2026-10-11 Zamanlama: karakter saati de anakart kökü; video belgeleri ve Deney 11 güncel
    - ANAKART_SAATLERI'ne V_H2 (piksel / 8): zamanlama --anakart karakter saatini de raporlar.
    - zamanlama.test.ts: piksel saati iki köşede de ≥ 25,175 MHz, karakter saati ≥ 3,15 MHz;
    karakter saatinde açıkken değişen izin yalnızca V_OPW.
    - uretim.md: video satırları; Deney 11: iki saat alanı ve 74AC parçalar, 74HC166.
    - KiCad ve rehberler yeniden üretildi.
2026-10-11 Web IDE: C ile program yazma her örnekte çalışır
    Editörün dili artık seçilen örneğin adına bağlı değil: Assembly / C seçici var, yazdıkça içerikten
    tahmin edilir, elle seçilen dil korunur. Yeni "yeni.c" şablonu (BIOS hedefi) ve düz bellek kipinde
    C (ROM hedefi, merhaba.c). Örneklerde yapılan değişiklikler tarayıcıda saklanır, "örneğe dön" ile
    geri alınır. Testler: bütün örnek/deney programlarının dili doğru tanınıyor, yeni.c BIOS'ta,
    merhaba.c düz bellekte çalışıyor.
2026-10-11 Kart yerleşimi: bütün bilgisayar, pasifler, kart sıraları ve arka panel
    boardLayout artık board.chips ve board.passives içinde ne varsa yerleştirir:
    - pasifler KiCad ayak izine göre biçimlenir (direnç, kondansatör, LED,
    konnektör, osilatör…) ve pinleriyle tellere katılır;
    - dekuplaj kondansatörleri kendi çiplerinin yanına gelir;
    - kenar konnektörü kartın alt kenarına gelir (edge işaretiyle);
    - kalan pasifler bloklarının altında bir şeritte durur.
    Kartlar içeriklerine göre boyutlanır ve sıralara bölünür; her sıranın
    altında bir arka panel şeridi vardır. Yüzlerce çipli bloklar kareye yakın
    bir ızgaraya dizilir. Kart başlıkları CARD_TITLES iç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
2026-10-11 CPU16 kartı 3D: bütün bilgisayar tek sahnede, teller, VGA, bellek içi, düzenleyici
    Görünüm artık bütün bilgisayarı gösterir: CPU, saat, bellek, önbellek,
    G/Ç ve video kartları. Toplam 358 entegre, 407 pasif. Hepsi kapı
    seviyesinde worker'daki GateMachine'de çalışır, takılı kartlar
    FULL_MACHINE_CARDS'tan gelir.
    - Pinden pine teller: "yok / seçili çip / hepsi" kipleri ve GND/VCC
    seçeneği. Teller canlı renktedir, tek çizim çağrısıyla çizilir ve
    yalnızca net değerleri değişince yeniden renklenir. "hepsi" kipinde
    kartlar arası teller konnektörden konnektöre, arka panel şeridi
    boyunca gider.
    - Bağlantılar paneli: pin no + ad → net → öbür u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
2026-10-11 3D görünüm: testler ve belgeler
    view.test.ts bütün bilgisayarın yerleşimini sınar: çipler ve pasifler
    kartlarının içinde, çakışma yok, pinler doğru netlerde. Konnektör,
    dekuplaj ve çok çipli kart düzenine de bakar. Ayrıca şunları sınar:
    - teller: MST, kartlar arası konnektörden konnektöre, tel geometrisi,
    arka panel yolları, Bağlantılar;
    - ekran: VRAM → metin ve pikseller, imleç, kapı seviyesi kartta ekran
    kaynağı, VGA konnektörü ve DAC;
    - PS/2 ve UART çerçeveleri;
    - program: dil tanıma, Flash imajının romImage() ile bayt bayt aynılığı,
    C örneğinin derlenip emülatörde çalışması, satır numaralı hatalar;
    - bellek düzeni: 62256, 28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
2026-10-11 Kontrol birimi: mikrokod ve ALU ROM'ları yerine 74HC kapı devresi
    CPU kartındaki 7 SST39SF010A (4 mikrokod, 3 ALU kod çözme ROM'u) kalktı. Yerine
    board/kontrol.ts, cpu16.ucode'dan (tek kaynak) ve aluControl tablosundan çok seviyeli
    bir 74HC devresi üretir ve Board API ile gerçek çipler olarak yerleştirir:
    - Mikrokod: adım ve komut çözücüleri (74HC138; INT = 1 iken komutlar pasif, f3'e göre
    dallanan komutlara alt çözücü), aynı mikro programı çalıştıran (op, f3, COND)
    atomları, ortak alt kümeli VEYA ağı, sık kullanılan bitler için adım seçici
    (74HC151), adım 8..15 için SWI hattıyla açılan çözücü.
    - ALU kod çözme: işlem çözücüleri (3 ×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
    [bellek.kicad_sch, bom.csv, clk.kicad_sch, cpu.kicad_sch, gc.kicad_sch, onbellek.kicad_sch, video.kicad_sch]
2026-10-11 Belgeler ve deney rehberleri: kapı seviyesinde kontrol birimi
    - mikromimari.md: yeni "Kapı seviyesinde kontrol birimi" bölümü (atomlar, katmanlar,
    sayılar, referanslar, zamanlama, denklik kanıtı); ROM adresi artık tablo adresi.
    - kartlar.md: CPU kartı 194 entegre, kontrol birimi ve ALU kod çözücü blokları;
    anakart 406 entegre. parcalar.md: 74HC11, 20, 21, 27, 30.
    - uretim.md: zamanlama tablosu ve yeni kritik yol (824 ns / 369 ns), programlanacak
    çipler yalnızca BIOS Flash'ı ve karakter ROM'u, besleme hesabı.
    - roadmap.md, README: roms/ kalktı, "kontrol" komutu.
    - Deney 3: programlayıcı artık karakter ROM'u ve BIOS için; Deney 5: ALU kod çözücü
    (beklenen AD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
    [bellek.kicad_sch, prog.kicad_sch, video.kicad_sch]
2026-10-11 Anakart yalnız yaygın parçalarla: 28C256 + 4 × 62256, kendin yap bellek kartı
    AFU kararı: bilgisayar yalnız yaygın 7400 serisi lojikle ve iki bellek
    çipiyle (62256, 28C256) kurulur.
    Bellek kartı (31 → 34 entegre):
    - SST39SF010A yerine 28C256 (32 KB, fiziksel 0x00000–0x07FFF, bank 0–1)
    - AS6C4008 yerine 4 × 62256 (128 KB, 0x80000–0x9FFFF, bank 32–39)
    - çip seçimi tek 74HC138; geri kalan bölgeler boş (0xFF, yazma yok sayılır)
    Nadir parçalar çıktı:
    - önbellek sayaçları 74HC590 → 74HC161 × 8 + 74HC541 × 4 (37 → 46)
    - zamanlayıcı 74HC193 → 74HC161 (tümleyeni yukarı sayar)
    - kesme öncelik kodlayıcısı 74HC148 → kapılar
    - video adres sayacı (VA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
    [bellek.kicad_sch, bom.csv, cpu.kicad_sch, gc.kicad_sch, kyb.kicad_sch, mem.kicad_sch, onbellek.kicad_sch, video.kicad_sch]
2026-10-11 Programlayıcı 28C256 için: korumalı sayfa yazma, DATA yoklaması, SDP
    - Arduino taslağı: Intel HEX kaydı sayfa parçalarına bölünür, her parça
    bir korumalı sayfa yazmasıdır (AA 55 A0 + baytlar, tBLC içinde), sonra
    D7 yoklamasıyla beklenir; zaten aynı olan parçalar atlanır. SDP sorgu,
    aç ve kapat komutları; 28C256 dışındaki adresler reddedilir.
    - yaz.py: --koruma, --koruma-ac, --koruma-kapat; --sil ve --id artık
    gerekmez (uyarı verir).
    - Kart: 2 × 74HC595 + ZIF-28; KiCad şeması yeniden üretildi.
    - Test: taslak gerçek kapı seviyesi kartla ve 28C256 modeliyle çalışır;
    pin işlemleri ve gecikmeler zaman olarak sayılır (sayfa penceresi,
    yazma dö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
    [bom.csv, prog.kicad_sch]
2026-10-11 Kurulum belgeleri: blok blok numaralı tel listesi, çip kartları, el kitabı
    Kartları fiziksel olarak kurarken hangi bacağın nereye gideceği için kart
    başına yazdırılabilir kurulum belgesi (A4, HTML + PDF), yanında KiCad
    şemasının PDF'i ve genel bir kurulum el kitabı. Hepsi kart tanımlarından
    üretilir: npm run cpu16 -- kurulum [kart|hepsi] [-o dizin] [--html].
    - kurulum/plan.ts: kurulumPlani(board, kart) — çiplerin yeri ve yönü
    (çentik solda, 1. pin sol altta), besleme pinleri, sabit girişler ve
    dekuplaj; her sinyal netinin uçları blok blok büyüyen bir ağaçla
    (en yakın komşu zinciri + 2-opt) bağlanır, teller T0001… diye blok,
    renk ve net sıras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
2026-10-11 Kart 3D: gerçekçi pasifler, pasif bilgi paneli ve LED/direnç rehberi
    3D (Passives3D.tsx, passiveGeometry.ts):
    - Eksenel dirençler değerden hesaplanan IEC renk bantlarıyla (%5 bej, 4 bant;
    %1 metal film mavi, 5 bant), bükülü bacaklar.
    - SIP-9 dizilerde 1. bacak noktası ve "A103J" yazısı.
    - LED'ler: kubbeli mercek, katot tarafı düz flanş, uzun anot bacağı, içte örs,
    yonga ve bağlantı teli. Renk görevden (passives.ts, LED_RENK_KURALLARI): FAULT
    kırmızı, HALTED turuncu, CLK mavi, besleme yeşil, veri/adres sarı.
    Canlı sinyalle yanar: ışıma, hale ve karttaki ışık lekesi.
    - Kondansatörler: "104" yazılı disk seramikler; şeritli, değer yazılı
    elektro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
2026-10-11 Hesap makinesi: çok sayfalı KiCad şeması, komut satırı aracı ve testler
    - kicad-sch: hiyerarşik şema (kök sayfa + blok sayfaları, global etiketler);
    tek sayfalı kart şemalarının çıktısı aynı kaldı
    - cpu16/kicad/hesap: 10 alt sayfa, proje, BOM
    - npm run hesap8 -- ozet | hesapla | dogrula [--hepsi]; bütün 262 144
    durum altın modelle aynı
    - hesap8/tests: 74HC4511 doğruluk tablosu, yapı, ERC, uç durumlar,
    lamba testi, sıfır söndürme, HATA, KiCad netlist'i
    [bom.csv, hesap-anahtarlar.kicad_sch, hesap-bolme.kicad_sch, hesap-carpma.kicad_sch, hesap-gosterge-ab.kicad_sch, hesap-gosterge-sonuc.kicad_sch, hesap-onluk-ab.kicad_sch, hesap-onluk-kalan.kicad_sch]
2026-10-11 Hesap makinesi: 5 V besleme girişi, en uzun yol analizi, kurulum belgesi metinleri
    - CONN_5V parçası; hesap kartı 2 pinli girişten beslenir
    - zamanlama: 74HC4511 modeli ve saatsiz devre için en uzun yol
    (anahtar → segment: tipik 887 ns, en kötü 2,05 µs)
    - kurulum: "hepsi" yalnız bilgisayarın kartları; hesap kendi adıyla,
    çok sayfalı şema, DIP-16 direnç dizisi ve gösterge notları
    - kurulum testleri çok sayfalı şemayı ve bağımsız kartları tanır
    [bom.csv, hesap-anahtarlar.kicad_sch, hesap-gosterge-ab.kicad_sch, hesap-gosterge-sonuc.kicad_sch]
2026-10-11 Hesap makinesi: tasarım ve kurulum rehberi, kurulum belgesinde rehber bağlantısı
    - hesap8/docs/tasarim.md: bloklar, hız, besleme, malzeme
    - hesap8/docs/kurulum-rehberi.md: breadboard aşamaları ve test tabloları
    (değerler kapı seviyesi simülasyondan), PCB yolu, sorun giderme
    - kurulum belgesi: hesap için deney yerine rehber; 7 segment akımı
    besleme bütçesinde
    - parcalar.md: 74HC4511 (38 çip); README: cpu16 ve hesap8 bağlantıları
2026-10-11 "8 bit hesap 3D" bölümü: hesap makinesi kartı 3D'de, kapı seviyesinde
    CPU16 kartı 3D'nin görünümü iki kart türüyle çalışır: sahnedeki kart
    (aktif.ts) bölüm açılınca, ilk çizimden önce seçilir; store.ts'teki
    boardModel, boardLayoutData, netEnds, findPart ve liveNets onu okur.
    Her türün yapısı bir kez kurulup saklanır, bilgisayarın worker
    değerleri hesap makinesi sahnedeyken saklanır, geri dönünce çizilir.
    - Bölüm geçişi: #hesap, "8 bit hesap 3D"; bilgisayar bölümü aynen kalır
    (çalıştırma, program, VGA, UART, window.kart, worker).
    - "Hesap" yan sekmesi: 15 hanenin göstergeleri devrenin netlerinden,
    altın modelle karşılaştırma, A ve B'ni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
2026-10-11 Hesap makinesi: eksi işareti sonucun solunda, lamba testinde de yanar; HATA LED'i göstergelerin yanında
    - işaret hanesi (DS7) sonucun hanelerinden önce yerleşir: 3D kartta ve
    şemada en solda
    - ISARET_g = NEG + lamba testi (boş kapı birimleriyle, çip sayısı aynı)
    - HATA LED'i Bölme bloğundan "Gösterge: Sonuç" bloğuna
    - rehber ve tasarım belgesi güncellendi
    [hesap-bolme.kicad_sch, hesap-gosterge-ab.kicad_sch, hesap-gosterge-sonuc.kicad_sch, hesap-onluk-ab.kicad_sch, hesap-onluk-kalan.kicad_sch, hesap-onluk-sonuc.kicad_sch]
2026-10-12 Docker: çok aşamalı imaj, nginx ayarı, docker compose (web, dev, cli) ve CI'da imaj denetimi
    - Dockerfile: deps (npm ci, önbellek dostu katman sırası) → build (npm run build, .gz kopyaları)
    → web (root olmayan nginx, 8080, HEALTHCHECK); ayrıca dev (Vite) ve test (npm test) hedefleri.
    TLS denetleyen ağlar için isteğe bağlı npm_ca gizlisi (imaja girmez).
    - docker/nginx/default.conf: gzip ve gzip_static, adında özet olan varlıklara bir yıllık
    immutable önbellek, index.html ve sabit adlı dosyalara no-cache, .js/.mjs için JavaScript
    MIME türü ve utf-8, /healthz.
    - docker-compose.yml: web (8080), dev (Vite + HMR, 5173, kaynak bağlı, node_modules isimli
    birim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
2026-10-12 cc16: sabit soldayken de çarpma kaydır-topla; bios.h'ye bios_getline ve bios_setirqhook
    - `2 * x` gibi sabiti solda olan 16 bitlik çarpma artık `x * 2` gibi kaydırma ve
    toplamaya çevriliyor (önceden __mul16 çağrısıydı). 32 bitte sabit, __mul32'nin
    döngü sayısını belirleyen çarpan (sağ işlenen) yapılıyor.
    - BIOS hedefi: BIOS GETLINE (yankılı satır okuma) ve SETIRQHOOK (UART RX / vsync
    kesmesine C fonksiyonu bağlama) için sarmalayıcılar ve bildirimler.
    - Test: sabit hangi tarafta olursa olsun __mul16 çağrılmıyor, 32 bitte sabit
    çarpan oluyor; sonuç iyileştirmeli ve iyileştirmesiz aynı.
2026-10-12 CLI: BIOS hedefinde --run'a stdin girdisi, machine komutuna C dosyası
    - `cc --hedef bios --run`: stdin bir boru ya da dosyaysa içeriği programa UART'tan
    klavye girdisi olarak gider (`printf '2+3*4\n\n' | ... --run`). UART çıktısındaki
    CP857 baytları (çerçeve karakterleri, Türkçe harfler) Unicode'a çevrilir. Bitiş,
    çıktının "> " ile bitmesine ek olarak SP'nin BIOS yığınına dönmesiyle anlaşılır
    (programın kendi yazdığı "> " erken bitirmesin).
    - `machine dosya.c`: C dosyasını cc16 ile BIOS hedefine derleyip önyükleyiciyle
    yükler ve çalıştırır (Web IDE'deki "Derle ve RAM'e yükle" gibi).
    - `--max` BIOS hedefinde döngü sayısıdır; yardım metn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
2026-10-12 Arayüz ve yükleme: bölümler ayrı parçalarda, başlangıç paneli, simgeler, yükleme durumları
    Yükleme
    - Her bölüm (6502 die, CPU16 tezgâhı, kart/hesap 3D) React.lazy ile kendi parçasında; three,
    react-three-fiber ve postprocessing ayrı vendor parçaları (vite.config.ts). İlk açılışta inen JS
    1,84 MB'tan 179 kB'a (sıkıştırılmış 550 kB'tan 59 kB'a) indi. #cpu16 three'yi, #hesap ve #kart
    6502'nin 1,6 MB'lık çip verisini artık indirmez.
    - Bölüm kodu inerken bölümün iskeleti çizilir; yüklenemezse açıklama ve "Sayfayı yenile" düğmesi.
    Gezinme bağlantısının üzerine gelince bölümün kodu önceden çekilir (bolumler.ts).
    - 6502 die ilk açıl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
2026-10-12 Hesap makinesi breadboard'da: yerleşim, tel yönlendirme, birleşim-bul doğrulaması
    60 BB830 board (5 × 12): göstergeler arka kenarda, anahtarlar ön kenarda, board başına en çok 5
    çip; DIP'ler, DIP anahtarlar, direnç dizileri ve göstergeler orta kanalın üstünde, 100 nF'lar
    çiplerin yanında üst ray çiftinde. Netler 5 delikli şeritler ve boş deliklere takılan atlama
    telleriyle kurulur: düz, yatay/dikey, gövde ve tel ucu üstünden geçmeyen, renk kodlu, kesim boylu
    2.784 tel (246 ray köprüsü). Yerleşim ve teller veri.ts'te saklanır
    (npm run hesap8 -- breadboard --uret); bağlantı yalnız fiziksel modelden birleşim-bul ile kurulup
    netlistle karşılaştırılır (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
2026-10-12 8 bit hesap 3D: breadboard görünümü, atlama telleri ve breadboard kurulum modu
    Hesap makinesi bölümünde varsayılan görünüm breadboard: taban plakasında 60 board (delik deseni,
    ray çizgileri, numaralar ve harfler tek dokudan), parçalar deliklerine oturmuş, atlama telleri
    renkli yalıtım ve çıplak uçlarla; önce takılan tel altta, kesişmede üstteki tel kamburlaşır.
    Teller board sıralarına bölünmüş birleştirilmiş geometri; uzaktan yassı şeritler. Çip ya da net
    seçilince o netlerin telleri canlı seviyede parlar. Araç çubuğunda Breadboard / PCB seçimi.
    Kurulum sekmesi breadboard'da teli delikten deliğe gösterir (BB07 c14 → BB08 h3, 42 mm, sarı),
    3D'de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
2026-10-12 Hesap makinesi breadboard kurulum belgesi ve rehberi
    npm run hesap8 -- breadboard-belge: yazdırılabilir HTML ve A4 PDF (board
    haritası, board board yerleşim çizimleri, aşama aşama işaret kutulu tel
    listesi T0001–T2784, renk ve boya göre kesim listesi, malzeme). Kurulum
    rehberi iki yola ayrıldı (breadboard ve PCB); aşamalar breadboard planıyla
    aynı numaralı, test tabloları korundu. README breadboard komutlarıyla.
2026-10-12 Breadboard motorunu ortak modüle taşı (cpu16/board/breadboard)
    Hesap makinesinin breadboard motoru (geometri, tavlamalı yerleşim, A*
    yönlendirme, union-find doğrulama, plan kodlama, 3D yerleşim) netlist ve
    yerleşim tanımıyla parametrelenen ortak bir modüle taşındı; hesap8/breadboard
    artık bu motoru kendi bölgeleri, renk kodu ve aşamalarıyla çağırıyor.
    Doğrulama birden çok panoyu ve panolar arası şerit kabloları da birleştirebiliyor.
    Hesap makinesinin sonuçları değişmedi: yeniden üretilen veri saklanan
    veri.ts ile birebir aynı (parmak izi, çip yerleri, 2 784 tel), planın
    tam dökümü (yerleşim, teller, ölçüler, 3D yolları, doğrulama) ve kurulum
    bel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
2026-10-12 CPU16'nın breadboard panoları: yerleşim, teller, besleme, şerit kablo
    Her kart kendi taban plakasında BB830 board'lardan bir pano: bölgeler veri
    akışı sırasıyla, kartın kenar konnektörü yerine 2 × 32 uyarlayıcı (T-cobbler
    benzeri), panolar arası 64 damarlı şerit kablo ve IDC soketleri (arka panel
    yolu). Her board sütununa ayrı 5 V girişi ve 100 µF, her çipe 100 nF.
    - cpu16/breadboard/: pano tanımları ve kurulum aşamaları, yerleşim (tavlama),
    plan (üretme/kurma, makine yerleşimi, şerit kablo, doğrulama), renk kodu
    (PCB kurulum belgeleriyle aynı), saklanan veri (veri/*.ts)
    - npm run cpu16 -- breadboard [--uret]: ölçüler, kesim boyu dağılımı, besle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
2026-10-12 Arayüz: ferah, okunaklı ve konforlu yeni tasarım
    Bütün bölümler (6502 die, CPU16 tezgâhı, CPU16 kartı 3D, 8 bit hesap 3D),
    Başlangıç paneli ve yükleme / hata durumları yeni tasarım belirteçleriyle
    yeniden düzenlendi. Özellikler, adres yolları (#6502, #cpu16, #kart, #hesap),
    konsol API'leri ve kısayollar aynı.
    - Yazı: gövde 15 px, en küçük yazı 13 px, satır aralığı 1,55; etiketler
    cümle düzeninde. IBM Plex Sans yazı ve etiketlerde; Plex Mono yalnız kod,
    adres, onaltılık / ikili değer ve pin adlarında. Bütün ölçüler rem.
    - Aralık: 4 px tabanlı ölçek; panel içi 24 px, denetimler arası 12 px,
    bölümler arası 32 px. Kutu içinde kutu yer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
2026-10-12 CPU16 kartı 3D: PCB | Breadboard görünümü ve breadboard kurulum modu
    - Araç çubuğunda "Görünüm: PCB | Breadboard" (hesap makinesindeki düğme
    grubunun aynısı); PCB varsayılan ve değişmedi, seçim tarayıcıda saklanır
    - Breadboard: 7 pano kendi taban plakalarında, 129 board, atlama telleri,
    koridorda 64 damarlı şerit kablo ve IDC soketleri (damarlar canlı
    seviyede); çip seçimi, çipin içi, VGA ekranı ve program düzenleyicisi
    aynen çalışır
    - Teller pano başına board sıralarına bölünmüş birleştirilmiş ağlarda:
    uzaktan yassı şeritler, yakından borular (kameranın baktığı yerden
    başlayarak kare başına birkaç ms'de kurulur)
    - Breadbo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
2026-10-12 CPU16 breadboard kurulum belgeleri ve belgelendirme
    - npm run cpu16 -- breadboard-belge [kart|hepsi] [-o dizin] [--html]: kart
    başına yazdırılabilir kurulum belgesi (HTML + PDF) ve dizin. Kart belgesi:
    kapak, nasıl okunur, panonun haritası ve makinedeki yeri, besleme, aşamalar
    ve testler, board board yerleşim çizimleri, aşama aşama numaralı tel listesi
    (işaret kutulu, delikten deliğe, sırası önemli teller ↥), kesim listesi,
    malzeme. Dizin: bütün makine, şerit kablo (soketlerin yeri, damar → sinyal),
    besleme, bütün tellerin kesim listesi.
    - Board çizimi ortak motora taşındı (cpu16/board/breadboard/cizim.ts); hesap
    makinesinin belgesi aynı çizimi k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
2026-10-12 Bölüm açıklamaları: kartların bölge, blok ve çip grubu metinleri tek kaynakta
    CPU16'nın yedi kartı ve 8 bit hesap makinesi için her kartın, her breadboard
    bölgesinin, her bloğun ve her çip grubunun etiketi, başlığı, görevi ve
    "nasıl çalışır" metni (cpu16/board/bolum-metin.ts, hesap8/bolum-metin.ts).
    bolum-bilgi.ts kataloğu kurar (kart → bölge → blok → grup → parça),
    aşamaları ve deneyleri pano tanımlarından çıkarır, bölümün dış sinyallerini
    netlistten özetler. Testler: her blok ve bölge metinli, gruplar her mantık
    çipini ve 100 nF dışındaki her pasifi tam bir kez kapsar.
2026-10-12 Mimari diyagramları: CPU kartı, bütün bilgisayar ve hesap makinesi
    Kartların blok diyagramları (resimdeki AN16 şeması gibi): başlık çubuğu, birim kutuları (ad, parça
    numaraları ve adetleri, tek satır görev), kalın veri / adres yolları, kontrol hatları, oklar ve
    lejant. Yerleşim elle (ızgara, dik açılı yollar); içerik devreden:
    - cpu16/mimari/model.ts: tanım türleri ve devre çözümlemesi (blokların parçaları, netlerin uçları,
    yapıştırıcı kapılarının blokları)
    - cpu16/mimari/cizim.ts: tanım + devre → sahne (yazı yerleşimi, oklar, dallanma noktaları, lejant)
    - cpu16/mimari/agac.ts: sahne → SVG öğe ağacı (uygulama ve düz SVG aynı ağa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
2026-10-12 Karşıtlık denetimi mimari diyagramlarının renklerini de ölçer
    scripts/kontrast.mjs src/mimari/mimari.css'i de okur: yol renkleri kâğıtta ve
    kart çerçevesinde yazı olarak 4,5:1, kutu ve çerçeve çizgileri 3:1, kutu
    zeminlerinde gövde / ikincil / soluk yazı 4,5:1, başlık çubuğu yazısı.
2026-10-12 3B görünümde bölüm etiketleri: bölge çerçeveleri, plakalar, kenar etiketleri
    Genel bakışta her breadboard bölgesi ve PCB işlev bloğu renkli bir
    çerçeveyle sarılır, ortasına uzaktan okunan bir başlık plakası konur
    (kartın adı panonun dışında). Yaklaşınca plakalar söner; ayrıntılı
    kipte çip grupları panelin kenarında hizalı etiketlerle, çakışmadan
    ve çizgilerle işaretlenir. Plakaya ya da etikete tıklayınca bölüm
    seçilir, kamera ona gider, çipleri vurgulanır, ötekiler söner; Esc
    seçimi kaldırır. Bütün plakalar tek ağda, çerçeveler kalın çizgi
    olarak: genel bakışta bir çizim çağrısı fazlası.
2026-10-12 Kurulum belgelerinde bölümler: pano haritasında bölge çerçeveleri, Bölümler tablosu, board çizimlerinde çip grupları
    Breadboard kurulum belgelerinin (CPU16'nın yedi panosu ve hesap
    makinesi) haritasında her bölge 3D görünümdekiyle aynı renkte bir
    çerçeveyle sarılır, etiketi sol üst köşesinde bir sekmede; board'ların
    ikinci satırı üstündeki çip grupları. Haritanın altında "Bölümler":
    her bölgenin görevi ve nasıl çalıştığı, çip gruplarının görevi,
    parçaları ve board'ları. Board çizimlerinin üstünde o board'daki
    grupların sütunlarını kapsayan etiketler. Bölge geometrisi ve renkleri
    3D sahneyle ortak modülde (cpu16/board/bolum-cizim.ts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
2026-10-12 Bölüm paneli breadboard verisi gelmeden de açılır
    Mimari'den "3D'de göster" ile bilgisayarın breadboard görünümüne gelince
    bölüm, breadboard verisi (ayrı parça) yüklenmeden seçiliyordu: bölüm
    rengi ve parça listesi yerleşimden okunduğu için sayfa hata veriyordu.
    Bölüm rengi veri gelene dek vurgu mavisi, veri gelince çerçevenin rengi;
    parça adı ve görevi devreden okunuyor.
2026-10-12 CPU16 breadboard: CPU panosu modül modül, board'larda modül etiketleri
    CPU panosunda her board'un tek bir işi var (panolar.ts duzen): R0–R7 her biri kendi
    board'unda, sabit birimi, ALU dilimleri (mantık birimi, toplayıcı, sonuç seçici, bayraklar),
    kontrol birimi, ön kenarda PC, MAR, IR ve bellek arayüzü. Tavlama her çipi yalnız kendi
    modülünün board'larına koyar; tek işli board'da çipler referans sırasıyla.
    3D'de her board'un ortasında modülünün plakaları (yaklaşınca bölge plakalarının yerine);
    kurulum belgelerinin board çizimleri aynı sırayla etiketlenir. Belgeler ve testler yeni
    düzene göre (134 board; CPU panosunda uzun tel payı %10).
2026-10-12 Modül testleri: boş board'lar ve karışık modüller; bölge sayısı 45
    Hesap makinesinin panosundaki boş board'ların plakası yok; yan yana kuralı yalnız board'larını
    tek başına dolduran modüllere (bellek erişim kapıları uyarlayıcının iki yanında). CPU'ya sabit
    birimi bölgesi eklendiği için bölge sayısı 45.
2026-10-12 Breadboard dizini: yüzde ekinde dil düzeltmesi
    "%94,9'i" yerine "300 mm'den kısa olanlar %94,9": sayının okunuşuna göre değişen eki yazmamak için.
2026-10-12 Breadboard: modüller ayrı adalar (aralarında ≈ 20 mm boşluk), renkli modül tabanları
    Board'lar artık düzgün bir ızgarada değil: her board'un ızgaradaki başlangıcı (x0, y0) var ve
    farklı bölgelerin board'ları arasında 8 adımlık (≈ 20 mm) boşluk kalır (kafesKonumu). Ray
    köprüleri kaymış sütunlarda boşlukta bir dirsekle geçer. 3D'de her modülün board'larının altında
    bölgenin renginde bir taban, çerçeve çizgisi onun dış kenarında; uzaktan, seçim yokken teller
    soluk. Saat, bellek, önbellek, G/Ç, video, KYB panoları ve hesap makinesi yeniden üretildi.
    CPU panosu 8 modüle bölündü (register'lar ve göstergeleri, veriyolu kontrolü, sabit birimi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
2026-10-12 CPU kartı: hata ayıklama LED'leri ve çubuk göstergeler
    James Sharman'ın ve Ben Eater'ın breadboard bilgisayarlarındaki gibi, CPU
    kartında ne olduğunu gösteren LED'ler (şema = kod, çip eklenmedi):
    - 39 durum LED'i (D3–D41, her biri 1 kΩ ile, R3–R41): r0–r7 okuma/yazma
    (~ROE, ~WSEL), veriyolu sürücüsü (~SRC_REG/ALU/PC/MEM/IMM/FLAGS), MEMRD,
    MEMW, TA/TB/MAR/IR yükleme, PC yükleme ve artırma, N/Z/C/V/I bayrakları,
    STEP0–3. Aktif düşük sinyallerde LED VCC'den sinyale bağlı (çıkış 0 iken
    yanar); Board.led() aktifDusuk seçeneği aldı.
    - 10 çubuk gösterge (DS1–DS10, DISP_BAR_10, DIP-20) ve önlerinde 8×1 kΩ
    bağımsız direnç dizileri (RN3–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
    [bom.csv, clk.kicad_sch, cpu.kicad_sch, hesap-anahtarlar.kicad_sch, hesap-gosterge-sonuc.kicad_sch]
2026-10-12 CPU kartı: register içeriği çubuk göstergeleri (74HC541 tamponlarla)
    Sekiz register'ın değeri her an görünsün diye (James Sharman'ın
    bilgisayarındaki gibi) register'ların 74HC574'leri artık veriyolunu
    doğrudan sürmez:
    - 574'lerin ~OE'si GND'de, çıkışları R{r}Q0..15 hatlarında; veriyolunu
    register başına iki 74HC541 sürer (~OE1 = ~ROEr, ~OE2 = GND).
    - Her register'ın içeriği iki çubuk göstergede (DS11–DS26, önlerinde
    RN13–RN28, 8 × 1 kΩ). Bu göstergeler veriyolunu yüklemez, anahtar
    girişiyle de takılı kalabilir.
    - 16 yeni çip kartın en sonunda: U195–U199, sonra yeni taşma diliminden
    U901–U911 (CARD_REF_TASMA; kondansatörleri C196–C1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
    [bellek.kicad_sch, bom.csv, clk.kicad_sch, cpu.kicad_sch, gc.kicad_sch, onbellek.kicad_sch, video.kicad_sch]
2026-10-12 CPU panosu aşama testleri: LED ve çubuk göstergelerle izleme
2026-10-12 Board etiketleri göstergeleri örtmez; CPU panosunda en arka sırada da 5 V girişleri
    - Göstergeli board'da modül plakaları LED'lerin ve çubukların yanındaki en geniş şeritte;
    çipleri başka board'da olan grubun göstergeli board'u "R0 GÖSTERGELERİ" gibi
    - Pano tanımında ekBesleme: CPU panosunda en arka sıranın board'larında da birer giriş, her board
    en yakın girişten beslenir (LED'lerle ray düşümü 0,1 V altında)
    - Testler: 149 board, 29 bölge, "grup+" board'ları, register çubukları önündeki board'da;
    hesap8 100 nF testinde yerel sütun çipin kendi board'undan
2026-10-12 CPU panosu LED'lerle yeniden üretildi; belgeler ve sayılar
    - CPU panosu: 75 board, 210 çip, 3 914 tel, 10 besleme girişi (düşüm ≈ 35 mV); netlistle birebir
    - Modül plakaları alçak şeritte yan yana; LED' ve çubukları örtmediği test ediliyor
    - breadboard.md: modül adaları, 5 × 15 CPU düzeni, hata ayıklama LED'leri tablosu, yeni sayılar
    - 3d-gorunum.md, kurulum.md, README, hesap8 kurulum rehberi: board ve tel sayıları, taban ölçüsü
2026-10-12 Belgeler: CLAUDE.md dizinleri (kök, cpu16, hesap8, src)
    Claude Code'un her oturumda okuduğu kısa dizinler: depo ne, klasör haritası,
    komutlar, push'tan önceki denetimler, üretilen dosyalar ve yenileme komutları,
    değişmez kurallar (74HC, şema = kod, altın model, sabit referanslar), dal ve PR
    akışı, bilinen tuzaklar. Alt klasörlerdekiler o katmanda neyin nereye
    dokunduğunu söyler.
    CONTRIBUTING'in üretilen dosyalar tablosuna breadboard verileri ve belgeleri
    eklendi; test sayısı (690) ve süresi güncellendi. Arayüzde kalan "134 board"
    yazıları 149 oldu.
2026-10-12 Performans: kapı seviyesi simülatör tiplenmiş dizilerle, as16 aralık taraması, tavlamada Prim
    Davranış değişmedi: aynı dalga sayısı ve net değerleri; üretilen dosyalar (KiCad, mikrokod,
    deney rehberleri, mimari SVG'ler, breadboard verileri: clk, kyb, gc, cpu ve hesap8) bayt bayt aynı.
    - chips/logic.ts: LogicSim'in sıcak döngüsü düz tiplenmiş dizilerde (kapı türü kodu, giriş/çıkış
    CSR, flip-flop durumu, yeniden kullanılan kuyruklar); bir dalga nesne ayırmadan hesaplanır.
    Aynı yük altında arka arkaya: GateMachine 3 900 → 8 800, bütün anakart 800 → 7 300, BusMaster
    3 500 → 18 400, GateComputer 8 700 → 33 900 döngü/s. hesap8 dogrula 11,0 →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
2026-10-12 hesap8: doğrulama ve kurulum hızlandı, davranış aynı
    - dogrula --hepsi: her iş parçacığı B'yi ortak bir sayaçtan alır (yük dengeli), A Gray
    sırasıyla değişir; durum başına kapı değerlendirmesi ≈ 5 100'den ≈ 2 900'e
    - simSirasi (sim.ts): örnek durumlar simülasyondan önce sıralanır (dogrula ve testler)
    - modulYerleri: girişler tek tek değil, her adımda yazmacın ayrı değerleri bir kez (16 bitte
    16 kat az iş, kartın kurulumu ≈ 62 ms'den ≈ 38 ms'ye)
    - 3D: anahtarlar değişmeyince devre ve sahne yeniden yayınlanmaz
    - kullanılmayan hesapErc silindi; README ve tasarim.md süreleri
2026-10-12 hesap8: README'de dogrula --hepsi süresi (iki optimizasyon birlikte ≈ 12 s)
2026-10-12 Belgeler: test sayısı ve süresi (721 test, ≈ 1 dakika)
2026-10-13 CPU16 tezgâhı: Türkçe ve İngilizce arayüz
    Araç çubuğu, kip seçimi, hız seçenekleri, durum rozetleri, sekmeler, UART
    terminali, VGA ve klavye ipuçları, Gerçek kart menüsü, derleme ve yükleme
    iletileri, örnek program açıklamaları ve aria-label/title/placeholder iki
    dilli. Durum ve bilgi iletileri iki dilli saklanır: dil sonradan değişince de
    doğru dilde görünür. Sayılar seçili dilin biçimiyle yazılır.
2026-10-13 Belgeler: README, katkı rehberi, okuma yolu, CPU16, hesap8 ve deney seti belgelerinin İngilizcesi
    Dokuz belgenin yanına .en.md eşi: README, CONTRIBUTING, docs/README, cpu16/README,
    hesap8/README, hesap8/docs/tasarim ve kurulum-rehberi, cpu16/kit/README ve led-ve-direnc.
    Bilgi aynı; bağlantılar çevrilen belgelerin .en.md eşlerine ve İngilizce çapalarına gider,
    tasarim.en.md mimari-hesap.en.svg'yi gösterir. README.md'nin başında English bağlantısı.
2026-10-13 Belgeler: as16, cc16, C örnekleri, BIOS, 3D, breadboard, kurulum ve üretim belgelerinin İngilizcesi
    cpu16/docs altındaki sekiz belgenin yanına .en.md eşi. Türkçe kaynakta küçük
    düzeltmeler: cc16.md'de iki uzun tire, breadboard.md'de bir orta tire,
    3d-gorunum.md'de eksik "saniyede".
2026-10-13 Belgeler: CPU16 tasarım belgelerinin İngilizcesi
    spec, isa-ayrintilari, mikromimari, mimari, kartlar, anakart, anakart-kartlari,
    anakart-gc-video, parcalar ve roadmap için yanlarına .en.md eşleri. Bağlantılar
    .en.md eşlerine ve İngilizce başlık çapalarına, mimari görselleri .en.svg'ye gider.
    Türkçe kaynakta küçük düzeltmeler: uzun tireler, "Dürüst not", "kapsamlı",
    parcalar.md'de tablodan sonra eksik boş satır.
2026-10-13 Mimari: diyagramlar, yan panel ve SVG'ler Türkçe + İngilizce
    Diyagramı kuran fonksiyonlar (cpu.ts, makine.ts, hesap8/mimari.ts) dili
    parametre alır ve metinleri t("Türkçe", "English") ile yazar; kimlikler,
    bloklar, netler ve yerleşim iki dilde aynı. Sahnenin ortak yazıları (lejant,
    "+ N kapı", "N entegre", "ayrıntı ›") ve sayı denetimi dile göre. Uygulama
    seçili dilde kurar, dil değişince yeniden çizer; panel, araç çubuğu,
    ipuçları ve kısayollar çevrildi.
    npm run cpu16 -- mimari İngilizce SVG'leri de yazar (mimari-cpu.en.svg,
    mimari-makine.en.svg, mimari-hesap.en.svg); Türkçe SVG'ler bayt bayt aynı.
    İngilizce diyagramlar aynı yerleşim ve devre denetimleri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
2026-10-13 Kart 3D: CPU16 kartı ve 8 bit hesap arayüzü Türkçe + İngilizce
    Araç çubuğu, sekmeler, inceleme ve bağlantılar, çipin içi (kapılar,
    transistörler, bellek dizisi), VGA ve UART panelleri, program
    düzenleyicisi, hesap paneli ve "modelle aynı" rozeti seçili dilde.
    3D'de dokuya çizilen kart, blok ve pano başlıkları dil değişince
    yeniden çizilir (adlar.ts: kart ve blok adlarının İngilizcesi).
    Saf fonksiyonlar dili parametre alır (varsayılan "tr"): blokDegerleri,
    compileProgram, ekranBilgisi, nodeLabel; İngilizce için yeni testler.
2026-10-13 Mimari: yan paneldeki blok adları seçili dilde (board3d/adlar.ts)
2026-10-13 Pasif çizimleri: bilgi panelinin çizimlerine dil parametresi
    Direnç, LED, seramik, elektrolitik, direnç dizisi, osilatör, LED devresi,
    çekme direnci ve dekuplaj çizimleri son argüman olarak dil alır
    (varsayılan "tr"). İngilizcede yazılar, bant ve LED renk adları İngilizce,
    ondalık ayraç nokta, yüzde işareti sayıdan sonra. Rehber görselleri
    (npm run cpu16 -- kit) bayt bayt aynı.
2026-10-13 Kurulum modu: PCB ve breadboard kurulum panelleri Türkçe + İngilizce
    Panellerin bütün metinleri seçili dilde: tel kartı (renk, sınıf, bacağın
    yeri, nereden / nereye), ilerleme, düğmeler, ipuçları, blok ve aşama
    listeleri, aşama sonu testleri, pano ve kart adları, delik etiketleri
    (üst/alt raylar İngilizcede top/bottom). Kart ve blok adları adlar.ts'ten;
    aşama adları ve testlerinin İngilizcesi bbKurulum.ts'te Türkçe metinle
    eşlenir. cpu16 tarafında yalnız ekler: RENK_KODU'na en, ucEtiketi ve
    renkAdi'na dil, hesap8 renk gruplarına en. Breadboard verisi, kurulum ve
    breadboard belgeleri değişmedi. Testler: İngilizce metinler, eksiksizlik
    (her blok, aşama, test,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
2026-10-13 İki dil: çip ve pasif başlıkları, kart testi ve yükleyici iletileri
    Çip ve pasif başlıklarının İngilizcesi parça numarasıyla src/board3d/adlar.ts'te (PARCA_EN);
    eksik başlık view.test'te yakalanır. cpu16/bios/kart-testi.ts ve uploader.ts dil seçeneği
    alır (varsayılan Türkçe, komut satırı çıktısı aynı); tezgâh arayüz dilini geçirir.
2026-10-13 Arayüz: kabuk, 6502 die ve Başlangıç kılavuzu Türkçe + İngilizce
    Üst çubuk, menüler, ortak kısayollar, panel düğmeleri, sekmeler, yükleme ve
    hata ekranları, bölüm adları ve ipuçları iki dilde. 6502 die bölümünün araç
    çubuğu, yan panelleri (yazmaçlar, sinyal bul, ölçülen sinyal, bellek,
    program, katmanlar), mantık analizörü, örnek programlar, assembler hataları
    (assemble(kaynak, dil)) ve konsol API'sinin iletileri seçili dilde.
    Başlangıç paneli kılavuz oldu: solda bölüm listesi (dikey sekmeler, ok
    tuşları), sağda seçilen bölümün tanıtımı ve 3-4 maddelik ilk adımları
    (src/ui/kilavuz.ts), altta ortak kısayollar ve dil (L). 1366 × 768'de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
2026-10-13 Bölüm metinleri: her kart, bölge, blok ve çip grubunun İngilizcesi
    CPU16'nın yedi kartında ve hesap makinesinde her bölüm metninin yanına
    İngilizcesi eklendi (m/g yardımcılarının son argümanı). Türkçe alanlar
    aynı kaldı: kurulum belgeleri, kit ve KiCad çıktısı bayt bayt aynı.
    bolumMetni(b, dil) ve asamaAdi(a, dil) seçili dildeki metni verir;
    sinyal özetinin "+N" satırı da iki dilli. Test: bütün kayıtlarda
    İngilizce dolu, etiket büyük harf ve kısa, uzun tire ve çevrilmemiş
    Türkçe kelime yok; her kurulum aşamasının İngilizce adı var.
2026-10-13 Pasifler: açıklama, hesap ve çizimler seçili dilde
    pasifAciklamasi(p, ctx, dil): hesap mantığı aynı, metinler iki dilli;
    İngilizcede ondalık nokta (sayi, ohmMetni, akimMetni … dil parametresi
    alır, varsayılan Türkçe). LED renkleri, renk kuralı nedenleri ve renk
    bantlarının İngilizce adları; parça başlıkları adlar.ts'ten
    (parcaBasligi). Bilgi panelinde başlıklar, bacaklar, çizimler (dil
    cizim.ts'e geçer) ve rehber göndermesi (led-ve-direnc.en.md) seçili
    dilde. Test: iki kartın bütün pasiflerinde İngilizce açıklama Türkçe
    kelime içermez (kartın parça görevi dışında), hesaplar aynı.
2026-10-13 İki dil: Sabit birimi → Immediate unit; hesap8'de çekme direnci kapalı anahtarı 0'a çeker
2026-10-13 Belgeler: src/CLAUDE.md'de kılavuz dosyası ve altı kademeli sıkışma
2026-10-14 Remove obsolete tests and fixtures for 6502 assembler and MOS 6502 simulation
    - Deleted `ceviri-kabuk.test.ts` which contained tests for the 6502 assembler in Turkish and English.
    - Removed `sum-trace.json` fixture used for tracing in MOS 6502 tests.
    - Eliminated `mos6502.test.ts` which included tests for the MOS 6502 machine and its compatibility with visual6502 chipsim.
2026-10-14 Metinler: hesap8 bölüm metinleri, kurulum el kitabı ve deney rehberi üretecinde dil düzeltisi
    Rehber üreteci "Deney 5'de takıldı" gibi yanlış ek veriyordu: artık "5. deneyde takıldı". hesap8'de
    "B'nın" çıkaran ek "B sayısının" oldu. El kitabında bölüm adlarındaki uzun tire iki nokta.
2026-10-14 Deney seti: giriş, pasifler ve Deney 1-4 rehberlerinde dil düzeltisi
    "Ne öğreneceksin" maddelerinde belirtme hâli, eksik yüklemler, veriyolu terimi; İngilizcede pano
    için "assembly" yerine öbür belgelerdeki gibi "panel".
2026-10-14 Belgeler: anakart, anakart kartları ve BIOS belgelerinde dil düzeltisi
    Eksik yüklemler, veriyolu terimi, RX ve RTS/CTS cümlelerinde sıra; MONITOR satırındaki "döner ...
    geri dönmez" çelişkisi "monitöre geçer; çağırana dönmez" oldu (İngilizcesi de).
2026-10-14 Metinler: "hâl" ve "MHz'de" yazımı bütün okur metinlerinde aynı
    Belgeler "hâli / hâlinde" yazıyordu; kurulum, breadboard ve mimari belge üreteçleriyle hesap8'in 3D
    metinleri de öyle yazıyor. "MHz'te" yerine depodaki çoğunluk gibi "MHz'de". Kod yorumları değişmedi.
2026-10-14 Deney seti: otomatik bölümler yeniden üretildi (npm run cpu16 -- kit)
    "Deney 5'de takıldı" yerine "5. deneyde takıldı".
2026-10-14 Breadboard 3D: tek parça tel boruları, tel ve damar seçimi, şerit kablo ve IDC soketleri
    - Atlama telleri parça parça silindir yerine köşelerde yuvarlak dirsekli tek parça boru
    (telYolu.ts yuvarlakYol, Borular.yol): köşelerde ve kamburlarda boşluk kalmaz.
    - Bir tele tıklayınca baştan sona vurgulanır, öbürleri soluklaşır; yan panelde nereden → nereye
    (useKart.tel, TelPanel). Kurulum modunda tıklanan tel odağa gelir.
    - Tıklama ışın testi analitik (isinTeli, seritIsini): r3f tekerlekte ve her basışta da ışın attığı
    için üçgen taraması kasıyordu.
    - Şerit kablo (breadboard) ve arka panel (PCB) ortak bileşen (Serit3D.tsx): damarlar canlı renkli
    d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
2026-10-14 Şerit kablo: 45° katlama, seçili damarın izi, sinyalin gittiği soketler
    - Kablo koridordan dik açıyla ayrılırken 45° katlanır (serit.ts uc): koldaki k. damar koridordaki
    k. damarın üstünde biter, damarlar kavşakta kesintisiz döner.
    - Seçili damar baştan sona, her şeyin üstünde parlayan bir izle çizilir (damarYolu, DamarIzi); PCB'de
    kablodan arka panelin yoluna iner. Arka panelde öbür yollar daha az soluklaşır, görünür kalır.
    - Sinyalin uçları olan kartların soketleri çerçevelenir, etiketlerine o karttaki uç sayısı yazılır.
2026-10-14 Şerit kablo: uçlarda katlanarak biter, soketin kafasında pin haritası
    - Koridor ilk ve son soketin 45° katlamasında başlar ve biter (serit.ts bas, uc): uçlarda kol ile
    koridor kırımın iki yanında temiz bir köşe; son soketten sonra boşa giden kuyruk yok.
    - Soketin kafasında pin haritası: her pinin numarası ve sinyali, üstte sinyal grupları (damarGruplari:
    A0–15, DE0–7, DO0–7, PA14–19) renkli bantlarla; seçili sinyalin pini sarı. Kartın adı soketin yanında.
2026-10-14 PCB görünümü: seçili çipin ve netin bağlantıları bakır yol
    - Kartın içindeki bağlantılar kartın yüzeyinde dik açılı, 45° pahlı bakır yollar (pcbYol.ts): kartın
    2,54 mm'lik ızgarasında yönlü A* (kıvrım maliyeti, ağırlıklı sezgi); gövdelerin üstü ve başka
    netlerin pedleri pahalı, döşenmiş yolların üstü pahalı (yollar yan yana gider).
    - Yollar kare başına birkaç milisaniyede döşenir, döşendikçe görünür: büyük bir çipte takılma yok.
    - Canlı seviyenin renginde; seçili netinkiler daha kalın ve açık. Kartlar arası kısım konnektörden
    konnektöre arka panel boyunca çizgi; GND / VCC yol olarak döşenmez. "Hepsi" kipi ince çi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
2026-10-14 PCB görünümü: bütün yollar kartlara kazınmış, arka panelin dilleri
    - Kartların bütün kart içi bağlantıları kalıcı olarak kazınmış bakır (pcbYol.ts): iki katmanlı kart
    gibi üstte yatay, altta dikey yollar, yön değişiminde via; 1,27 mm'lik ızgarada A*, başka netin
    pedi ve bakırı çok pahalı, aynı netin bakırı paylaşılır. ~4 700 yol bir worker'da (pcbYol.worker.ts)
    ~10 s'de kazınır, yollar kazındıkça görünür; ana iş parçacığı takılmaz.
    - Seçili çipin ve netin yolları kalın ve canlı renkte yanar; "hepsi" kipinde bütün yollar canlı.
    Kartlar arası kısım konnektörden konnektöre arka panel boyunca (önceki her uca ayrı kavis y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
2026-10-14 PCB ve şerit kablo: gerçek görünüm, katman içinde dönen yollar, gövdeye oturan kalıp
    - Yollar katman içinde de döner (üst katman yatayı, alt dikeyi tercih eder; ters yön ve via pahalı),
    köşeler 45° pahlı: yol başına via 6,5'ten 2'ye, kart barkod gibi değil. Her kart kendi worker'ında.
    - Kazınmış bakır lehim maskesinin altında gibi düşük kontrastlı, vialar küçük sekizgen halka.
    - Şerit kablo varsayılan olarak gerçek görünümde (gri, 1. damar kırmızı çizgili), arka panelin bakırı
    maskeli yeşil; canlı renkler "hepsi" kipinde ve seçili damarda.
    - Çipin kalıbı kartın 22 mm üstünde gövdenin 3-4 katı genişlikte yüzmek yerine gövdenin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
2026-10-14 Arka panel genişleme yuvaları, breadboard'da zincir şerit kablo
    - PCB: kartlar arka panele genişleme kartları gibi takılı. Kartın kenarından bir dil uzanır, üstünde
    konnektörden 64 yol iner, altın parmaklar arka paneldeki yuvaya girer; yuvanın üstünde pin haritası,
    altından her pin kısa bir izle kendi hattına iner (altın nokta). Bakır dil ve eğik birleşme kalktı.
    - Breadboard: koridordaki gövde ve 45° katlama dikişleri yerine tek kablo soketten sokete zincir
    hâlinde; koridorda kendi düzleminde çember yaylarıyla döner (serit.ts enYonleri: genişlik yönü yol
    boyunca), karşı panoya hafif bir çaprazla geçer. Kablonun kenarındaki koyu oluk kalktı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
2026-10-14 PCB: okunur renkler, sıralar arası bakır U, tek iz
    - Renkler: kartlar bir ton açık yeşil, kazınmış yollar belirgin; arka panel koyu gri kartta gümüş hatlar
    (kartlardan ayrışır, seçili sinyalin kırmızısı / mavisi üstünde okunur).
    - Sıraları bağlayan gri şerit kablo yerine arka panelin soldan dönen bakır U'su; U şeridi ters
    çevirdiği için tek sıralarda hatların sırası ters, her hat sıradan sıraya kesintisiz.
    - Arka panelli yerleşimde kartlar arası eski çizgiler kalktı (netin numarasından seçilen sahte bir
    şeritte, gerçek hattın yanında ikinci bir iz gibi duruyordu); seçili çipin arka panel sinyalleri de
    gerçek hatlarında yanar.
2026-10-22 Arayüz: telefon ve tablet yerleşimi
    Önce: telefonda üst çubuk dört, araç çubuğu üç satırdı (ekranın yarısı); bölüm
    simgeleri kenarda kesiliyor, VGA paneli kartı örtüyor, yan panel açılırken sayfa
    yana taşıyordu. 1024 px'te bilgisayarın araç çubuğu iki satırdı.
    Sonra (≤ 900 px): üst çubuk tek satır (logo, ölçümler, Görünüm, yardım), bölüm
    geçişi altta sabit sekme çubuğu (simge + kısa ad), araç çubuğu tek satır yana
    kayar, açılır menüler alttan açılan sayfa. VGA paneli küçük sahnede küçülür
    (container sorgusu). 1240 px'in altında sakin düğmeler yalnız simge: kart,
    tezgâh ve 6502 araç çubukları 920-1024 px'te de tek sa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
2026-10-22 Kart 3D: hiçbir parça seçili değilken genel bakış
    Önce: İnceleme sekmesi boşken yalnız "Bir entegreye tıkla" yazıyordu.
    Sonra: altında kartın genel bakışı: kart (hesap makinesinde blok), entegre ve
    pasif eleman sayıları; bilgisayarda kart kart, hesap makinesinde blok blok
    satırlar, entegre sayısını gösteren çubukla. Satıra tıklayınca kamera o karta
    (PCB görünümünde) ya da bloğa gider: focusBlock(blok, kart) ve CameraFly
    kartın çerçevesini de çerçeveler. Sayımlar saf bir fonksiyonda (ozet.ts),
    testleri cpu16/tests/arayuz.test.ts.
2026-10-24 Arayüz: 3D tuvaller isteğe bağlı çizilir, akıcılık iyileştirmeleri
    - 6502 die ve kart sahneleri frameloop="demand": yalnız bir şey değişince
    çizilir. Canlı değerler cizimIste() ile, depo değişiklikleri abonelikle,
    süren animasyonlar (uçuş, nabız halkaları, LED, tel kurulumu) kendi
    karelerini ister. Boşta ve duraklatılmışken tuval hiç çizilmez.
    - Kart deposunun sahnenin okumadığı alanları (KART_SAHNE_DISI) kare
    istemez: kartta düzenleyiciye yazmak 3D'yi her tuşta çizdirmez.
    - Uyarlanır çözünürlük: sürüklemede kareler yavaşsa DPR yarım adım iner
    (2 → 1,5 → 1), hızlı kalırsa en çok iki kez çıkar.
    - Shader'lar sahne görünmeden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
